deflord/3def/README.md

# 3Def
Мы сделали отдельное хранилище, что бы вы могли в любой момент скачать нужные вам детали и быстро отремонтировать или улучшить ваш 3D принтер!
