deflord/3def/Образы для OrangePi/Orange_Pi_3B/README.md

# Образ для Orange Pi 3B
## Образ содержит
* Orangepi3b_1.0.6_ubuntu_jammy_server_linux5.10.160
* Klipper v0.12.0-348
* Moonraker
* Moonraker-timelapse
* Mainsail в качестве вэб интерфейса
* Crowsnest
* KlipperScreen
* Katapult
* Klippain-Shaketune
* Настроен CAN
* Скрипты для автоматического расширения образа на всю MicroSD

Образ доступен для скачивания по ссылке [Orange Pi 3B](https://mega.nz/file/TdpzDAbS#Le2-5hxRWCd8Wit2h-JfqoEiYUKdBW2nbB_KZ6QXemg).
