deflord/3def/Образы для OrangePi/Orange_Pi_3_ZERO/README.md

# Образ для Orange Pi 3 ZERO
## Образ содержит
* Orangepizero3_1.0.4_ubuntu_jammy_server_linux6.1.31.7z
* Klipper
* Moonraker
* Moonraker-timelapse
* Mainsail в качестве вэб интерфейса
* Crowsnest
* KlipperScreen
* Поддержку CAN
* Katapult
* Klippain-Shaketune
* Скрипты для автоматического расширения образа на всю MicroSD

Образ доступен для скачивания по ссылке [Orange Pi 3 ZERO](https://mega.nz/file/TcYR1Qrb#NRjWIfK2MXL8XWC1-TuNzy4bhytpi9K7qcDxZMbB4Rc).
