deflord/3def/STL/StealthChanger/Магнитный док/README.md

# Модульный док с фиксацией на магниты
Мы предлагаем свою версию модульных доков для DrugonBurner. Мы слегка изменили систему крепления и удержания, добавив магниты с возможностью настройки. 
## Что сделанно:

Изменили передние детали рамки, убрали лишние дырки и добавили регулируемые магниты

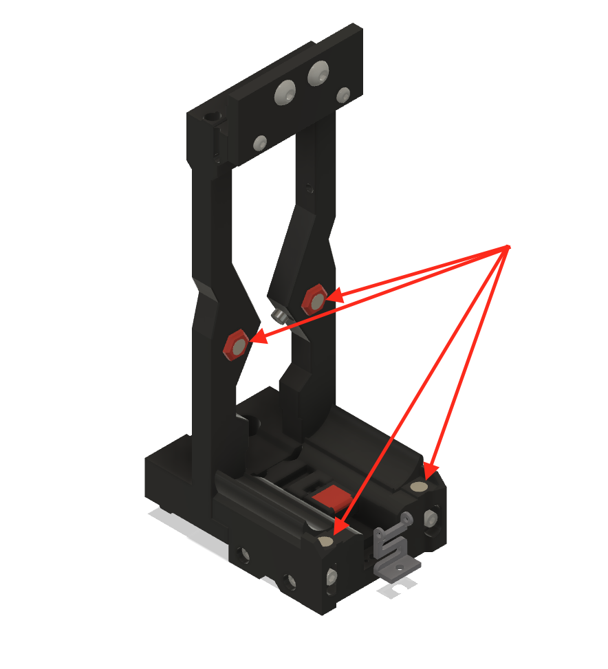
[picture p1: STL/StealthChanger/Магнитный док/IMG/1.png]
alt-текст Док


Добавили возможность настройки глубины посадки головы. По сути вам необходимо ослабить болты крепления, подвести голову в нужную позицию, после чего магниты сами встанут как должны. После этого просто зафиксируйте их болтами м3х8

Изменили нижний задник, можно отрегулировать таким же образом, как и передние магниты

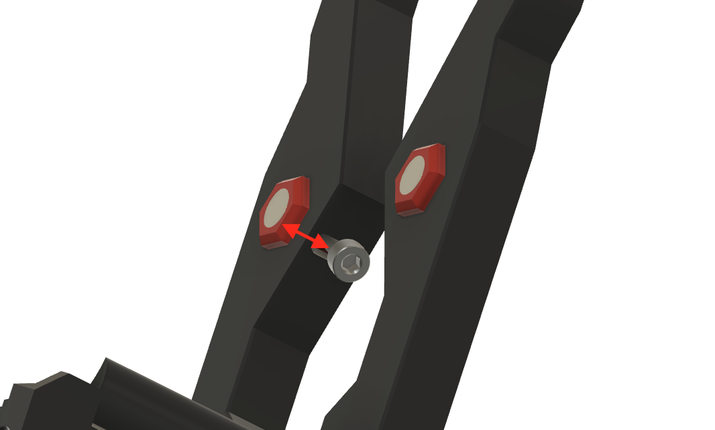
[picture p2: STL/StealthChanger/Магнитный док/IMG/2.png]
alt-текст Регулировка передних магнитов


На задней части так же добавили два магнита

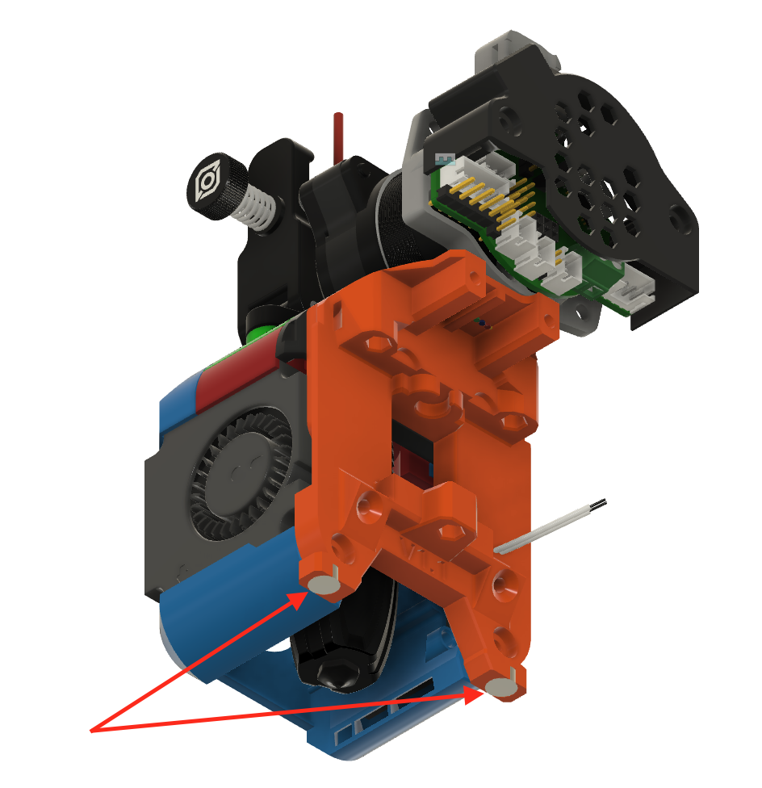
[picture p3: STL/StealthChanger/Магнитный док/IMG/3.png]
alt-текст Нижние магниты на голове


Добавили магниты в корпус DragonBurner.

**Внимание, при использовании сильных магнитов возможна остановка вентиляторов охлаждения хотэнда и обдува детали. Если это происходит, поставьте магниты другой полярностью.**

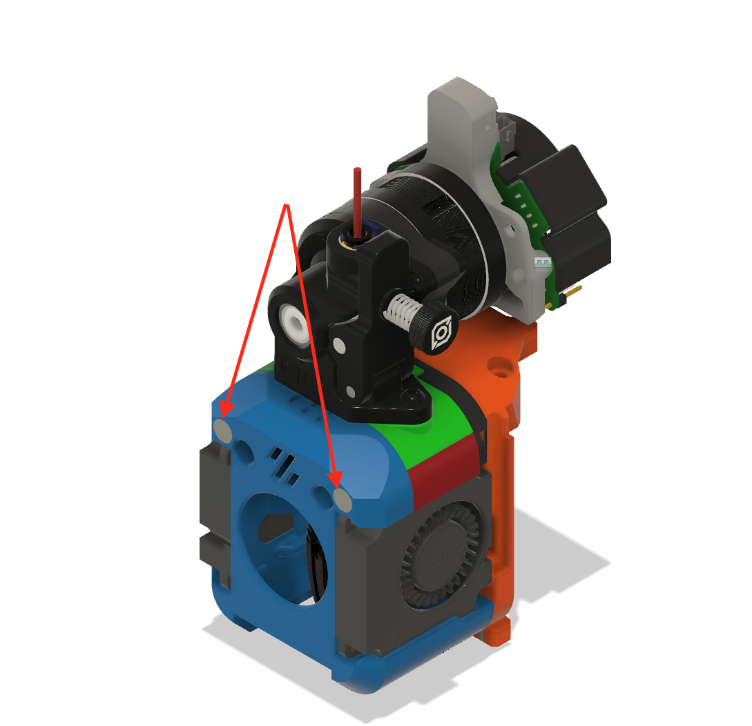
[picture p4: STL/StealthChanger/Магнитный док/IMG/4.png]
alt-текст Передние магниты на голове


**Внимание! 
Данный мод пока что в тестовом режиме, использовать на ваш страх и риск, будем благодарны за обратную связь :)**
