deflord/3def/STL/Моды/CPAP/BTT Eco Turbo Kit/README.md

# Простой мод для установки CPAP в корпус задней вытяжки

Все помещается без лишних проводов, получается аккуратно и просто.

Мод подходит для CPAP BIGTREETECH Eco Turbo Kit

Мод взят отсюда https://github.com/bigtreetech/Eco-Turbo-Kit/blob/66467e1f6cd2f754834dae49be04b927bdde804c/3D%20Model/Voron%202.4%26Trident/Exhaust%20Parts/Voron-Exhaust-ETK-SFS-wit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

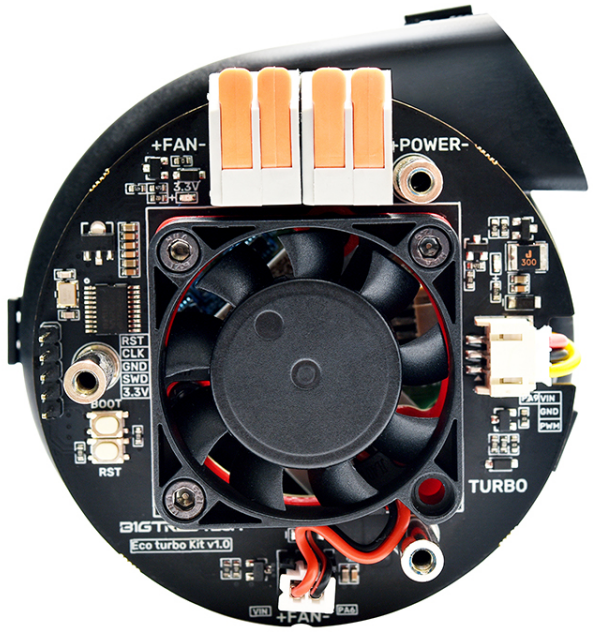
[picture p5: STL/Моды/CPAP/BTT Eco Turbo Kit/IMG/eco_turbo_kit.png]


Доработали и сделади возможность устанавливать не только на профиль 2020, но и 3030. Меняется только держатель.
Так же сразу возможно установить датчик наличия и движения пластика BTT SFS2

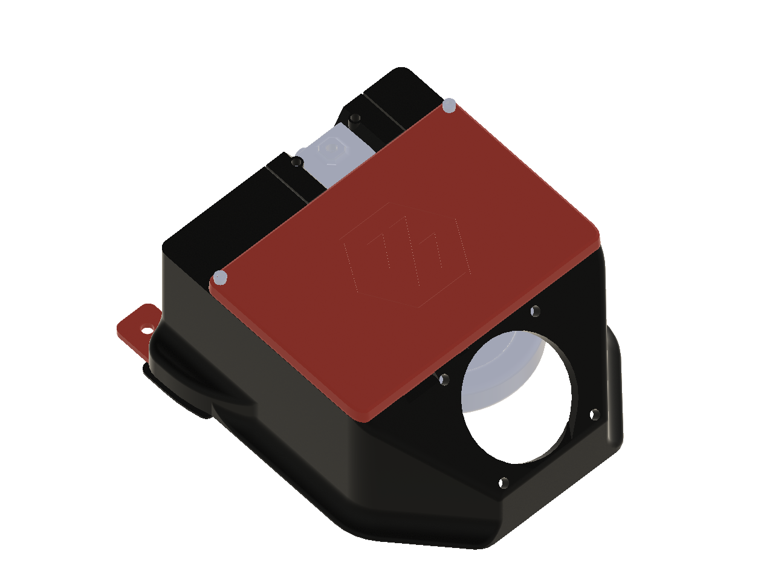
[picture p6: STL/Моды/CPAP/BTT Eco Turbo Kit/IMG/1.png]


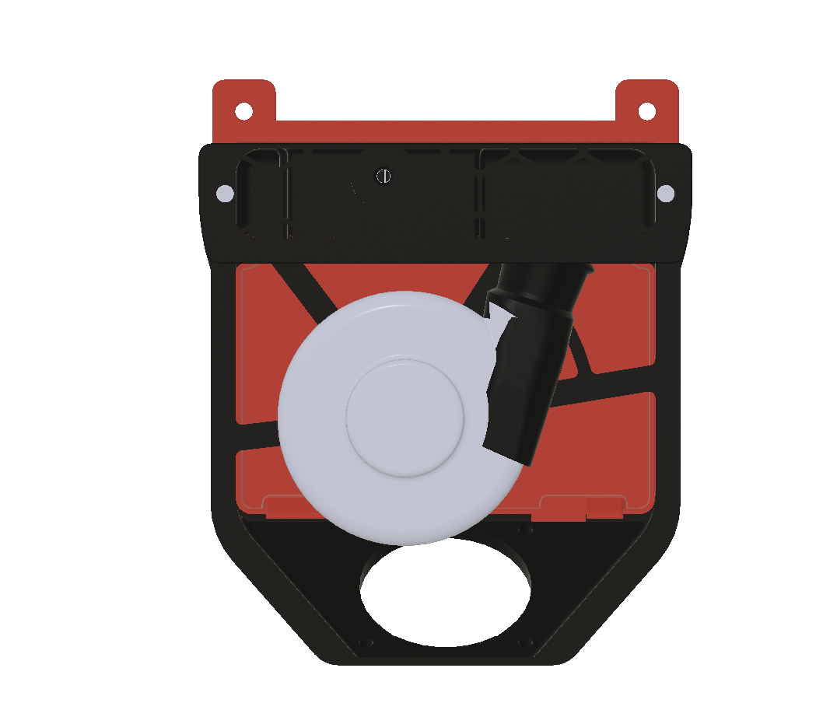
[picture p7: STL/Моды/CPAP/BTT Eco Turbo Kit/IMG/2.png]


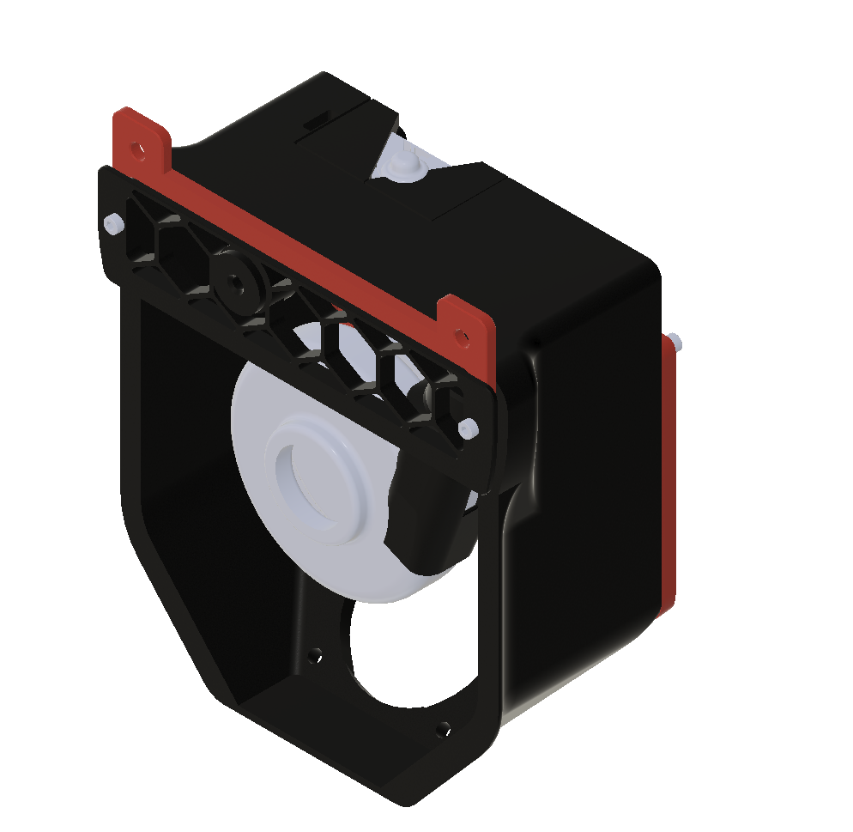
[picture p8: STL/Моды/CPAP/BTT Eco Turbo Kit/IMG/3.png]
