deflord/3def/STL/StealthChanger/Задний рюкзак с электроникой/README.md

# Рюкзак для установки электроники для Toolchanger
В рюкзаке распагаются 2 платы:
1. BTT U2C
2. BTT CEB

В рюкзак приходят кабели USB для подключения BTT U2C и кабель 24В для запитывания голов. 
Кабели проходят внутри, заходят внутрь принтера через прорези и далее разводятся влево и вправо по профилю. 

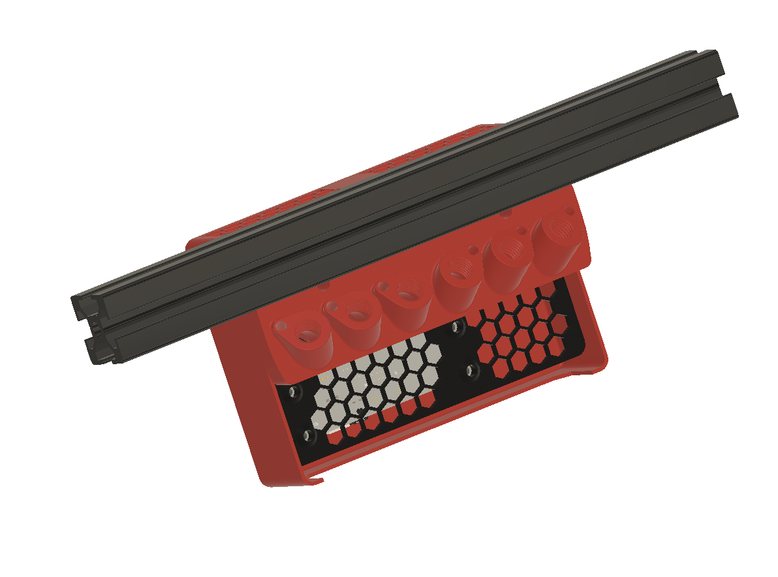
[picture p9: STL/StealthChanger/Задний рюкзак с электроникой/IMG/1.png]

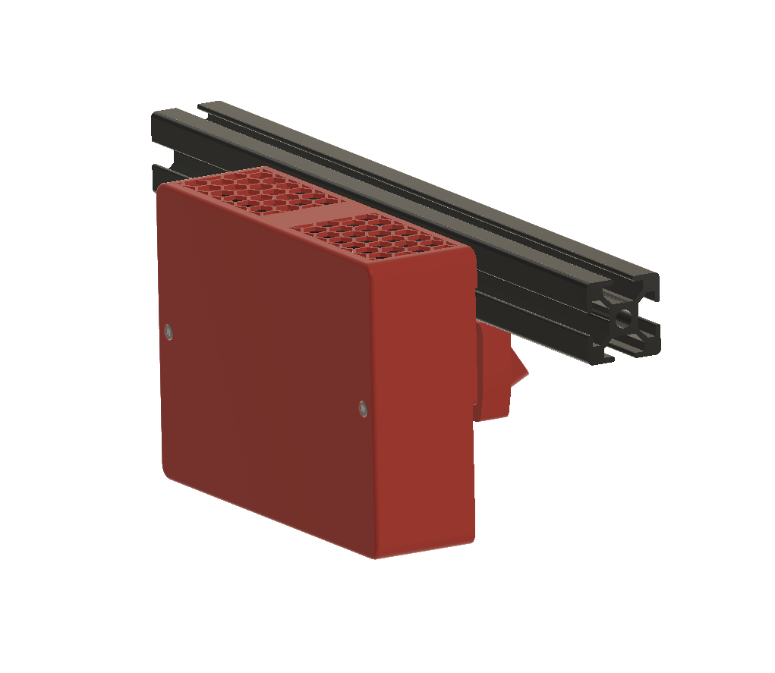
[picture p10: STL/StealthChanger/Задний рюкзак с электроникой/IMG/2.png]

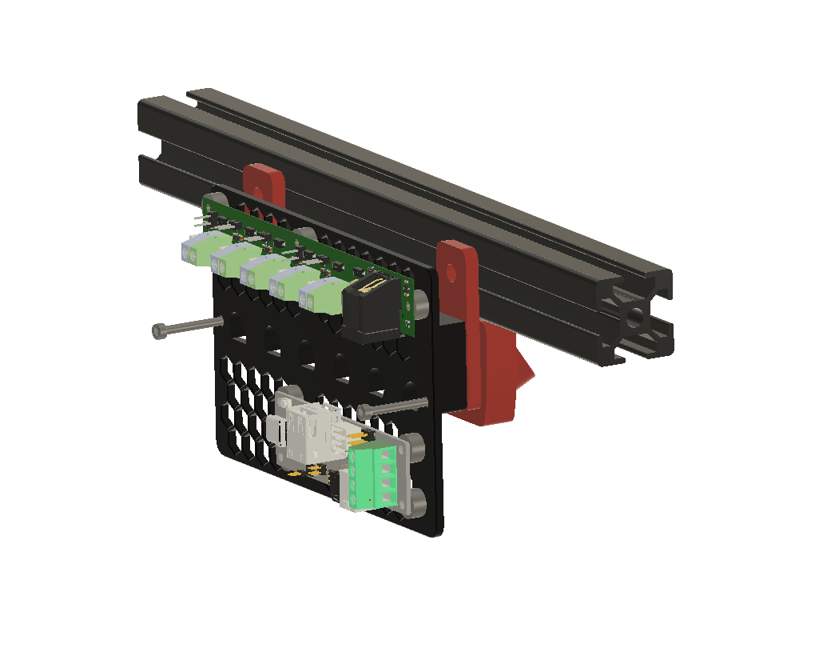
[picture p11: STL/StealthChanger/Задний рюкзак с электроникой/IMG/3.png]

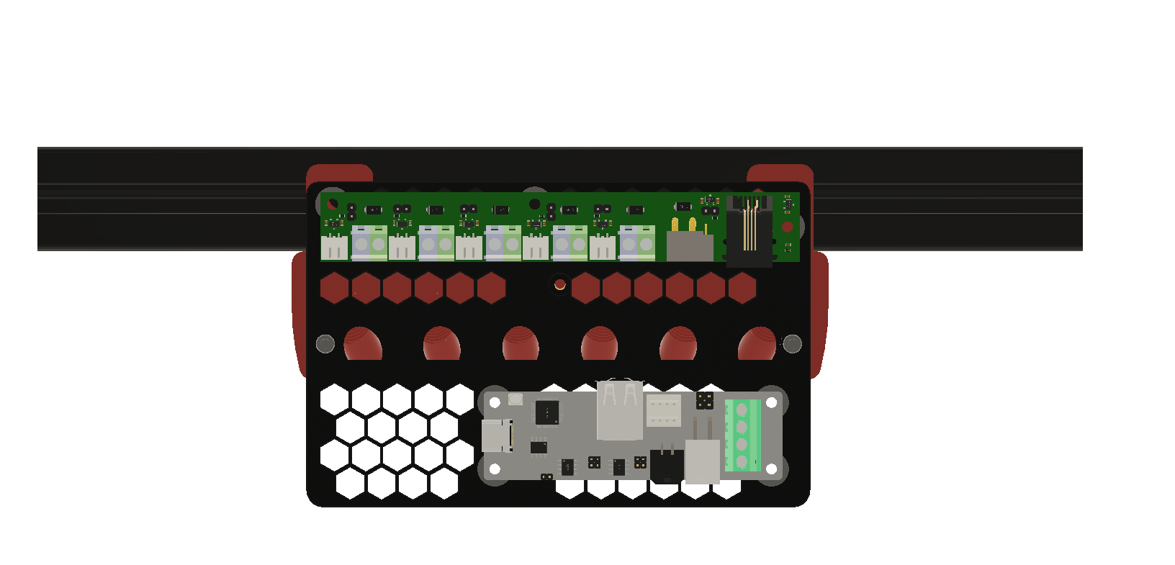
[picture p12: STL/StealthChanger/Задний рюкзак с электроникой/IMG/4.png]


Преимущества:
1. Поддерживается жесткое крепление стального корода каждой головы что бы избежать перекручивания и увеличить устойчивость проводки
2. Удобный доступ к платам, снимаете крышку и всё видно
3. Разделены трубки PTFE и электроника, трубки уходят сразу вниз, кабели заходят сквозь держатель и далее подключаются к платам. 

Поддерживаются 2 версии:
1. Для профиля 2040
2. Для профиля 3030

Если вам нужно использовать для профиля 2020, то прийдётся перемодилть крышку, пока не делали :) 

## **BOM для версии 2040**

| **Название**  | **Количество**| **Комментарий**  |
|:---|:---|:---|
| BTT U2C | 1 шт | - |
| BTT CEB | 1 шт | - |
| Болт М3х8 SHCS | 7 штук | для крепления плат |
| Болт М3х5 FHCS | 6 штук | для крепления стальных кордов |
| Болт М3х40 SHCS | 3 штуки | для крепления крышки |
| Болт М5х10 BHCS | 2 штуки | для крепления рюкзака к профилю |
| Закладные или Т-гайки M5 для паза профиля шириной 6 мм | 2 штуки | для крепления рюкзака к профилю |
| Закладная или Т-гайка М3 для паза профиля шириной 6 мм | 1 штука | для крепления крышки к профилю |
| Вплавляемые гайки М3х5 | 15 штук | стандартные для Voron |
| Шайбы М3 | 6 штук | для крепления стальных кордов |

## BOM для версии 3030

| **Название**  | **Количество**| **Комментарий**  |
|:---|:---|:---|
| BTT U2C | 1 шт | - |
| BTT CEB | 1 шт | - |
| Болт М3х8 SHCS | 7 штук | для крепления плат |
| Болт М3х5 FHCS | 6 штук | для крепления стальных кордов |
| Болт М3х40 SHCS | 3 штуки | для крепления крышки |
| Болт М5х10 BHCS | 2 штуки | для крепления рюкзака к профилю |
| Закладные или Т-гайки M5 для паза профиля шириной 8 мм | 2 штуки | для крепления рюкзака к профилю |
| Вплавляемые гайки М3х5 | 15 штук | стандартные для Voron |
| Шайбы М3 | 6 штук | для крепления стальных кордов |
