deflord/3def/STL/Моды/Камера/Камера FullHD/СNC мод/README.md

# Шаровое крепление камеры Full HD для установки на CNC портал
Мы доработали корпус камеры таким образом, что бы вы могли легко и просто разместить его на портале с алюминиевыми деталями на одном из передних моторов. 
Теперь настройка угла обзора очень проста. Вы можете регулировать как угол наклона, так и угол поворота. 
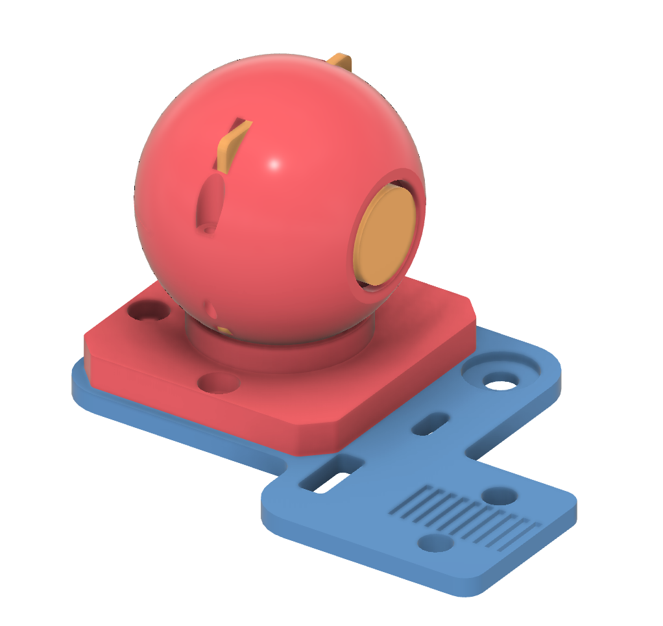
[picture p13: STL/Моды/Камера/Камера FullHD/СNC мод/IMG/CNC_FullHD.png]
Рендер камеры
