deflord/3def/STL/Моды/Камера/Камера FullHD/Monolith мод/README.md

# Шаровое крепление камеры Full HD для установки на портал Monolith
Мы доработали корпус камеры таким образом, что бы вы могли легко и просто разместить его на портале по проекту Monolith на одном из передних моторов. 
Теперь настройка угла обзора очень проста. Вы можете регулировать как угол наклона, так и угол поворота. 
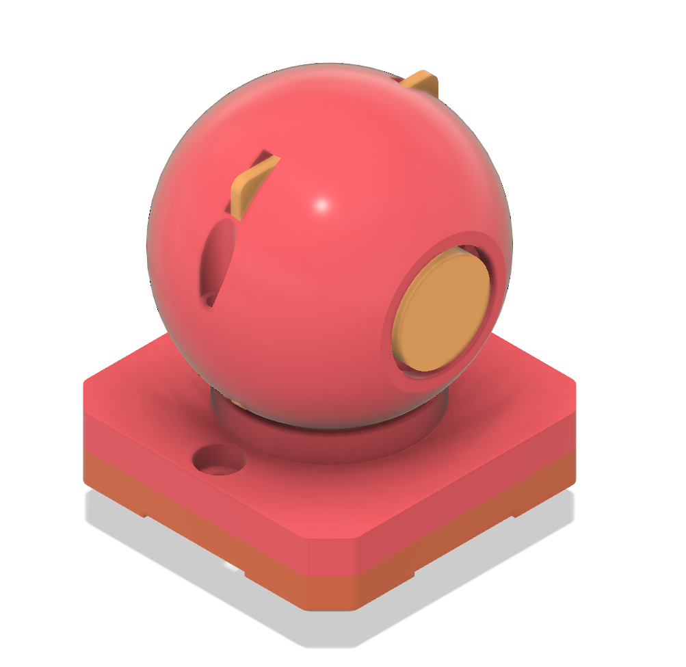
[picture p14: STL/Моды/Камера/Камера FullHD/Monolith мод/IMG/Monolith_cam.png]
Рендер камеры
