deflord/3def/STL/Моды/CPAP/Monolith/IMG/1.png

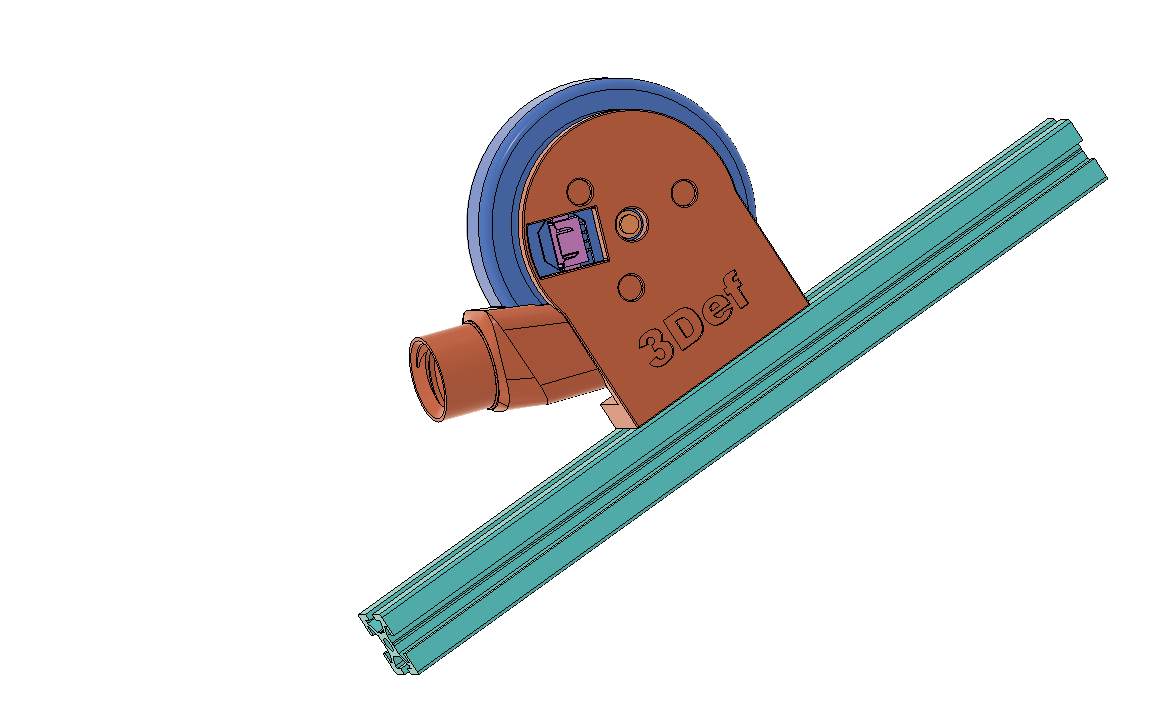
STL/Моды/CPAP/Monolith/IMG/1.png
