deflord/3def/STL/Моды/CPAP/Monolith/IMG/2.png

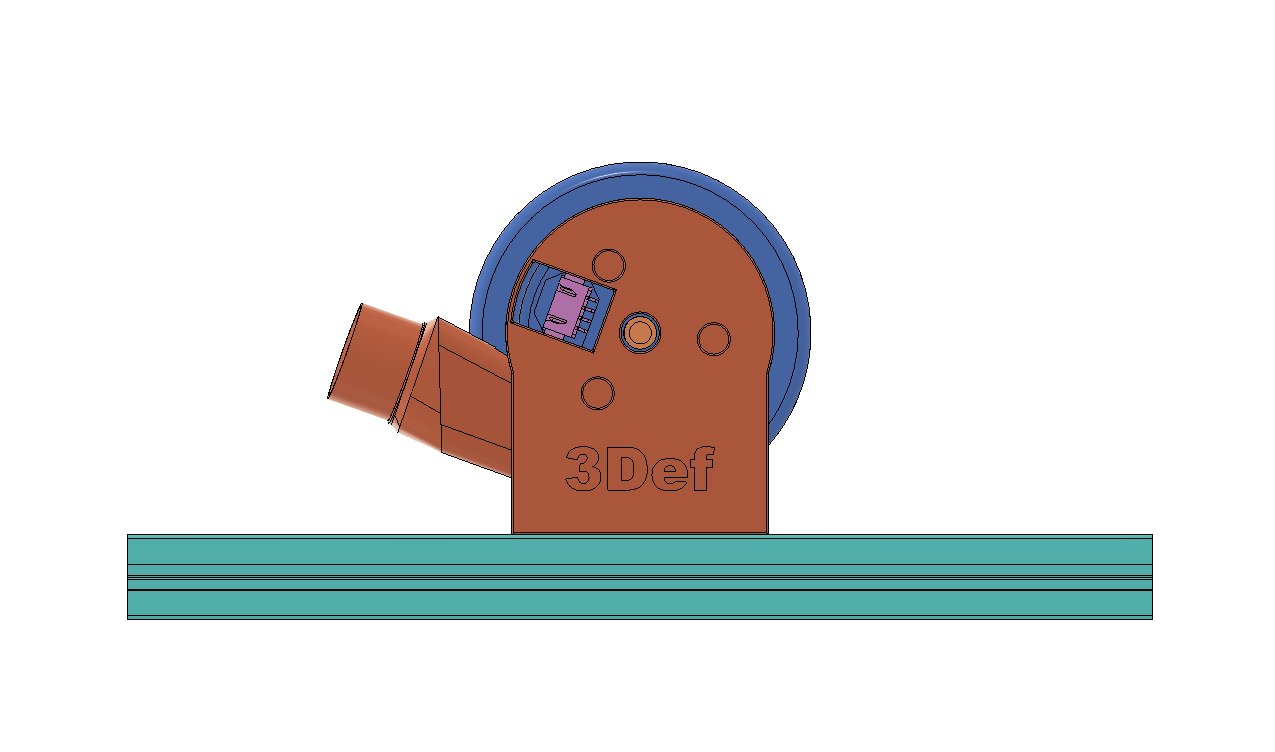
STL/Моды/CPAP/Monolith/IMG/2.png
