deflord/3def/STL/Моды/CPAP/Monolith/IMG/3.png

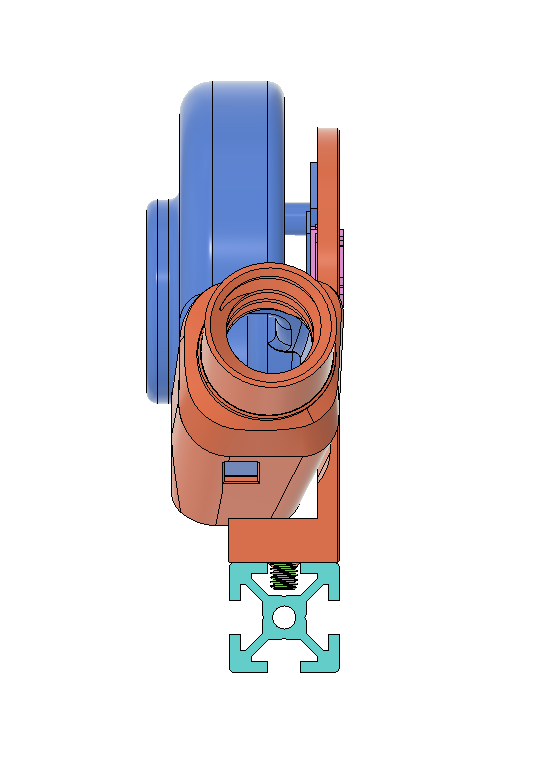
STL/Моды/CPAP/Monolith/IMG/3.png
