deflord/3def/STL/Моды/CPAP/Monolith/IMG/4.png

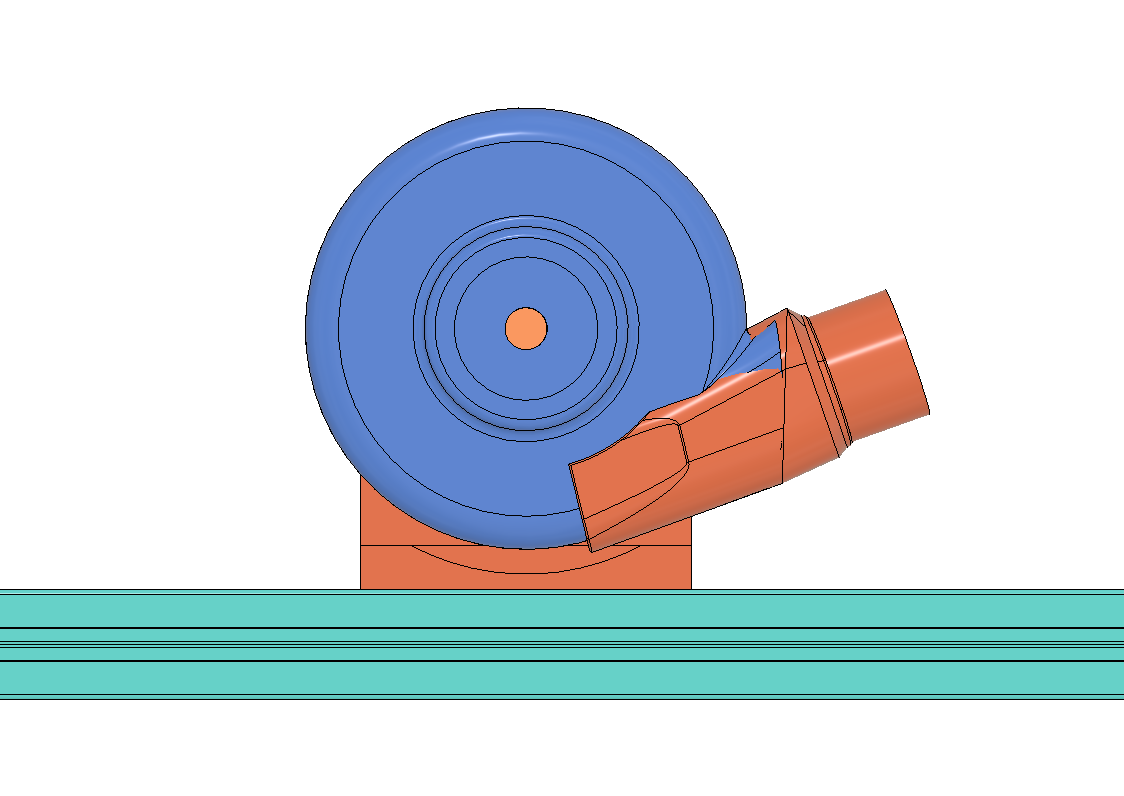
STL/Моды/CPAP/Monolith/IMG/4.png
