deflord/3def/STL/Отсек аппаратуры/Держатели плат/Fly X10 Pro/IMG/1.jpg

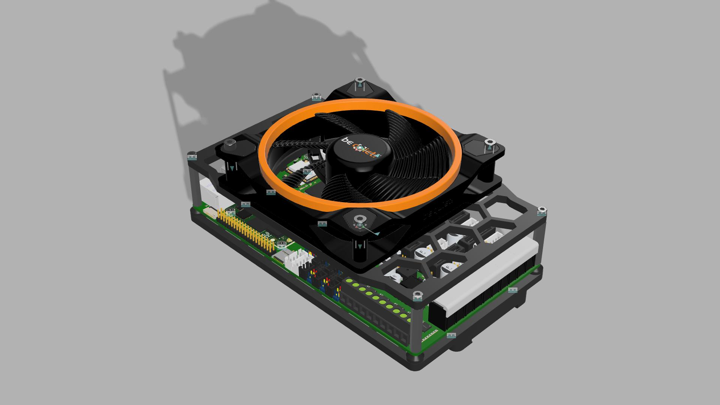
STL/Отсек аппаратуры/Держатели плат/Fly X10 Pro/IMG/1.jpg
