deflord/3def/STL/Печатающие головы/XOL/Heatcore Orbiter MiniAB/IMG/Снимок экрана 2025-10-13 в 11.07.48.png

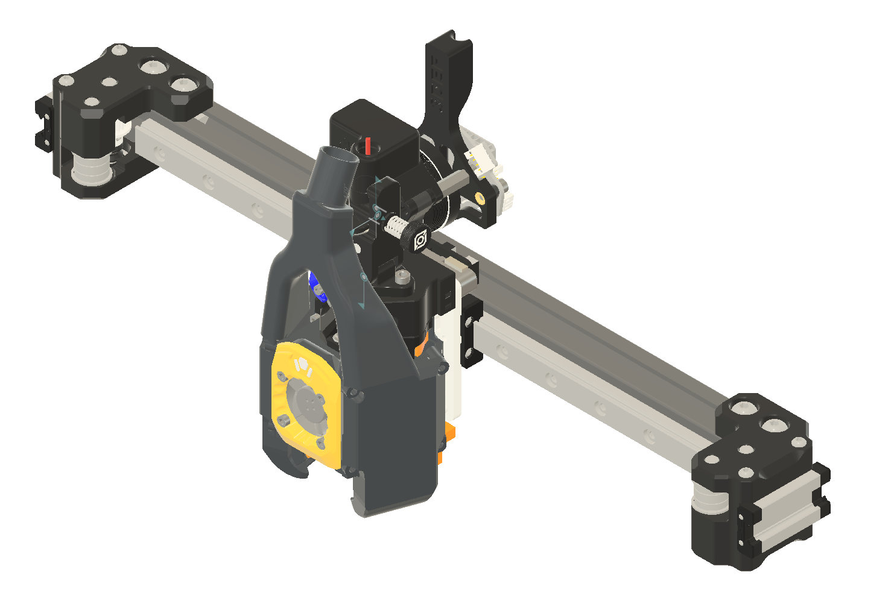
STL/Печатающие головы/XOL/Heatcore Orbiter MiniAB/IMG/Снимок экрана 2025-10-13 в 11.07.48.png
