deflord/3def/STL/Портал/Monolith/Ввод проводов в гибкий кабель канал/Ввод с CAN и PG7/IMG/Снимок экрана 2025-08-07 в 11.18.06.png

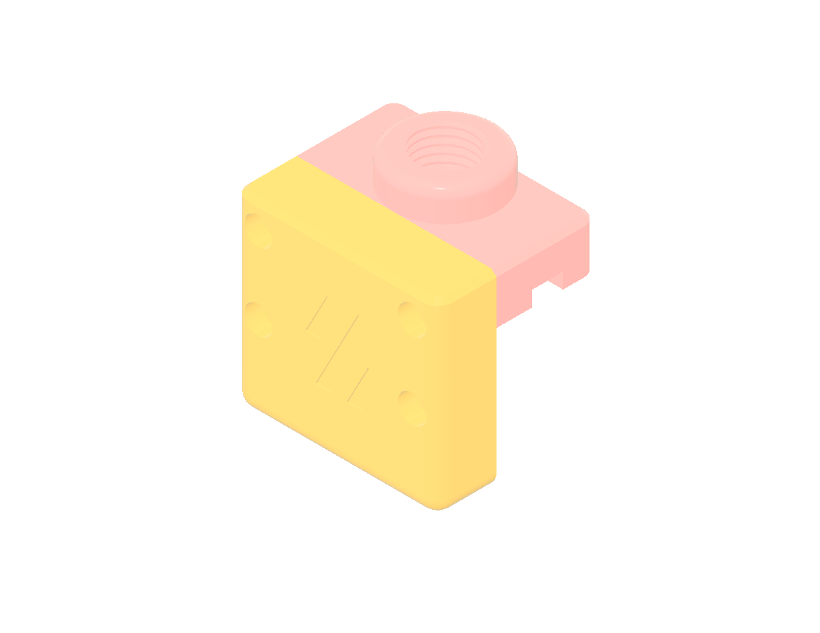
STL/Портал/Monolith/Ввод проводов в гибкий кабель канал/Ввод с CAN и PG7/IMG/Снимок экрана 2025-08-07 в 11.18.06.png
