deflord/3def/STL/Портал/Monolith/Ввод проводов в гибкий кабель канал/Ввод с держателем концевика/IMG/1.png

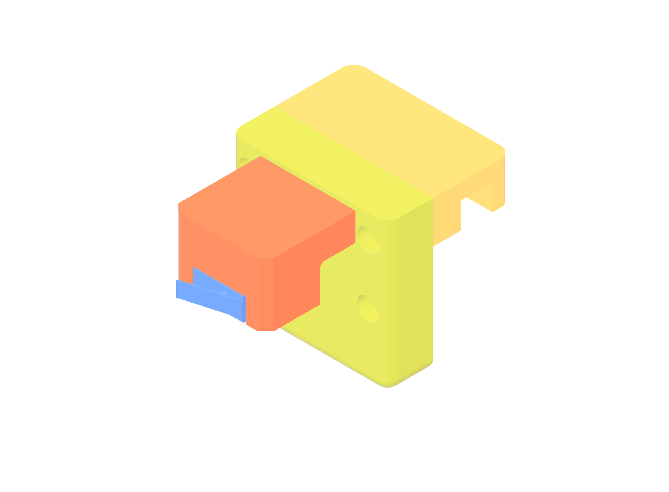
STL/Портал/Monolith/Ввод проводов в гибкий кабель канал/Ввод с держателем концевика/IMG/1.png
