deflord/3def/STL/Портал/Monolith/Концевик по Y сбоку/Снимок экрана 2026-01-29 в 11.02.18.png

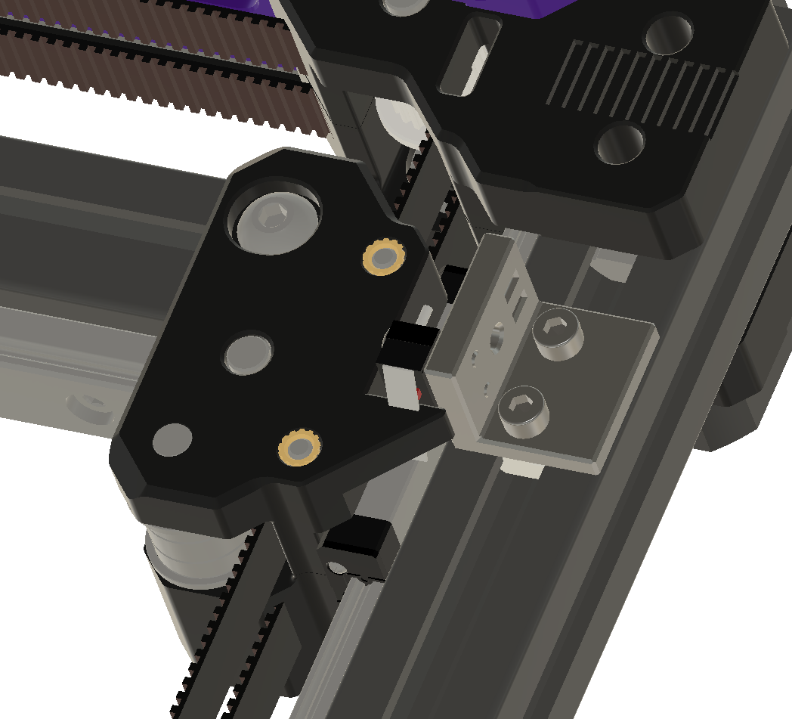
STL/Портал/Monolith/Концевик по Y сбоку/Снимок экрана 2026-01-29 в 11.02.18.png
