deflord/3def/Образы для OrangePi/watermark800x450.png

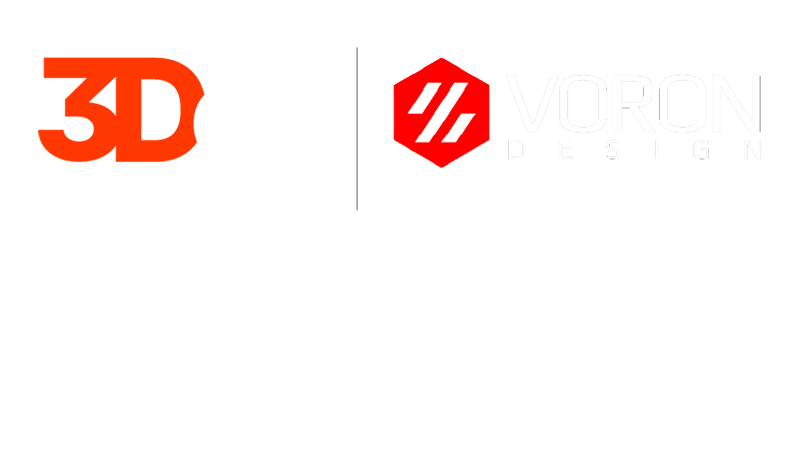
Образы для OrangePi/watermark800x450.png
