deflord/3def/Схемы подключения/500 Поток/Обжим косы.png

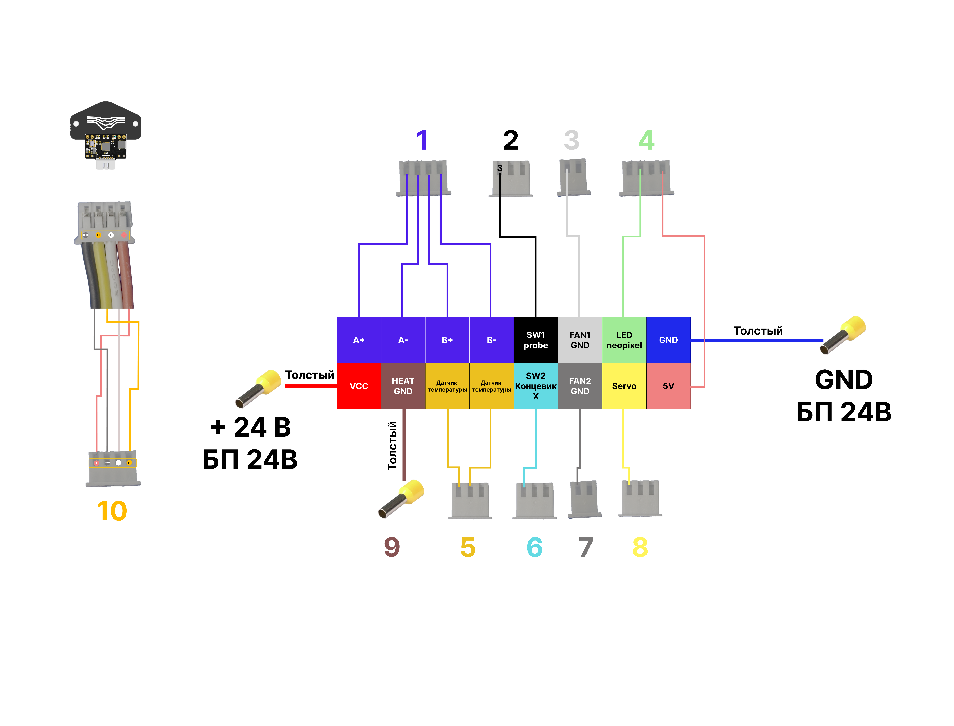
Схемы подключения/500 Поток/Обжим косы.png
