deflord/3def/Схемы подключения/500 Поток/Подключение в голове Листоголов с датчиком.png

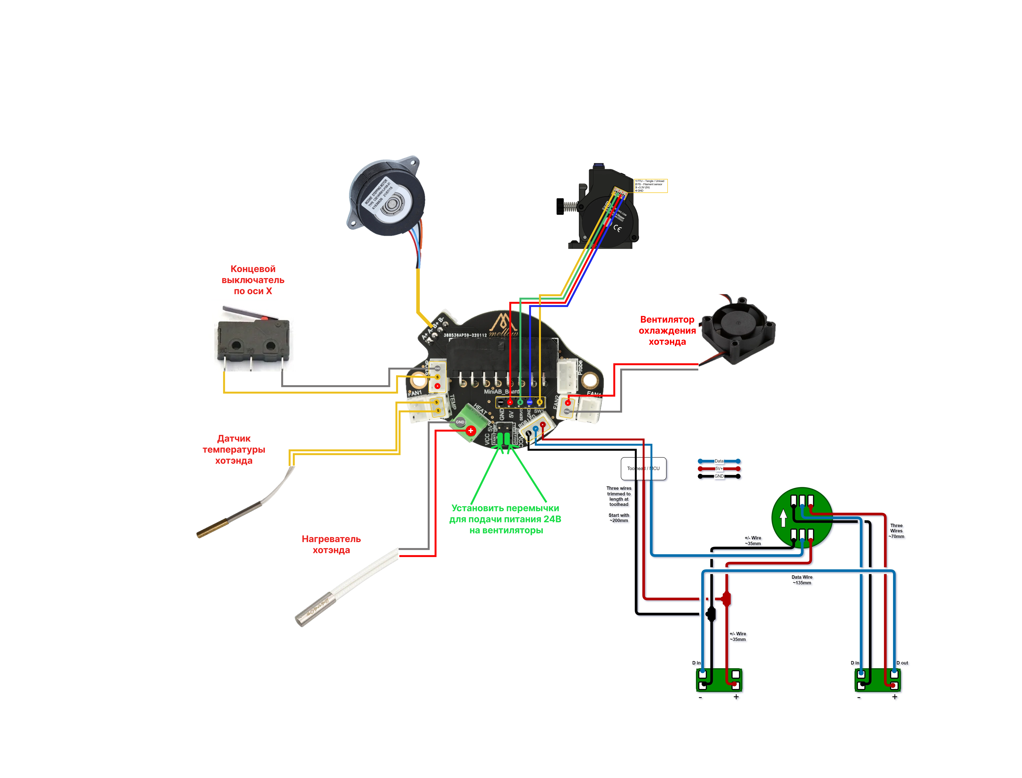
Схемы подключения/500 Поток/Подключение в голове Листоголов с датчиком.png
