deflord/3def/Схемы подключения/500 Поток/Подключение головы к основной плате CPAP.jpg

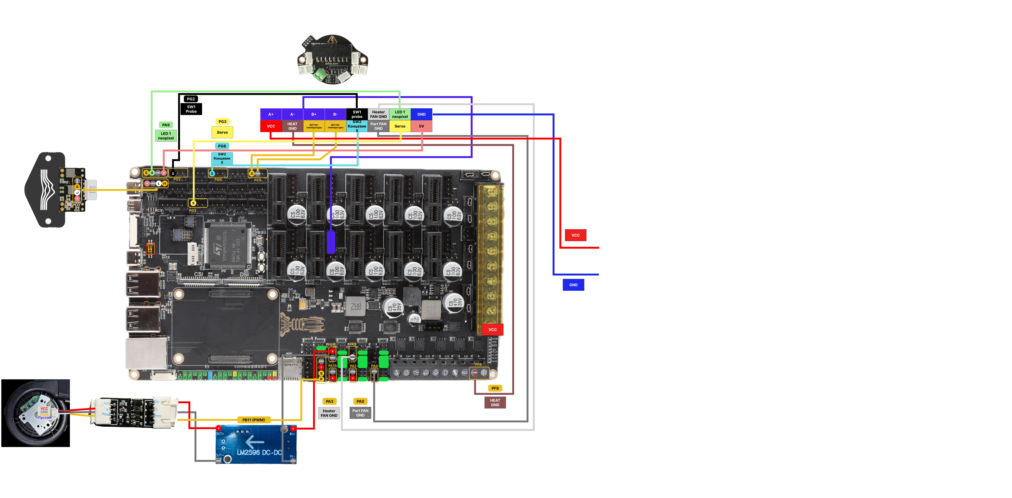
Схемы подключения/500 Поток/Подключение головы к основной плате CPAP.jpg
