deflord/3def/Схемы подключения/500 Поток/Подключение двигателей 48В.png

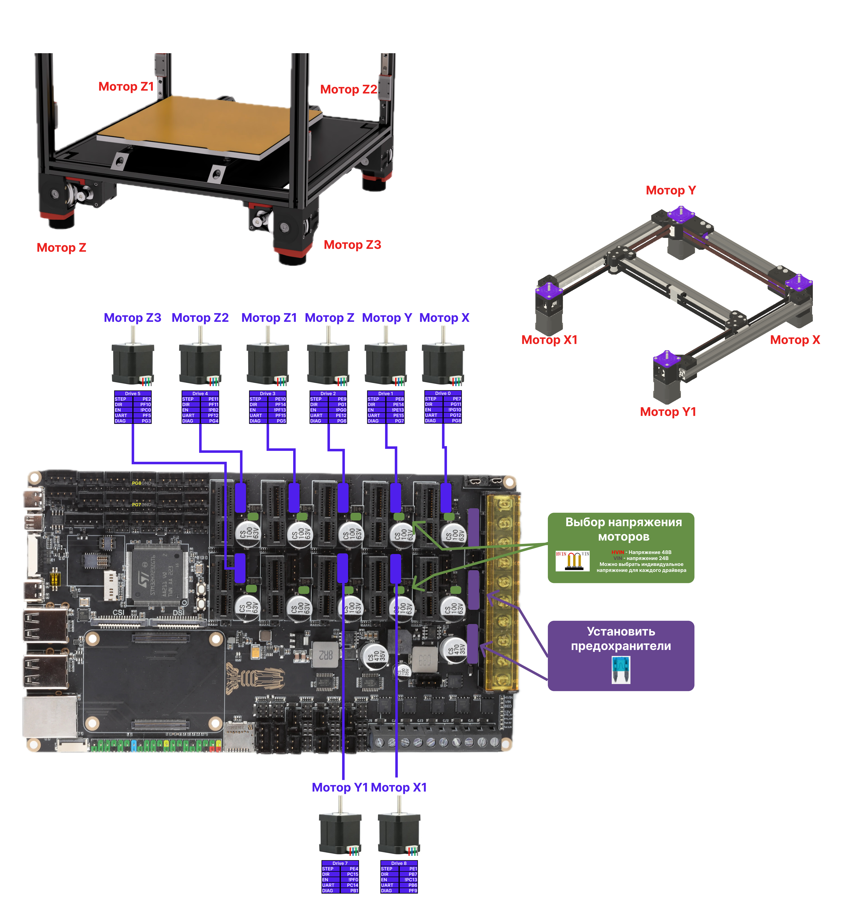
Схемы подключения/500 Поток/Подключение двигателей 48В.png
