deflord/3def/Схемы подключения/500 Поток/Установка перемычек на плату Fly X10 Pro.png

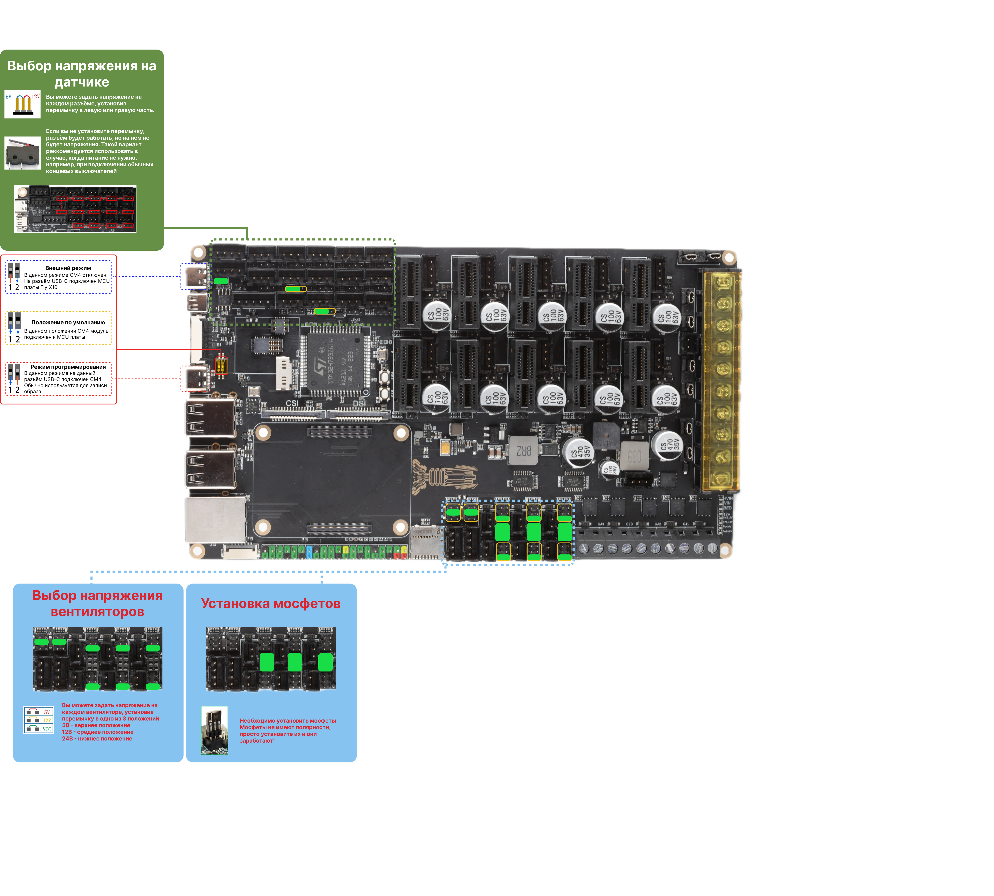
Схемы подключения/500 Поток/Установка перемычек на плату Fly X10 Pro.png
