deflord/3def/Схемы подключения/Fly D8/Fly D8 PinOut.png

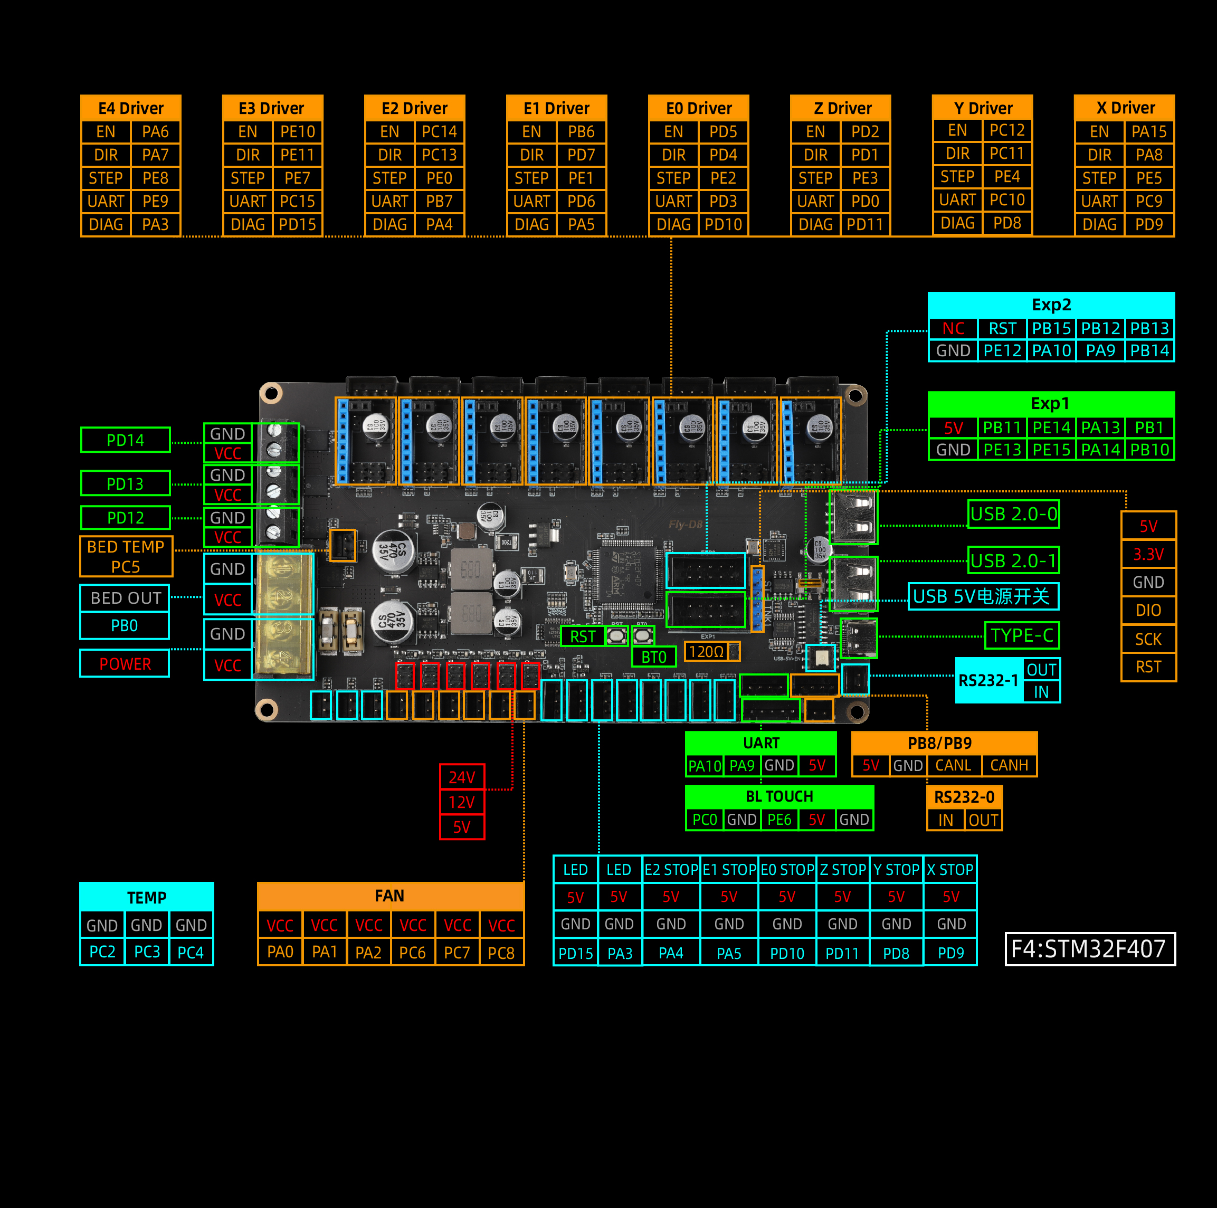
Схемы подключения/Fly D8/Fly D8 PinOut.png
