deflord/3def/Схемы сборки/4WD путь верхнего ремня.jpeg

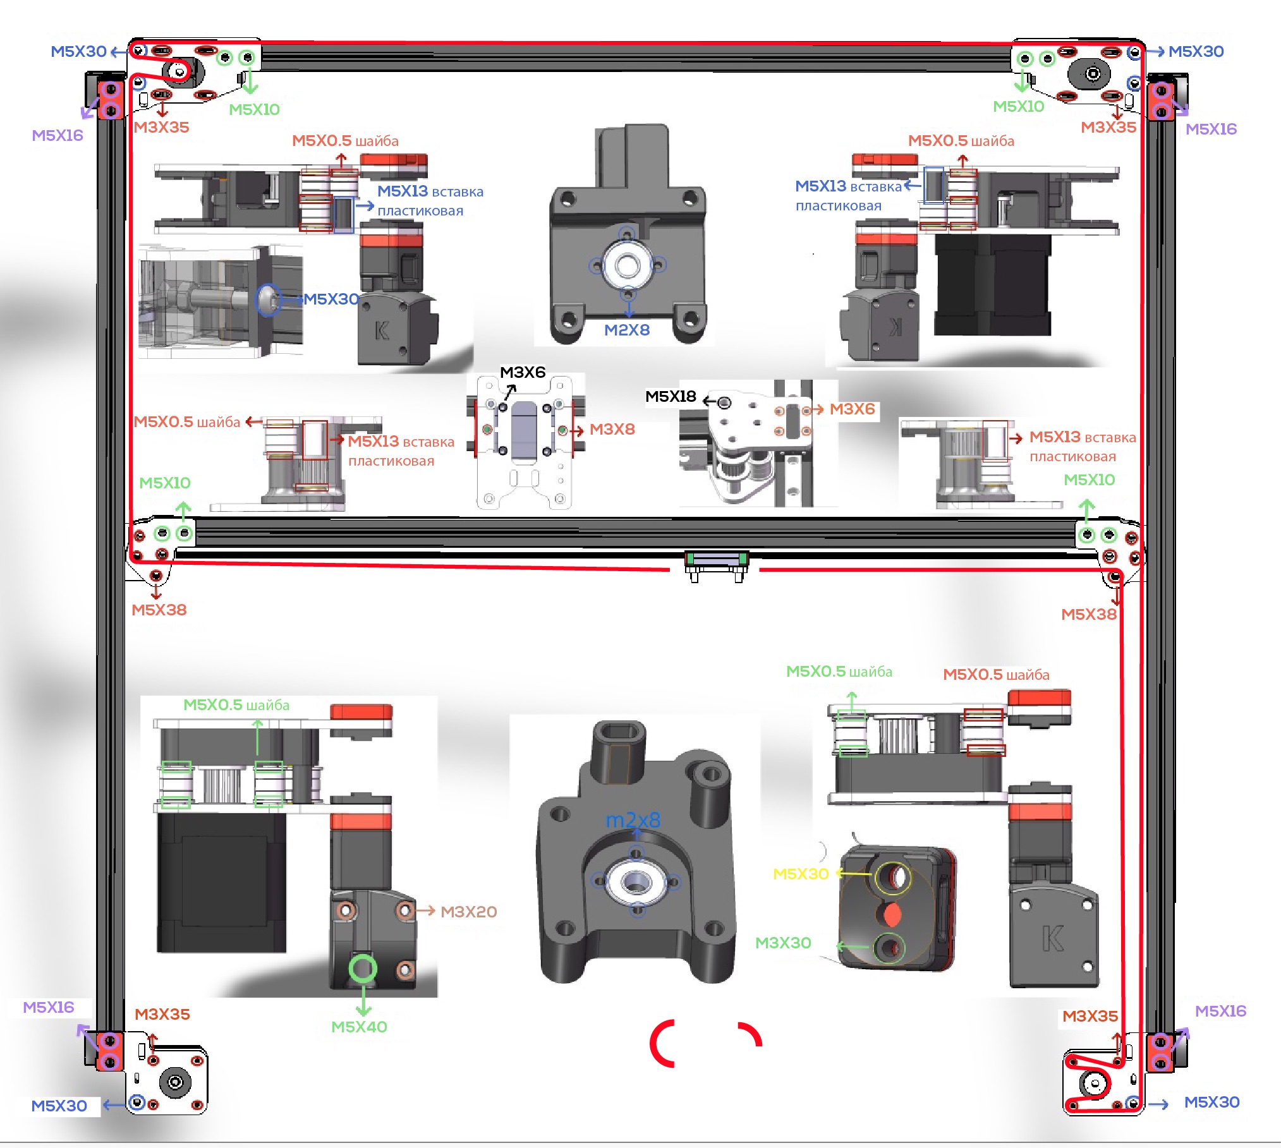
Схемы сборки/4WD путь верхнего ремня.jpeg
