deflord/3def/Схемы сборки/Схема расположения моторов.jpeg

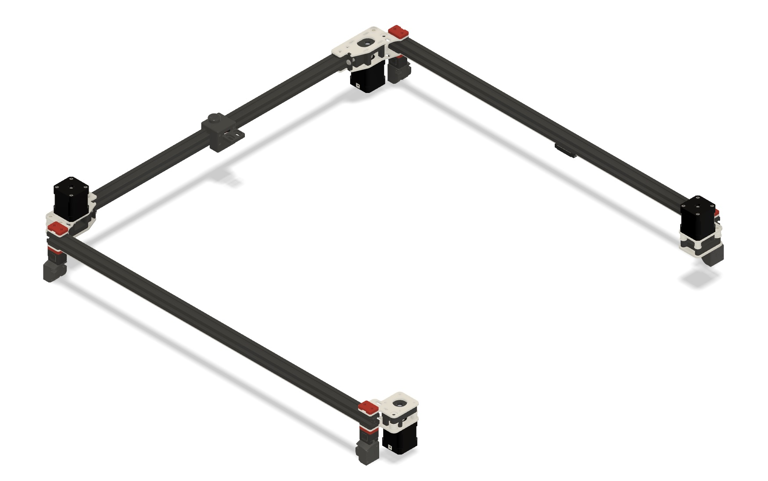
Схемы сборки/Схема расположения моторов.jpeg
