deflord/3def/STL/Печатающие головы/StealthBurner/ERCF:BoxTurtle/ClockWork2/Main Body.step

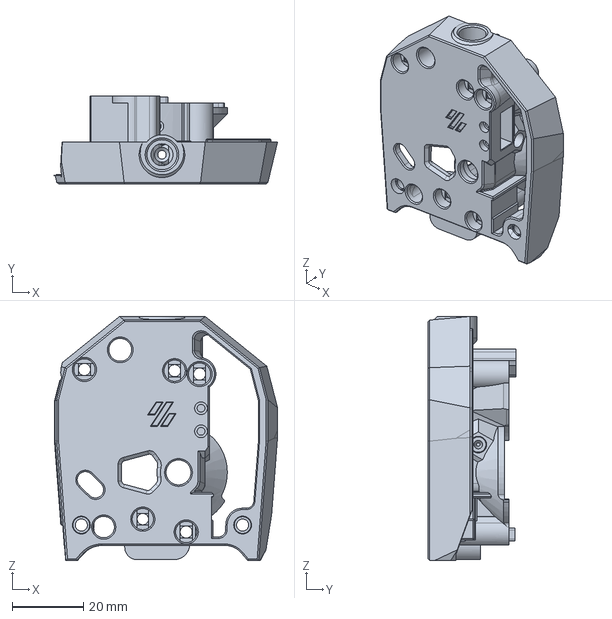
[picture p35: CAD file, 2025-03-05]
STL/Печатающие головы/StealthBurner/ERCF:BoxTurtle/ClockWork2/Main Body.step
62.8 x 24.7 x 68.7 mm
