deflord/3def/STL/Печатающие головы/StealthBurner/Clockwork2/main_body.STL

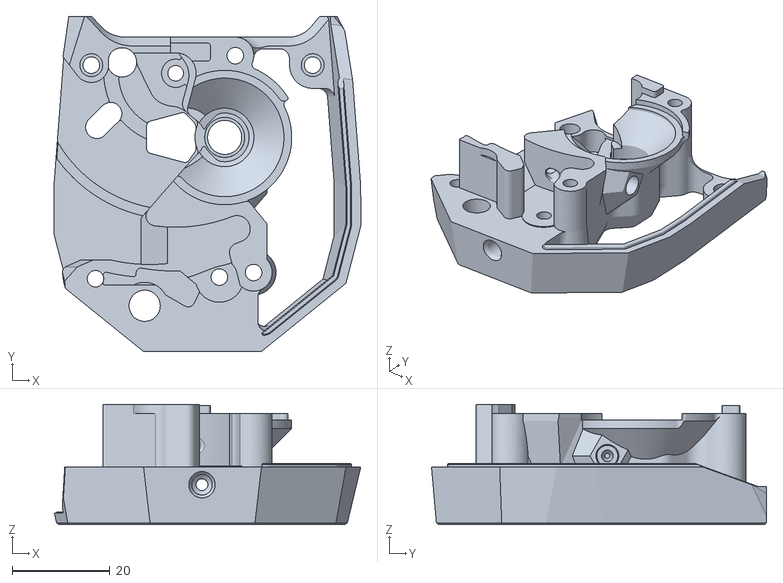
[picture p36: CAD file, 2024-08-04]
STL/Печатающие головы/StealthBurner/Clockwork2/main_body.STL
62.8 x 68.7 x 24.7
