deflord/3def/OrcaSlicer/Столы/Voron_500_build_plate.stl

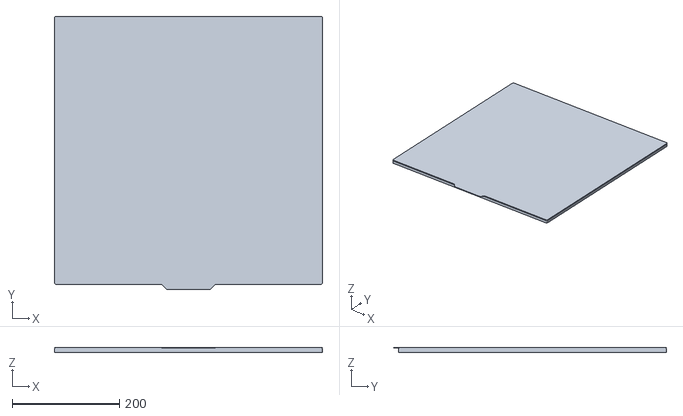
[picture p37: CAD file, 2026-05-15]
OrcaSlicer/Столы/Voron_500_build_plate.stl
500.0 x 510.0 x 9.20
