deflord/3def/STL/CPAP/BTT ECO Turbo kit/Без датчика SFS/CAD/Корпус фильтра.step

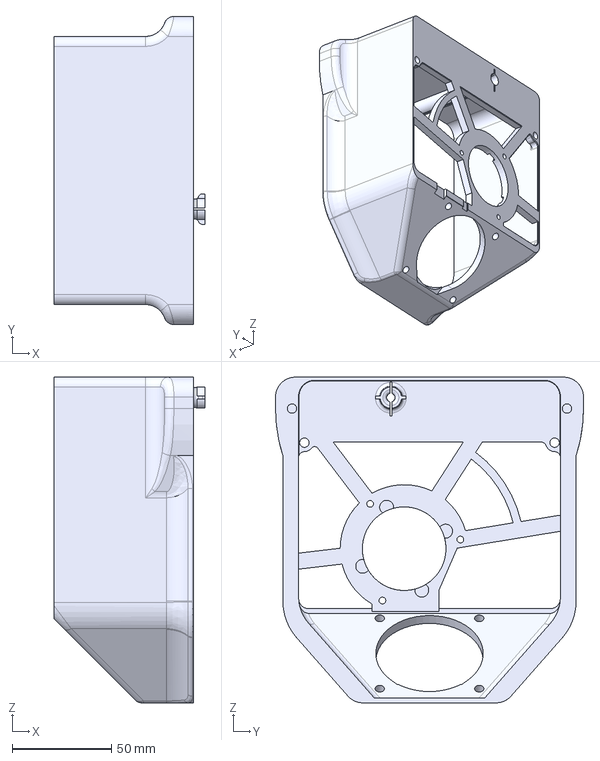
[picture p38: CAD file, 2025-08-19]
STL/CPAP/BTT ECO Turbo kit/Без датчика SFS/CAD/Корпус фильтра.step
75.7 x 154.8 x 163.7 mm
