deflord/3def/STL/CPAP/BTT ECO Turbo kit/Без датчика SFS/STL/Переходная пластина.stl

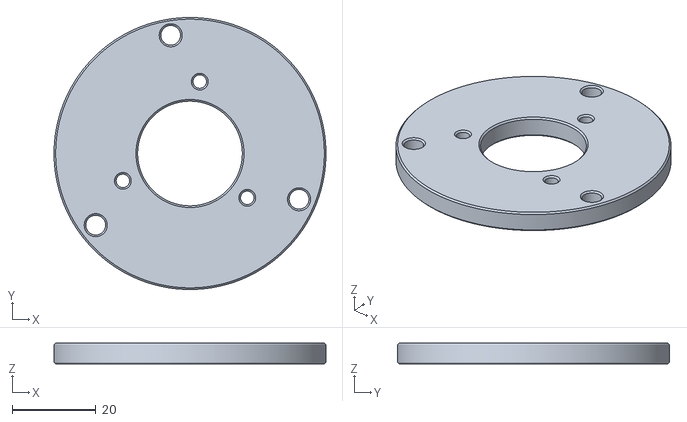
[picture p39: CAD file, 2025-10-30]
STL/CPAP/BTT ECO Turbo kit/Без датчика SFS/STL/Переходная пластина.stl
65.0 x 65.0 x 5.00
