deflord/3def/STL/CPAP/BTT ECO Turbo kit/С датчиком SFS/CAD/Решётка для забора воздуха с PG7.step

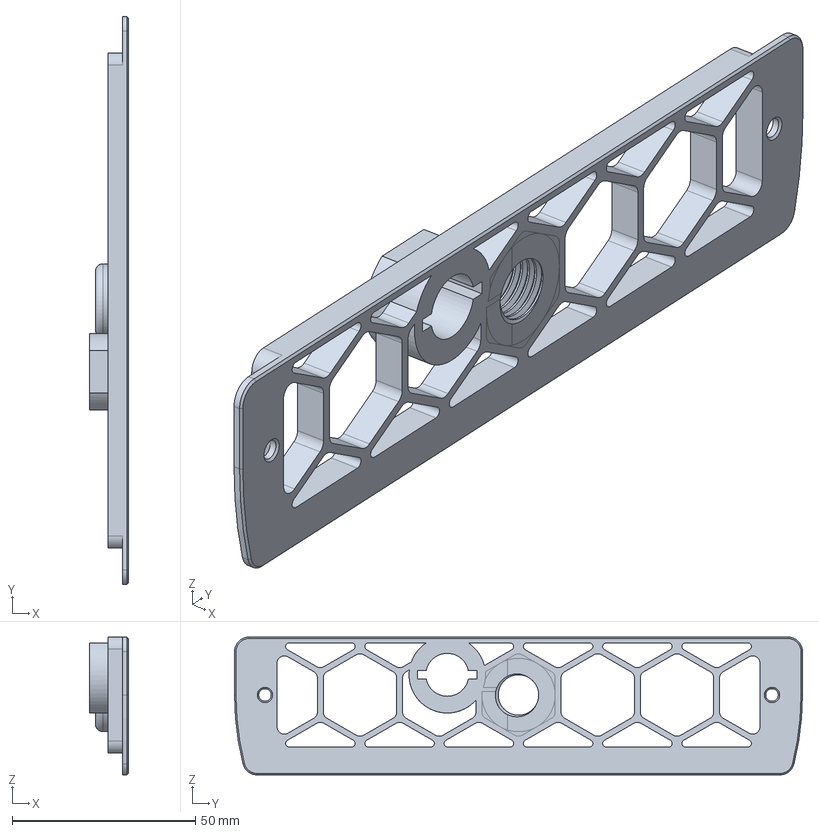
[picture p40: CAD file, 2025-08-04]
STL/CPAP/BTT ECO Turbo kit/С датчиком SFS/CAD/Решётка для забора воздуха с PG7.step
10.6 x 154.8 x 37.6 mm
