deflord/3def/STL/CPAP/BTT ECO Turbo kit/С датчиком SFS/STL/BTT_ECO_turbo_kit.3mf

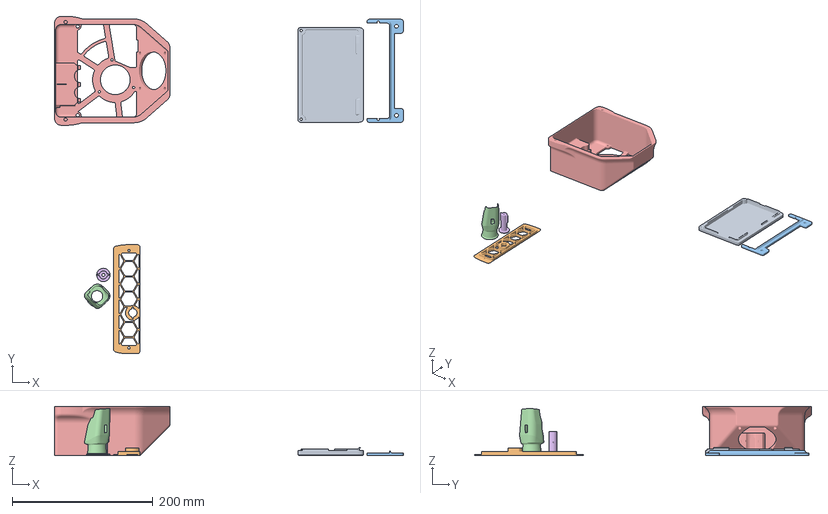
[picture p41: CAD file, 2025-08-04]
STL/CPAP/BTT ECO Turbo kit/С датчиком SFS/STL/BTT_ECO_turbo_kit.3mf
495.1 x 478.8 x 70.0 mm
Задняя крышка.step
Решётка для забора воздуха.step
Крепление на профиль_2020.step
Адаптер для трубки 18мм.step
Корпус фильтра.step
Удлинитель-кнопка для трубки PTFE.step
