deflord/3def/STL/CPAP/CPAP на портал/STL/Адаптер на трубу 22 мм.stl

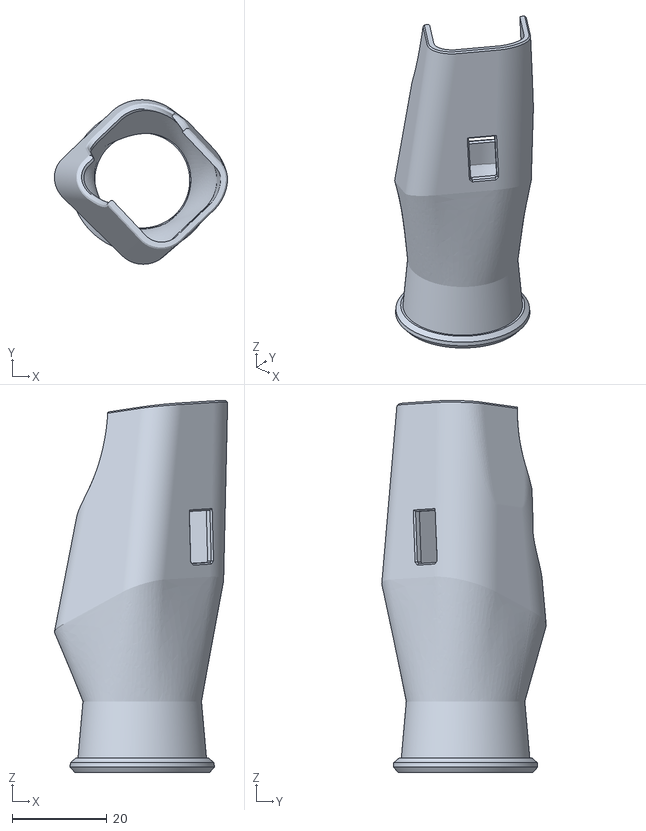
[picture p42: CAD file, 2026-04-15]
STL/CPAP/CPAP на портал/STL/Адаптер на трубу 22 мм.stl
36.5 x 34.7 x 78.4
