deflord/3def/STL/StealthChanger/DragonBurner/CAD/Крепление хотэнда Rapido HF и UHF.step

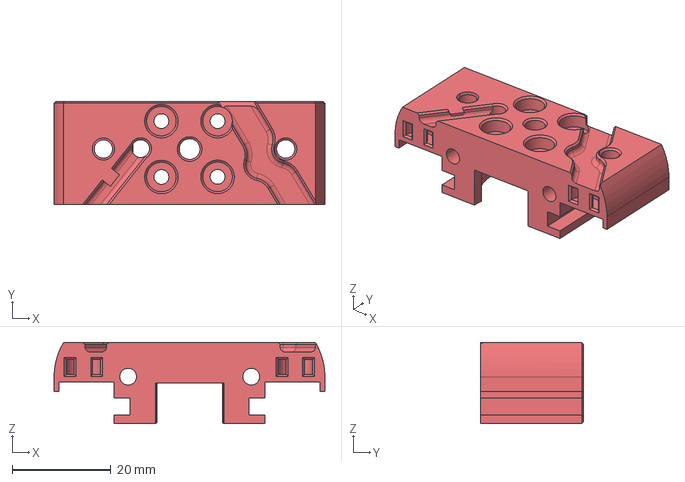
[picture p43: CAD file, 2025-06-16]
STL/StealthChanger/DragonBurner/CAD/Крепление хотэнда Rapido HF и UHF.step
55.0 x 21.0 x 16.5 mm
