deflord/3def/STL/StealthChanger/DragonBurner/STL/StealthChanger.3mf

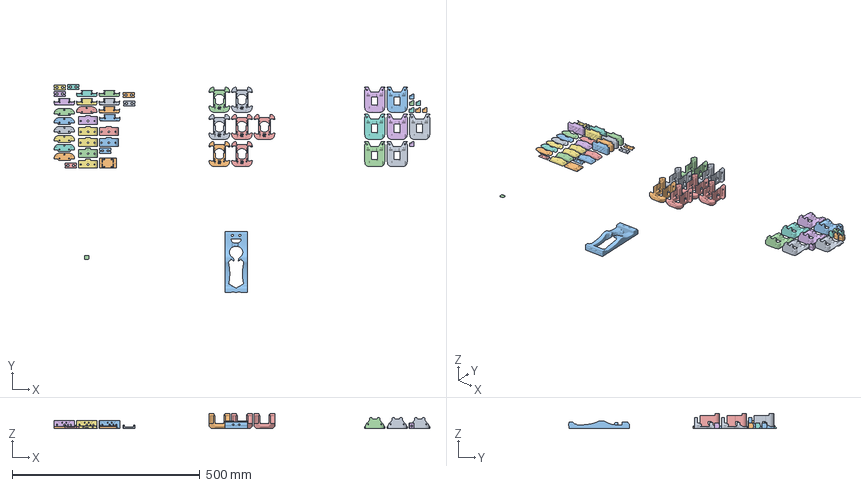
[picture p44: CAD file, 2025-04-23]
STL/StealthChanger/DragonBurner/STL/StealthChanger.3mf
1002.6 x 555.1 x 40.0 mm
DragonBurner.stl x 7
Shuttle_Keeper_9mm_MGN12H.stl
Док.step
Cowl_NoProbe.stl x 7
Orbiter2_Mount.step x 7
[o]_Carrier_Neopixel.step x 7
DragonBurner_Spacer.stl x 7
TZ_V2_Mount.step x 7
NeoPixel_Mount.step x 7
[c]_Voron_Diffuser.step
