deflord/3def/STL/StealthChanger/Задний рюкзак с электроникой/Профиль 2040/CAD/Держатель плат.step

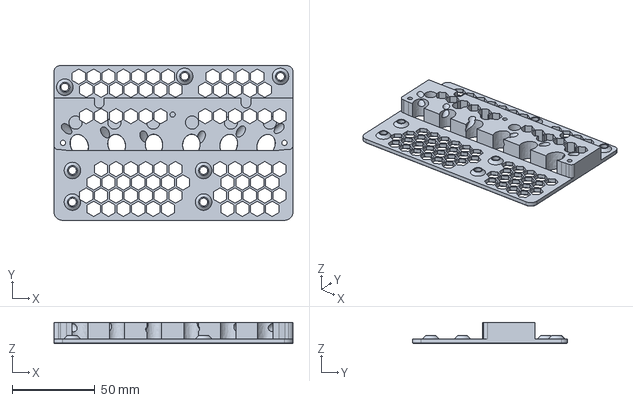
[picture p45: CAD file, 2025-06-16]
STL/StealthChanger/Задний рюкзак с электроникой/Профиль 2040/CAD/Держатель плат.step
144.6 x 93.5 x 13.0 mm
