deflord/3def/STL/StealthChanger/Задний рюкзак с электроникой/Профиль 2040/Глубокая версия/CAD/Держатель PG7.step

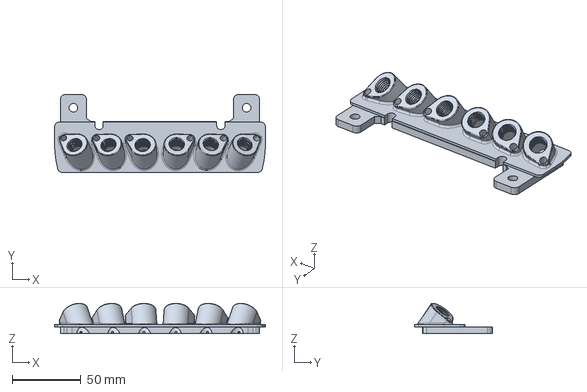
[picture p46: CAD file, 2025-09-11]
STL/StealthChanger/Задний рюкзак с электроникой/Профиль 2040/Глубокая версия/CAD/Держатель PG7.step
154.0 x 56.8 x 22.1 mm
