deflord/3def/STL/StealthChanger/Задний рюкзак с электроникой/Профиль 3030/CAD/Проставка платы 7 шт.step

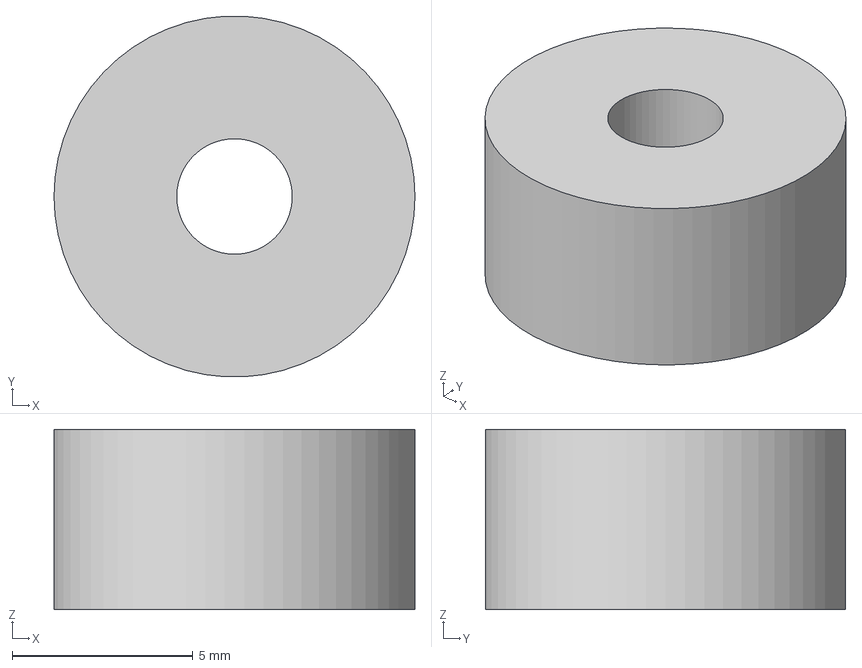
[picture p47: CAD file, 2025-06-16]
STL/StealthChanger/Задний рюкзак с электроникой/Профиль 3030/CAD/Проставка платы 7 шт.step
10.00 x 9.99 x 5.00 mm
