deflord/3def/STL/StealthChanger/Магнитный док/CAD/Задний упор с магнитами.step

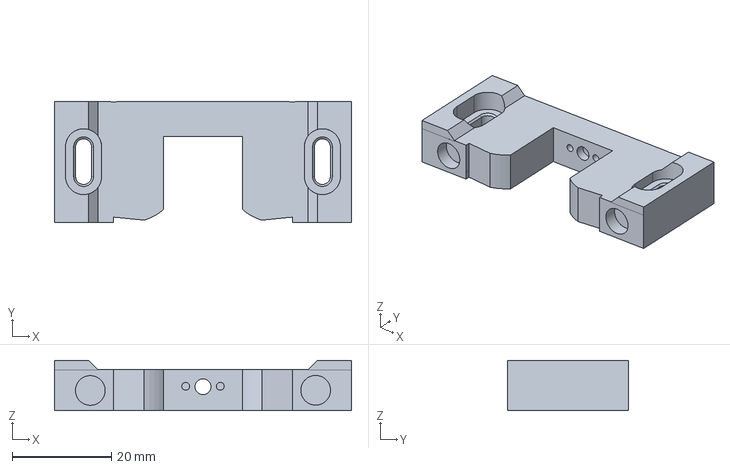
[picture p48: CAD file, 2025-09-02]
STL/StealthChanger/Магнитный док/CAD/Задний упор с магнитами.step
60.0 x 24.4 x 10.2 mm
