deflord/3def/STL/StealthChanger/Магнитный док/STL/Слюнявчик.stl

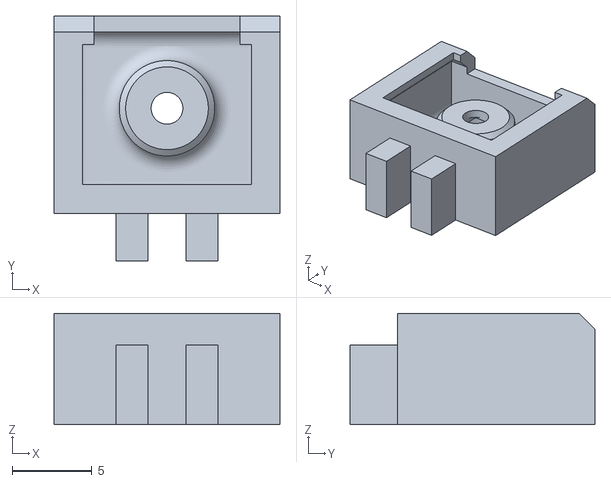
[picture p49: CAD file, 2025-09-11]
STL/StealthChanger/Магнитный док/STL/Слюнявчик.stl
14.2 x 15.4 x 7.00
