deflord/3def/STL/Большой апгрейд/ToolChanger/Держатели пуповин/Задняя панель для Mellow CAN v1.step

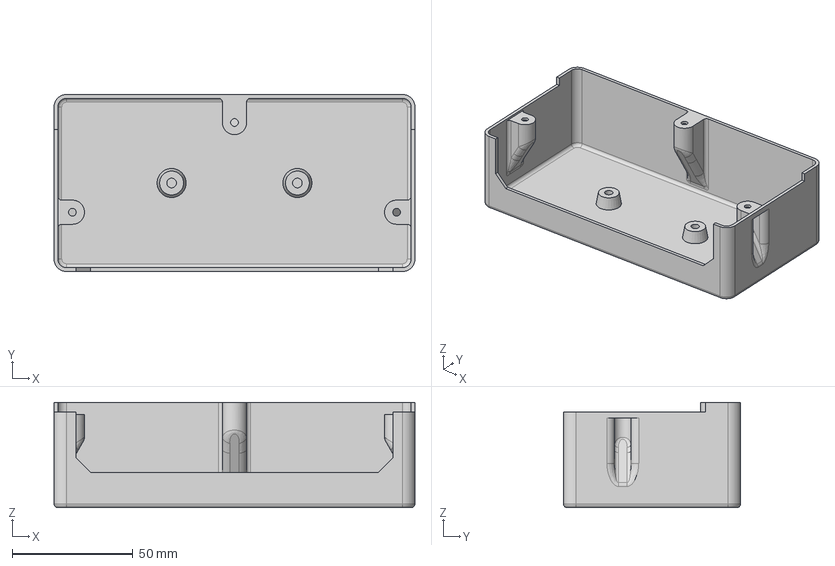
[picture p50: CAD file, 2024-10-15]
STL/Большой апгрейд/ToolChanger/Держатели пуповин/Задняя панель для Mellow CAN v1.step
149.2 x 73.2 x 43.6 mm
