deflord/3def/STL/Вытяжка/Корпус вытяжки.stl

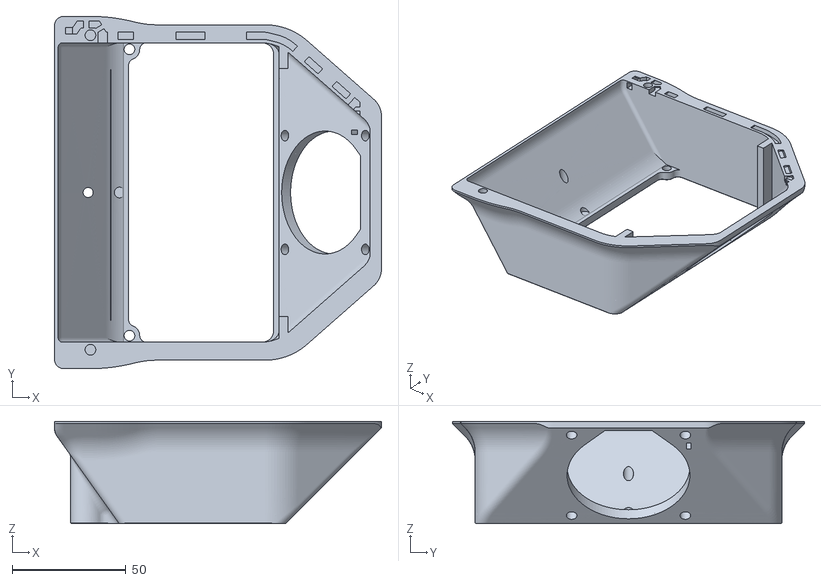
[picture p51: CAD file, 2024-11-28]
STL/Вытяжка/Корпус вытяжки.stl
143.7 x 154.8 x 45.0
