deflord/3def/STL/Моды/CPAP/BTT Eco Turbo Kit/CAD/Корпус вытяжки с датчиком BTT SFS2.step

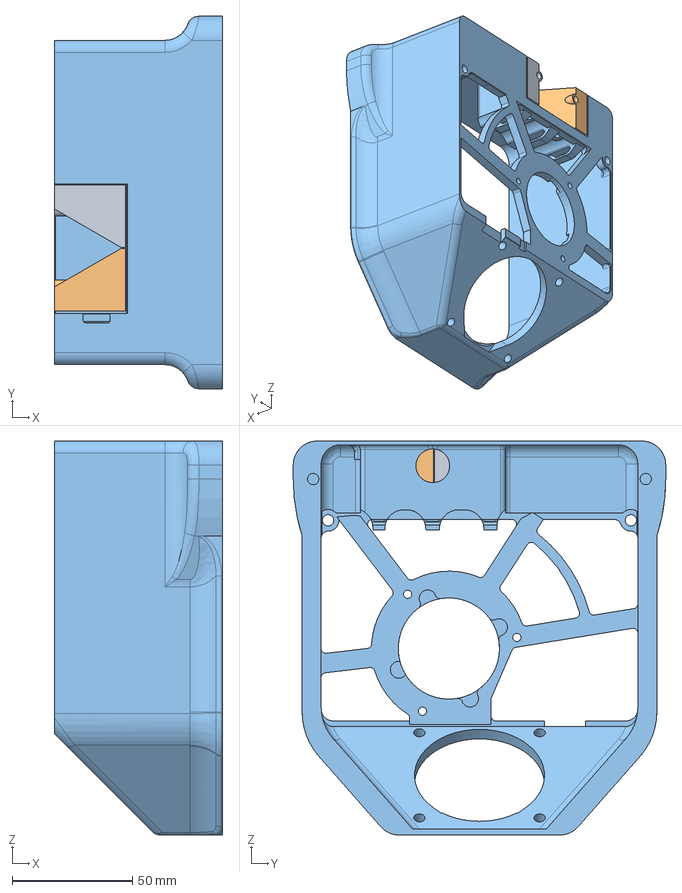
[picture p52: CAD file, 2025-06-22]
STL/Моды/CPAP/BTT Eco Turbo Kit/CAD/Корпус вытяжки с датчиком BTT SFS2.step
70.0 x 154.8 x 163.7 mm
