deflord/3def/STL/Моды/CPAP/Monolith/CAD/Держатель плоский.step

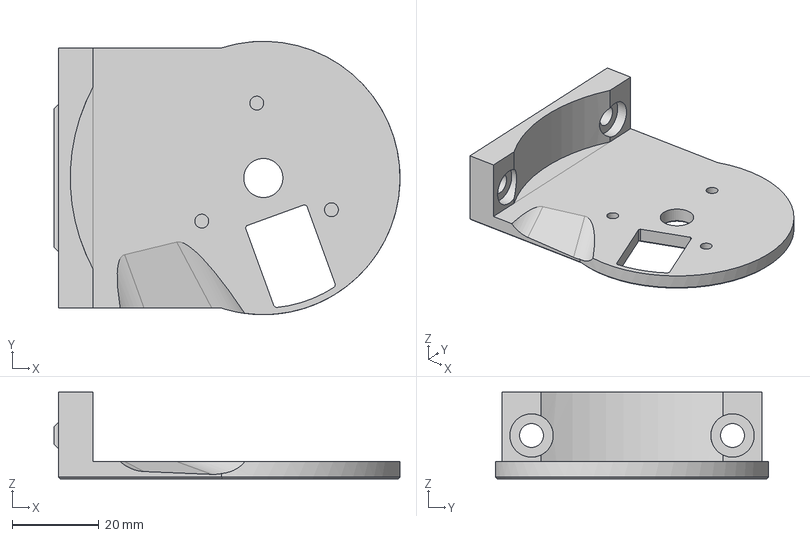
[picture p53: CAD file, 2026-01-16]
STL/Моды/CPAP/Monolith/CAD/Держатель плоский.step
79.7 x 63.0 x 20.0 mm
