deflord/3def/STL/Моды/CPAP/Xiaomi CPAP/Держатель на портал.STL

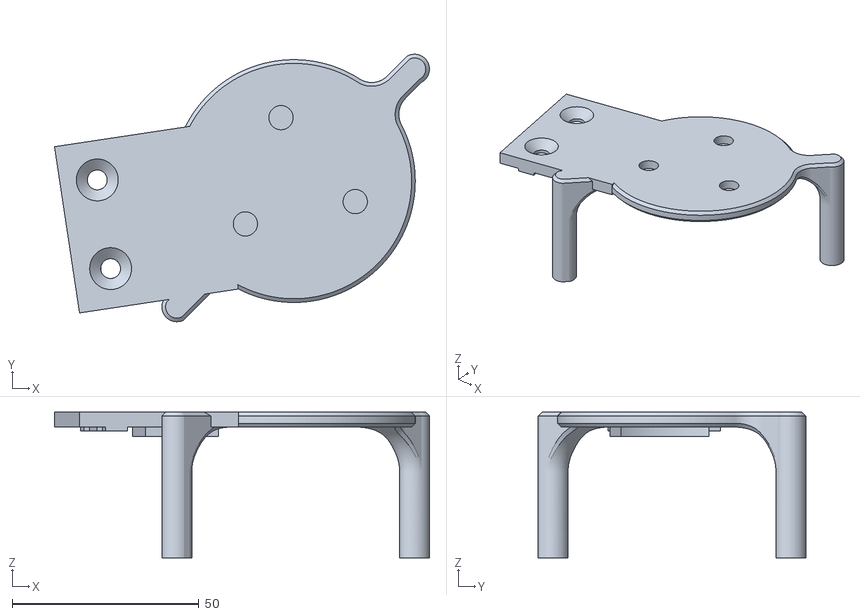
[picture p54: CAD file, 2026-01-16]
STL/Моды/CPAP/Xiaomi CPAP/Держатель на портал.STL
100.4 x 71.6 x 39.0
