deflord/3def/STL/Моды/Активный подогрев/300:350:400/CAD/Правая часть.step

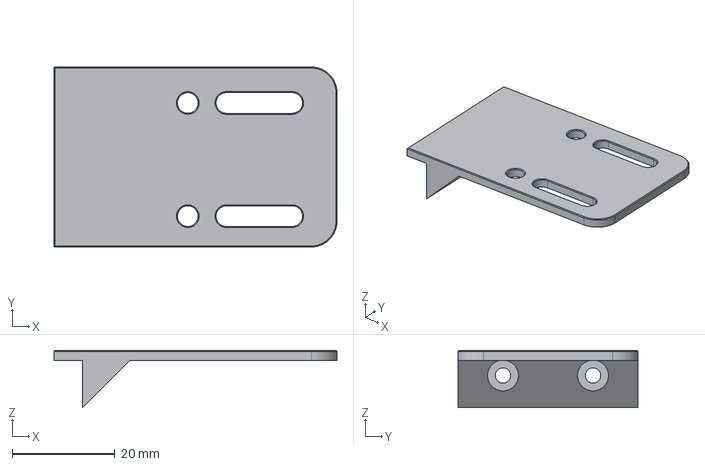
[picture p55: CAD file, 2025-08-06]
STL/Моды/Активный подогрев/300:350:400/CAD/Правая часть.step
55.0 x 35.0 x 11.2 mm
