deflord/3def/STL/Моды/Активный подогрев/500/CAD/Перемычка в середине.step

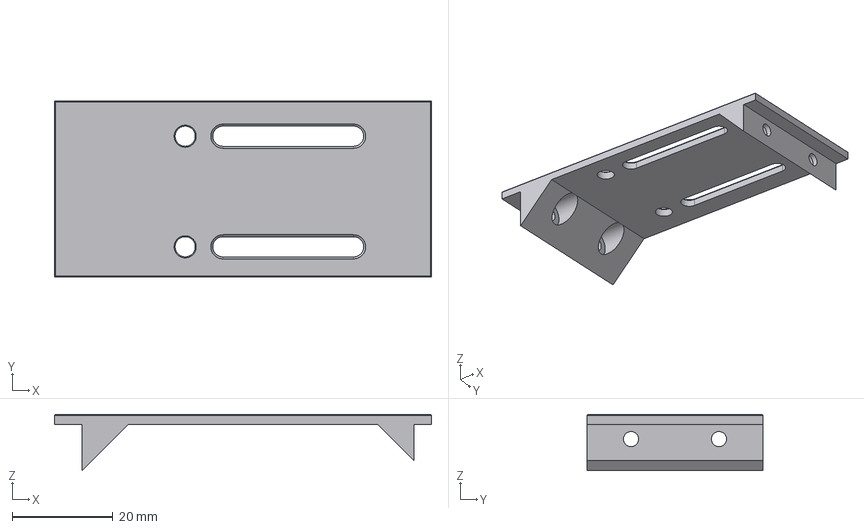
[picture p56: CAD file, 2025-08-06]
STL/Моды/Активный подогрев/500/CAD/Перемычка в середине.step
75.0 x 35.0 x 11.2 mm
