deflord/3def/STL/Моды/Верхний ввод прутка/Ball.stl

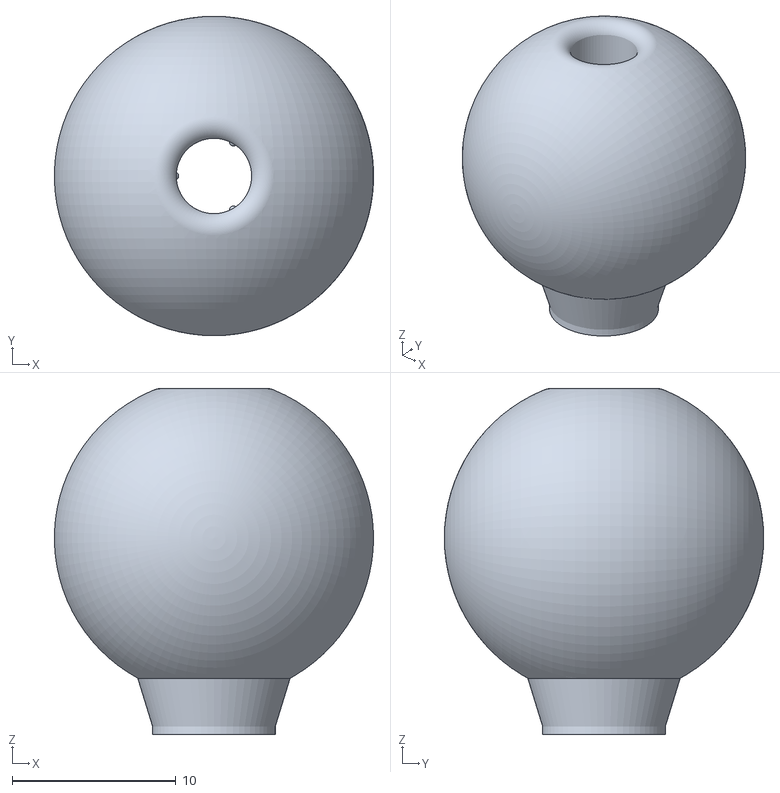
[picture p57: CAD file, 2024-08-04]
STL/Моды/Верхний ввод прутка/Ball.stl
19.5 x 19.5 x 21.1
