deflord/3def/STL/Моды/Держатель CAN на заднюю балку/Держатель для PG7/Передняя крышка.STL

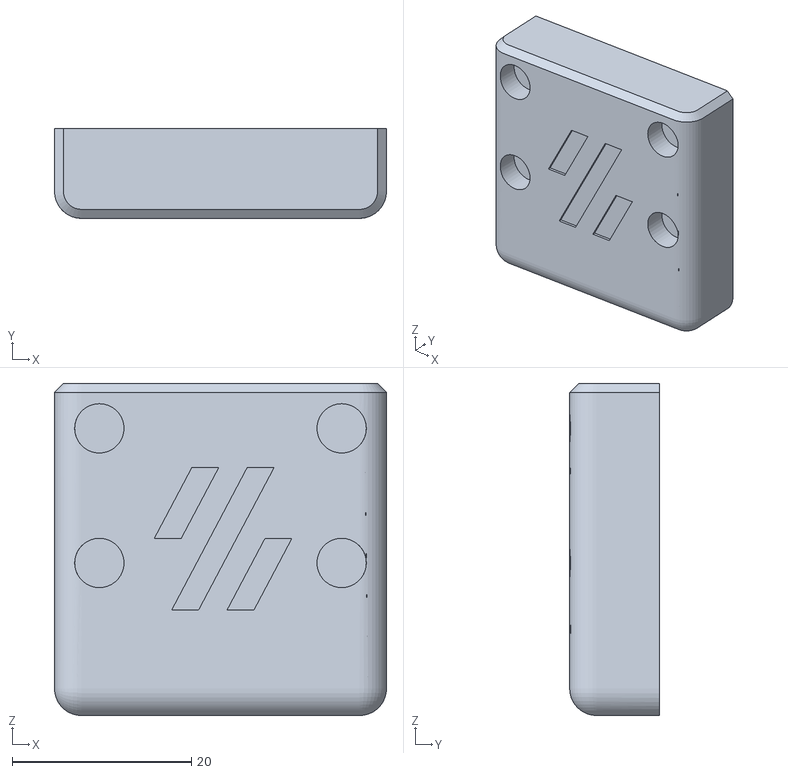
[picture p58: CAD file, 2024-12-29]
STL/Моды/Держатель CAN на заднюю балку/Держатель для PG7/Передняя крышка.STL
37.0 x 10.00 x 37.0
