deflord/3def/STL/Моды/Держатель CAN на заднюю балку/Держатель под стяжку/Передняя крышка.step

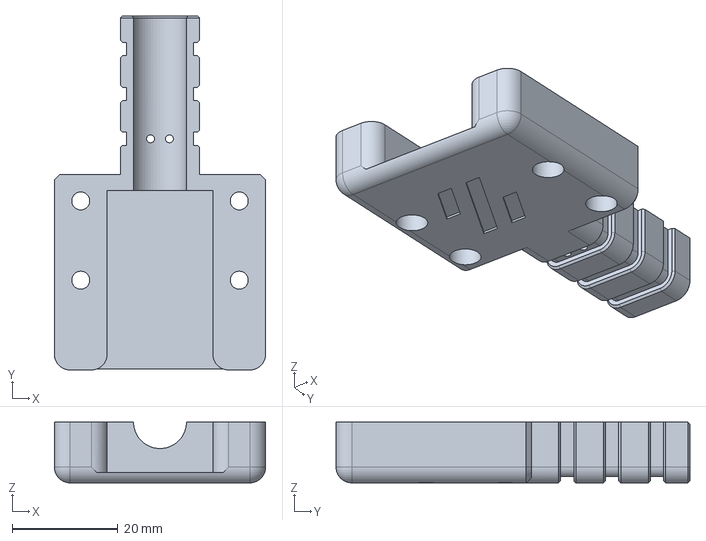
[picture p59: CAD file, 2026-02-05]
STL/Моды/Держатель CAN на заднюю балку/Держатель под стяжку/Передняя крышка.step
40.0 x 67.0 x 11.5 mm
