deflord/3def/STL/Моды/Держатель датчика SFS2/Профиль 2020/BTT_SFS2_Mount_4mm.stl

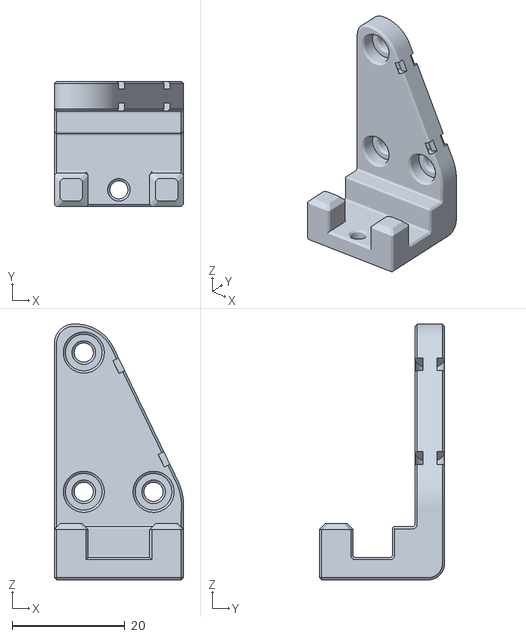
[picture p60: CAD file, 2025-03-05]
STL/Моды/Держатель датчика SFS2/Профиль 2020/BTT_SFS2_Mount_4mm.stl
23.0 x 22.3 x 45.5
