deflord/3def/STL/Моды/Держатель датчика SFS2/Профиль 3030/Держатель 3030.step

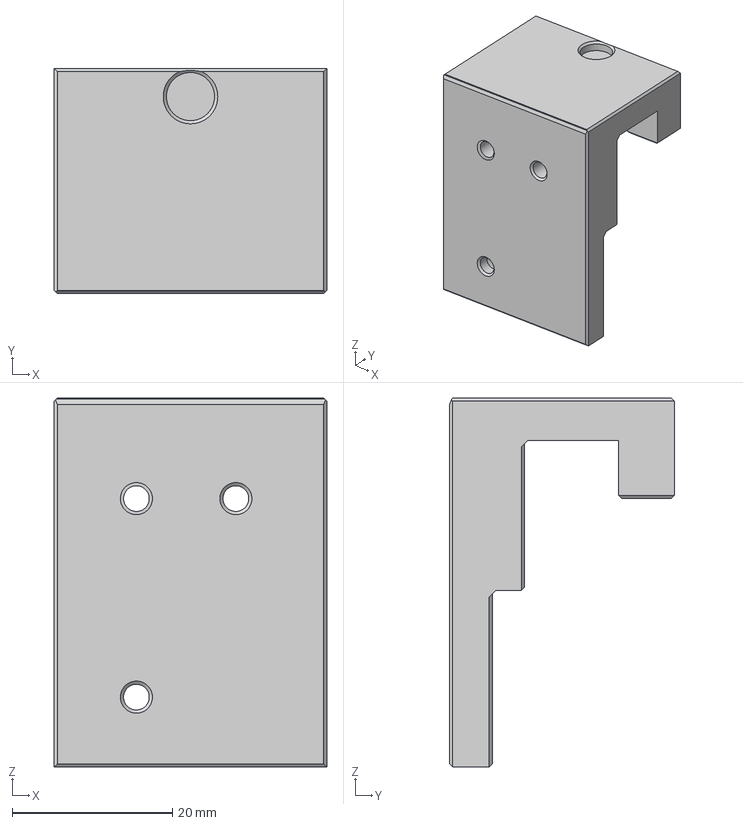
[picture p61: CAD file, 2025-03-24]
STL/Моды/Держатель датчика SFS2/Профиль 3030/Держатель 3030.step
34.0 x 28.1 x 46.0 mm
