deflord/3def/STL/Моды/Держатель разъёма USB/CAD/Skirt USB.step

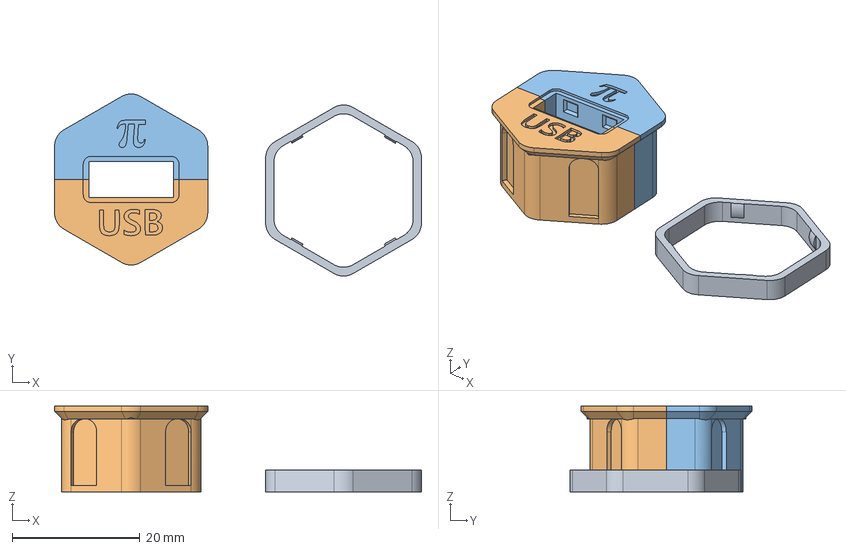
[picture p62: CAD file, 2025-07-21]
STL/Моды/Держатель разъёма USB/CAD/Skirt USB.step
57.5 x 28.5 x 13.4 mm
