deflord/3def/STL/Моды/Держатель разъёма USB/STL/lock ring.stl

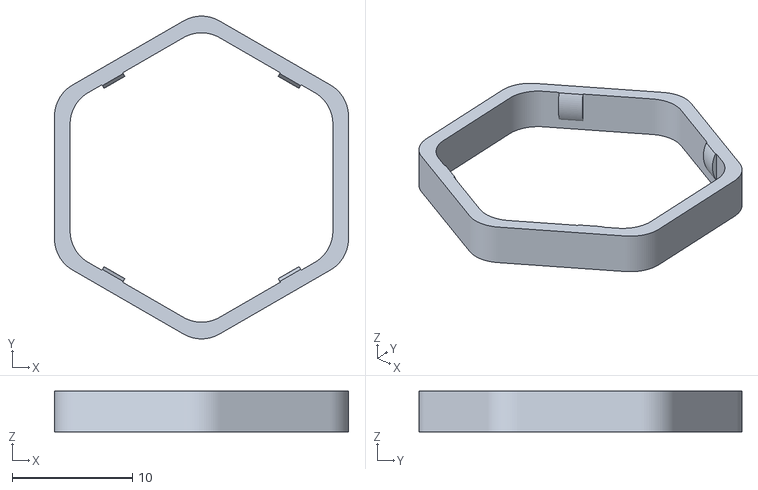
[picture p63: CAD file, 2025-07-21]
STL/Моды/Держатель разъёма USB/STL/lock ring.stl
24.4 x 26.8 x 3.40
