deflord/3def/STL/Моды/Держатель экрана/300:350:400/Шарнир B.STL

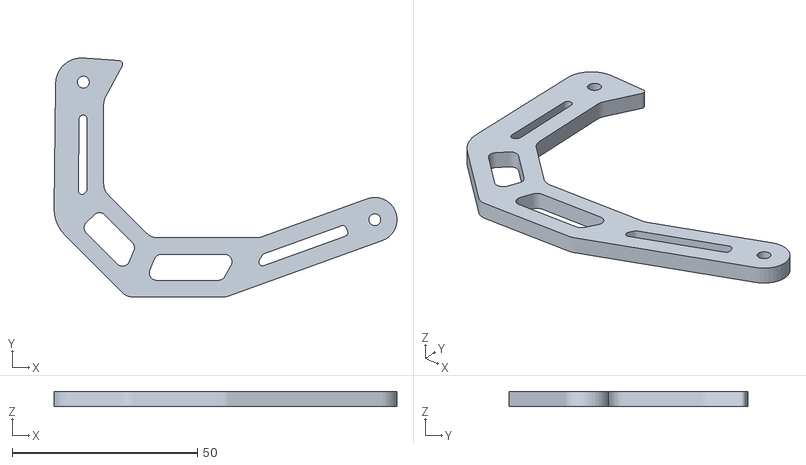
[picture p64: CAD file, 2025-03-24]
STL/Моды/Держатель экрана/300:350:400/Шарнир B.STL
92.6 x 64.5 x 3.98
