deflord/3def/STL/Моды/Камера/Держатель камеры на портал/камера корпус.3mf

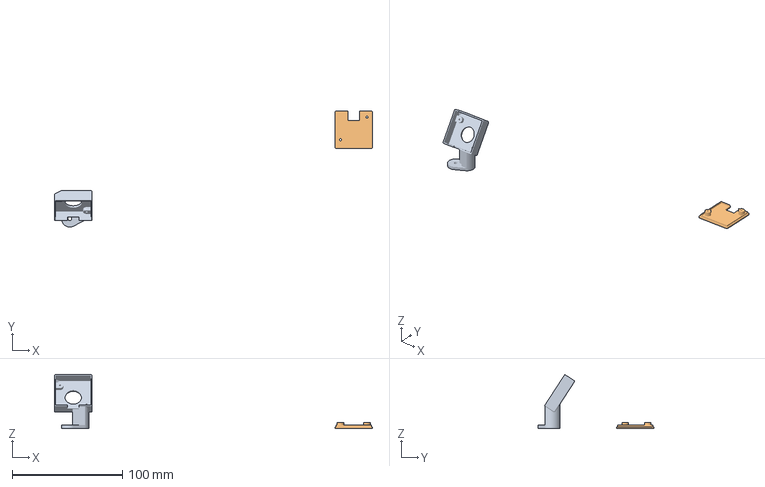
[picture p65: CAD file, 2024-10-15]
STL/Моды/Камера/Держатель камеры на портал/камера корпус.3mf
288.0 x 105.1 x 48.9 mm
камера корпус.stl
крышка камеры.stl
