deflord/3def/STL/Моды/Камера/Камера 4К/CNC Мод/Voron 350 CNC камера.step

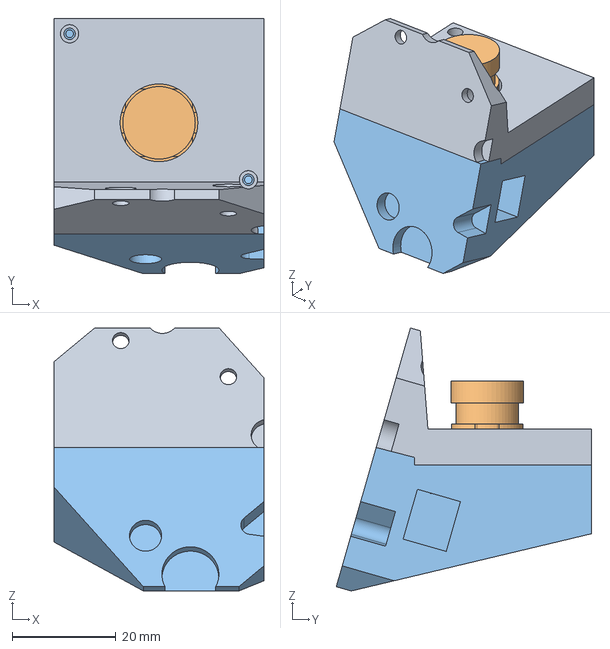
[picture p66: CAD file, 2025-03-26]
STL/Моды/Камера/Камера 4К/CNC Мод/Voron 350 CNC камера.step
40.5 x 49.3 x 50.8 mm
