deflord/3def/STL/Моды/Камера/Камера FullHD/Monolith мод/CAD/Крепление Monolith.step

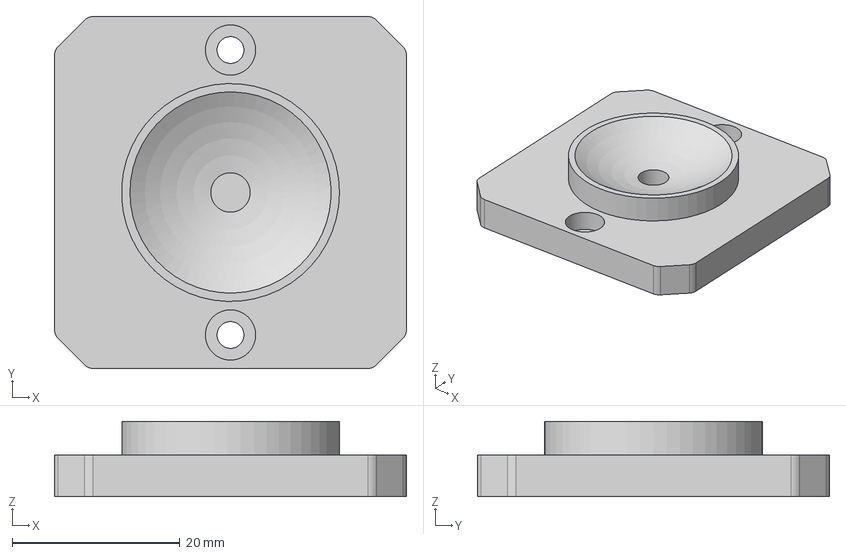
[picture p67: CAD file, 2025-04-02]
STL/Моды/Камера/Камера FullHD/Monolith мод/CAD/Крепление Monolith.step
42.0 x 42.0 x 9.00 mm
