deflord/3def/STL/Моды/Камера/Камера FullHD/Monolith мод/STL/Нижняя часть.stl

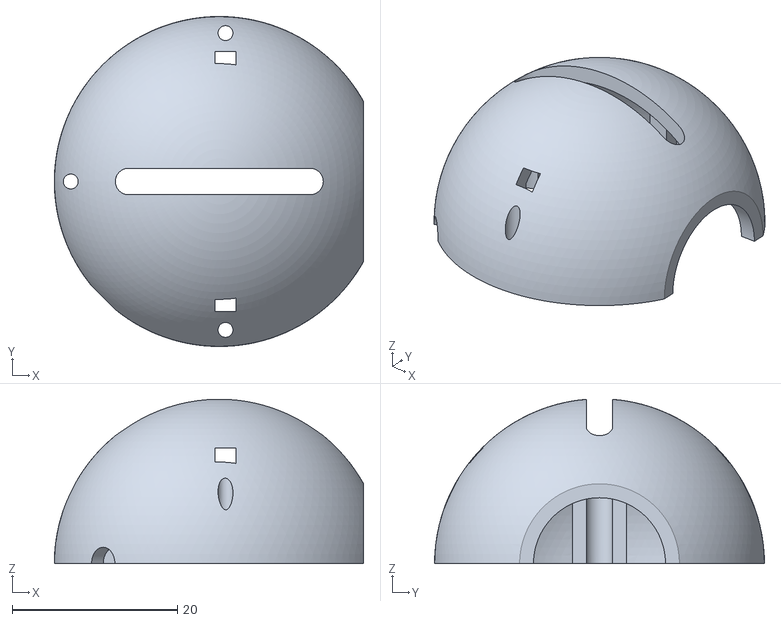
[picture p68: CAD file, 2025-04-02]
STL/Моды/Камера/Камера FullHD/Monolith мод/STL/Нижняя часть.stl
37.5 x 40.0 x 19.9
