deflord/3def/STL/Моды/Камера/Камера FullHD/СNC мод/CAD/Шаблон для сверления отверстий под резьбу.step

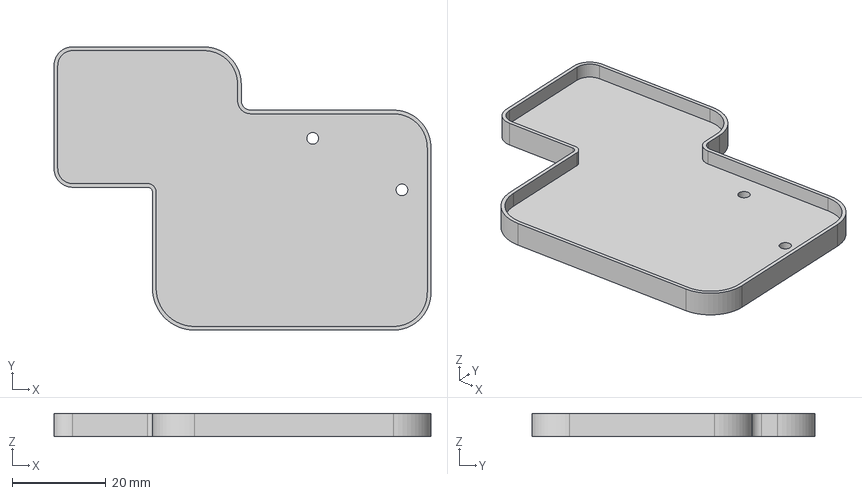
[picture p69: CAD file, 2025-04-02]
STL/Моды/Камера/Камера FullHD/СNC мод/CAD/Шаблон для сверления отверстий под резьбу.step
80.5 x 60.5 x 5.00 mm
