deflord/3def/STL/Моды/Ограничитель движения по Z/Крышка ограничителя.stl

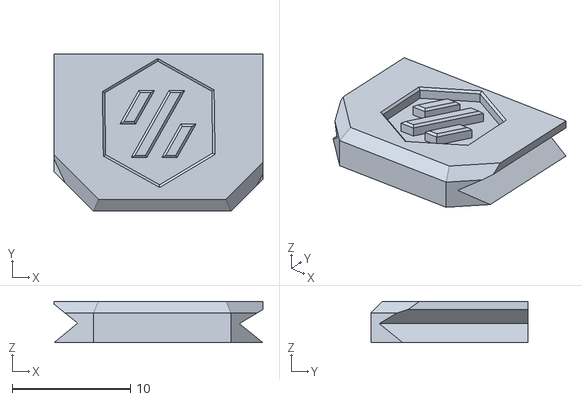
[picture p70: CAD file, 2024-08-05]
STL/Моды/Ограничитель движения по Z/Крышка ограничителя.stl
17.7 x 13.3 x 3.50
