deflord/3def/STL/Моды/Ограничитель движения по Z/Ограничитель Monolith/Стопор каретки по оси Z.stl

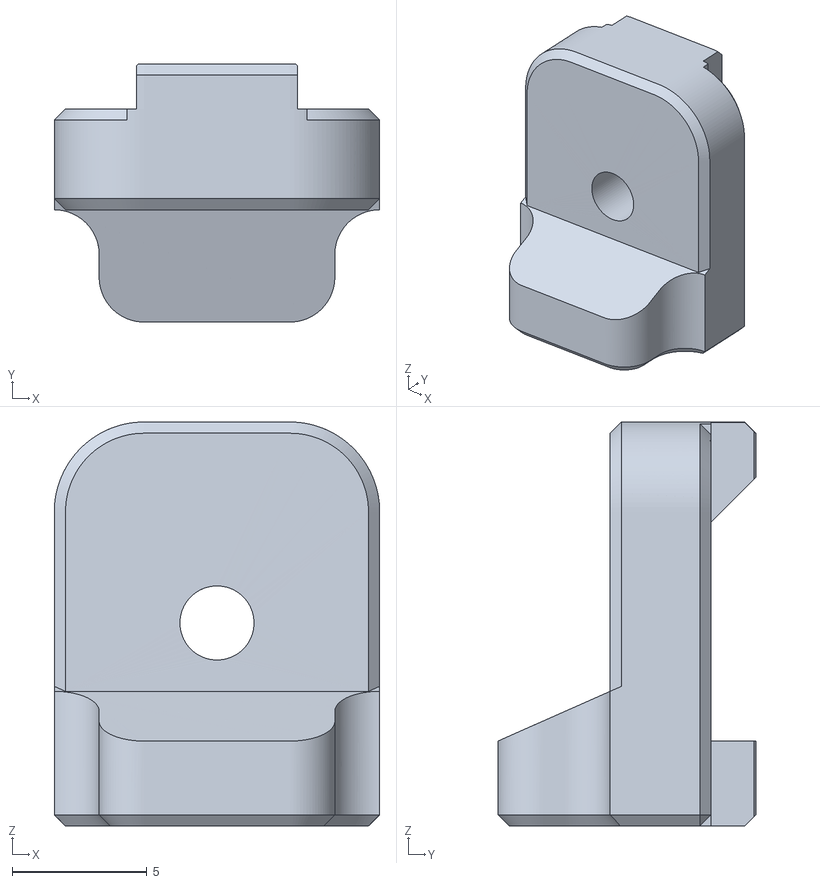
[picture p71: CAD file, 2025-08-04]
STL/Моды/Ограничитель движения по Z/Ограничитель Monolith/Стопор каретки по оси Z.stl
12.1 x 9.60 x 15.0
