deflord/3def/STL/Моды/Освещение/LED ленты габаритные огни/Держатель LED полоски.step

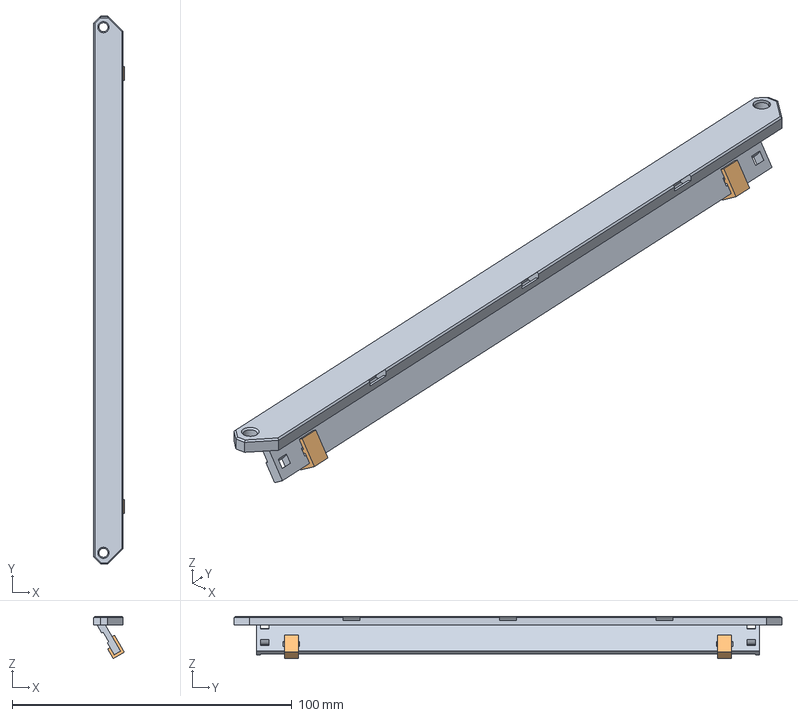
[picture p72: CAD file, 2026-02-21]
STL/Моды/Освещение/LED ленты габаритные огни/Держатель LED полоски.step
11.0 x 196.0 x 15.1 mm
