deflord/3def/STL/Моды/Очистка сопла/Лоток для отходов.stl

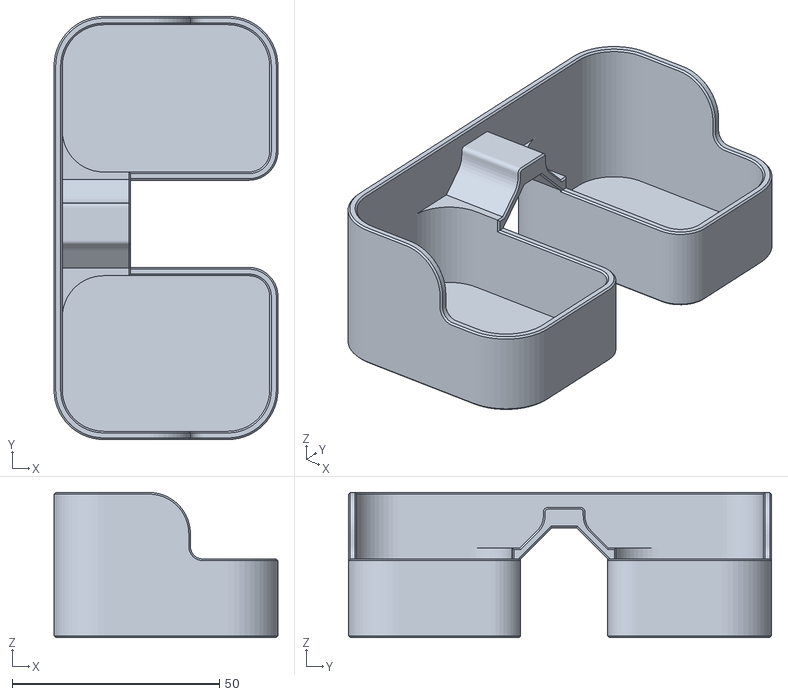
[picture p73: CAD file, 2024-08-04]
STL/Моды/Очистка сопла/Лоток для отходов.stl
54.0 x 102.0 x 35.0
