deflord/3def/STL/Моды/Рециркуляция Newermore/[a]V6_Jalousie_Slicer.stl

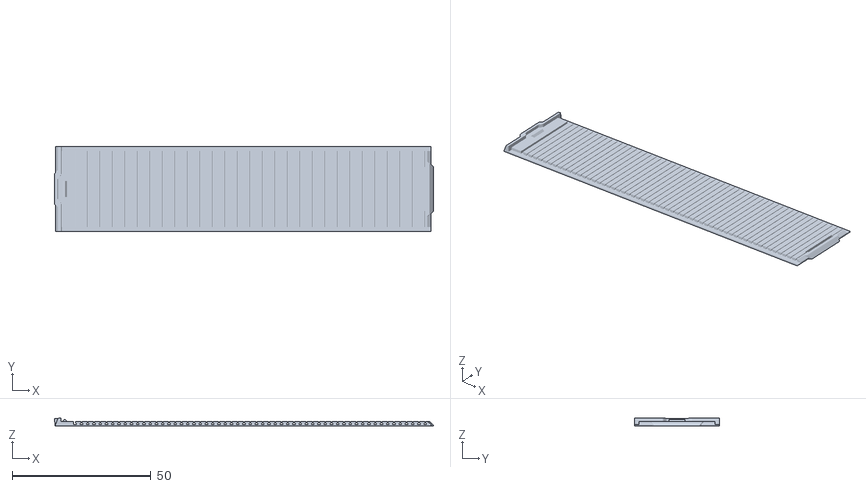
[picture p74: CAD file, 2024-08-04]
STL/Моды/Рециркуляция Newermore/[a]V6_Jalousie_Slicer.stl
136.4 x 30.8 x 2.86
