deflord/3def/STL/Моды/Ручки для переноски принтера/Профиль 2020/sturdy_handles.stl

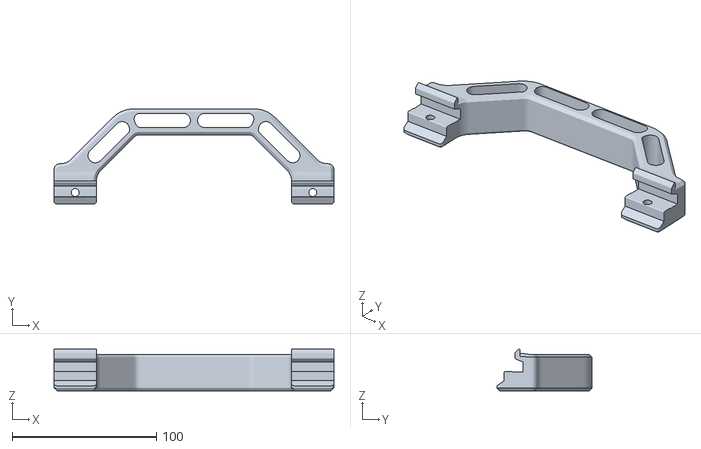
[picture p75: CAD file, 2024-08-05]
STL/Моды/Ручки для переноски принтера/Профиль 2020/sturdy_handles.stl
194.3 x 66.0 x 28.9
