deflord/3def/STL/Моды/Ручки для переноски принтера/Профиль 3030/Ручка для 500.step

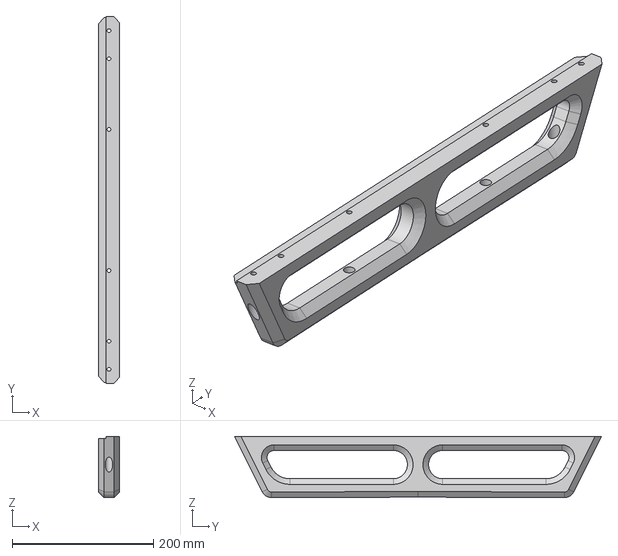
[picture p76: CAD file, 2026-05-22]
STL/Моды/Ручки для переноски принтера/Профиль 3030/Ручка для 500.step
30.0 x 520.0 x 86.8 mm
