deflord/3def/STL/Обшивка/Быстросъёмные защёлки/Защёлки не требующие болтов/2020/CAD/Боковая_2020.STEP

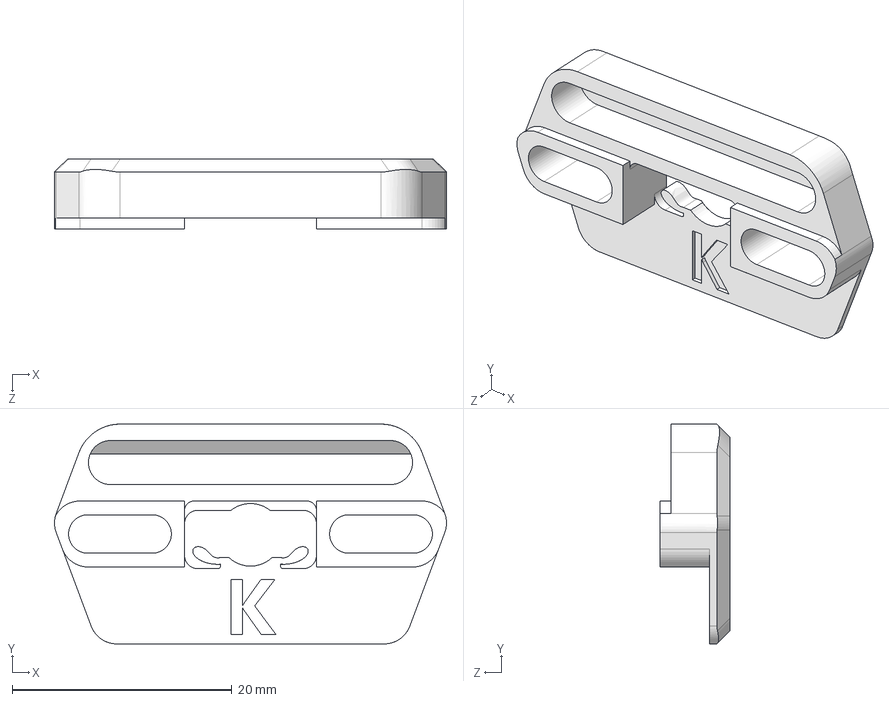
[picture p77: CAD file, 2025-06-16]
STL/Обшивка/Быстросъёмные защёлки/Защёлки не требующие болтов/2020/CAD/Боковая_2020.STEP
35.7 x 20.0 x 6.40 mm
