deflord/3def/STL/Обшивка/Быстросъёмные защёлки/Защёлки не требующие болтов/2040/Угловая_2040.step

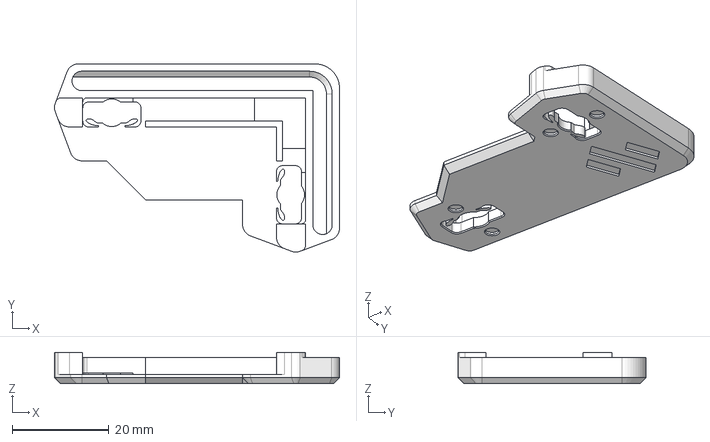
[picture p78: CAD file, 2025-06-16]
STL/Обшивка/Быстросъёмные защёлки/Защёлки не требующие болтов/2040/Угловая_2040.step
58.8 x 38.8 x 6.40 mm
