deflord/3def/STL/Обшивка/Быстросъёмные защёлки/Защёлки не требующие болтов/3030/Угловая_3030.STL

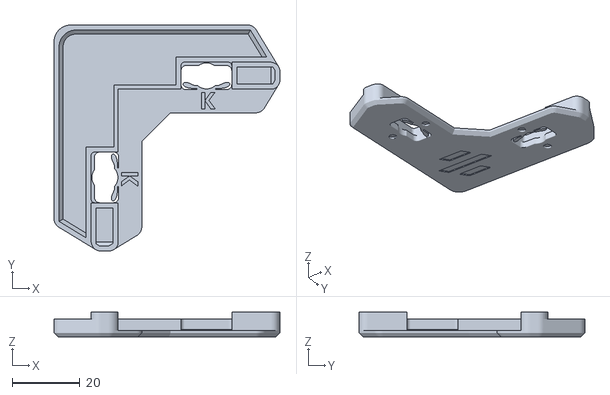
[picture p79: CAD file, 2024-11-08]
STL/Обшивка/Быстросъёмные защёлки/Защёлки не требующие болтов/3030/Угловая_3030.STL
66.9 x 66.9 x 7.40
