deflord/3def/STL/Обшивка/Быстросъёмные защёлки/Защёлки/NewLatch-3.0mm.stl

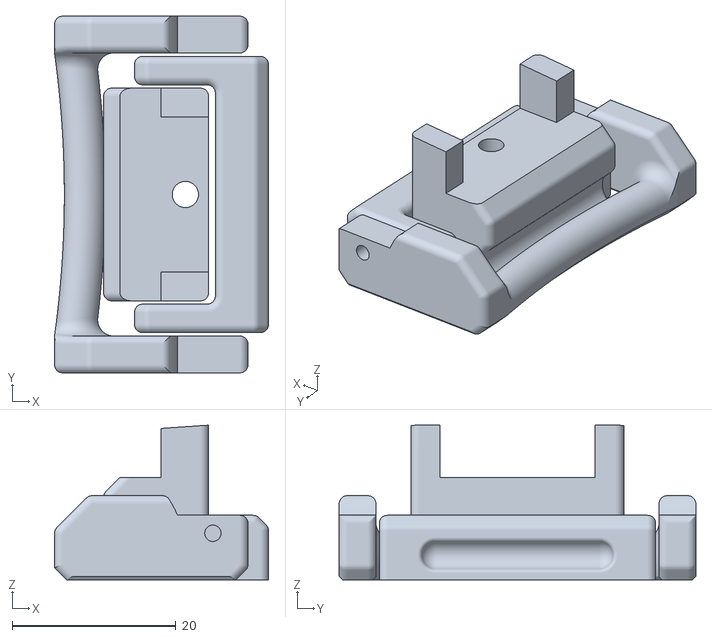
[picture p80: CAD file, 2024-08-05]
STL/Обшивка/Быстросъёмные защёлки/Защёлки/NewLatch-3.0mm.stl
26.2 x 43.6 x 18.9
