deflord/3def/STL/Обшивка/Двери/Магнитный замок/Левый корпус.step

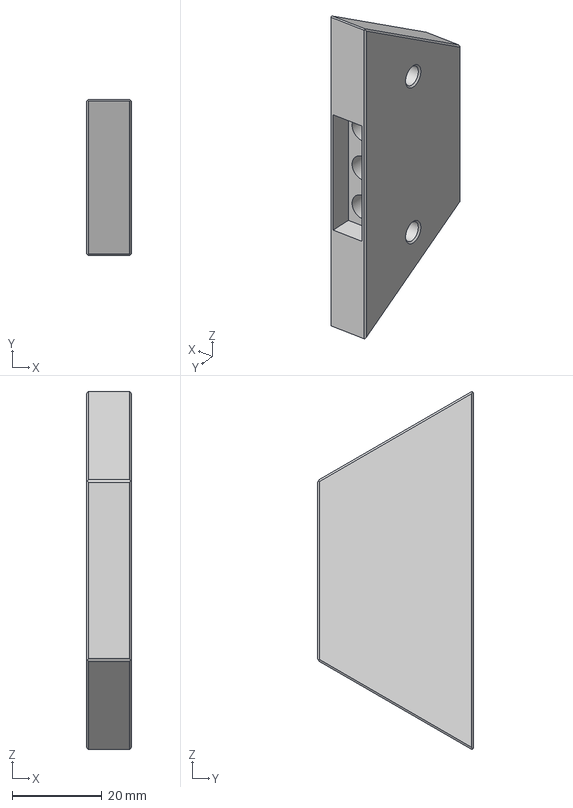
[picture p81: CAD file, 2025-03-26]
STL/Обшивка/Двери/Магнитный замок/Левый корпус.step
10.0 x 34.6 x 79.6 mm
