deflord/3def/STL/Обшивка/Двери/Петли дверей/500/Версия от 14.04.2026/Держатель обшивки для петли B 3030x3.stl

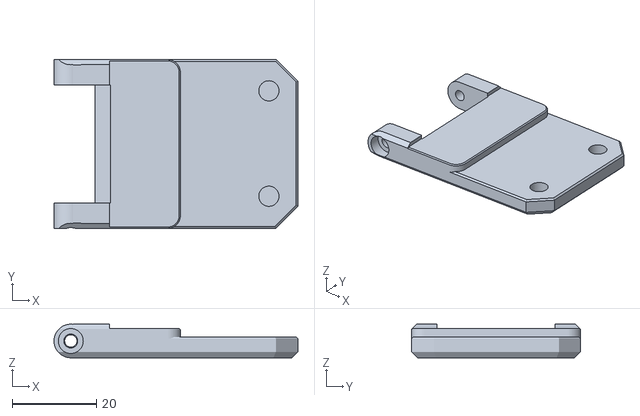
[picture p82: CAD file, 2026-04-14]
STL/Обшивка/Двери/Петли дверей/500/Версия от 14.04.2026/Держатель обшивки для петли B 3030x3.stl
57.9 x 40.0 x 7.99
