deflord/3def/STL/Обшивка/Двери/Ручки дверей/300:350:400/Ручка B x2.stl

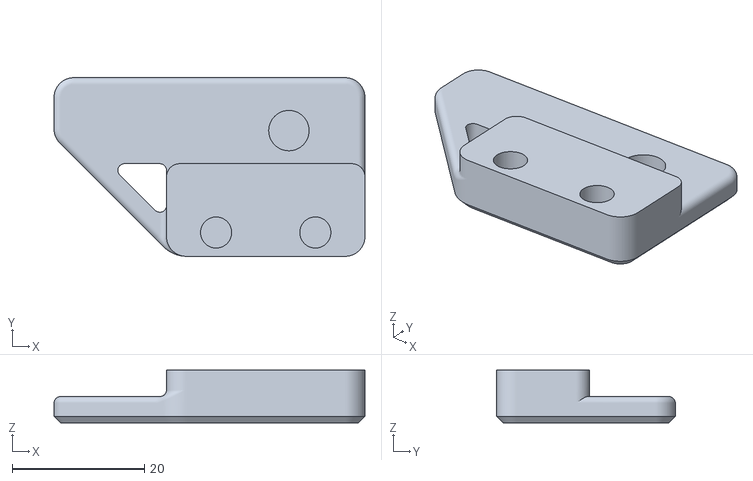
[picture p83: CAD file, 2025-03-24]
STL/Обшивка/Двери/Ручки дверей/300:350:400/Ручка B x2.stl
47.0 x 27.0 x 8.00
