deflord/3def/STL/Обшивка/Заглушки ремней оси Z/300-350-400/cable_routing_z_belt_cover_b_mod_rail_notch_v2.2.stl

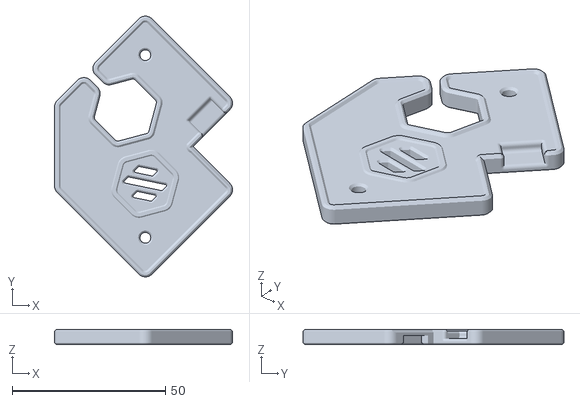
[picture p84: CAD file, 2024-09-17]
STL/Обшивка/Заглушки ремней оси Z/300-350-400/cable_routing_z_belt_cover_b_mod_rail_notch_v2.2.stl
58.2 x 85.2 x 5.00
