deflord/3def/STL/Обшивка/Заглушки ремней оси Z/300-350-400/Monolith/Заглушки ремней по Z Monolith 2020.step

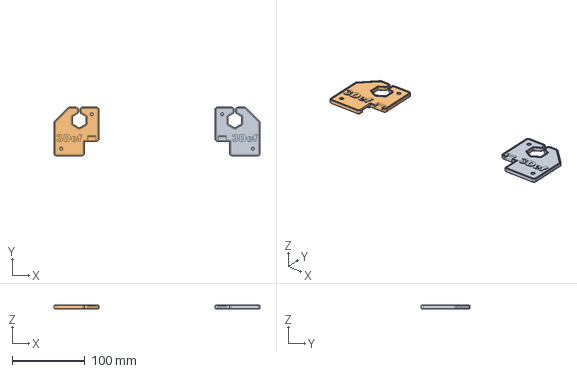
[picture p85: CAD file, 2026-01-16]
STL/Обшивка/Заглушки ремней оси Z/300-350-400/Monolith/Заглушки ремней по Z Monolith 2020.step
284.0 x 67.0 x 5.00 mm
