deflord/3def/STL/Обшивка/Заглушки ремней оси Z/500/3030Z_monolith_bed_fan.STEP

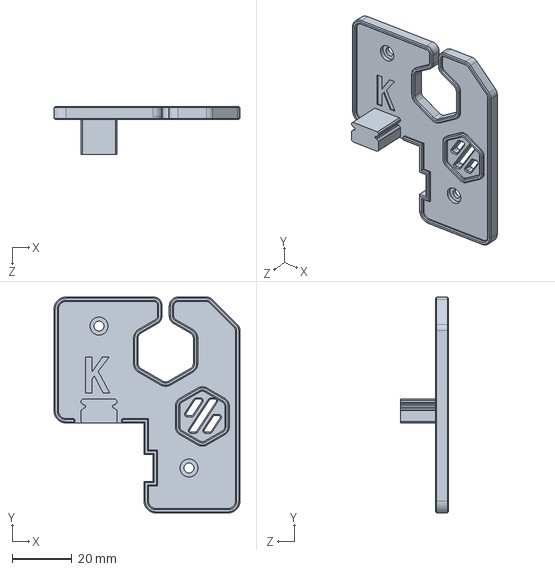
[picture p86: CAD file, 2026-01-29]
STL/Обшивка/Заглушки ремней оси Z/500/3030Z_monolith_bed_fan.STEP
62.0 x 72.0 x 16.0 mm
