deflord/3def/STL/Обшивка/Крепление крышки аппаратного отсека/bottom_panel_clip_x6.stl

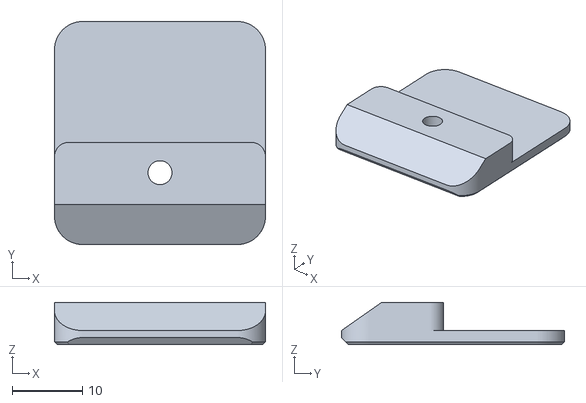
[picture p87: CAD file, 2024-08-04]
STL/Обшивка/Крепление крышки аппаратного отсека/bottom_panel_clip_x6.stl
30.0 x 31.7 x 6.00
