deflord/3def/STL/Обшивка/Купол/напавляющая купола быстросъёмная.stp

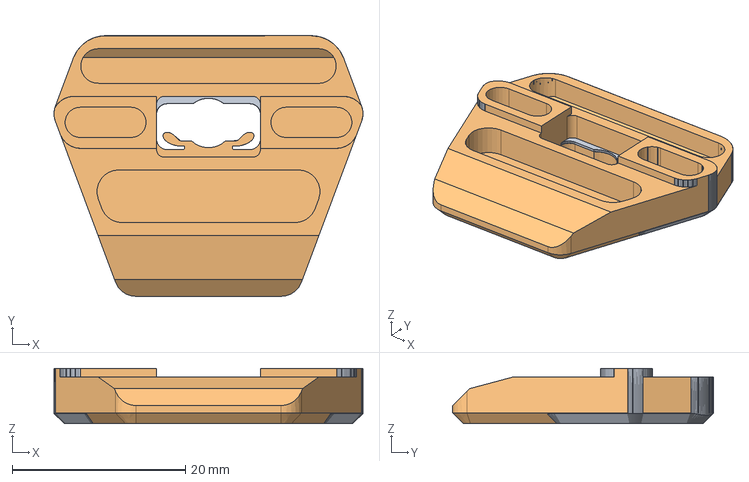
[picture p88: CAD file, 2025-05-21]
STL/Обшивка/Купол/напавляющая купола быстросъёмная.stp
35.7 x 30.1 x 6.40 mm
