deflord/3def/STL/Обшивка/Нижняя юбка/400/side_skirt_b_400_x2.stl

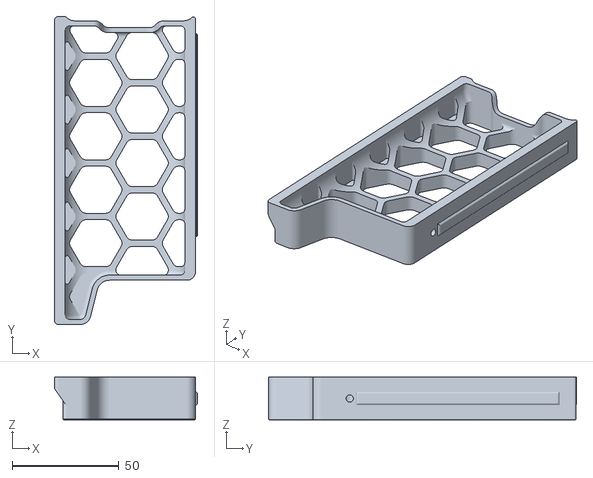
[picture p89: CAD file, 2025-01-22]
STL/Обшивка/Нижняя юбка/400/side_skirt_b_400_x2.stl
67.0 x 144.0 x 20.0
