deflord/3def/STL/Обшивка/Нижняя юбка/500/Держатель разъёма питания EMI/Держатель разъёма с фильтром EMI.STL

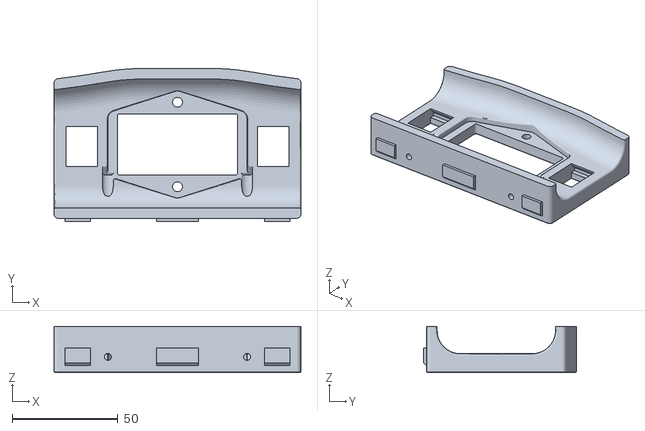
[picture p90: CAD file, 2026-01-16]
STL/Обшивка/Нижняя юбка/500/Держатель разъёма питания EMI/Держатель разъёма с фильтром EMI.STL
117.0 x 72.5 x 22.0
