deflord/3def/STL/Обшивка/Нижняя юбка/Разъёмы/Разъем JST 2,54 mm 4 PIN/Skirt JST 2,54 4Pin v5.step

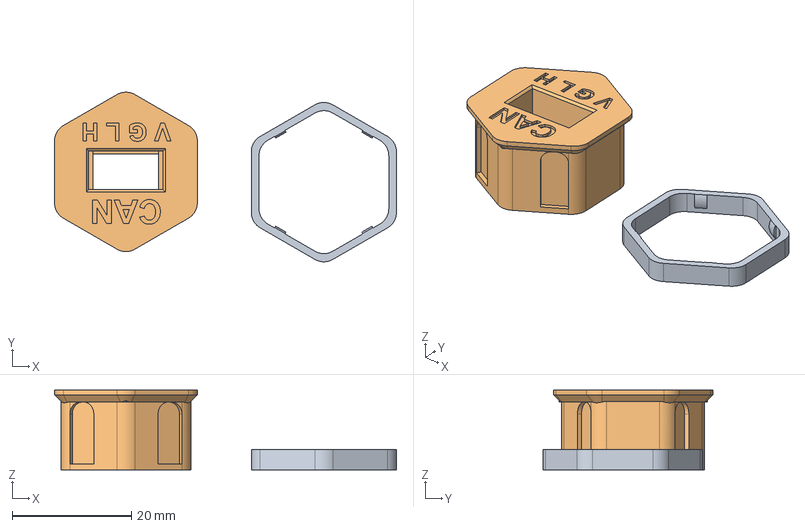
[picture p91: CAD file, 2025-11-12]
STL/Обшивка/Нижняя юбка/Разъёмы/Разъем JST 2,54 mm 4 PIN/Skirt JST 2,54 4Pin v5.step
57.5 x 28.5 x 13.4 mm
