deflord/3def/STL/Обшивка/Прижим перегородки аппаратного отсека/Верхняя крышка.STL

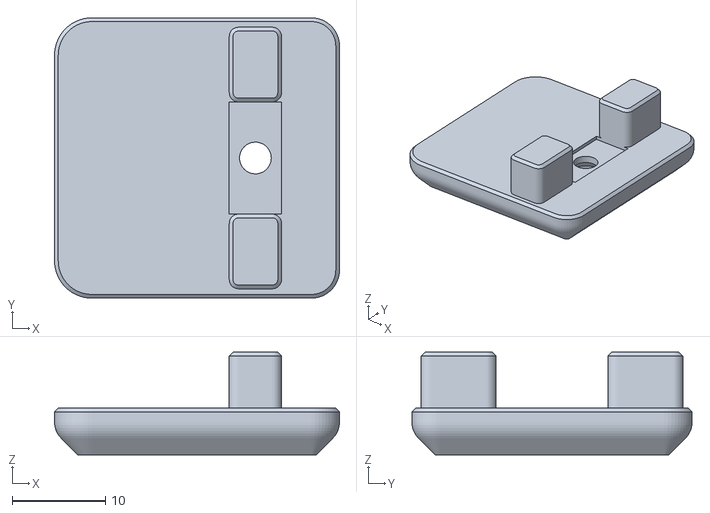
[picture p92: CAD file, 2024-08-29]
STL/Обшивка/Прижим перегородки аппаратного отсека/Верхняя крышка.STL
30.5 x 30.0 x 11.0
