deflord/3def/STL/Ось Z/500/Новая версия/Верхние натяжители/Корпус натяжителя Z AX2.stl

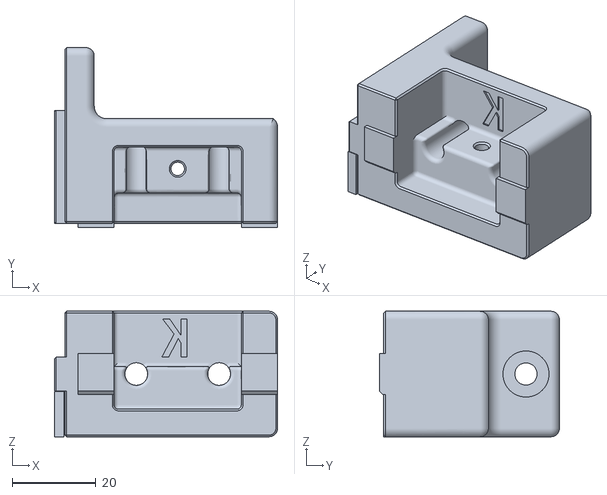
[picture p93: CAD file, 2025-04-07]
STL/Ось Z/500/Новая версия/Верхние натяжители/Корпус натяжителя Z AX2.stl
53.3 x 43.0 x 30.0
