deflord/3def/STL/Ось Z/500/Новая версия/Редукторы/Z натяжитель ремня двигателя AX2.stl

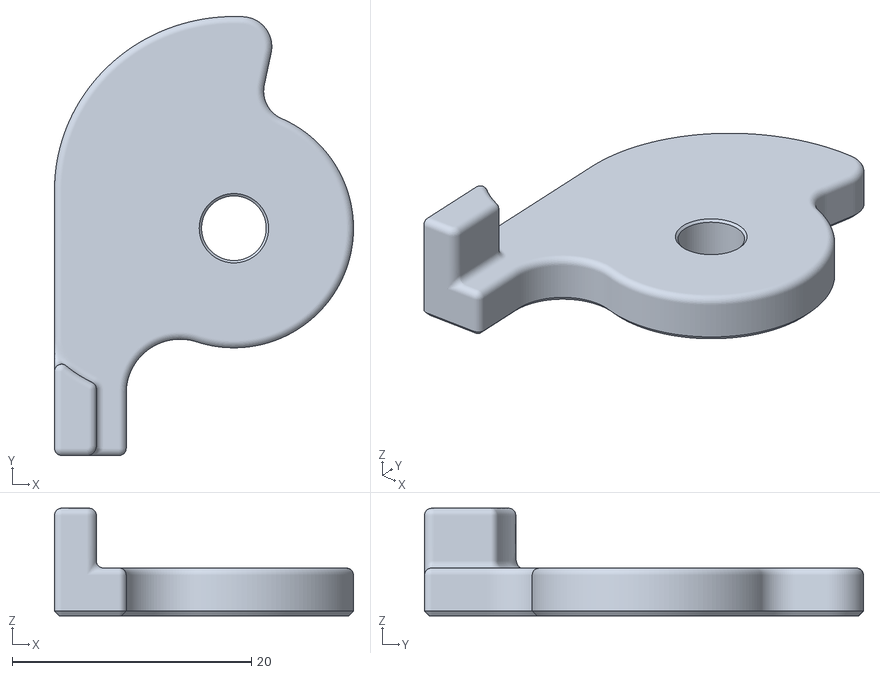
[picture p94: CAD file, 2026-04-22]
STL/Ось Z/500/Новая версия/Редукторы/Z натяжитель ремня двигателя AX2.stl
25.0 x 36.7 x 9.00
