deflord/3def/STL/Ось Z/500/Старая версия/Z редуктор BX2.stl

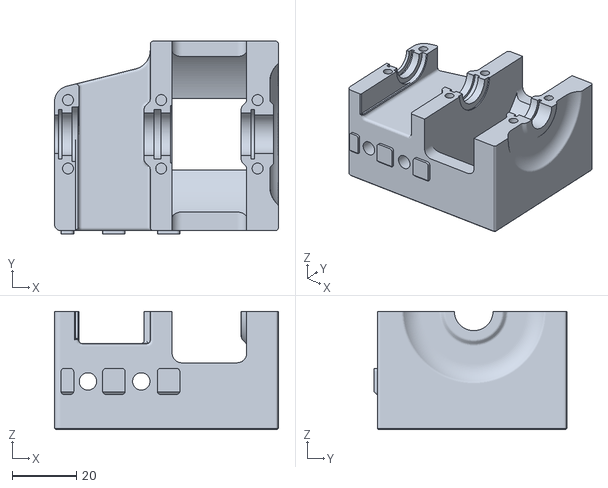
[picture p95: CAD file, 2024-08-05]
STL/Ось Z/500/Старая версия/Z редуктор BX2.stl
69.7 x 60.0 x 36.8
