deflord/3def/STL/Ось Z/Натяжители под Monolith/CAD/Monolith_Z Idler A.step

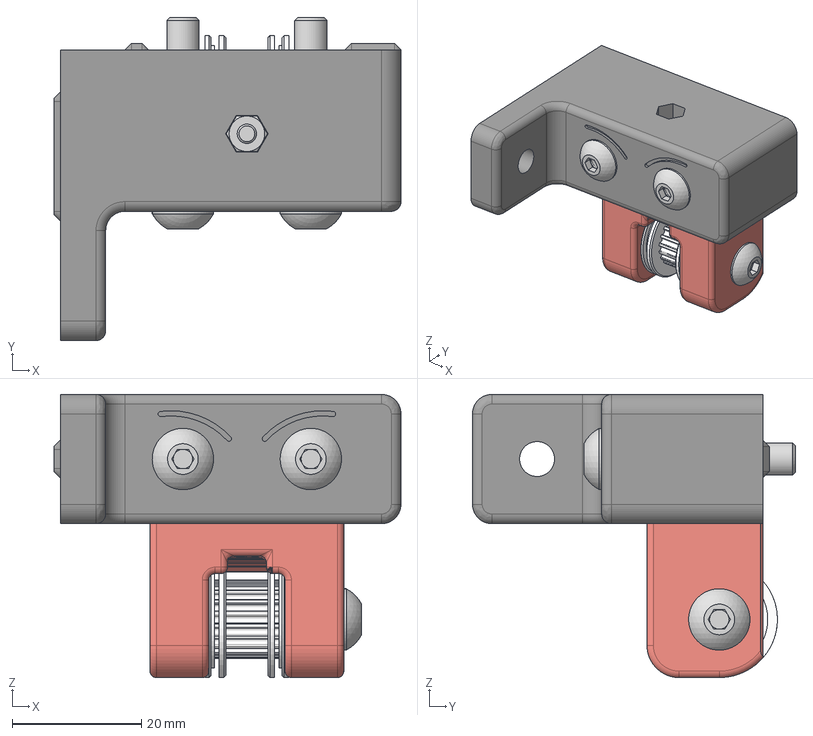
[picture p96: CAD file, 2025-09-15]
STL/Ось Z/Натяжители под Monolith/CAD/Monolith_Z Idler A.step
53.7 x 50.0 x 43.8 mm
GT2 20T Idler 9mm (3)
GT2 20T Idler Gates 9mm
M5x30 BHCS (20)
GT2 20T Idler (2)
M5x30 BHCS (10)
M5x30 BHCS (11)
M3 Hex Nut (2)
M3x16 SHCS (15)
