deflord/3def/STL/Ось Z/Натяжители под Monolith/STL/Monolith_Z Idler B.stl

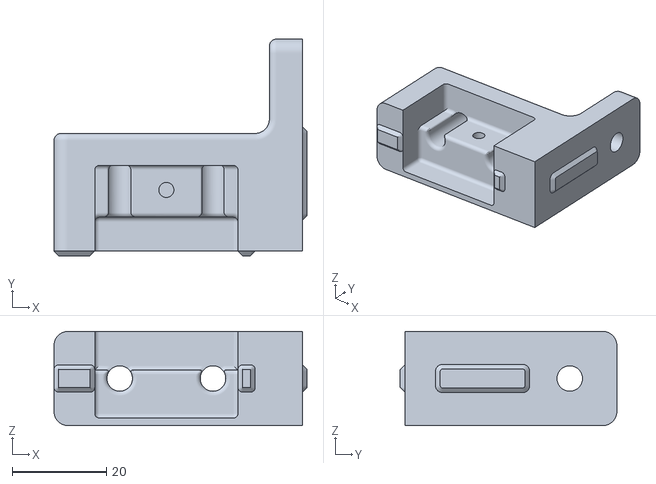
[picture p97: CAD file, 2025-09-15]
STL/Ось Z/Натяжители под Monolith/STL/Monolith_Z Idler B.stl
53.7 x 46.0 x 20.0
