deflord/3def/STL/Ось Z/Натяжители с усиленным натягом/Натяжители ремня редуктора Z увеличенный натяг.stl

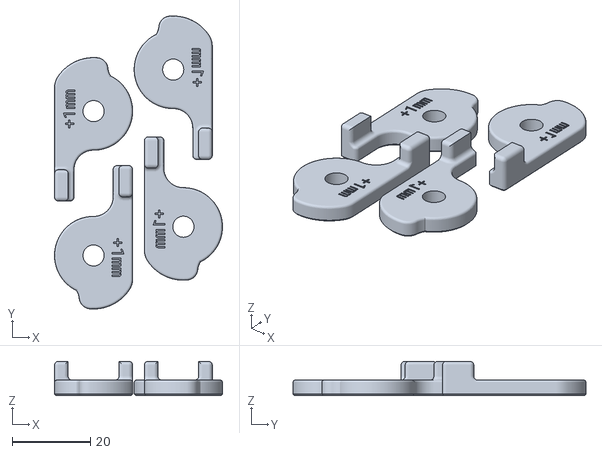
[picture p98: CAD file, 2024-10-15]
STL/Ось Z/Натяжители с усиленным натягом/Натяжители ремня редуктора Z увеличенный натяг.stl
43.0 x 75.0 x 8.80
