deflord/3def/STL/Отсек аппаратуры/Держатели блоков питания/lrs_200_psu_bracket_x2.stl

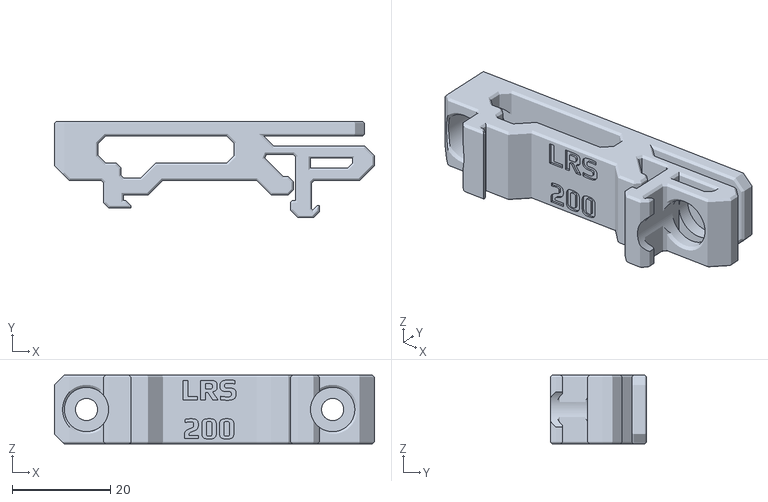
[picture p99: CAD file, 2025-06-16]
STL/Отсек аппаратуры/Держатели блоков питания/lrs_200_psu_bracket_x2.stl
65.0 x 19.6 x 14.0
