deflord/3def/STL/Отсек аппаратуры/Держатели плат/Fly X10 Pro/CAD/din_clips_remix_1d_55 мм v1.step

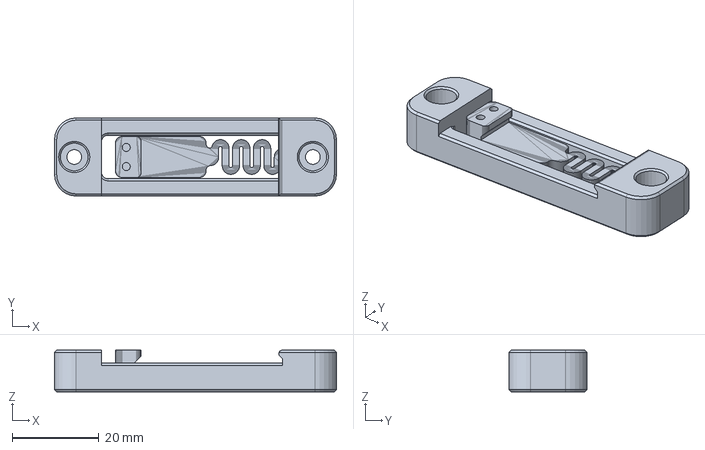
[picture p100: CAD file, 2026-03-02]
STL/Отсек аппаратуры/Держатели плат/Fly X10 Pro/CAD/din_clips_remix_1d_55 мм v1.step
65.0 x 18.0 x 9.60 mm
