deflord/3def/STL/Отсек аппаратуры/Держатели плат/Держатель DC DC  LM2596/buck_halter.stl

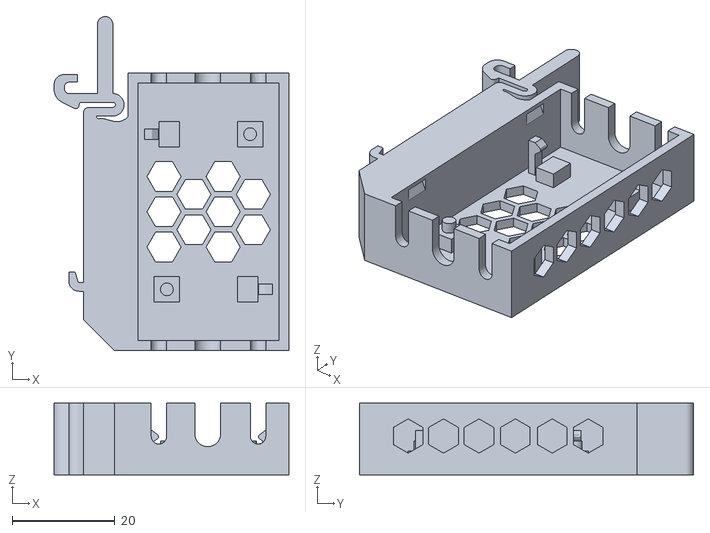
[picture p101: CAD file, 2025-11-08]
STL/Отсек аппаратуры/Держатели плат/Держатель DC DC LM2596/buck_halter.stl
45.7 x 65.0 x 14.0
