deflord/3def/STL/Отсек аппаратуры/Держатели плат/Держатель MKS 8.stl

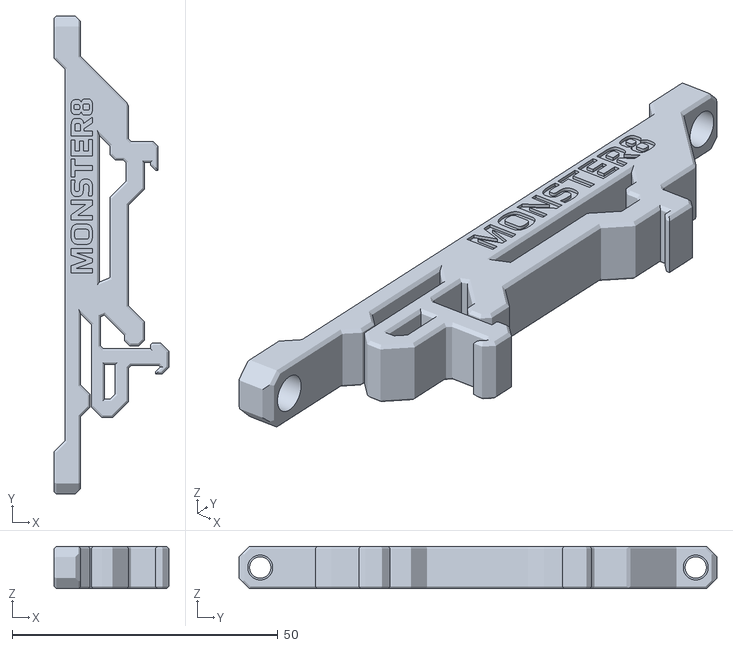
[picture p102: CAD file, 2024-12-08]
STL/Отсек аппаратуры/Держатели плат/Держатель MKS 8.stl
21.6 x 90.0 x 8.00
