deflord/3def/STL/Отсек аппаратуры/Держатели разъёмов/Держтаель разъёма MicroSD/Circle_sd_mount.stl

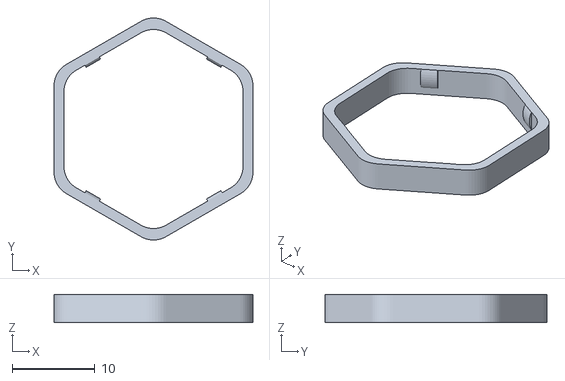
[picture p103: CAD file, 2025-07-21]
STL/Отсек аппаратуры/Держатели разъёмов/Держтаель разъёма MicroSD/Circle_sd_mount.stl
24.0 x 26.8 x 3.40
