deflord/3def/STL/Отсек аппаратуры/Держатель WAGO/Держатель WAGO на DIN/CAD/DIN_Rail_Bracket_Heat_Insert_Version.step

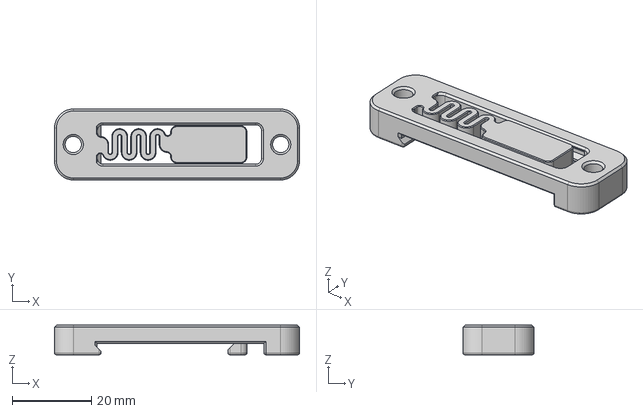
[picture p104: CAD file, 2025-07-24]
STL/Отсек аппаратуры/Держатель WAGO/Держатель WAGO на DIN/CAD/DIN_Rail_Bracket_Heat_Insert_Version.step
62.0 x 18.0 x 7.50 mm
