deflord/3def/STL/Отсек аппаратуры/Держатель WAGO/Держатель WAGO на DIN/STL/52.5 мм кронштейн v2.step

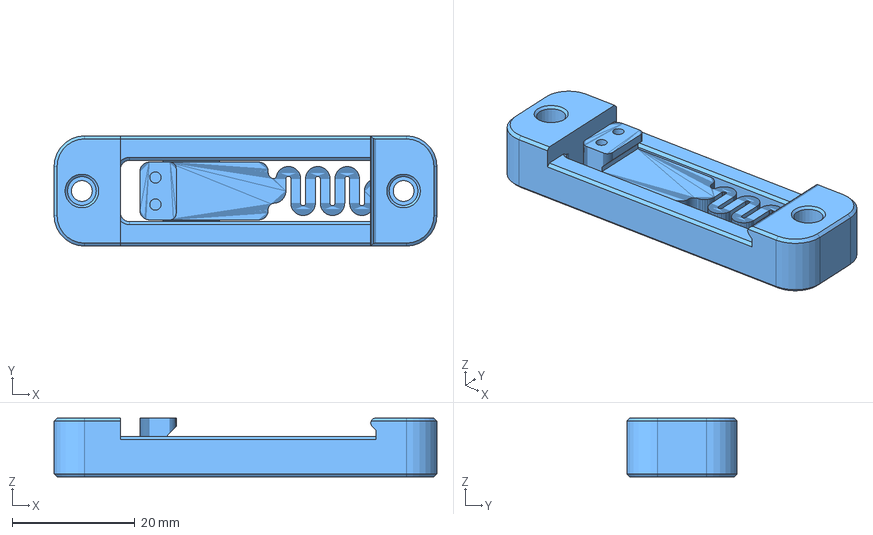
[picture p105: CAD file, 2025-12-15]
STL/Отсек аппаратуры/Держатель WAGO/Держатель WAGO на DIN/STL/52.5 мм кронштейн v2.step
62.5 x 18.0 x 9.60 mm
