deflord/3def/STL/Отсек аппаратуры/Держатель WAGO/Держатель WAGO на профиль 2020/wago_221-415_mount_3by5.stl

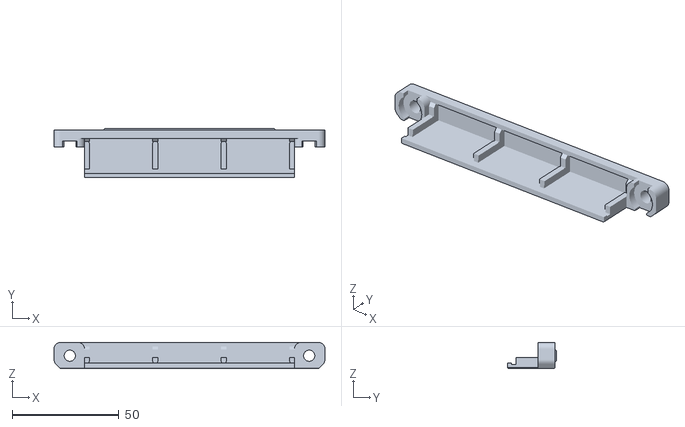
[picture p106: CAD file, 2025-03-16]
STL/Отсек аппаратуры/Держатель WAGO/Держатель WAGO на профиль 2020/wago_221-415_mount_3by5.stl
126.8 x 23.0 x 12.2
