deflord/3def/STL/Отсек аппаратуры/Держатель проводов/VORON  Cable Clip 2020 profile.STL

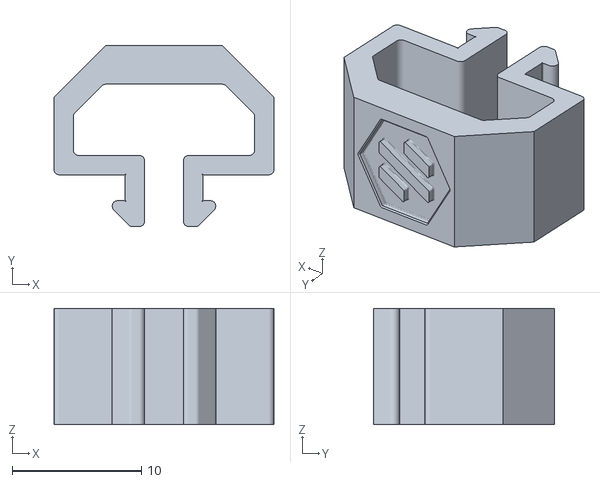
[picture p107: CAD file, 2025-12-06]
STL/Отсек аппаратуры/Держатель проводов/VORON Cable Clip 2020 profile.STL
17.0 x 14.0 x 9.00
