deflord/3def/STL/Отсек аппаратуры/Держатель реле/Держатель реле.STL

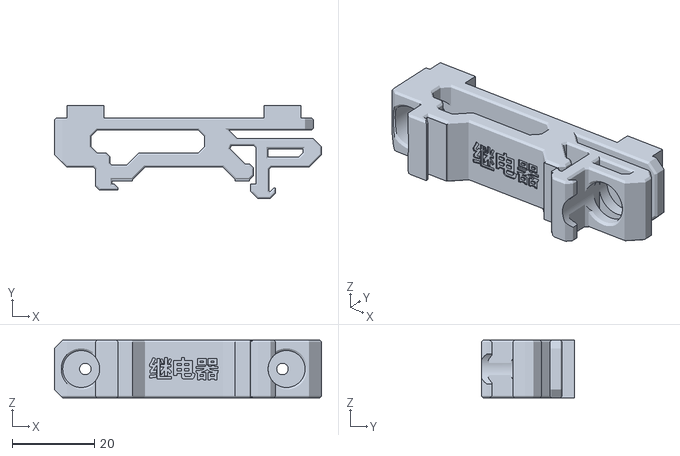
[picture p108: CAD file, 2024-12-09]
STL/Отсек аппаратуры/Держатель реле/Держатель реле.STL
65.0 x 22.6 x 14.0
