deflord/3def/STL/Печатающие головы/StealthBurner/Clockwork2/Держатель CAN с креплением стального прутка.stl

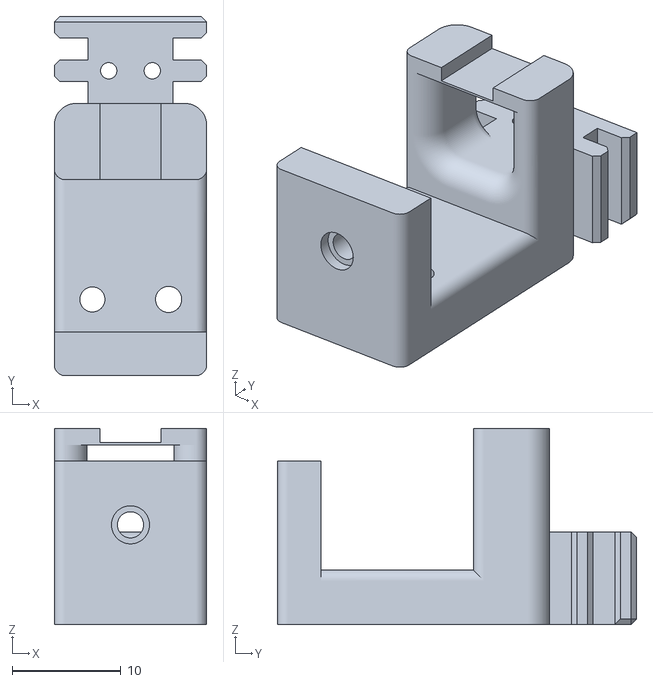
[picture p109: CAD file, 2025-05-06]
STL/Печатающие головы/StealthBurner/Clockwork2/Держатель CAN с креплением стального прутка.stl
14.0 x 33.0 x 18.0
