deflord/3def/STL/Печатающие головы/StealthBurner/ERCF:BoxTurtle/ClockWork2/Motor_Plate.step

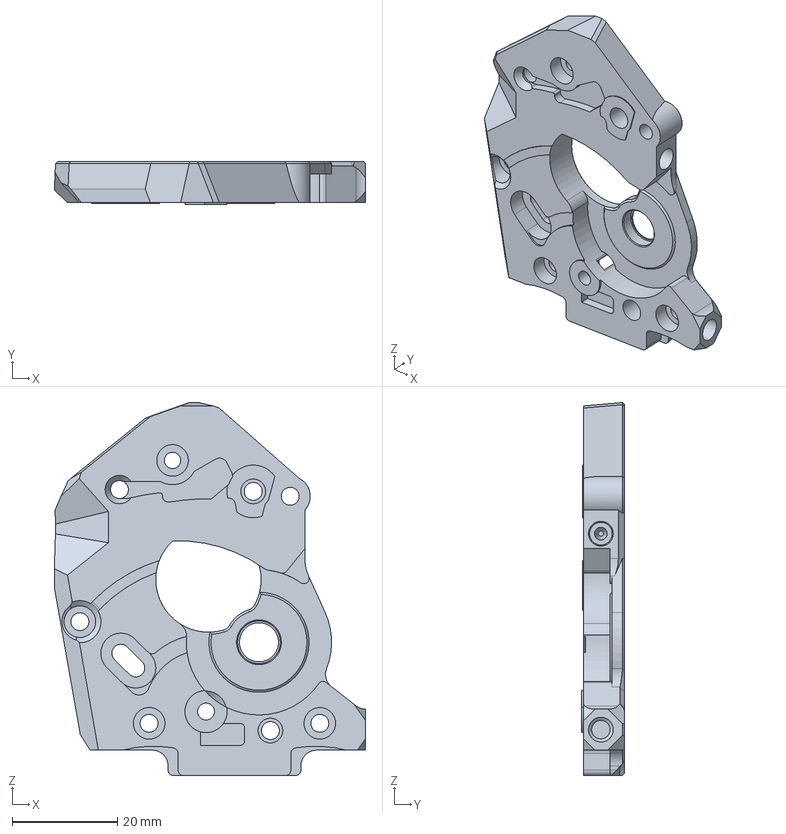
[picture p110: CAD file, 2025-03-05]
STL/Печатающие головы/StealthBurner/ERCF:BoxTurtle/ClockWork2/Motor_Plate.step
59.1 x 8.20 x 70.8 mm
