deflord/3def/STL/Печатающие головы/StealthBurner/Galileo 2/Передний корпус с 1 верхним датчиком.step

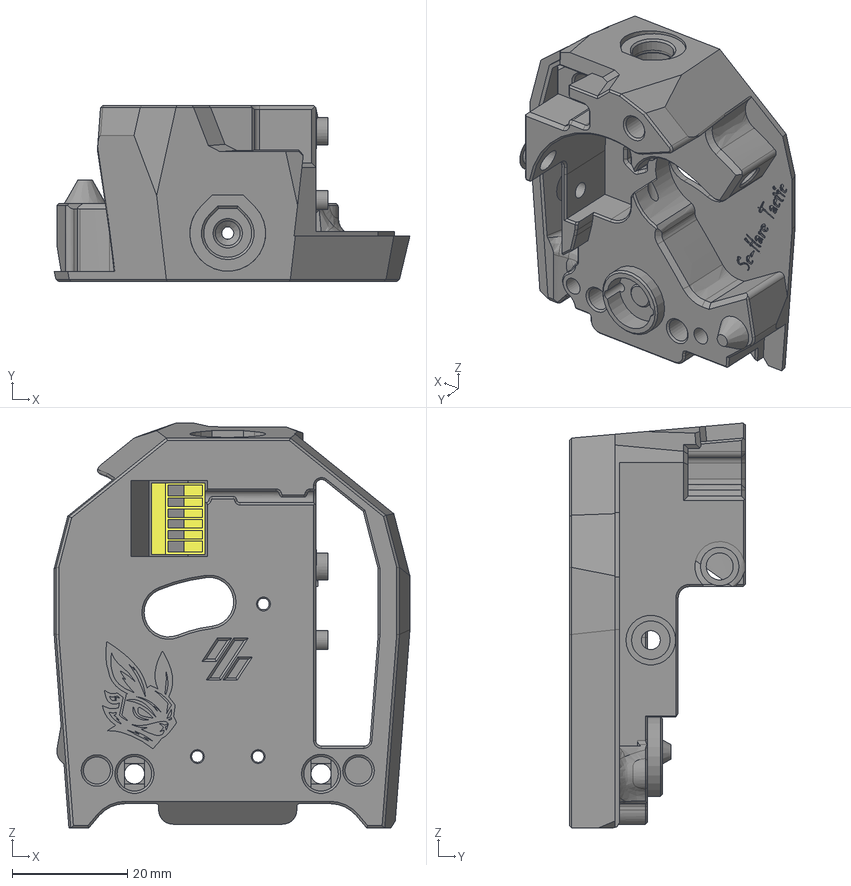
[picture p111: CAD file, 2025-06-23]
STL/Печатающие головы/StealthBurner/Galileo 2/Передний корпус с 1 верхним датчиком.step
61.8 x 30.6 x 70.3 mm
