deflord/3def/STL/Печатающие головы/StealthBurner/Держатели головы на каретку/Ремень 6 мм/Держатель левая часть.stl

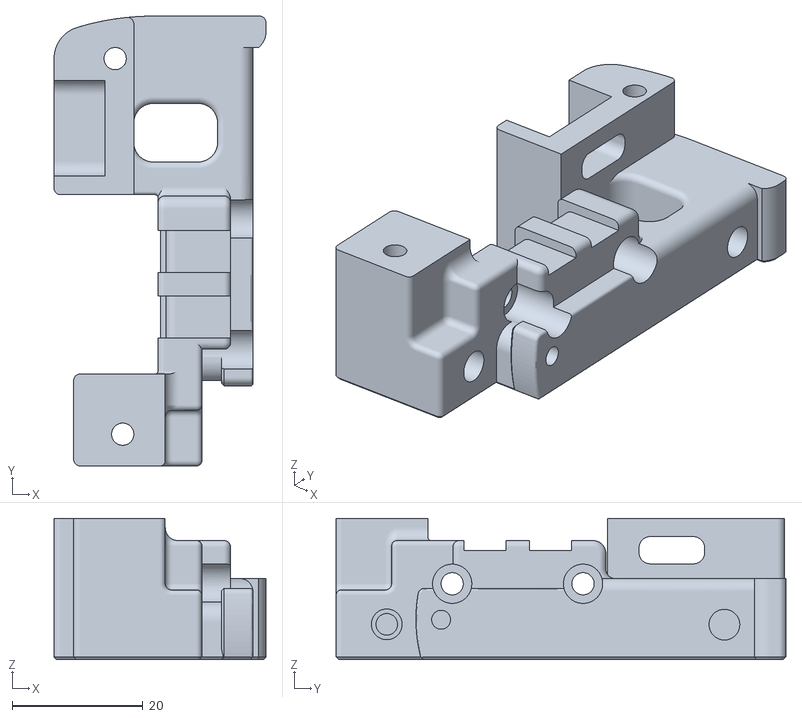
[picture p112: CAD file, 2024-08-05]
STL/Печатающие головы/StealthBurner/Держатели головы на каретку/Ремень 6 мм/Держатель левая часть.stl
32.4 x 68.8 x 21.6
