deflord/3def/STL/Печатающие головы/StealthBurner/Держатели головы на каретку/Ремень 9 мм/Держатель правая часть.stl

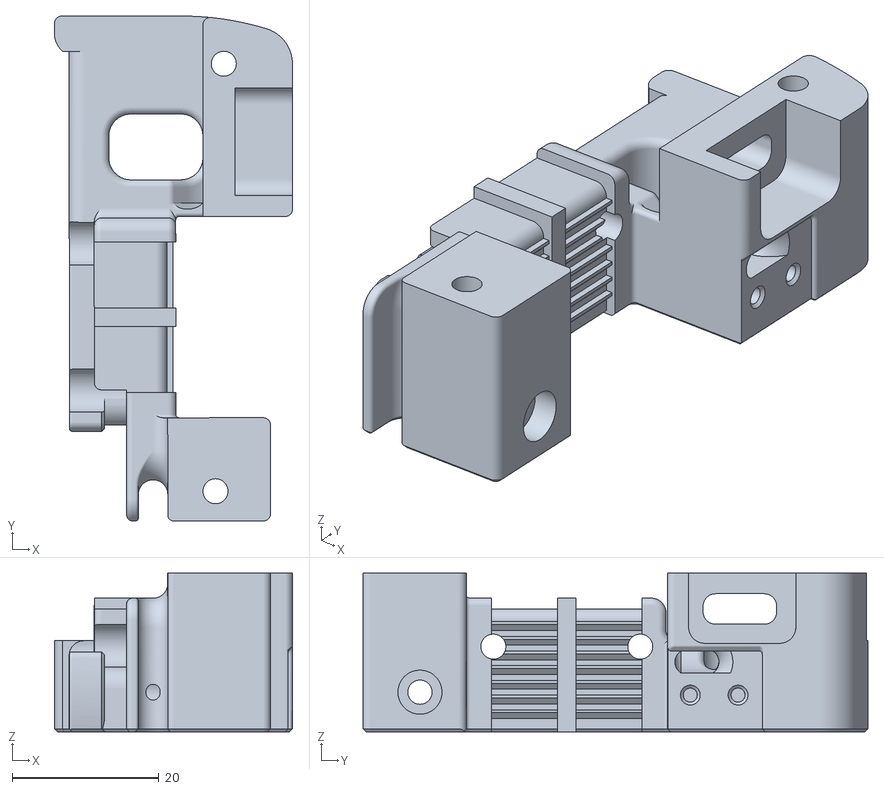
[picture p113: CAD file, 2024-08-05]
STL/Печатающие головы/StealthBurner/Держатели головы на каретку/Ремень 9 мм/Держатель правая часть.stl
32.4 x 68.8 x 21.6
