deflord/3def/STL/Печатающие головы/StealthBurner/Держатель хотэнда/Bambulab Hotend/Держатель хотэнда Bambu. Задняя сторона.STL

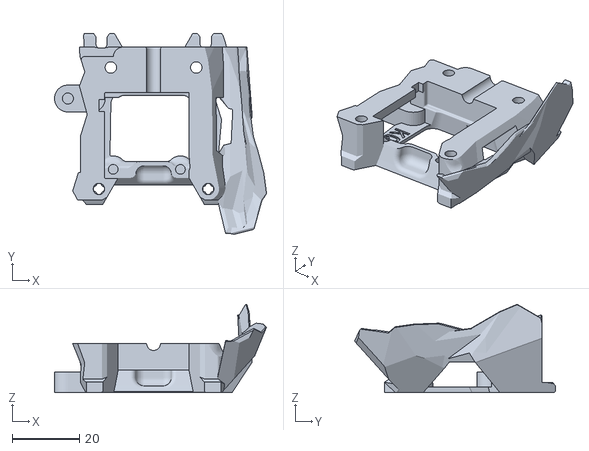
[picture p114: CAD file, 2024-08-04]
STL/Печатающие головы/StealthBurner/Держатель хотэнда/Bambulab Hotend/Держатель хотэнда Bambu. Задняя сторона.STL
63.0 x 59.7 x 26.3
