deflord/3def/STL/Печатающие головы/StealthBurner/Держатель хотэнда/CHC Pro Hotend/STL/SBCrazyDragon_TH_Rear_CW2.stl

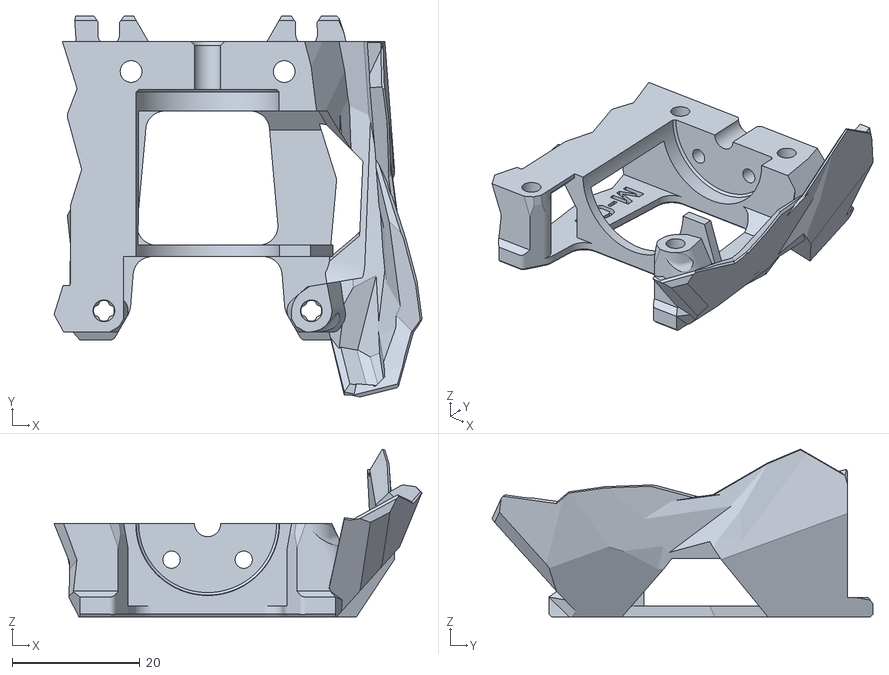
[picture p115: CAD file, 2024-08-05]
STL/Печатающие головы/StealthBurner/Держатель хотэнда/CHC Pro Hotend/STL/SBCrazyDragon_TH_Rear_CW2.stl
57.7 x 59.7 x 26.3
