deflord/3def/STL/Печатающие головы/StealthBurner/Держатель хотэнда/Dragon UHF Hotend/STL/UHF/SB_Dragon_UHF_TH_Rear.stl

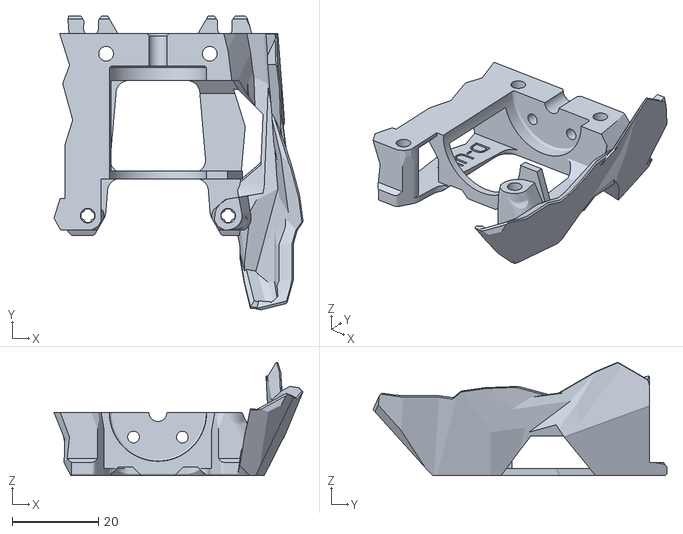
[picture p116: CAD file, 2024-08-05]
STL/Печатающие головы/StealthBurner/Держатель хотэнда/Dragon UHF Hotend/STL/UHF/SB_Dragon_UHF_TH_Rear.stl
57.7 x 68.0 x 26.3
