deflord/3def/STL/Печатающие головы/StealthBurner/Держатель хотэнда/Dragon UHF Hotend/STL/UHF_mini/SB_Dragon_UHF_mini_TH_Rear.stl

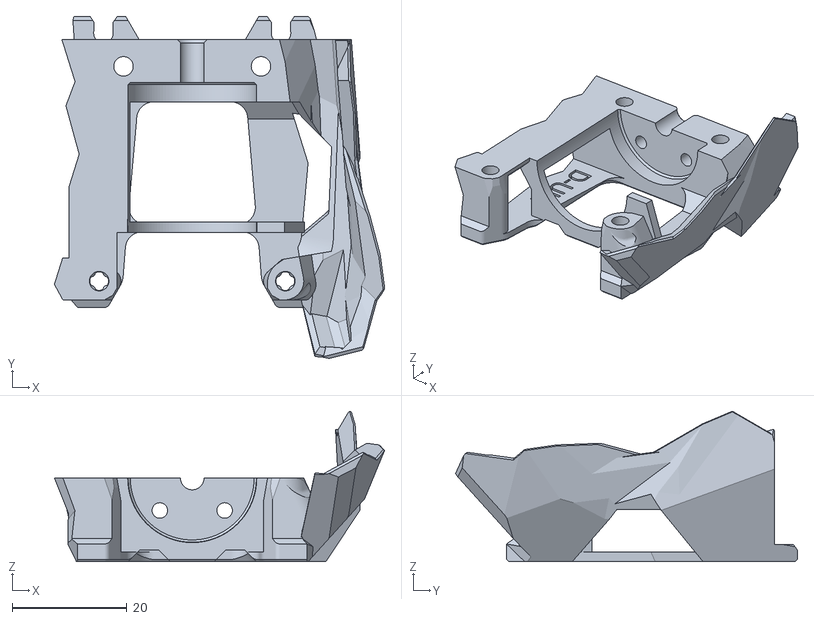
[picture p117: CAD file, 2024-08-05]
STL/Печатающие головы/StealthBurner/Держатель хотэнда/Dragon UHF Hotend/STL/UHF_mini/SB_Dragon_UHF_mini_TH_Rear.stl
57.7 x 59.7 x 26.3
