deflord/3def/STL/Печатающие головы/StealthBurner/Держатель хотэнда/Dragon UHF Hotend/Держатель Cartographer/Держатель Cartographer для стандартного джойна.step

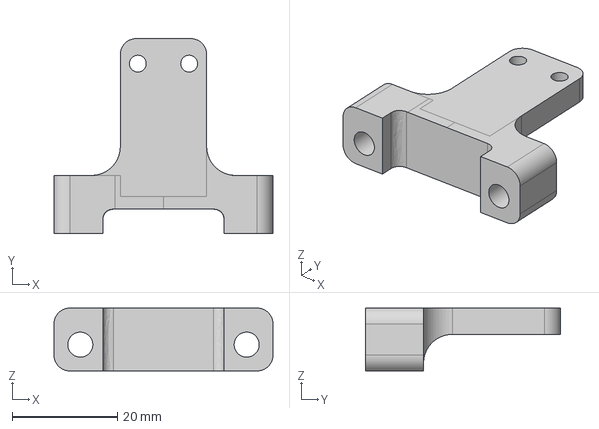
[picture p118: CAD file, 2025-03-24]
STL/Печатающие головы/StealthBurner/Держатель хотэнда/Dragon UHF Hotend/Держатель Cartographer/Держатель Cartographer для стандартного джойна.step
41.6 x 37.0 x 12.0 mm
