deflord/3def/STL/Печатающие головы/StealthBurner/Передняя крышка/[o]_stealthburner_LED_carrier.stl

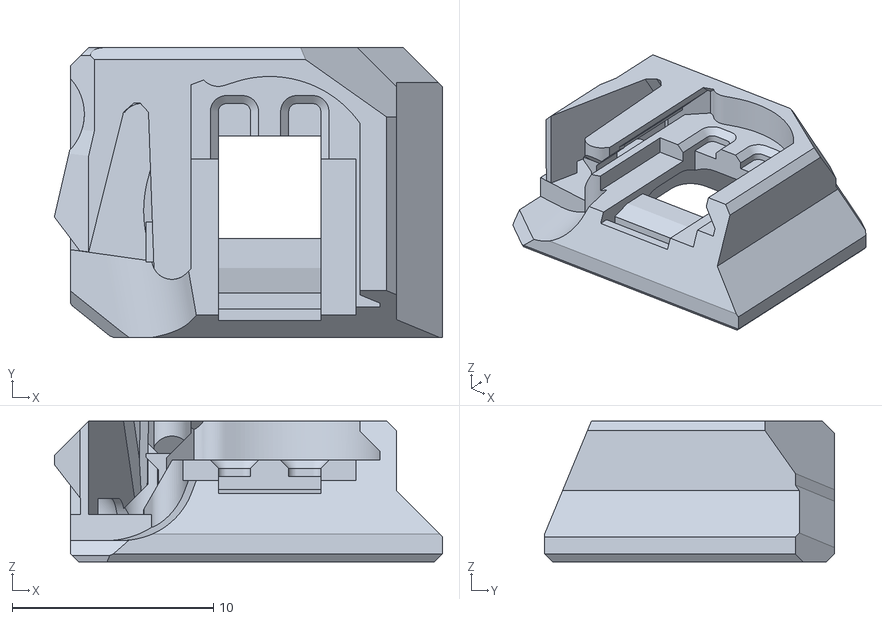
[picture p119: CAD file, 2024-08-04]
STL/Печатающие головы/StealthBurner/Передняя крышка/[o]_stealthburner_LED_carrier.stl
19.3 x 14.4 x 7.01
