deflord/3def/STL/Печатающие головы/StealthBurner/Пробы/Cartographer Probe/500 CNC/Держатель Cartographer длинный для UHF.step

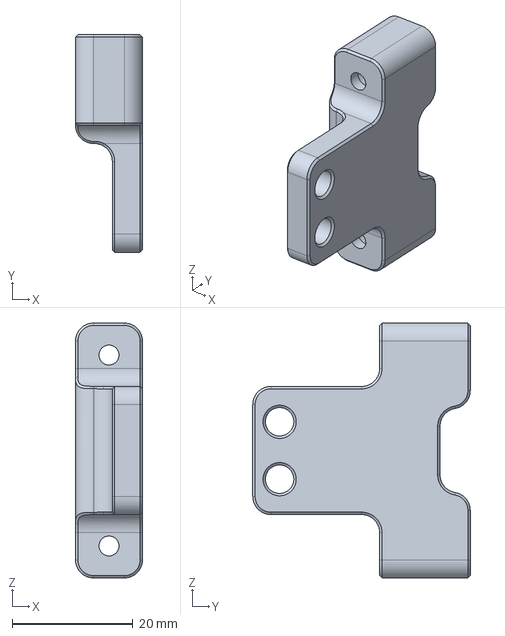
[picture p120: CAD file, 2025-03-11]
STL/Печатающие головы/StealthBurner/Пробы/Cartographer Probe/500 CNC/Держатель Cartographer длинный для UHF.step
11.1 x 36.0 x 42.2 mm
