deflord/3def/STL/Печатающие головы/StealthBurner/Пробы/Euclid Probe/VoronGantryMountRev_4_Set.stl

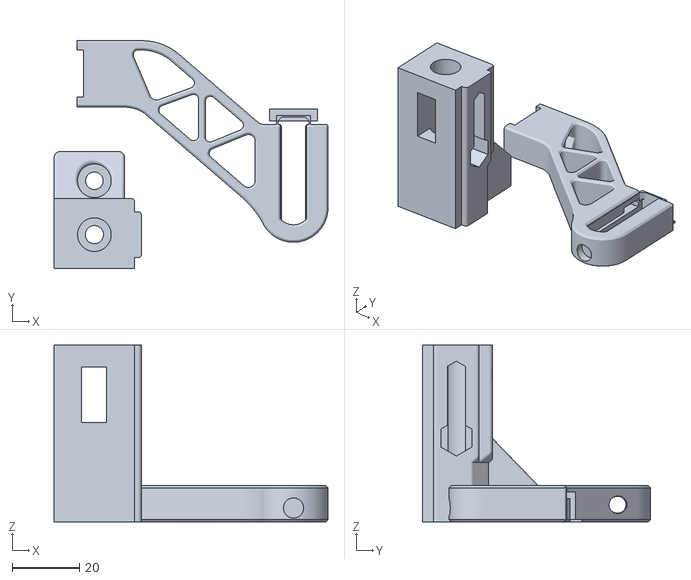
[picture p121: CAD file, 2024-08-05]
STL/Печатающие головы/StealthBurner/Пробы/Euclid Probe/VoronGantryMountRev_4_Set.stl
81.4 x 67.6 x 52.4
