deflord/3def/STL/Печатающие головы/StealthBurner/Пробы/IDM/Mellow Fly IDM адаптер.STL

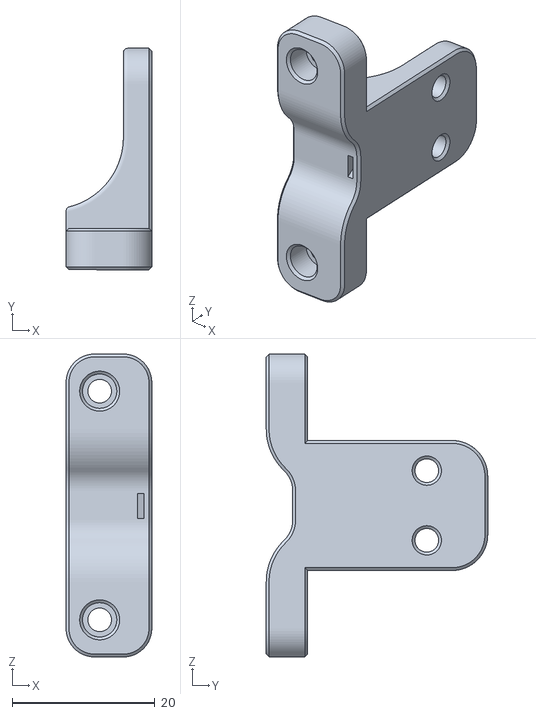
[picture p122: CAD file, 2024-08-05]
STL/Печатающие головы/StealthBurner/Пробы/IDM/Mellow Fly IDM адаптер.STL
12.0 x 31.0 x 42.4
