deflord/3def/STL/Печатающие головы/StealthBurner/Пробы/Klicki-00/ Klicky-00-Front-Body-D2F-Countersunk - SB-1.stl

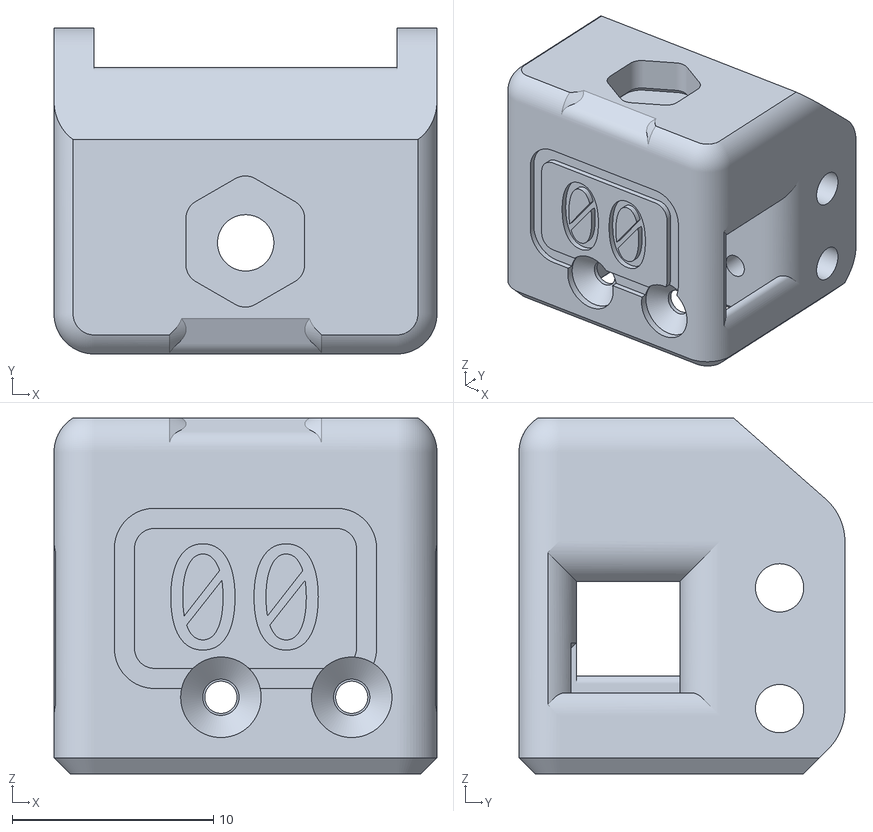
[picture p123: CAD file, 2024-08-05]
STL/Печатающие головы/StealthBurner/Пробы/Klicki-00/ Klicky-00-Front-Body-D2F-Countersunk - SB-1.stl
19.0 x 16.2 x 17.7
