deflord/3def/STL/Печатающие головы/StealthBurner/С обрезкой пластика/Рычаг резака.STL

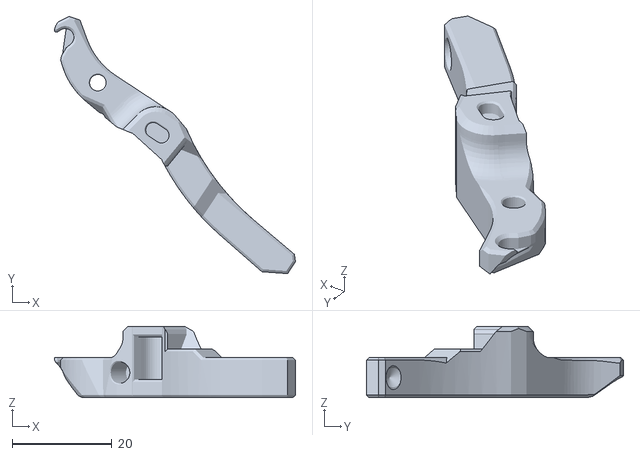
[picture p124: CAD file, 2025-02-03]
STL/Печатающие головы/StealthBurner/С обрезкой пластика/Рычаг резака.STL
48.3 x 51.5 x 14.2
