deflord/3def/STL/Печатающие головы/XOL/Heatcore Orbiter MiniAB/CAD/Держатель MiniAB.step

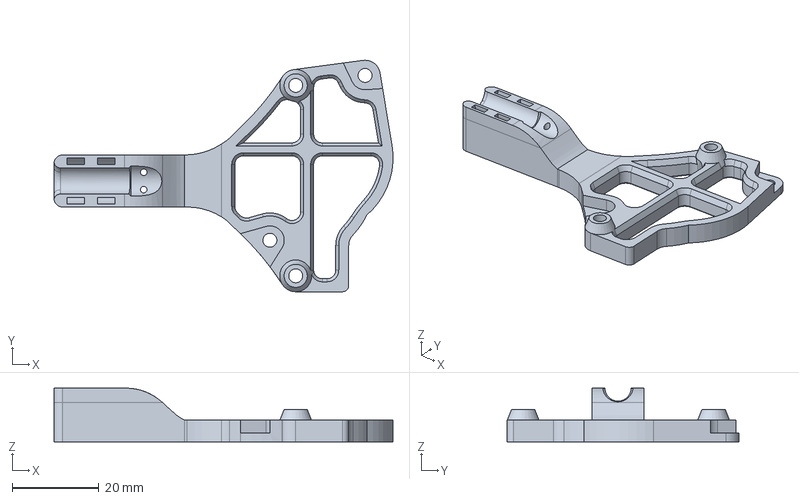
[picture p125: CAD file, 2025-12-07]
STL/Печатающие головы/XOL/Heatcore Orbiter MiniAB/CAD/Держатель MiniAB.step
78.0 x 53.3 x 12.4 mm
