deflord/3def/STL/Печатающие головы/XOL/Rapido 2 HF/Держатель Cartographer короткий v1.step

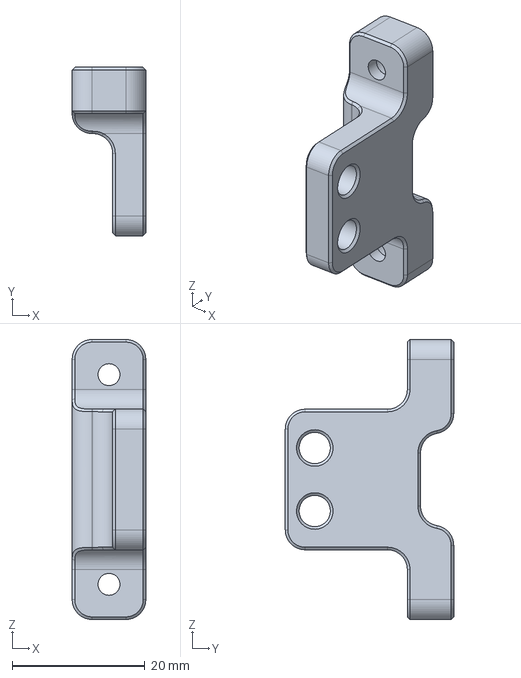
[picture p126: CAD file, 2025-12-24]
STL/Печатающие головы/XOL/Rapido 2 HF/Держатель Cartographer короткий v1.step
11.1 x 25.4 x 42.2 mm
