deflord/3def/STL/Печатающие головы/XOL/Rapido 2 UHF Orbiter 2/CAD/Адаптер XolMetrix orbiter без нижнего датчика v2.step

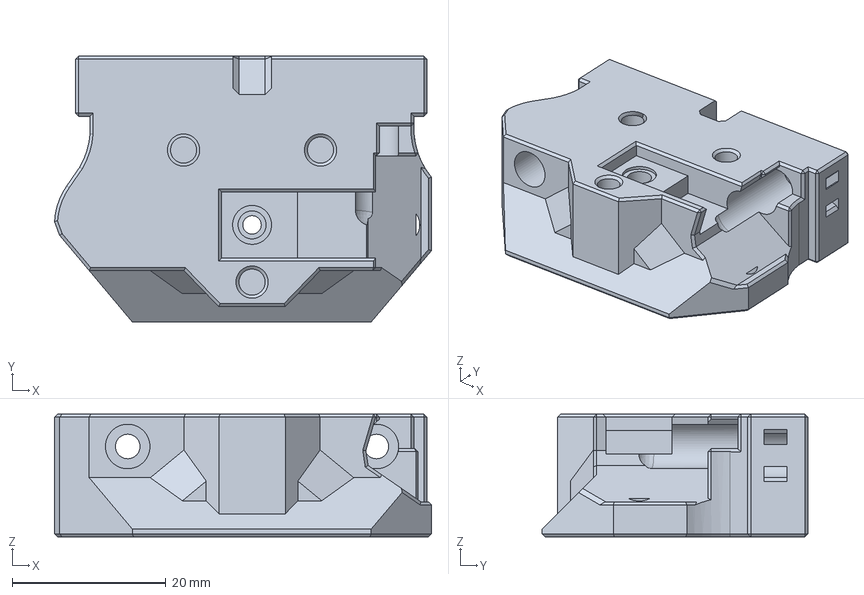
[picture p127: CAD file, 2025-09-11]
STL/Печатающие головы/XOL/Rapido 2 UHF Orbiter 2/CAD/Адаптер XolMetrix orbiter без нижнего датчика v2.step
49.1 x 34.6 x 16.0 mm
