deflord/3def/STL/Печатающие головы/XOL/Rapido 2 UHF Orbiter 2/STL/Blade Tools/blade_install_tool.stl

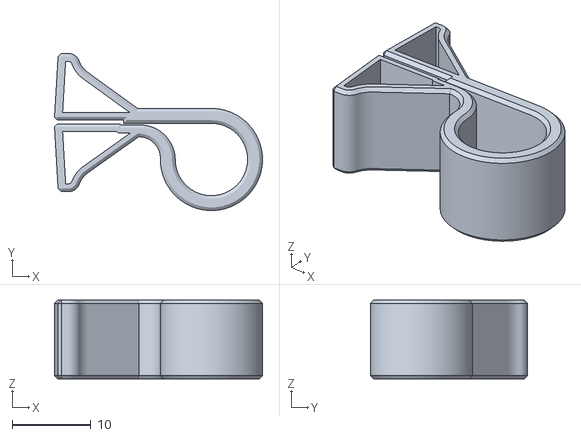
[picture p128: CAD file, 2025-07-24]
STL/Печатающие головы/XOL/Rapido 2 UHF Orbiter 2/STL/Blade Tools/blade_install_tool.stl
26.5 x 20.0 x 10.0
