deflord/3def/STL/Печатающие головы/XOL/Rapido 2 UHF Orbiter 2/STL/Xol_HE_Mount-Rapido_v2_UHF_XolPAP v1.stl

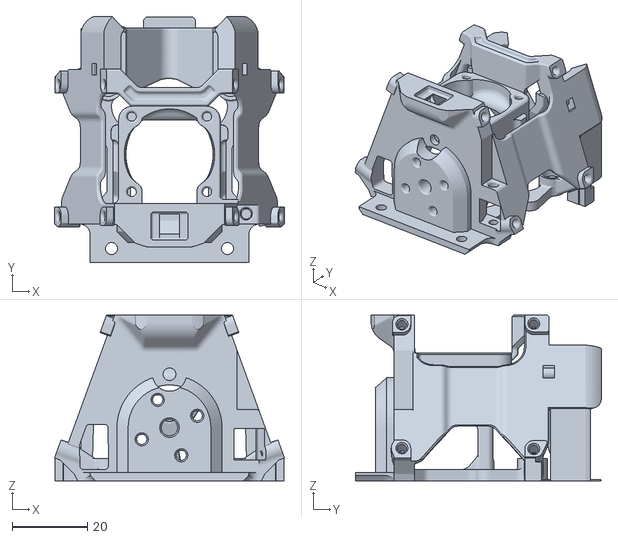
[picture p129: CAD file, 2025-10-03]
STL/Печатающие головы/XOL/Rapido 2 UHF Orbiter 2/STL/Xol_HE_Mount-Rapido_v2_UHF_XolPAP v1.stl
61.1 x 65.3 x 44.0
