deflord/3def/STL/Печатающие головы/Листоголов/CHC XL/Маунт 2510.step

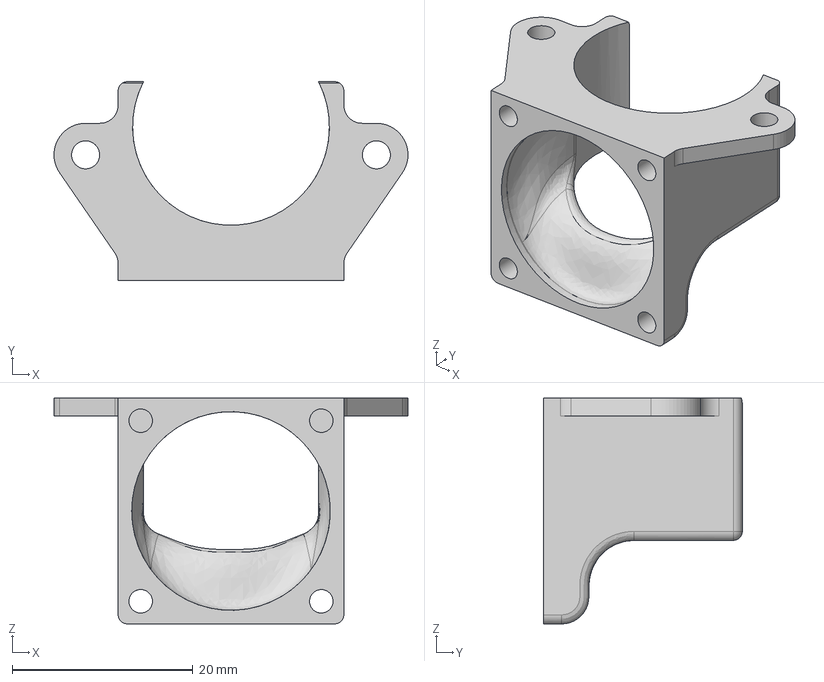
[picture p130: CAD file, 2026-06-26]
STL/Печатающие головы/Листоголов/CHC XL/Маунт 2510.step
39.2 x 22.0 x 25.0 mm
