deflord/3def/STL/Печатающие головы/Листоголов/RapidoUHF/Duct_Spacer_RapidoUHF.step

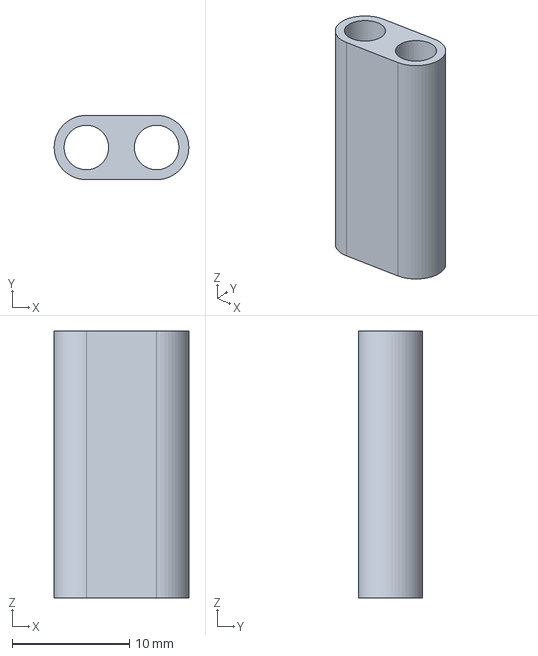
[picture p131: CAD file, 2026-04-01]
STL/Печатающие головы/Листоголов/RapidoUHF/Duct_Spacer_RapidoUHF.step
11.5 x 5.50 x 22.8 mm
