deflord/3def/STL/Печатающие головы/Листоголов/Удлинитель для классического портала Voron.step

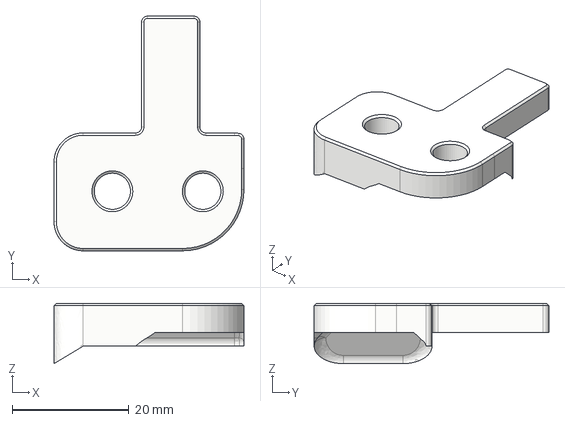
[picture p132: CAD file, 2026-02-21]
STL/Печатающие головы/Листоголов/Удлинитель для классического портала Voron.step
32.6 x 40.2 x 10.3 mm
