deflord/3def/STL/Портал/CNC Мод/right (1).stl

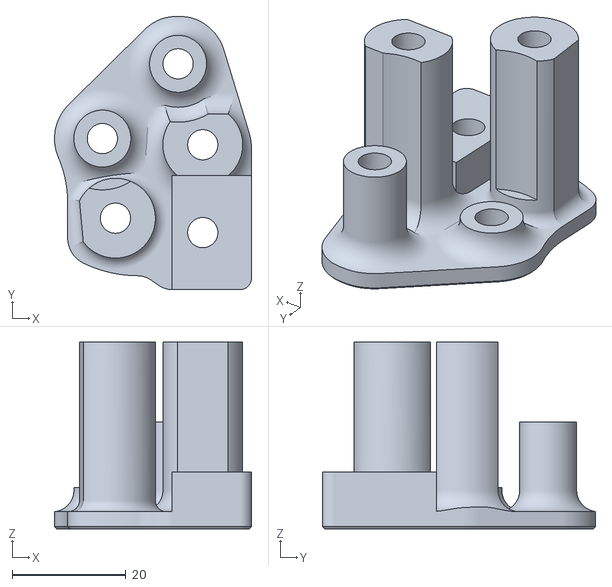
[picture p133: CAD file, 2025-07-25]
STL/Портал/CNC Мод/right (1).stl
34.6 x 47.9 x 32.8
