deflord/3def/STL/Портал/Monolith/Без выступов 9 мм ремни 4 мотора/STL/Задние держатели моторов/Натяжители/Printed_9mm_tensioner_a_x2.stl

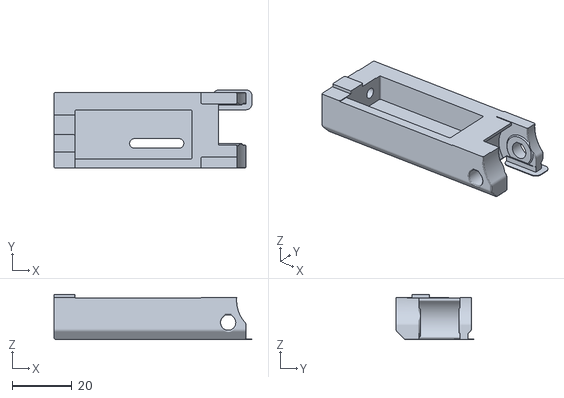
[picture p134: CAD file, 2025-08-07]
STL/Портал/Monolith/Без выступов 9 мм ремни 4 мотора/STL/Задние держатели моторов/Натяжители/Printed_9mm_tensioner_a_x2.stl
66.5 x 26.3 x 15.2
