deflord/3def/STL/Портал/Monolith/Ввод проводов в гибкий кабель канал/Ввод с CAN и PG7/CAD/Держатель CAN на портале v1.step

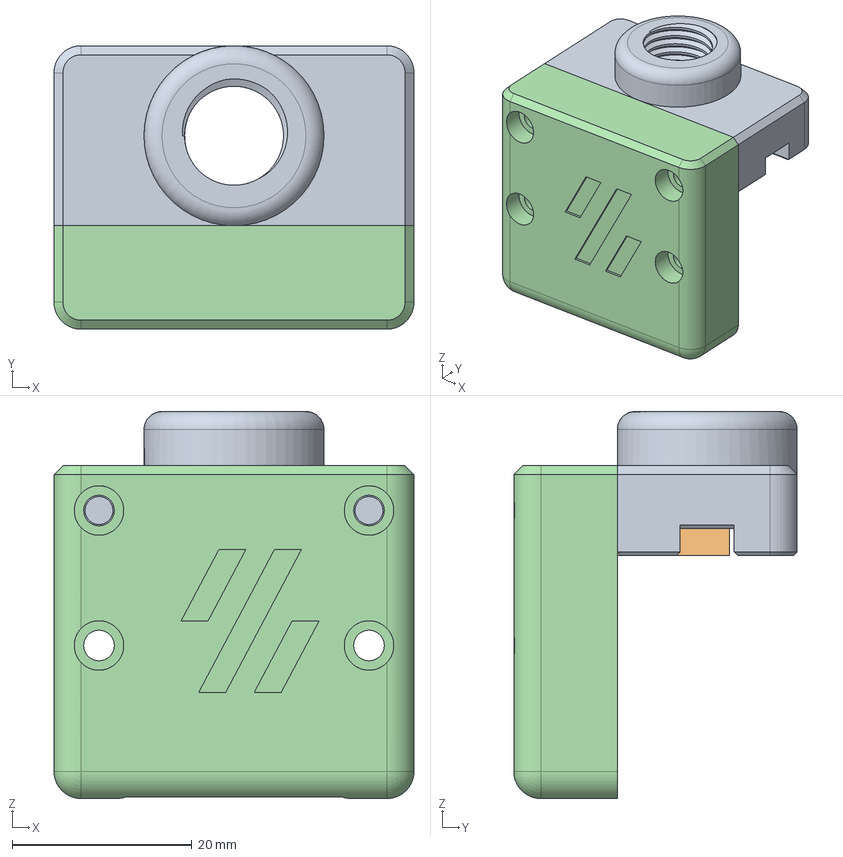
[picture p135: CAD file, 2025-08-07]
STL/Портал/Monolith/Ввод проводов в гибкий кабель канал/Ввод с CAN и PG7/CAD/Держатель CAN на портале v1.step
40.0 x 31.5 x 43.0 mm
Copy of 辫子支架A^辫子支架
Copy of 辫子支架B^辫子支架
