deflord/3def/STL/Портал/Monolith/Ввод проводов в гибкий кабель канал/Ввод с CAN и PG7/STL/Передняя крышка.stl

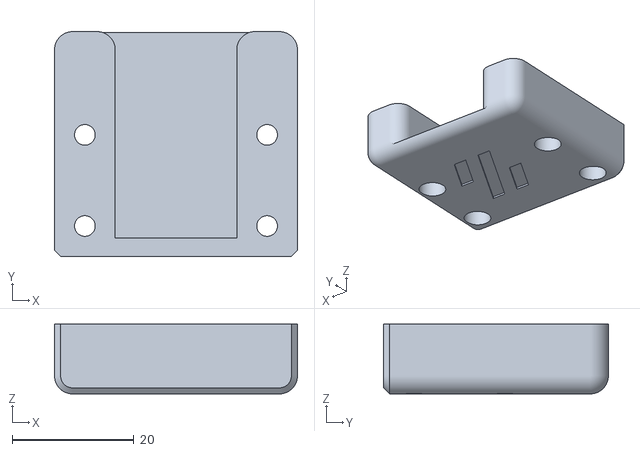
[picture p136: CAD file, 2025-08-07]
STL/Портал/Monolith/Ввод проводов в гибкий кабель канал/Ввод с CAN и PG7/STL/Передняя крышка.stl
40.0 x 37.0 x 11.5
