deflord/3def/STL/Портал/Monolith/Концевик по Y сбоку/Держатели оси X под 9 ремень с шайбами/Printed_9mm_AWD_XY_joint_right_a.step

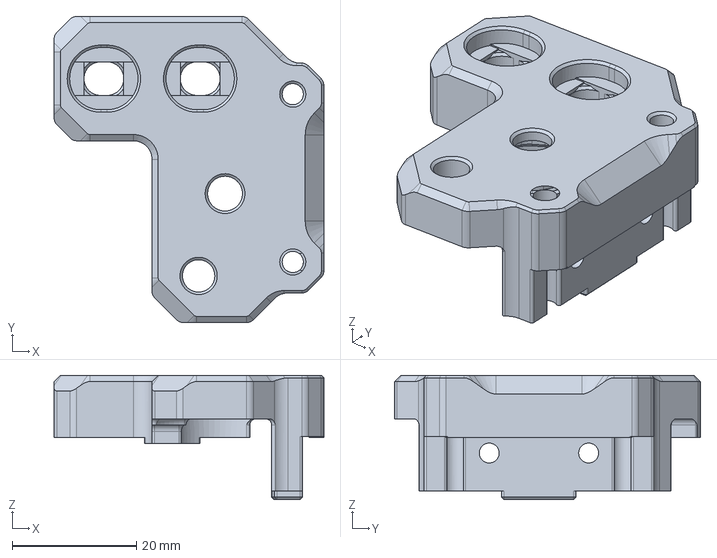
[picture p138: CAD file, 2026-06-26]
STL/Портал/Monolith/Концевик по Y сбоку/Держатели оси X под 9 ремень с шайбами/Printed_9mm_AWD_XY_joint_right_a.step
43.4 x 49.2 x 20.0 mm
