deflord/3def/STL/Портал/Monolith/Концевик по Y сбоку/Держатель концевика Y старый.STL

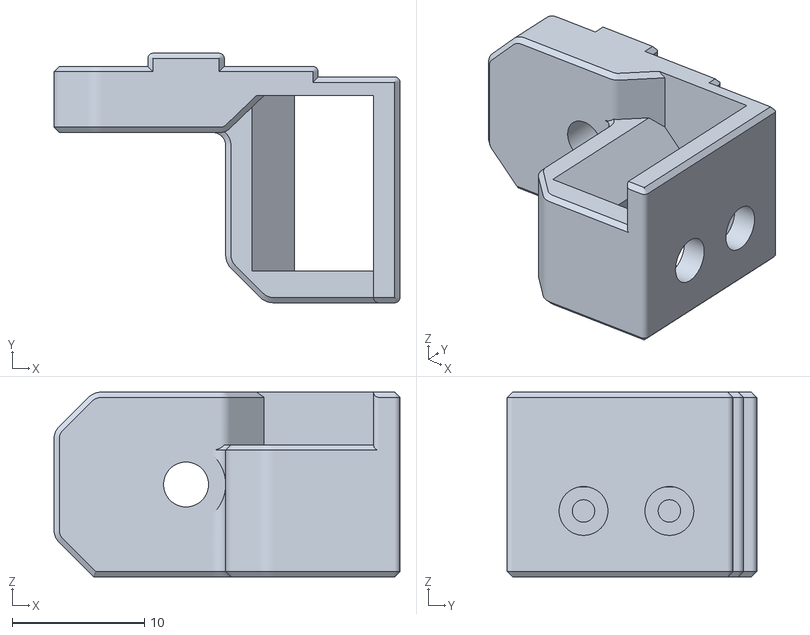
[picture p139: CAD file, 2026-07-10]
STL/Портал/Monolith/Концевик по Y сбоку/Держатель концевика Y старый.STL
26.2 x 18.9 x 14.0
