deflord/3def/STL/Портал/Monolith/Концевик по Y сбоку/Концевик справа снизу/Printed_9mm_AWD_XY_joint_left_b.step

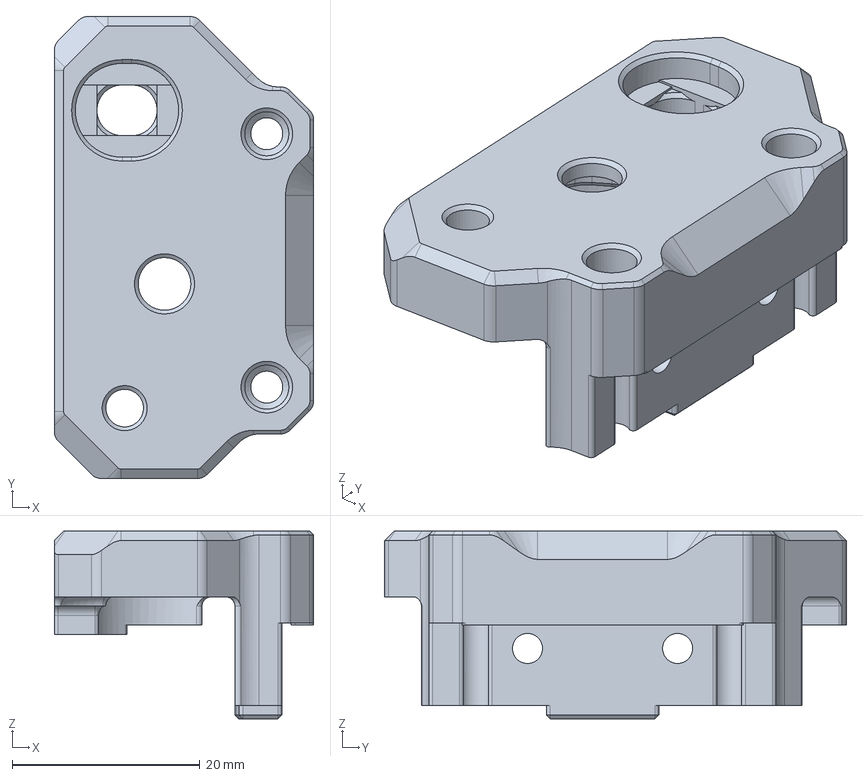
[picture p140: CAD file, 2026-06-26]
STL/Портал/Monolith/Концевик по Y сбоку/Концевик справа снизу/Printed_9mm_AWD_XY_joint_left_b.step
27.7 x 49.2 x 20.0 mm
