deflord/3def/STL/Портал/Держатели моторов A и B/500/Левый нижний.stl

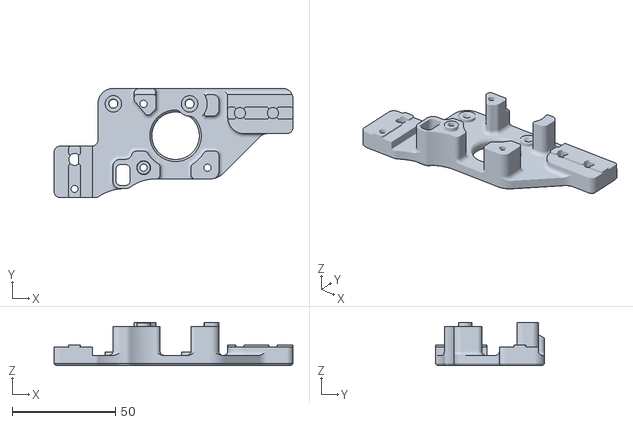
[picture p141: CAD file, 2024-08-05]
STL/Портал/Держатели моторов A и B/500/Левый нижний.stl
116.0 x 53.0 x 21.0
