deflord/3def/STL/Портал/Ось X из профиля 15х15/Верх правого держателя 15х15.stl

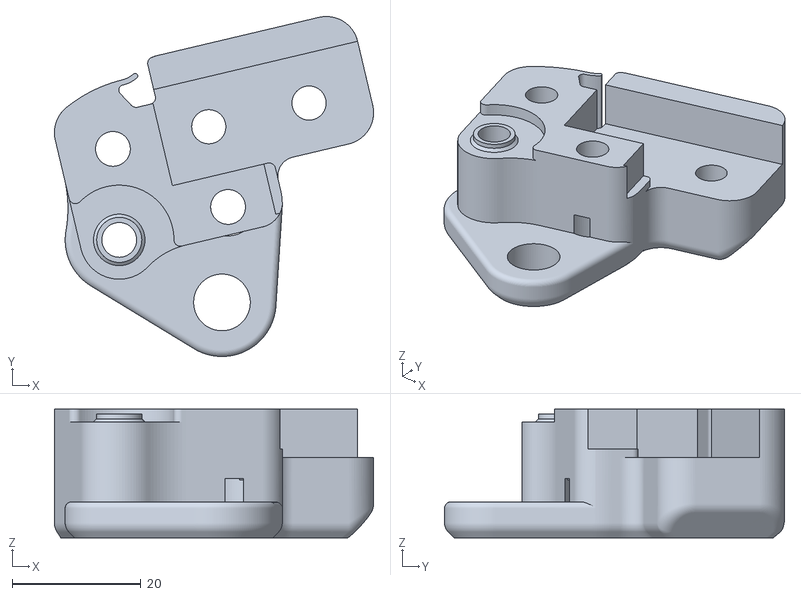
[picture p142: CAD file, 2024-08-04]
STL/Портал/Ось X из профиля 15х15/Верх правого держателя 15х15.stl
49.6 x 52.8 x 20.0
