deflord/3def/STL/Портал/Ось X из профиля 20х20  Ремень 9 мм/Верх правого держателя 20х20.stl

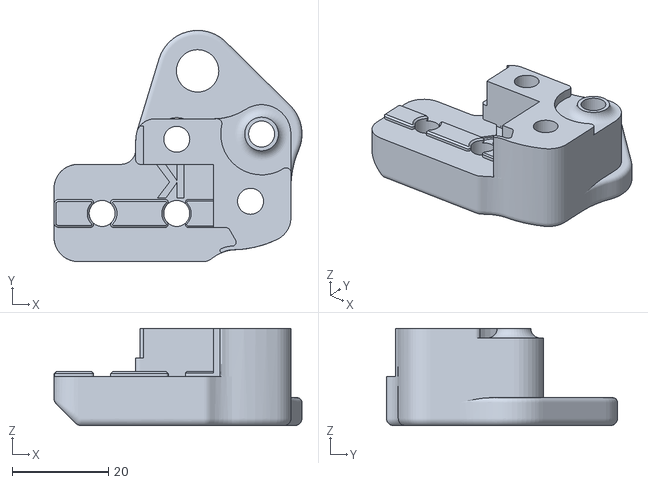
[picture p143: CAD file, 2024-08-04]
STL/Портал/Ось X из профиля 20х20 Ремень 9 мм/Верх правого держателя 20х20.stl
51.5 x 48.0 x 20.2
