deflord/3def/STL/Портал/Соединение портала и кареток/500/Нижняя часть шарнира (на каретку) B x2.stl

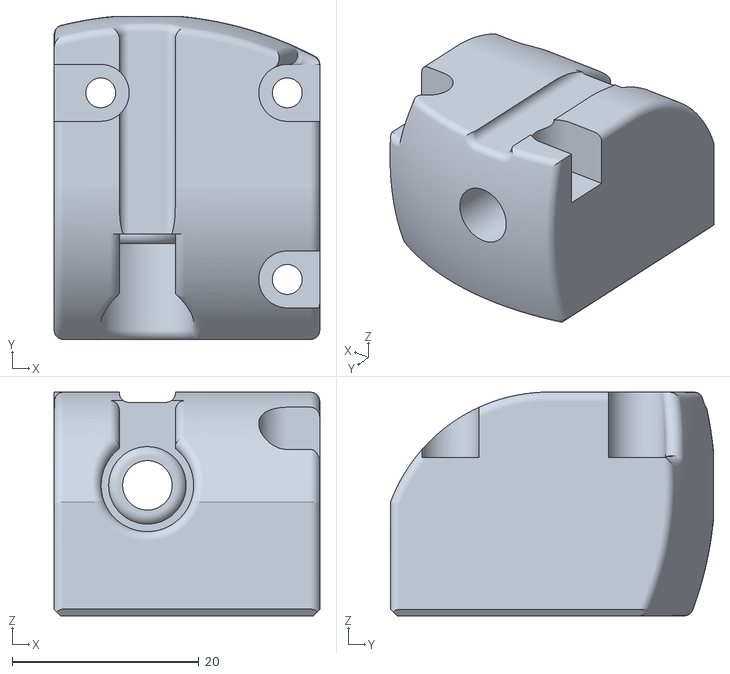
[picture p144: CAD file, 2024-08-05]
STL/Портал/Соединение портала и кареток/500/Нижняя часть шарнира (на каретку) B x2.stl
28.5 x 34.6 x 24.0
