deflord/3def/STL/Проводка/CAN мод/Y бампер.stl

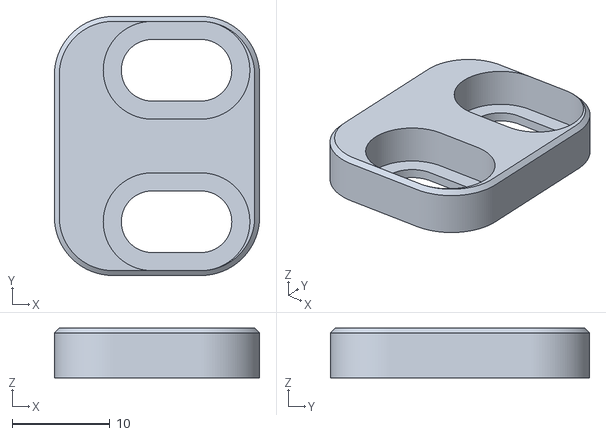
[picture p145: CAD file, 2024-08-05]
STL/Проводка/CAN мод/Y бампер.stl
21.0 x 26.5 x 5.10
