deflord/3def/STL/Проводка/Держатели светового профиля/Для профиля 2020/Угловой держатель профиля LED.step

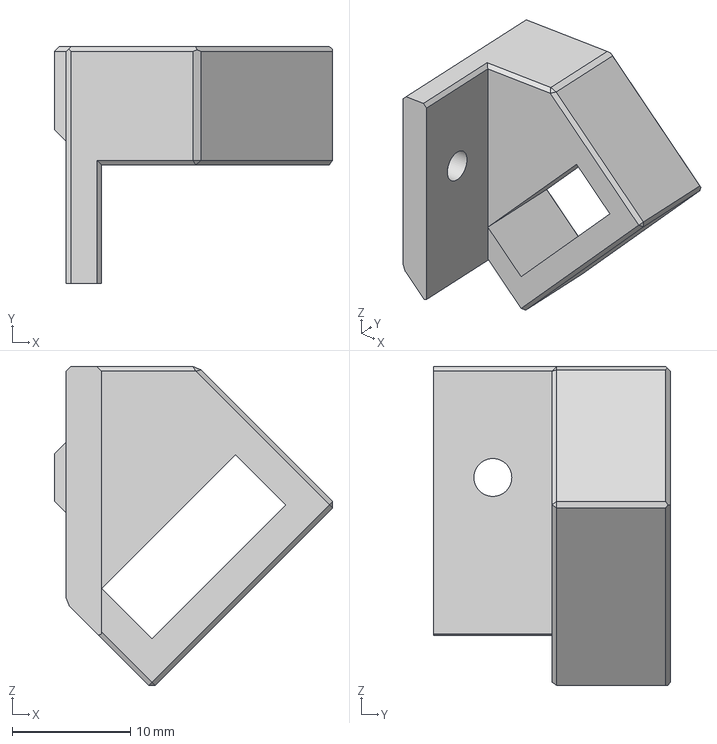
[picture p146: CAD file, 2025-06-23]
STL/Проводка/Держатели светового профиля/Для профиля 2020/Угловой держатель профиля LED.step
23.5 x 20.0 x 27.0 mm
