deflord/3def/STL/Проводка/Держатели светового профиля/Для профиля 3030/Держатель светового профиля 30х30.stl

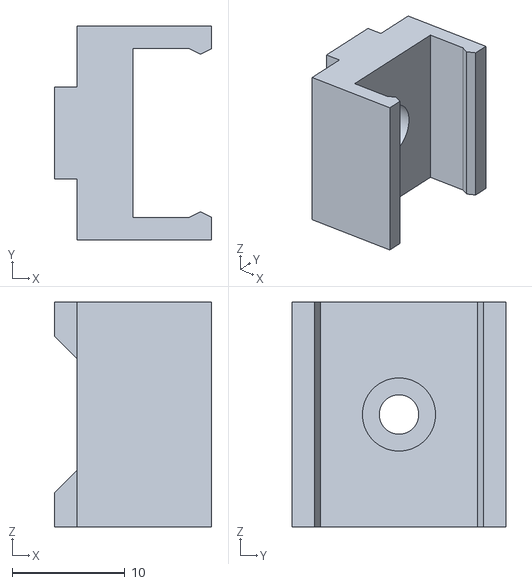
[picture p147: CAD file, 2024-08-30]
STL/Проводка/Держатели светового профиля/Для профиля 3030/Держатель светового профиля 30х30.stl
14.0 x 19.0 x 20.0
