deflord/3def/STL/Проводка/Держатель WAGO/52.5 мм кронштейн x2.step

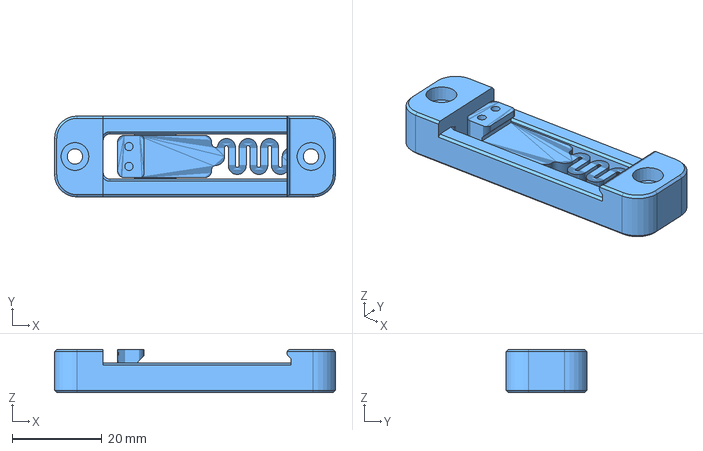
[picture p148: CAD file, 2025-12-15]
STL/Проводка/Держатель WAGO/52.5 мм кронштейн x2.step
62.5 x 18.0 x 9.60 mm
