deflord/3def/STL/Проводка/Держатель гибкого кабель канала по Z/Кабель канал 1015/CAD/Держатиль кабель канала нижний.step

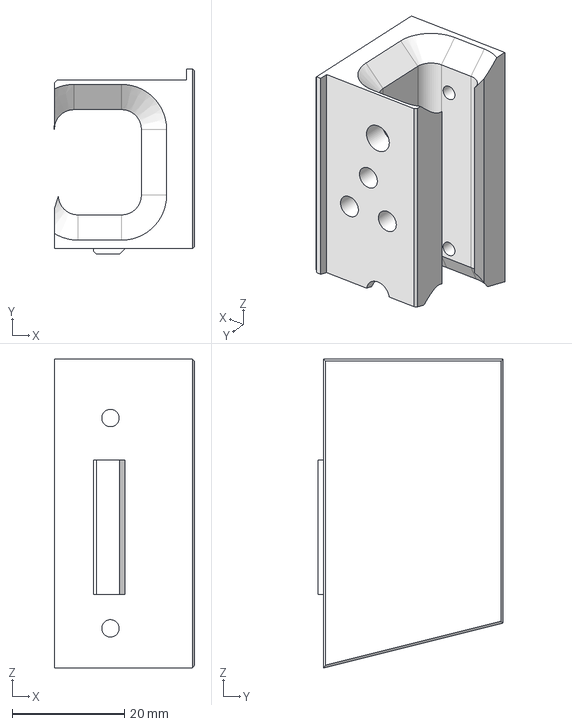
[picture p149: CAD file, 2025-08-07]
STL/Проводка/Держатель гибкого кабель канала по Z/Кабель канал 1015/CAD/Держатиль кабель канала нижний.step
25.0 x 33.0 x 55.0 mm
