deflord/3def/STL/Проводка/Заглушки проводов в профиле 2020/2020_Stealth_Profile_Cover.stl

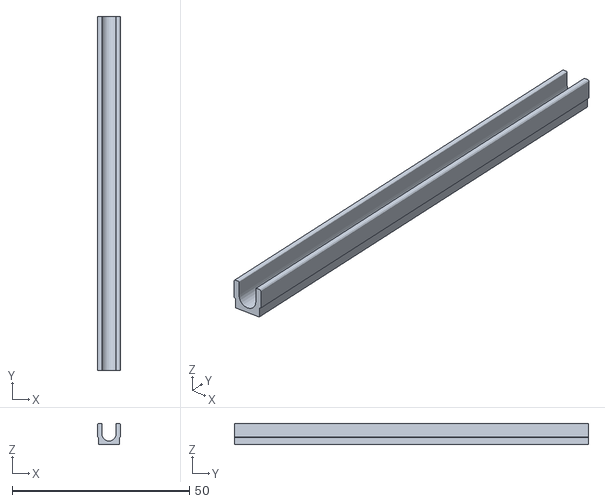
[picture p150: CAD file, 2024-08-05]
STL/Проводка/Заглушки проводов в профиле 2020/2020_Stealth_Profile_Cover.stl
6.40 x 100.0 x 5.99
