deflord/3def/STL/Проводка/Заглушки проводов в профиле 3030/3030 cover.stp

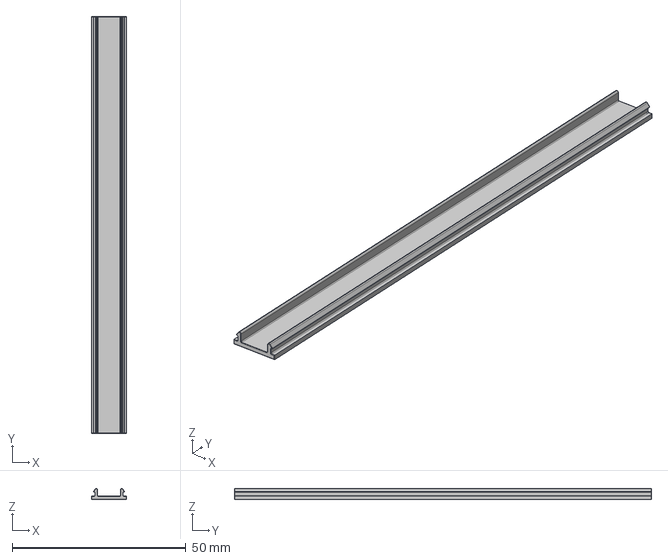
[picture p151: CAD file, 2025-02-13]
STL/Проводка/Заглушки проводов в профиле 3030/3030 cover.stp
10.1 x 120.0 x 3.20 mm
