deflord/3def/STL/Проводка/Проводка сверху портала/350/CAD/Камера 350 AWD верх.step

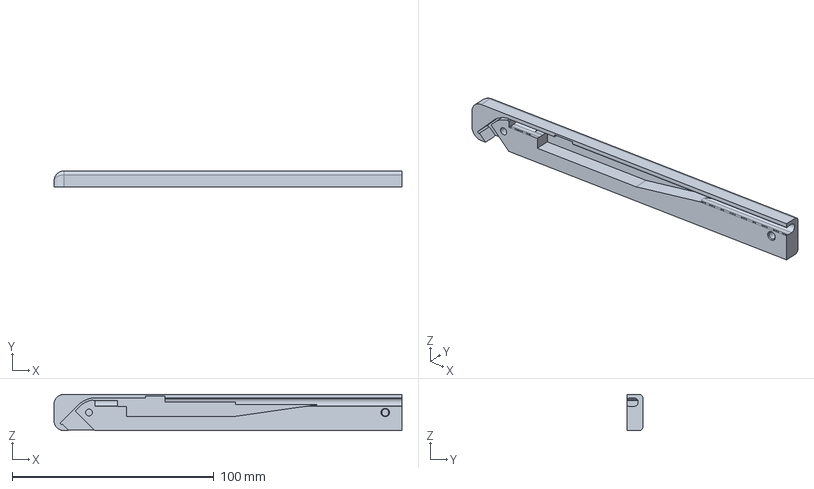
[picture p152: CAD file, 2025-02-08]
STL/Проводка/Проводка сверху портала/350/CAD/Камера 350 AWD верх.step
172.3 x 8.00 x 18.0 mm
