deflord/3def/STL/Проводка/Проводка сверху портала/350/STL/Cable Holder Y 350 верх под камеру v1.stl

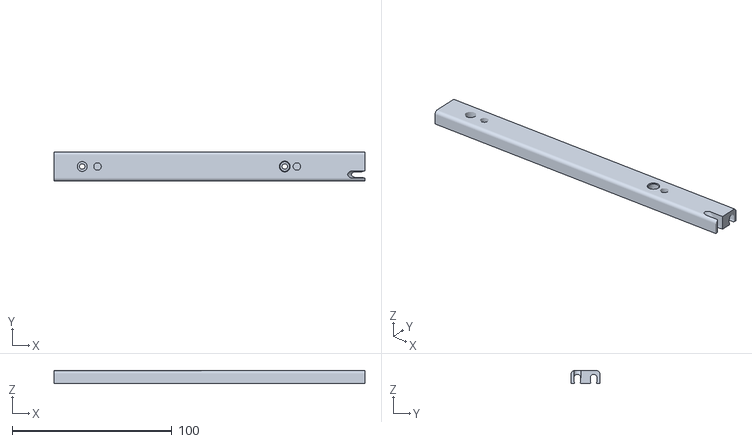
[picture p153: CAD file, 2025-02-08]
STL/Проводка/Проводка сверху портала/350/STL/Cable Holder Y 350 верх под камеру v1.stl
195.0 x 18.0 x 8.00
