deflord/3def/STL/Системы смены пластика/BoxTurtle/Ведро для отходов/400/CAD/Ведро.step

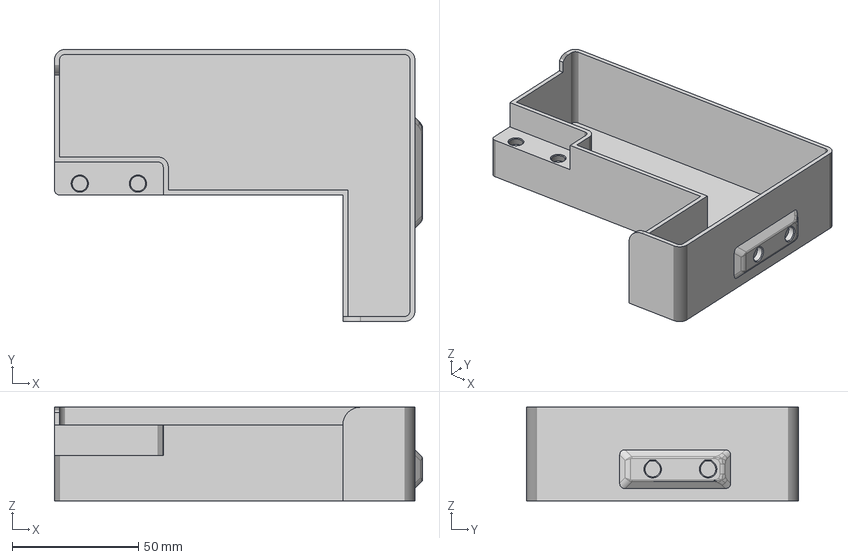
[picture p154: CAD file, 2025-07-16]
STL/Системы смены пластика/BoxTurtle/Ведро для отходов/400/CAD/Ведро.step
145.5 x 107.5 x 37.0 mm
