deflord/3def/STL/Системы смены пластика/BoxTurtle/Ведро для отходов/400/STL/Держатель щётки.stl

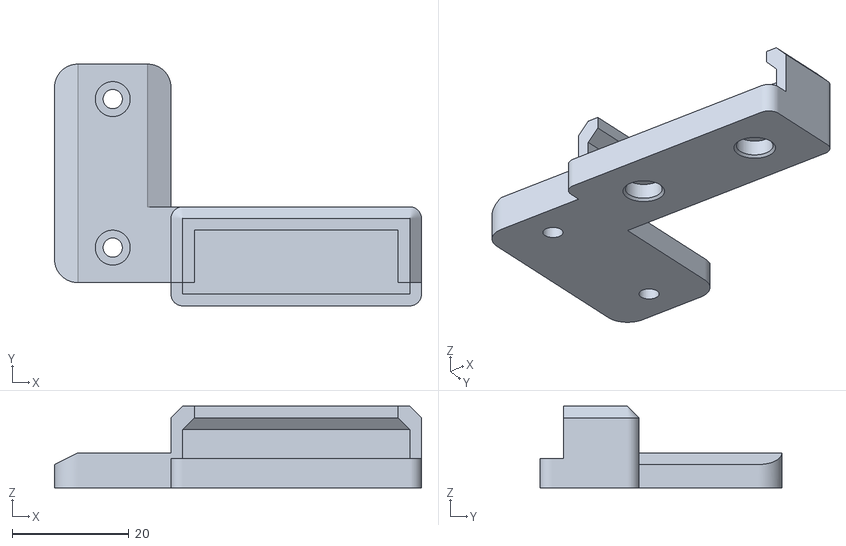
[picture p155: CAD file, 2025-07-16]
STL/Системы смены пластика/BoxTurtle/Ведро для отходов/400/STL/Держатель щётки.stl
63.0 x 41.5 x 14.0
