deflord/3def/STL/Системы смены пластика/BoxTurtle/Ведро для отходов/500/Ведро v1.step

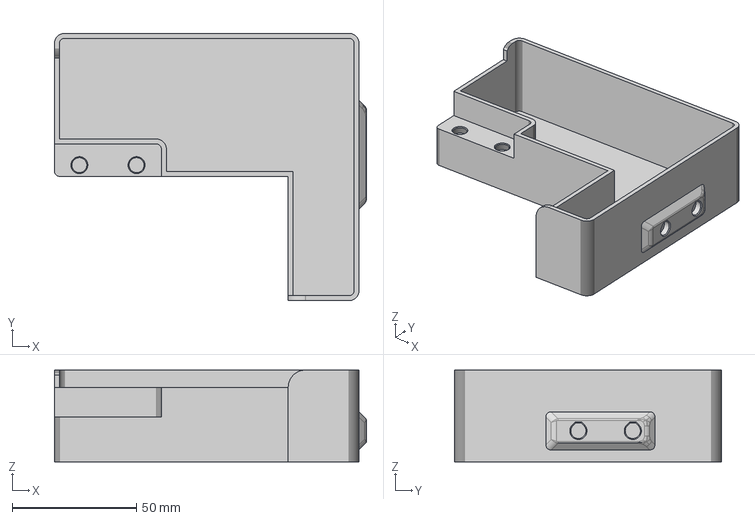
[picture p156: CAD file, 2025-10-13]
STL/Системы смены пластика/BoxTurtle/Ведро для отходов/500/Ведро v1.step
125.5 x 107.5 x 37.0 mm
