deflord/3def/STL/Системы смены пластика/BoxTurtle/Новая плата/маунт платы черепахи v.3.stp

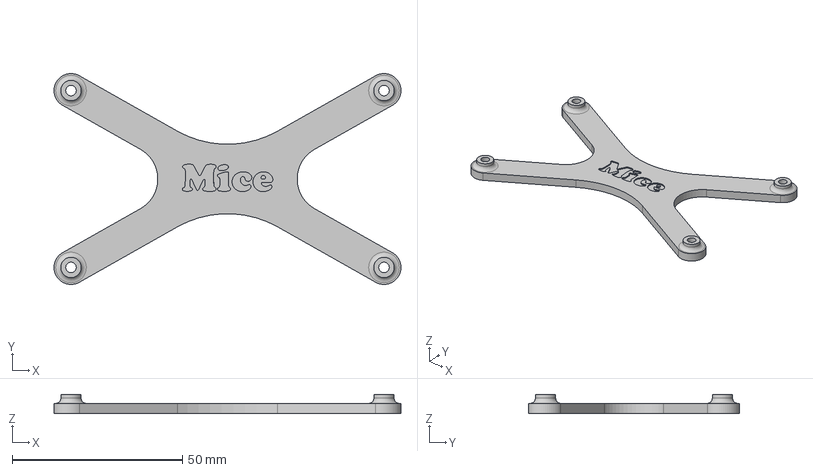
[picture p157: CAD file, 2025-10-21]
STL/Системы смены пластика/BoxTurtle/Новая плата/маунт платы черепахи v.3.stp
102.0 x 62.0 x 5.60 mm
