deflord/3def/STL/Системы смены пластика/QuattroBox/Крепления пластины держателя FLY mmu1.0X2.STL

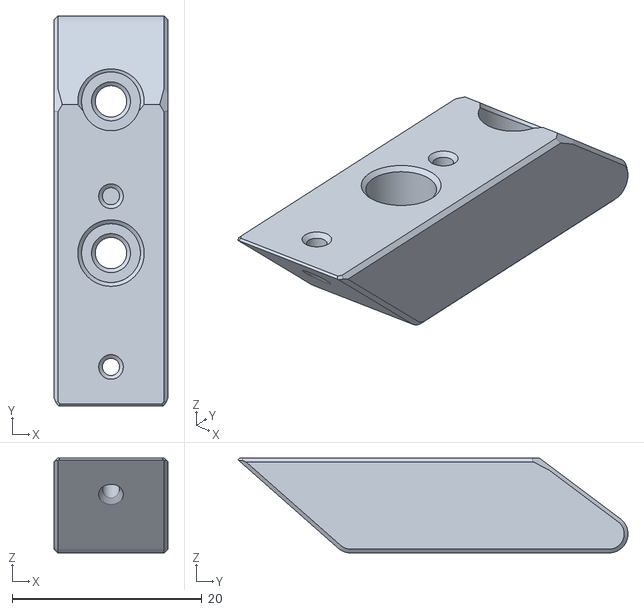
[picture p158: CAD file, 2026-01-16]
STL/Системы смены пластика/QuattroBox/Крепления пластины держателя FLY mmu1.0X2.STL
12.0 x 41.1 x 10.0
