deflord/3def/STL/Системы смены пластика/QuattroBox/没有齿轮箱/extruder_no_gearbox_mirror_x1.stl

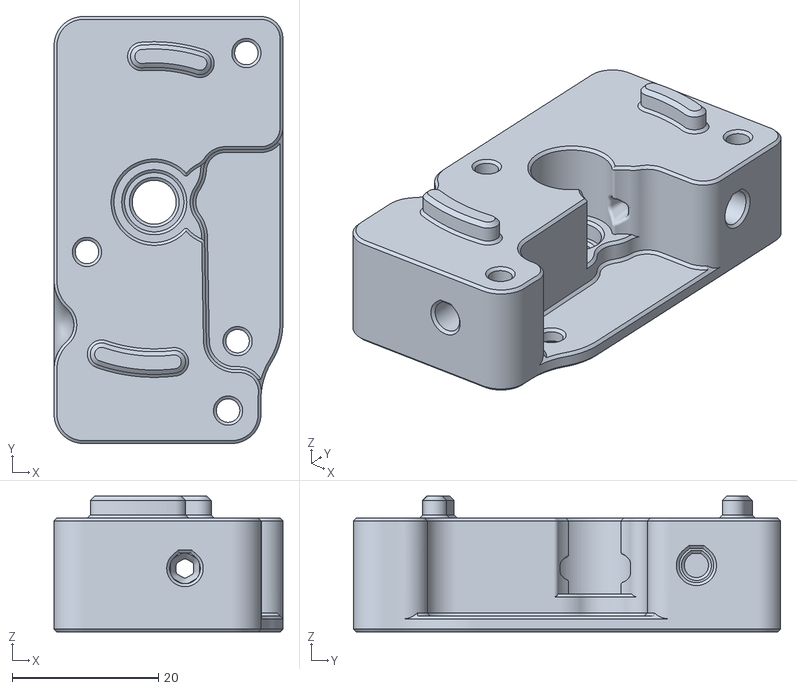
[picture p159: CAD file, 2026-01-16]
STL/Системы смены пластика/QuattroBox/没有齿轮箱/extruder_no_gearbox_mirror_x1.stl
31.3 x 58.4 x 18.6
