deflord/3def/STL/Системы смены пластика/Соеденитель PTFE.step

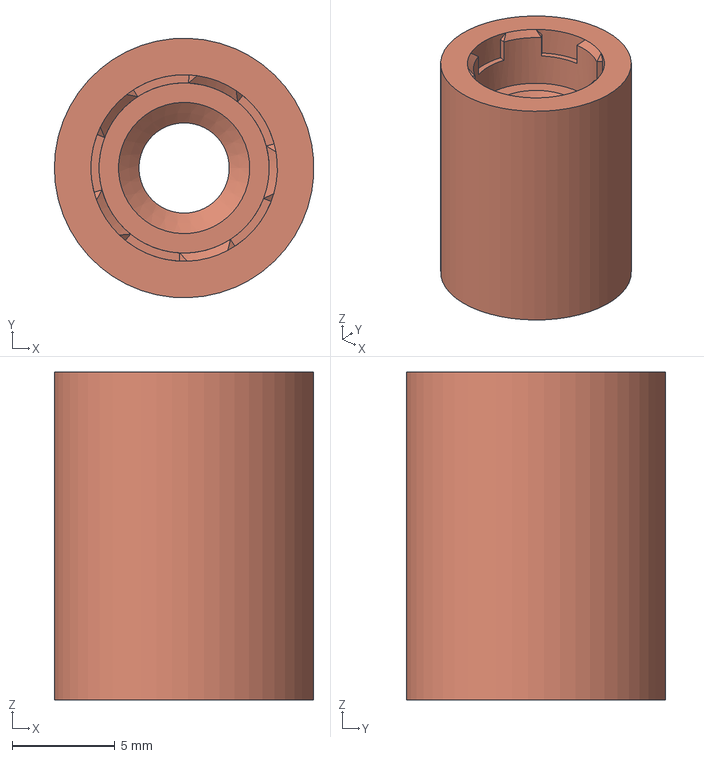
[picture p160: CAD file, 2026-09-07]
STL/Системы смены пластика/Соеденитель PTFE.step
12.6 x 12.7 x 16.0 mm
