deflord/3def/OrcaSlicer/Столы/Voron_400_build_plate.stl

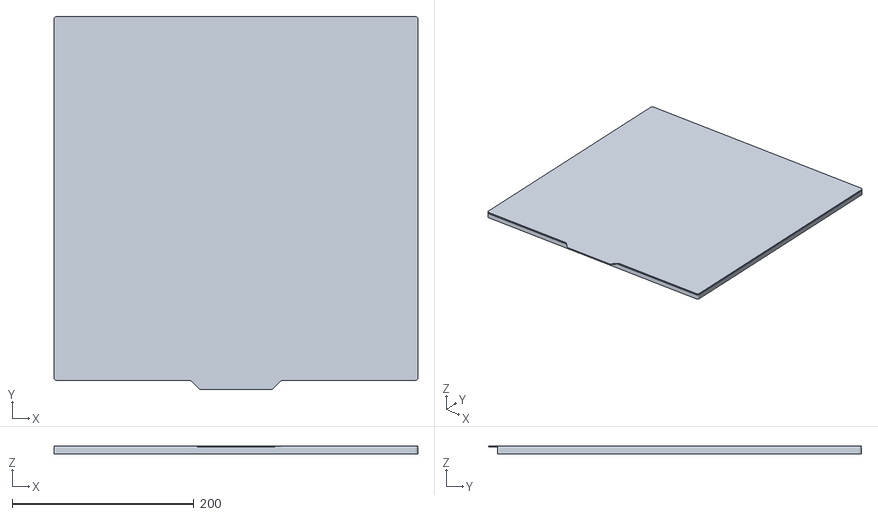
[picture p161: CAD file, 2026-05-15]
OrcaSlicer/Столы/Voron_400_build_plate.stl
400.0 x 410.0 x 9.20
