deflord/3def/STL/CPAP/BTT ECO Turbo kit/Без датчика SFS/STL/[a]_Крепление на профиль_2020.step.stl

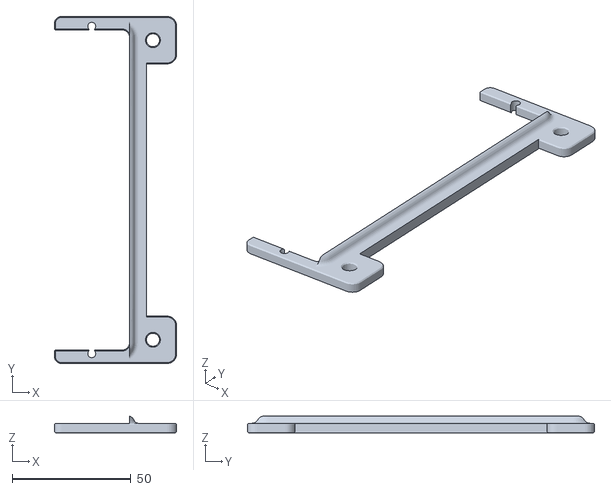
[picture p162: CAD file, 2025-06-22]
STL/CPAP/BTT ECO Turbo kit/Без датчика SFS/STL/[a]_Крепление на профиль_2020.step.stl
51.6 x 146.4 x 7.00
