deflord/3def/STL/CPAP/CPAP на портал/STL/Крепление к порталу.STL

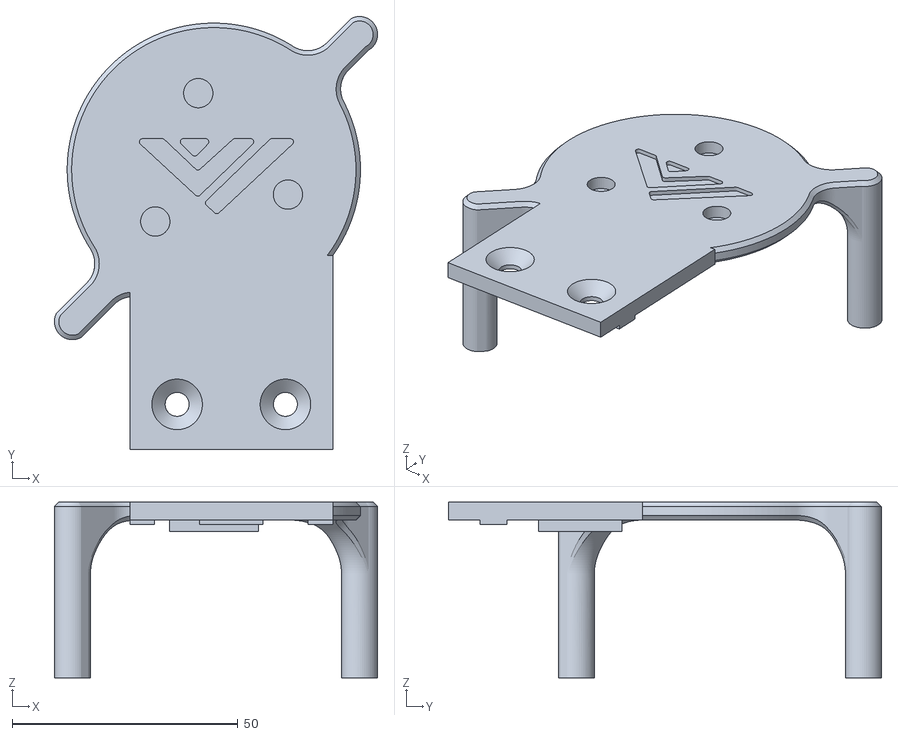
[picture p163: CAD file, 2025-09-11]
STL/CPAP/CPAP на портал/STL/Крепление к порталу.STL
71.6 x 96.0 x 39.0
