deflord/3def/STL/StealthChanger/DragonBurner/CAD/Задняя крышка SHT-36 новая.step

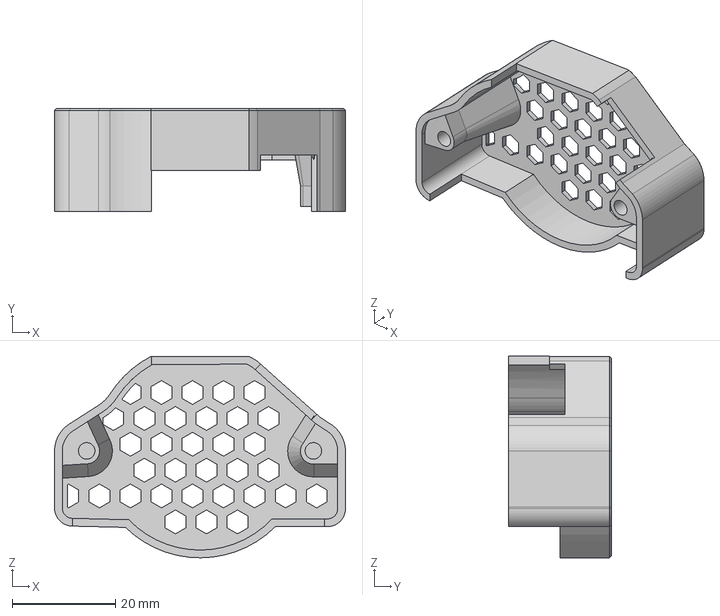
[picture p164: CAD file, 2025-06-16]
STL/StealthChanger/DragonBurner/CAD/Задняя крышка SHT-36 новая.step
56.3 x 20.0 x 39.0 mm
