deflord/3def/STL/StealthChanger/DragonBurner/STL/Корпус.stl

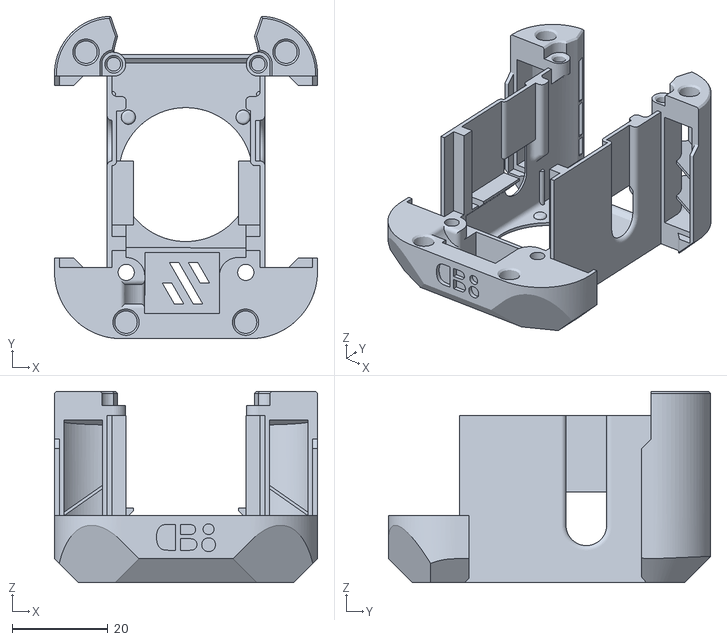
[picture p165: CAD file, 2025-04-23]
STL/StealthChanger/DragonBurner/STL/Корпус.stl
55.0 x 67.4 x 40.0
