deflord/3def/STL/StealthChanger/Задний рюкзак с электроникой/Профиль 2040/Глубокая версия/CAD/Крышка.step

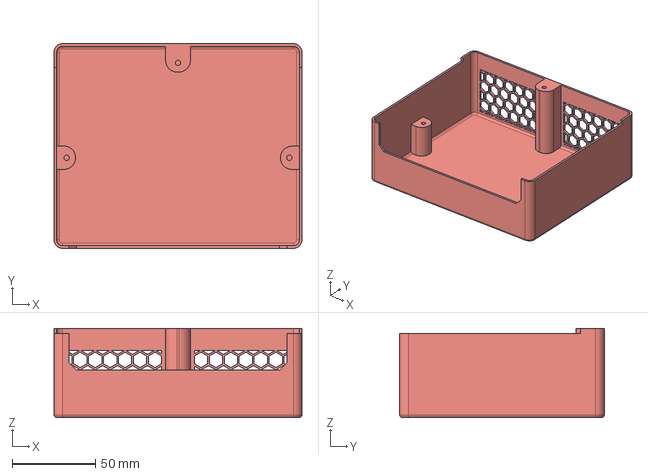
[picture p166: CAD file, 2025-09-11]
STL/StealthChanger/Задний рюкзак с электроникой/Профиль 2040/Глубокая версия/CAD/Крышка.step
149.2 x 123.2 x 53.6 mm
