deflord/3def/STL/StealthChanger/Задний рюкзак с электроникой/Профиль 3030/CAD/Крышка.step

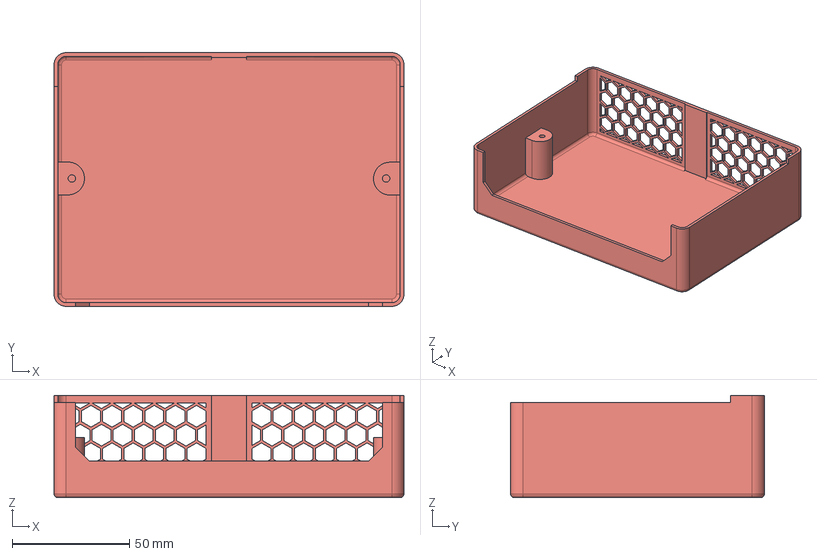
[picture p167: CAD file, 2025-06-16]
STL/StealthChanger/Задний рюкзак с электроникой/Профиль 3030/CAD/Крышка.step
149.2 x 108.2 x 43.6 mm
