deflord/3def/STL/StealthChanger/Магнитный док/CAD/Dock_BambuNozzleWiper длинее на 1 мм.step

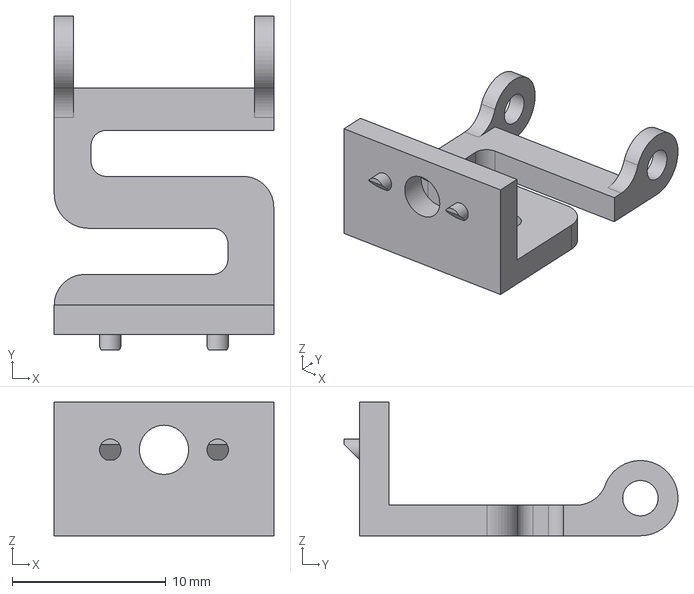
[picture p168: CAD file, 2025-05-21]
STL/StealthChanger/Магнитный док/CAD/Dock_BambuNozzleWiper длинее на 1 мм.step
14.3 x 21.7 x 8.70 mm
