deflord/3def/STL/StealthChanger/Магнитный док/STL/Держатель щётки в стиле Bambulab длинее на 2 мм.stl

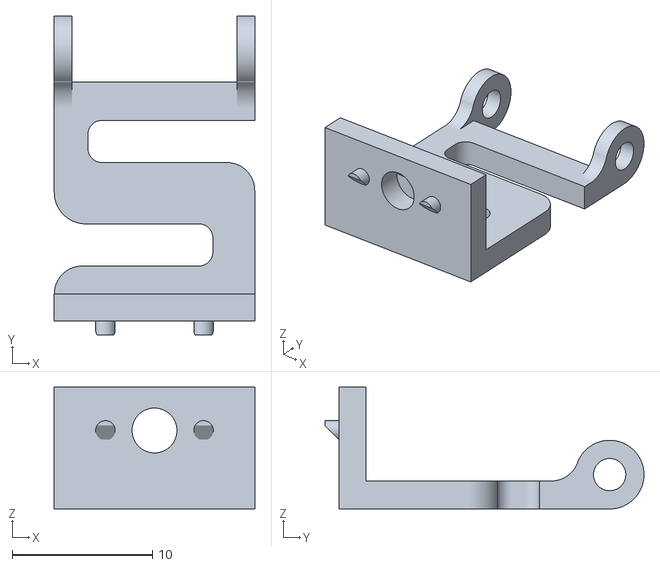
[picture p169: CAD file, 2025-05-21]
STL/StealthChanger/Магнитный док/STL/Держатель щётки в стиле Bambulab длинее на 2 мм.stl
14.3 x 22.7 x 8.70
