deflord/3def/STL/Моды/CPAP/BTT Eco Turbo Kit/CAD/Держатель на профиль_3030.step

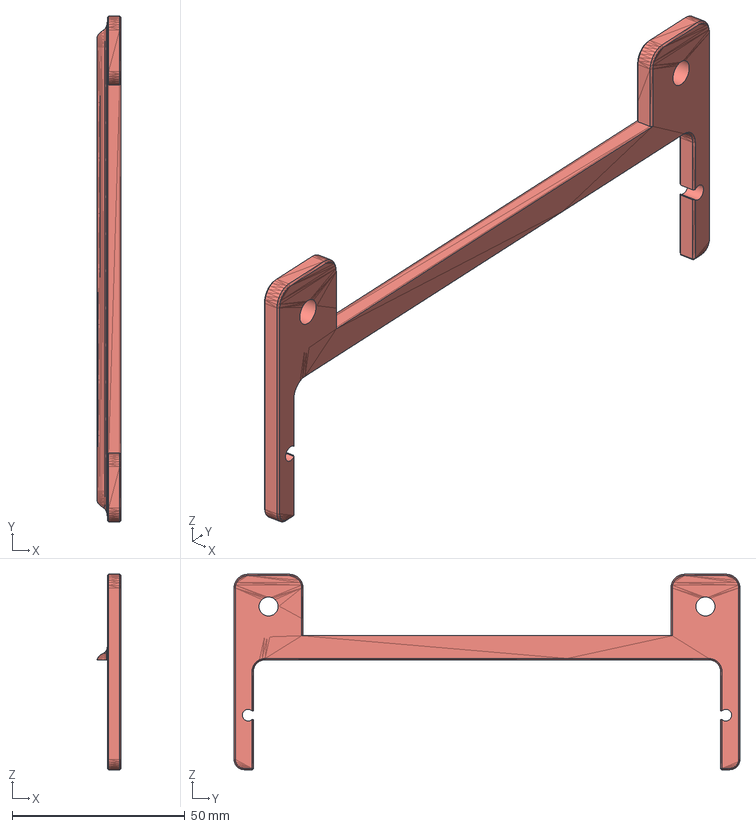
[picture p170: CAD file, 2025-06-22]
STL/Моды/CPAP/BTT Eco Turbo Kit/CAD/Держатель на профиль_3030.step
7.00 x 146.4 x 56.6 mm
