deflord/3def/STL/Моды/CPAP/Monolith/CAD/Адаптер шланга CPAP.step

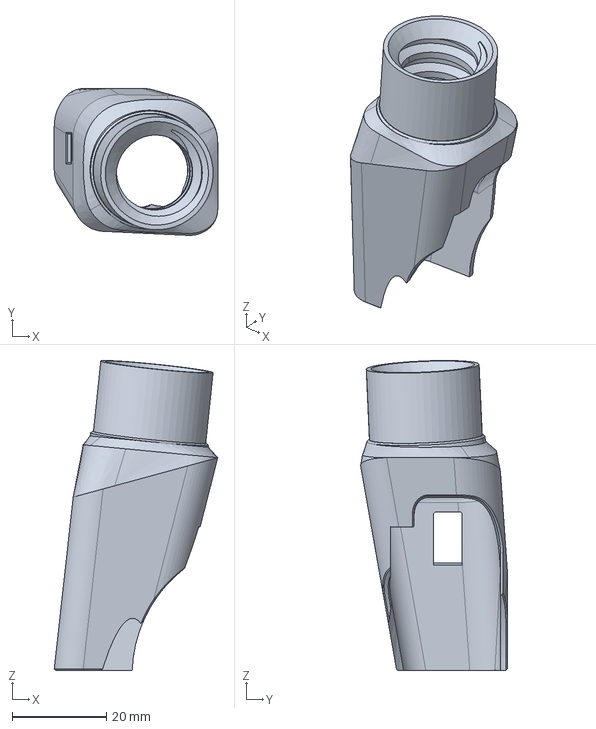
[picture p171: CAD file, 2026-01-16]
STL/Моды/CPAP/Monolith/CAD/Адаптер шланга CPAP.step
34.7 x 31.2 x 65.8 mm
