deflord/3def/(list of files, cad)

Other CAD files:
STL/Обшивка/Двери/Петли дверей/500/Модернезированная версия/Петля двери на 500 левая.stl
STL/Обшивка/Двери/Петли дверей/500/Петля двери. Крепление дверцы_2.stl
STL/Отсек аппаратуры/Держатели плат/Fly X10 Pro/STL/Крепление к DIN рейке х3.stl
STL/Отсек аппаратуры/Держатели разъёмов/Держатель разъёма CAN/Skirt JST 2,54 4Pin multicolor.step
STL/Печатающие головы/StealthBurner/Держатель хотэнда/Rapido UHF/CAD/G2E_SB_Rapido 2_Filametrix_Rear v1.step
STL/Печатающие головы/StealthBurner/Тензодатчик/Держатель платы.stl
STL/Проводка/Проводка сверху портала/500/CAD/Камера 500 AWD верх.step
STL/CPAP/BTT ECO Turbo kit/С датчиком SFS/CAD/Корпус фильтра.step
STL/CPAP/BTT ECO Turbo kit/Без датчика SFS/CAD/[a]_Задняя крышка.step
STL/CPAP/BTT ECO Turbo kit/Без датчика SFS/CAD/[a]_Крепление на профиль_2020.step
STL/CPAP/BTT ECO Turbo kit/Без датчика SFS/CAD/Адаптер для трубки 18мм.step
STL/CPAP/BTT ECO Turbo kit/Без датчика SFS/CAD/Решётка для забора воздуха.step
STL/CPAP/BTT ECO Turbo kit/Без датчика SFS/STL/[a]_Задняя крышка.stl
STL/CPAP/BTT ECO Turbo kit/Без датчика SFS/STL/Адаптер для трубки 18мм.stl
STL/CPAP/BTT ECO Turbo kit/Без датчика SFS/STL/Решётка для забора воздуха с PG7.stl
STL/CPAP/BTT ECO Turbo kit/Без датчика SFS/STL/Решётка для забора воздуха.stl
STL/CPAP/BTT ECO Turbo kit/С датчиком SFS/CAD/[a]_Задняя крышка.step
STL/CPAP/BTT ECO Turbo kit/С датчиком SFS/CAD/[a]_Крепление на профиль_2020.step
STL/CPAP/BTT ECO Turbo kit/С датчиком SFS/CAD/Адаптер для трубки 18мм.step
STL/CPAP/BTT ECO Turbo kit/С датчиком SFS/CAD/Решётка для забора воздуха.step
STL/CPAP/BTT ECO Turbo kit/С датчиком SFS/CAD/Удлинитель-кнопка для трубки PTFE.step
STL/CPAP/BTT ECO Turbo kit/С датчиком SFS/STL/[a]_Задняя крышка.stl
STL/CPAP/BTT ECO Turbo kit/С датчиком SFS/STL/Адаптер для трубки 18мм.stl
STL/CPAP/BTT ECO Turbo kit/С датчиком SFS/STL/Решётка для забора воздуха с PG7.stl
STL/CPAP/BTT ECO Turbo kit/С датчиком SFS/STL/Решётка для забора воздуха.stl
STL/CPAP/BTT ECO Turbo kit/С датчиком SFS/STL/Удлинитель-кнопка для трубки PTFE.stl
STL/CPAP/CPAP на портал/STL/Адаптер на трубку 18 мм.STL
STL/CPAP/CPAP на портал/STL/Передняя крышка.STL
STL/StealthChanger/DragonBurner/CAD/[c]_Прозрачная крышка светодиода.step
STL/StealthChanger/DragonBurner/CAD/[o]_Держатель светодиода.step
STL/StealthChanger/DragonBurner/CAD/Держатель платы CAN.step
STL/StealthChanger/DragonBurner/CAD/Держатель ремней 6мм.step
STL/StealthChanger/DragonBurner/CAD/Держатель ремней 9мм.step
STL/StealthChanger/DragonBurner/CAD/Держатель светодидов освещения сопла.step
STL/StealthChanger/DragonBurner/CAD/Док с крючками.step
STL/StealthChanger/DragonBurner/CAD/Задник StealthChanger для Drugonbarner.step
STL/StealthChanger/DragonBurner/CAD/Корпус с магнитами.step
STL/StealthChanger/DragonBurner/CAD/Крепление Orbiter2.step
STL/StealthChanger/DragonBurner/CAD/Крепление хотэнда TZ_V2.step
STL/StealthChanger/DragonBurner/CAD/Проставка.step
STL/StealthChanger/DragonBurner/CAD/Шатл без поддержек.step
STL/StealthChanger/DragonBurner/STL/[c]_Прозрачная крышка светодиода.stl
STL/StealthChanger/DragonBurner/STL/[o]_Держатель светодиода.stl
STL/StealthChanger/DragonBurner/STL/Держатель платы CAN.stl
STL/StealthChanger/DragonBurner/STL/Держатель провода и трубки PTFE.STL
STL/StealthChanger/DragonBurner/STL/Держатель ремней 6мм.stl
STL/StealthChanger/DragonBurner/STL/Держатель ремней 9мм.stl
STL/StealthChanger/DragonBurner/STL/Держатель светодидов освещения сопла.stl
STL/StealthChanger/DragonBurner/STL/Док с крючками.stl
STL/StealthChanger/DragonBurner/STL/Задник StealthChanger для Drugonbarner.stl
STL/StealthChanger/DragonBurner/STL/Задняя крышка sht–36 новая.stl
STL/StealthChanger/DragonBurner/STL/Крепление Orbiter2.stl
STL/StealthChanger/DragonBurner/STL/Крепление хотэнда Rapido HF и UHF.stl
STL/StealthChanger/DragonBurner/STL/Крепление хотэнда TZ_V2.stl
STL/StealthChanger/DragonBurner/STL/Проставка.stl
STL/StealthChanger/DragonBurner/STL/Шатл без поддержек.stl
STL/StealthChanger/Задний рюкзак с электроникой/Профиль 2040/CAD/Адаптер для PG7 на 6 голов.step
STL/StealthChanger/Задний рюкзак с электроникой/Профиль 2040/CAD/Крышка.step
STL/StealthChanger/Задний рюкзак с электроникой/Профиль 2040/STL/Крышка.stl
STL/StealthChanger/Задний рюкзак с электроникой/Профиль 2040/STL/Проставка платы 7 шт.stl
STL/StealthChanger/Задний рюкзак с электроникой/Профиль 2040/Глубокая версия/CAD/Держатель плат.step
STL/StealthChanger/Задний рюкзак с электроникой/Профиль 2040/Глубокая версия/STL/Крышка.stl
STL/StealthChanger/Задний рюкзак с электроникой/Профиль 3030/CAD/Адаптер для PG7 на 6 голов.step
STL/StealthChanger/Задний рюкзак с электроникой/Профиль 3030/CAD/Держатель плат.step
STL/StealthChanger/Задний рюкзак с электроникой/Профиль 3030/STL/Держатель плат.stl
STL/StealthChanger/Задний рюкзак с электроникой/Профиль 3030/STL/Крышка.stl
STL/StealthChanger/Задний рюкзак с электроникой/Профиль 3030/STL/Проставка платы 7 шт.stl
STL/StealthChanger/Магнитный док/CAD/Dock_BambuNozzleWiper длинее на 2 мм.step
STL/StealthChanger/Магнитный док/CAD/DragonBurner_magnet_Plate.step
STL/StealthChanger/Магнитный док/CAD/Верхняя дополнительная планка 2020.step
STL/StealthChanger/Магнитный док/CAD/Верхняя часть рамки 2020.step
STL/StealthChanger/Магнитный док/CAD/Держатель STH-36_orbiter_2.0 с креплением проволки.step
STL/StealthChanger/Магнитный док/CAD/Держатель магнита рамы x2.step
STL/StealthChanger/Магнитный док/CAD/Держатель щётки в стиле Bambulab.step
STL/StealthChanger/Магнитный док/CAD/Корпус DragonBurner с магнитами.step
STL/StealthChanger/Магнитный док/CAD/Нижнее крепление к профилю 2020.step
STL/StealthChanger/Магнитный док/CAD/Рамка правая.step
STL/StealthChanger/Магнитный док/CAD/Укороченная база под DragonBurner.step
STL/StealthChanger/Магнитный док/CAD/Укороченный слюнявчик в сборе.step
STL/StealthChanger/Магнитный док/STL/DragonBurner_magnet_Plate.stl
STL/StealthChanger/Магнитный док/STL/Верхняя дополнительная планка 2020.stl
STL/StealthChanger/Магнитный док/STL/Верхняя часть рамки 2020.stl
STL/StealthChanger/Магнитный док/STL/Держатель магнита рамы x2.stl
STL/StealthChanger/Магнитный док/STL/Держатель слюнявчика.stl
STL/StealthChanger/Магнитный док/STL/Держатель щётки в стиле Bambulab длинее на 1 мм.stl
STL/StealthChanger/Магнитный док/STL/Держатель щётки в стиле Bambulab.stl
STL/StealthChanger/Магнитный док/STL/Задний упор с магнитами.stl
STL/StealthChanger/Магнитный док/STL/Корпус DragonBurner с магнитами.stl
STL/StealthChanger/Магнитный док/STL/Нижнее крепление к профилю 2020.stl
STL/StealthChanger/Магнитный док/STL/Рамка левая.stl
STL/StealthChanger/Магнитный док/STL/Рамка правая.stl
STL/StealthChanger/Магнитный док/STL/Укороченная база под DragonBurner.stl
STL/StealthChanger/Магнитный док/STL/Укороченная чаша слюнявчика.stl
STL/Моды/CPAP/BTT Eco Turbo Kit/CAD/Держатель на профиль 2020.step
STL/Моды/CPAP/BTT Eco Turbo Kit/CAD/Крышка.step
STL/Моды/CPAP/BTT Eco Turbo Kit/CAD/Переходник для подключения шланга.step
STL/Моды/CPAP/BTT Eco Turbo Kit/CAD/Решётка.step
STL/Моды/CPAP/BTT Eco Turbo Kit/CAD/Удлинитель трубки PTFE.step
STL/Моды/CPAP/BTT Eco Turbo Kit/STL/Держатель на профиль_3030.stl
STL/Моды/CPAP/BTT Eco Turbo Kit/STL/Переходник для подключения шланга.stl
STL/Моды/CPAP/BTT Eco Turbo Kit/STL/Решётка.stl
STL/Моды/CPAP/BTT Eco Turbo Kit/STL/Удлинитель трубки PTFE.stl
STL/Моды/CPAP/Monolith/STL/Адаптер шланга CPAP.stl
STL/Моды/CPAP/Monolith/STL/Держатель плоский.stl
STL/Моды/CPAP/Xiaomi CPAP/adapter_plate.STL
STL/Моды/CPAP/Xiaomi CPAP/Накладка.STL
STL/Моды/Активный подогрев/300:350:400/CAD/Левая часть.step
STL/Моды/Активный подогрев/300:350:400/CAD/Центр.step
STL/Моды/Активный подогрев/300:350:400/STL/Левая часть.stl
STL/Моды/Активный подогрев/300:350:400/STL/Правая часть.stl
STL/Моды/Активный подогрев/300:350:400/STL/Центр.stl
STL/Моды/Активный подогрев/500/CAD/Левая часть.step
STL/Моды/Активный подогрев/500/CAD/Правая часть.step
STL/Моды/Активный подогрев/500/CAD/Центр x2.step
STL/Моды/Активный подогрев/500/STL/Левая часть.stl
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
