deflord/3def/Конфигурационные файлы/Серийные/SN205/config/ShakeTune_results/axes_map/axesmap_20250903_125632.png

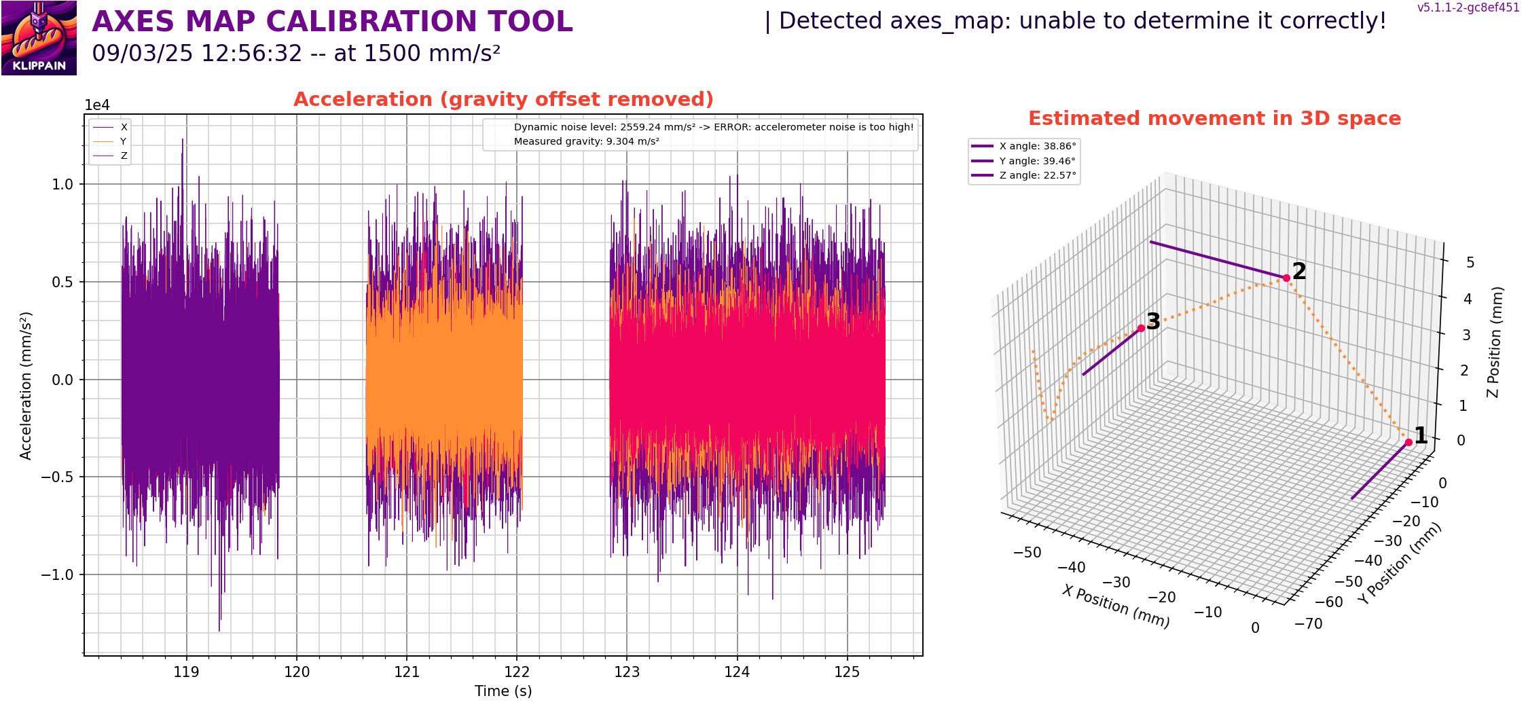
Конфигурационные файлы/Серийные/SN205/config/ShakeTune_results/axes_map/axesmap_20250903_125632.png
