deflord/3def/Конфигурационные файлы/Серийные/SN205/config/ShakeTune_results/input_shaper/inputshaper_20250523_101418_axis_X.png

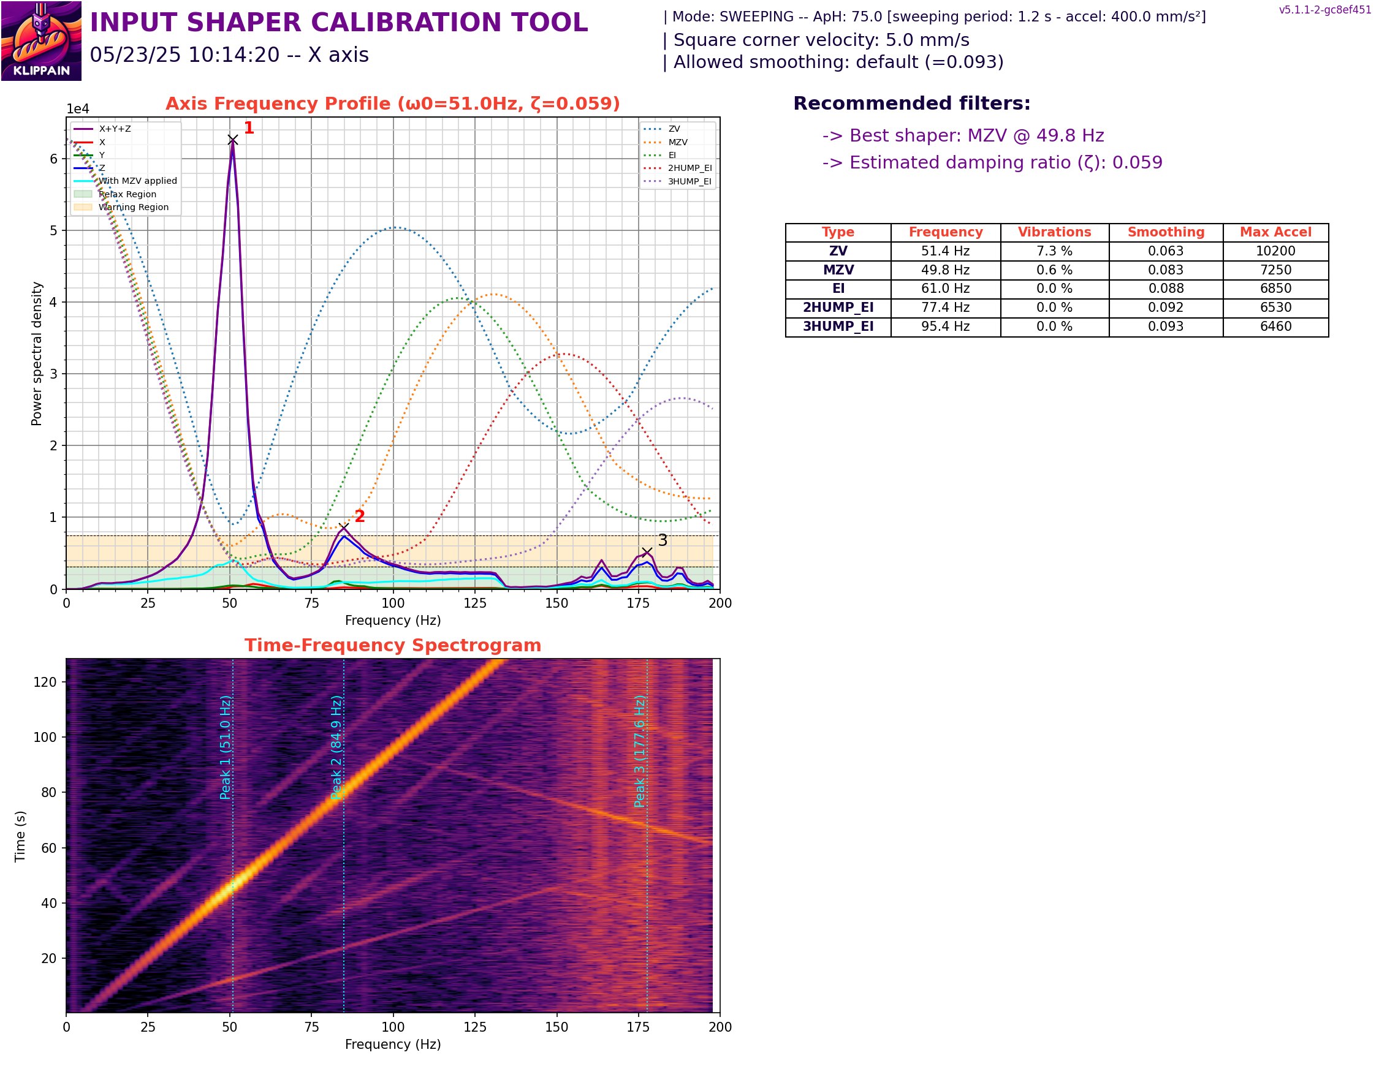
Конфигурационные файлы/Серийные/SN205/config/ShakeTune_results/input_shaper/inputshaper_20250523_101418_axis_X.png
