deflord/3def/Конфигурационные файлы/Серийные/SN205/config/ShakeTune_results/input_shaper/inputshaper_20250602_111722_axis_Y.png

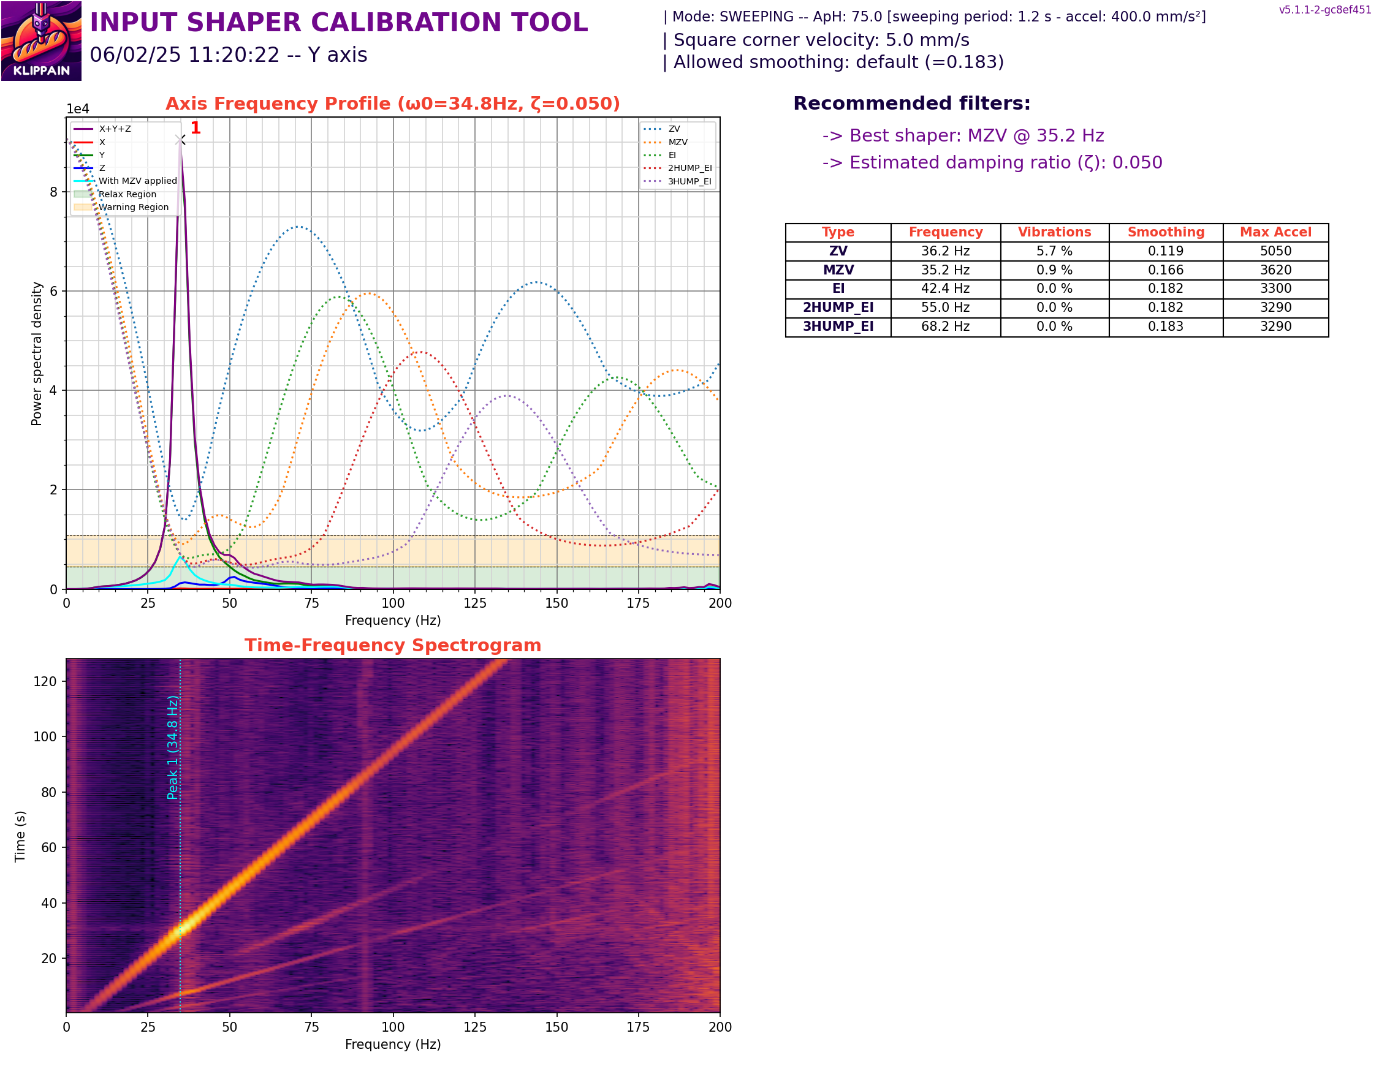
Конфигурационные файлы/Серийные/SN205/config/ShakeTune_results/input_shaper/inputshaper_20250602_111722_axis_Y.png
