deflord/3def/Конфигурационные файлы/Серийные/SN221/config/ShakeTune_results/axes_map/axesmap_20250912_143104.png

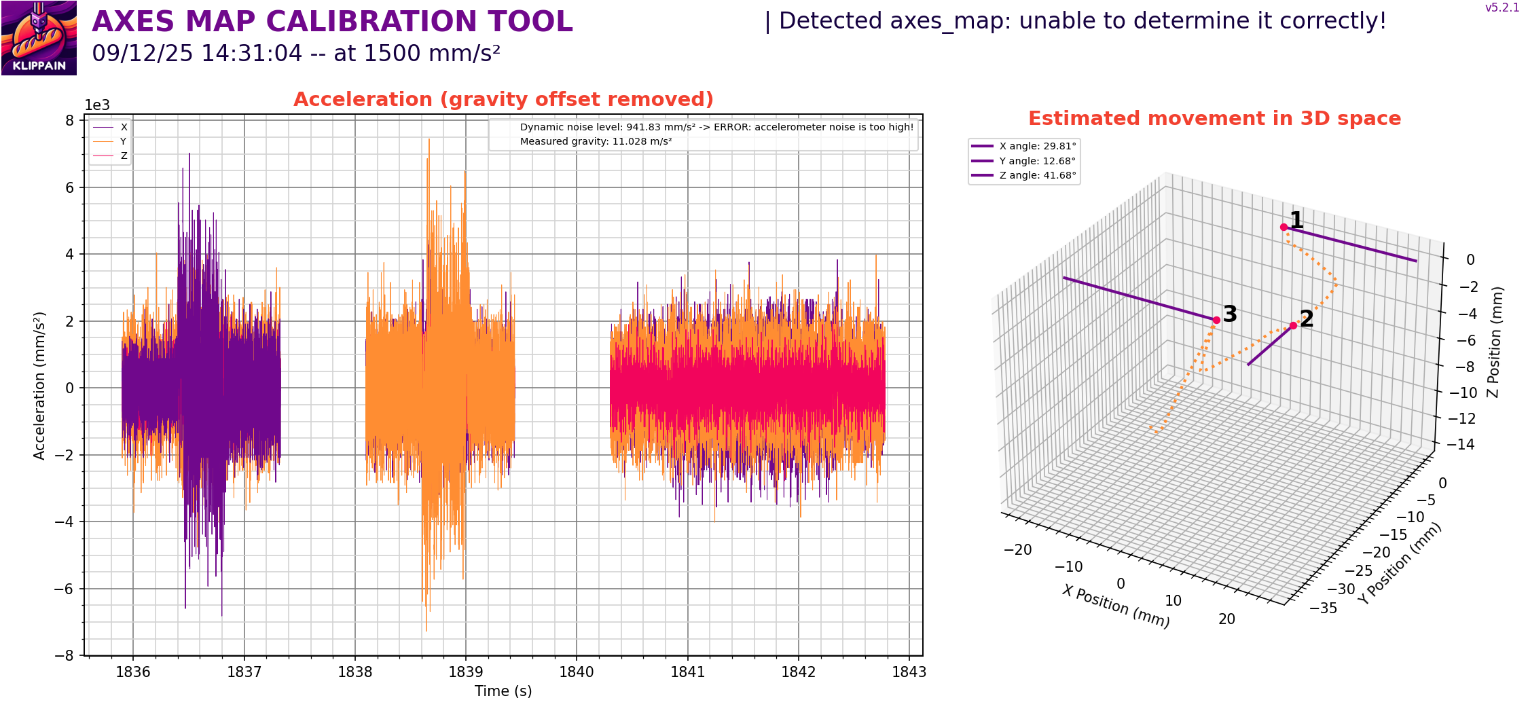
Конфигурационные файлы/Серийные/SN221/config/ShakeTune_results/axes_map/axesmap_20250912_143104.png
