deflord/3def/Конфигурационные файлы/Серийные/SN229/config/ShakeTune_results/belts/beltscomparison_20250814_115802.png

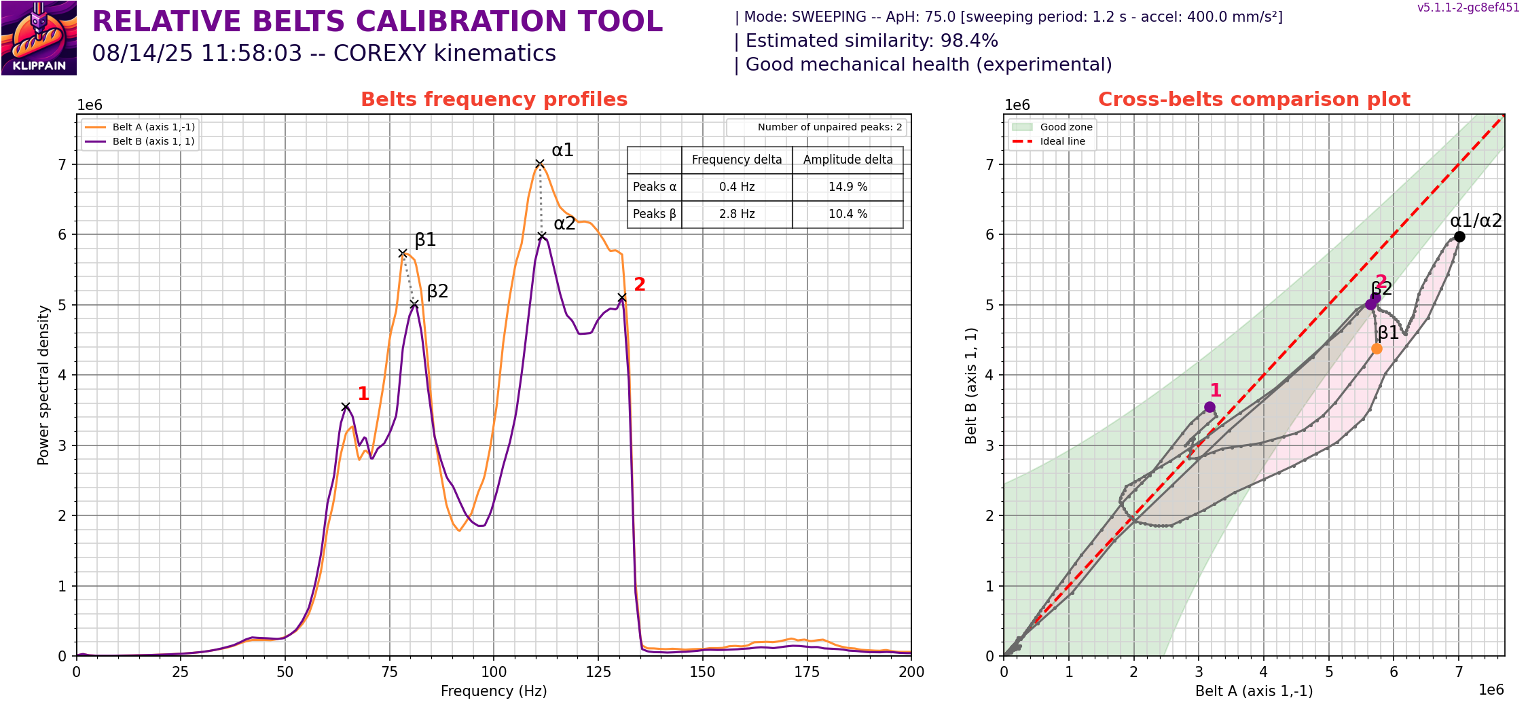
Конфигурационные файлы/Серийные/SN229/config/ShakeTune_results/belts/beltscomparison_20250814_115802.png
