deflord/3def/Конфигурационные файлы/Серийные/SN229/config/ShakeTune_results/input_shaper/inputshaper_20250814_120424_axis_Y.png

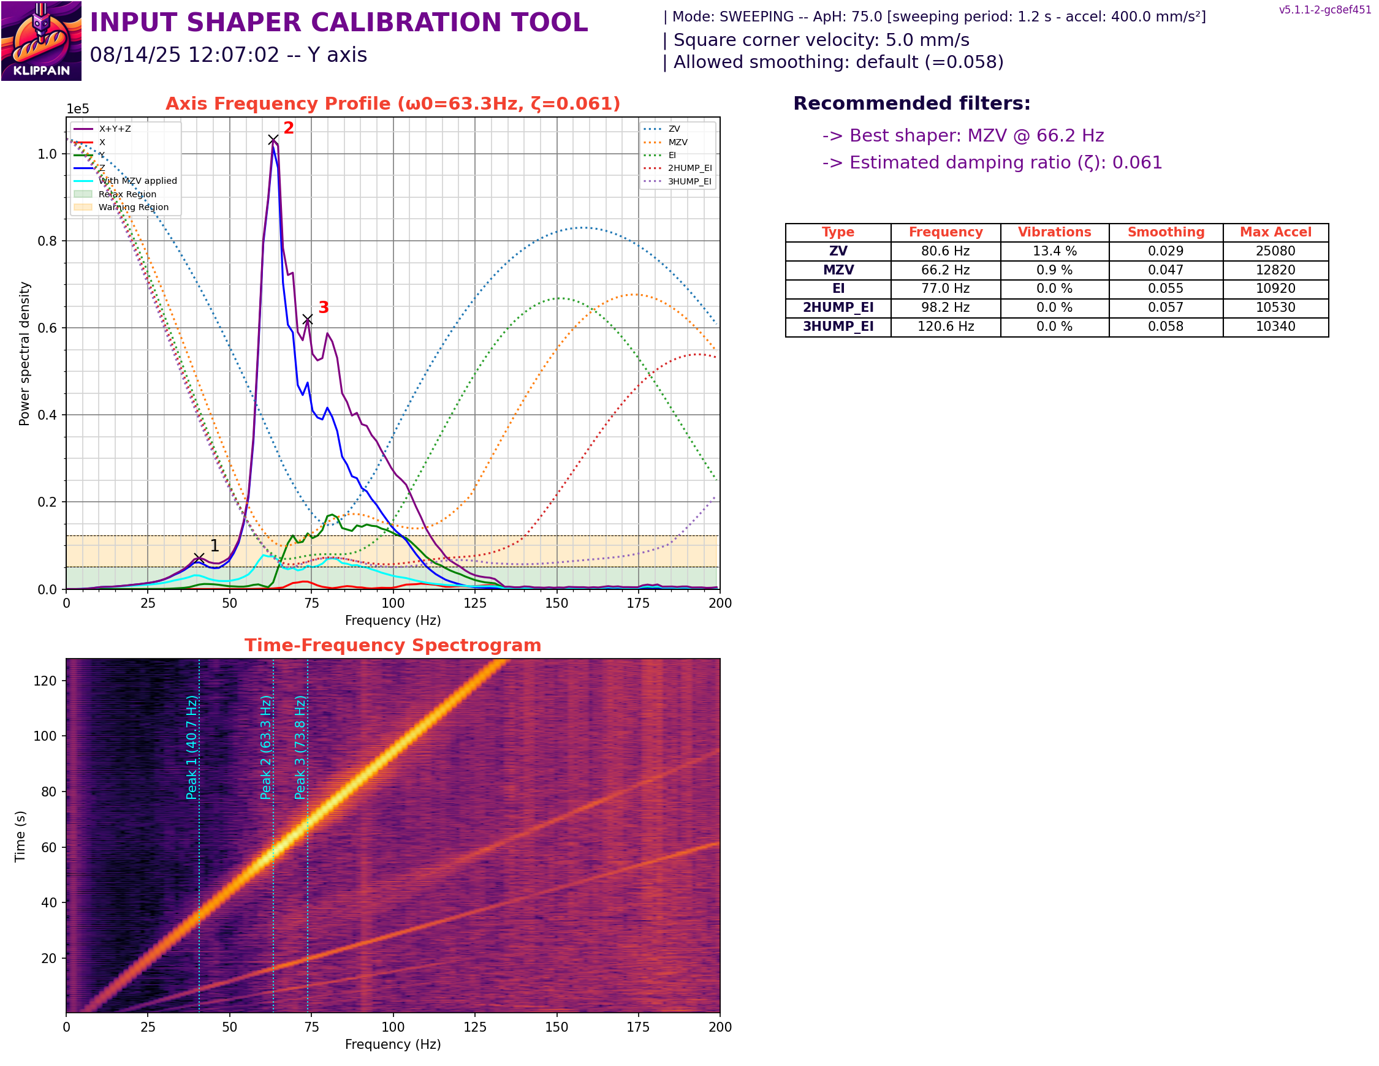
Конфигурационные файлы/Серийные/SN229/config/ShakeTune_results/input_shaper/inputshaper_20250814_120424_axis_Y.png
