deflord/3def/Конфигурационные файлы/Серийные/SN257/config/ShakeTune_results/input_shaper/inputshaper_20260203_144552_axis_X.png

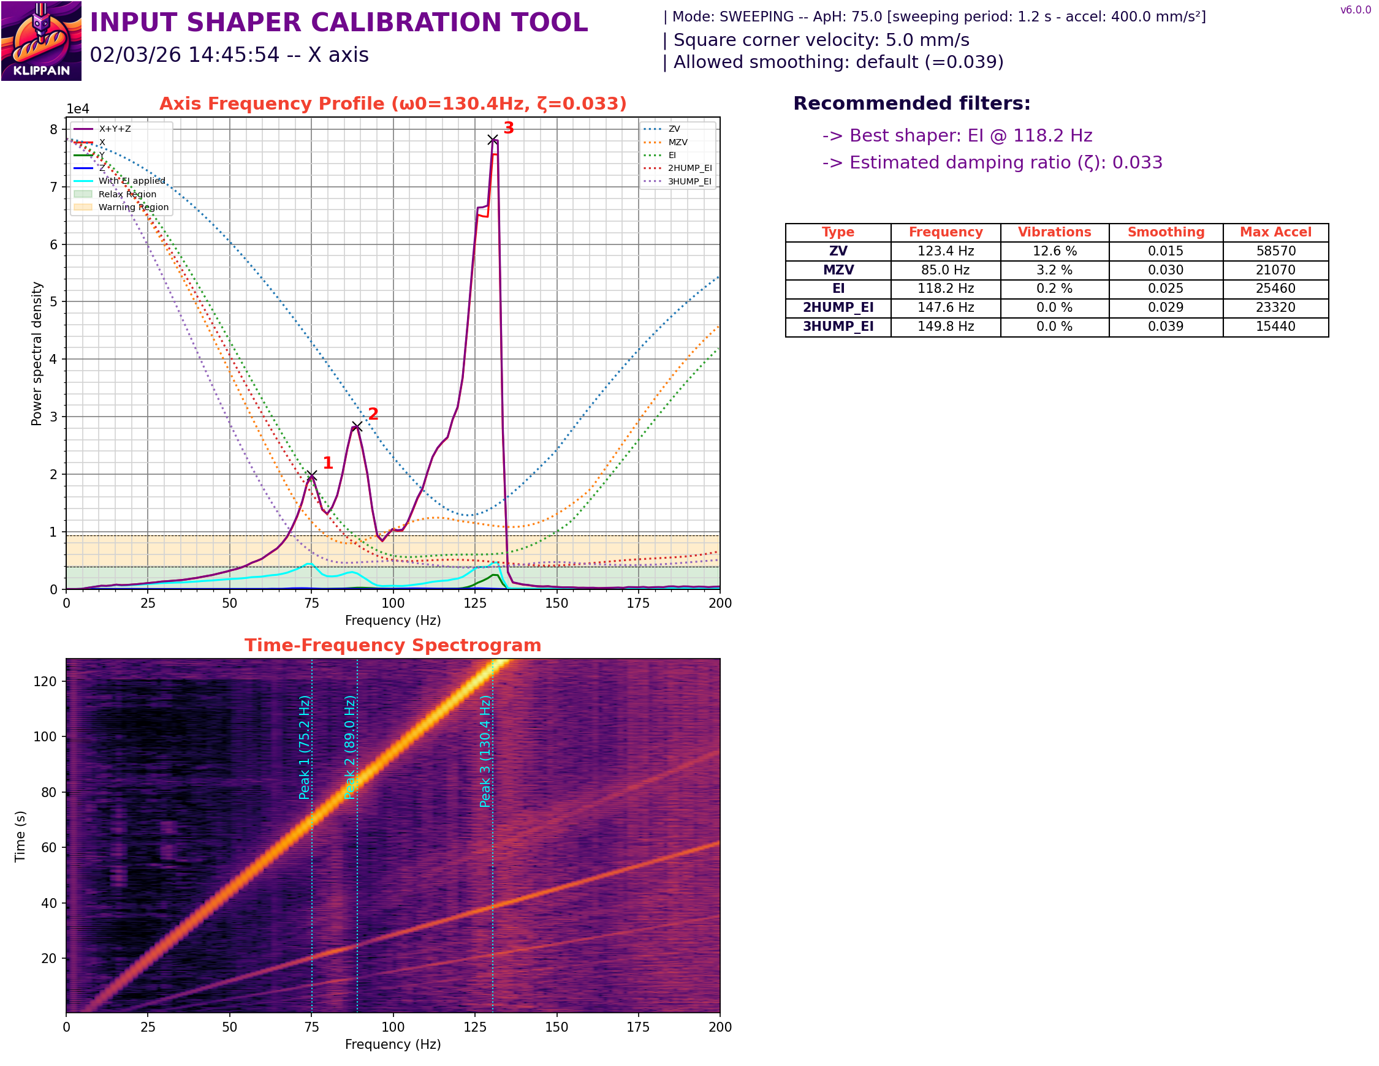
Конфигурационные файлы/Серийные/SN257/config/ShakeTune_results/input_shaper/inputshaper_20260203_144552_axis_X.png
