deflord/3def/Конфигурационные файлы/Серийные/SN260/config/ShakeTune_results/input_shaper/inputshaper_20260205_130827_axis_Y.png

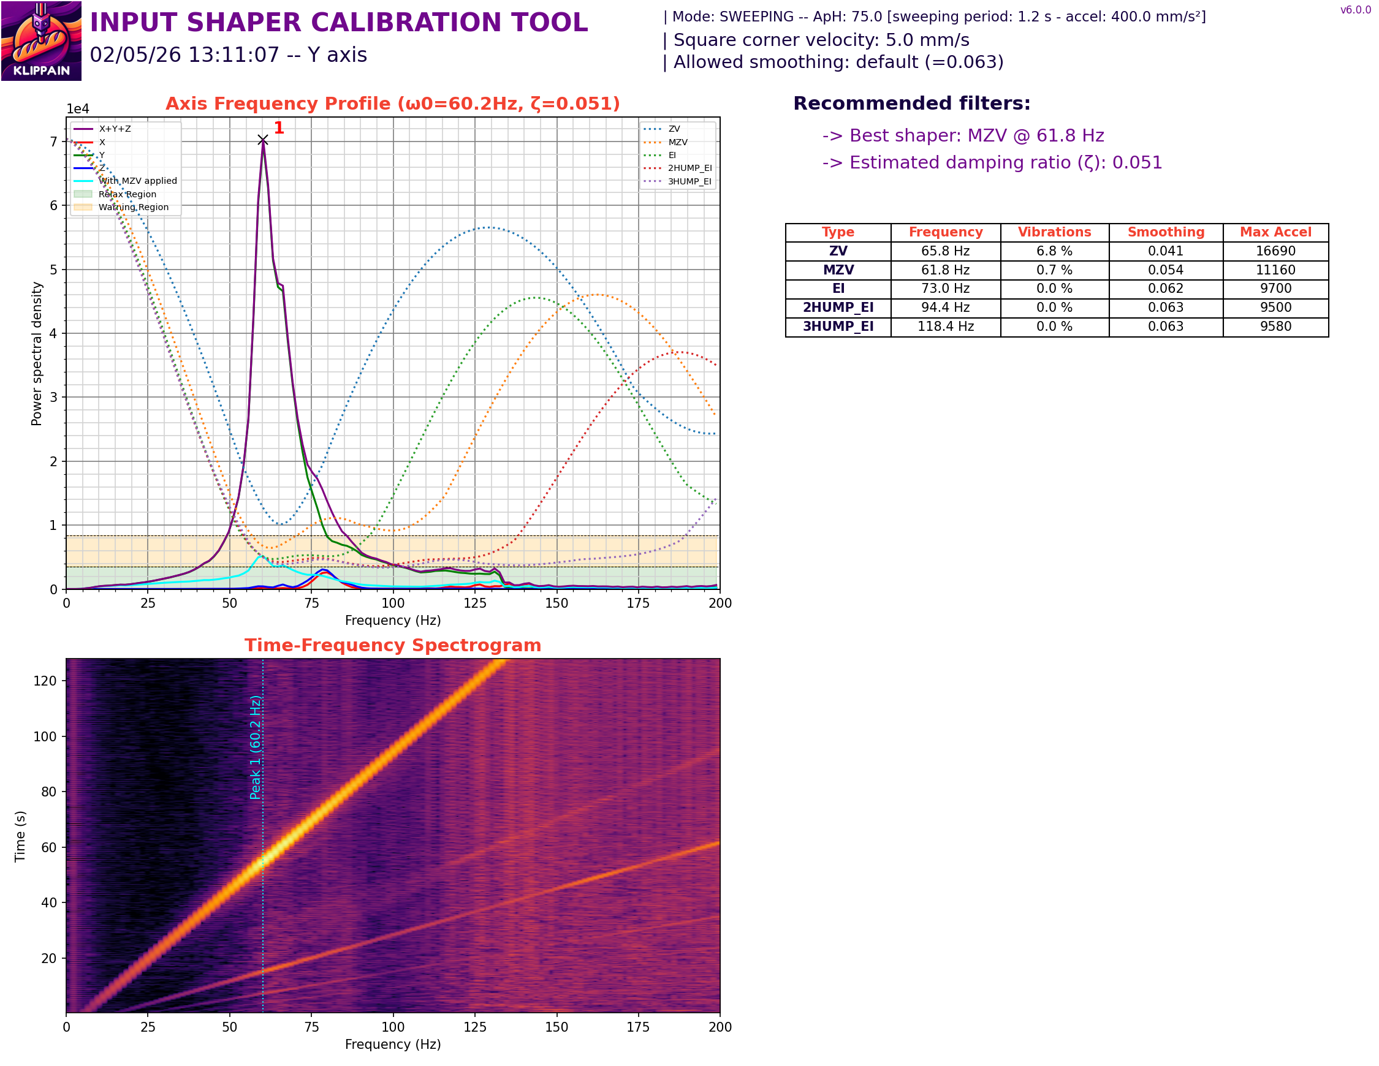
Конфигурационные файлы/Серийные/SN260/config/ShakeTune_results/input_shaper/inputshaper_20260205_130827_axis_Y.png
