deflord/3def/Конфигурационные файлы/Серийные/SN263/config/adxl_results/motors_sync/calibrate_plot_x_16-16_adxl345_20251109_202123.png

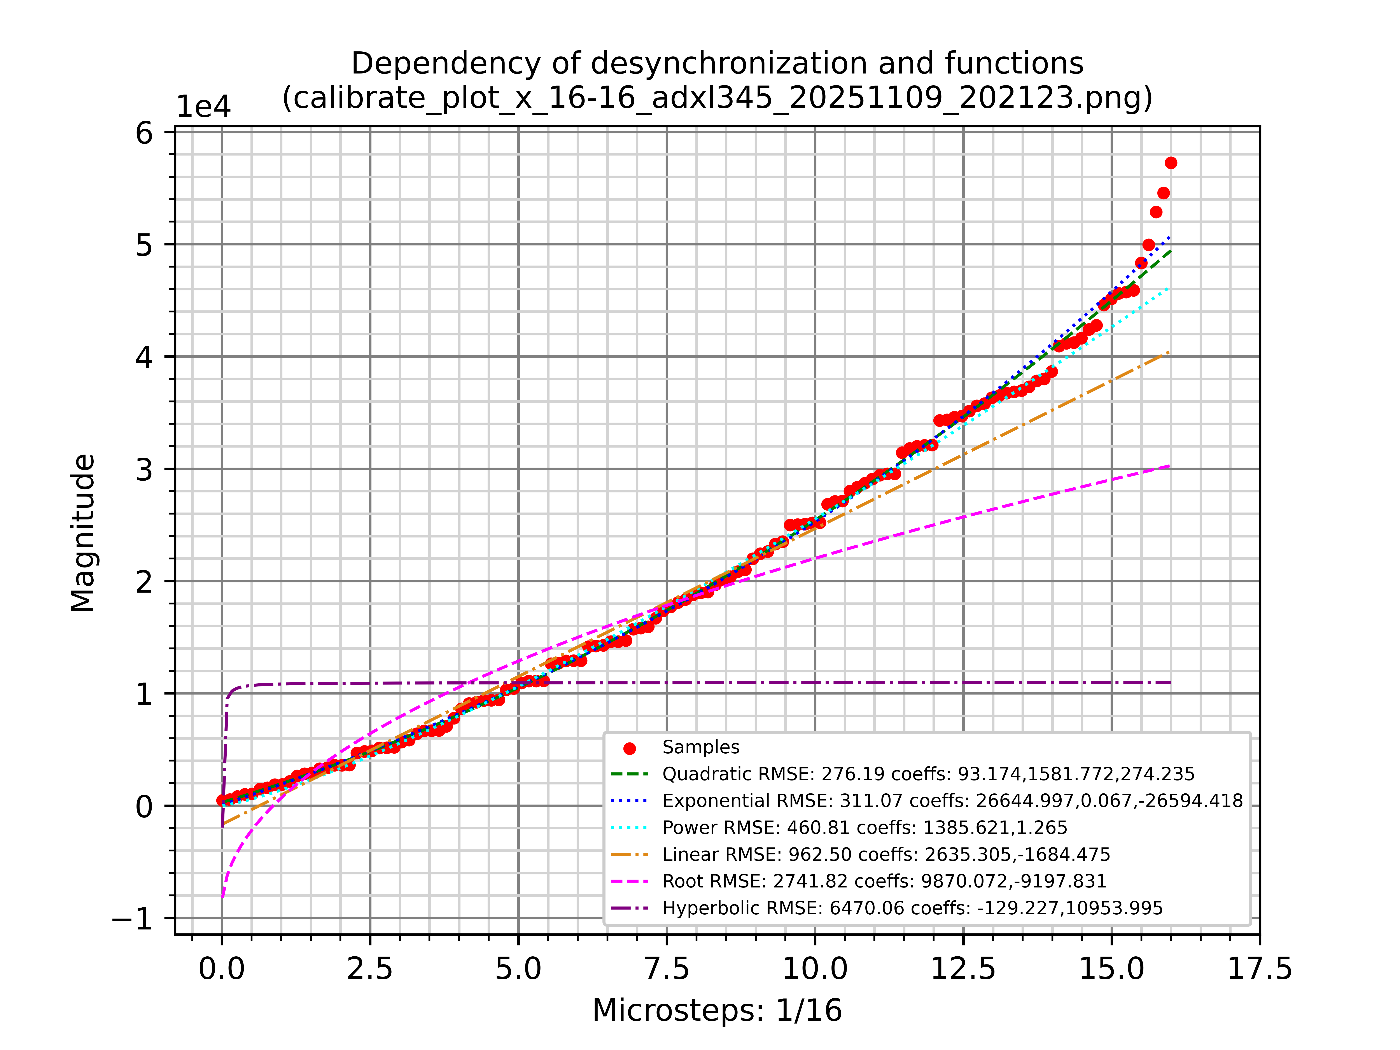
Конфигурационные файлы/Серийные/SN263/config/adxl_results/motors_sync/calibrate_plot_x_16-16_adxl345_20251109_202123.png
