deflord/3def/Конфигурационные файлы/Серийные/SN334/config/ShakeTune_results/input_shaper/inputshaper_20260324_142809_axis_X.png

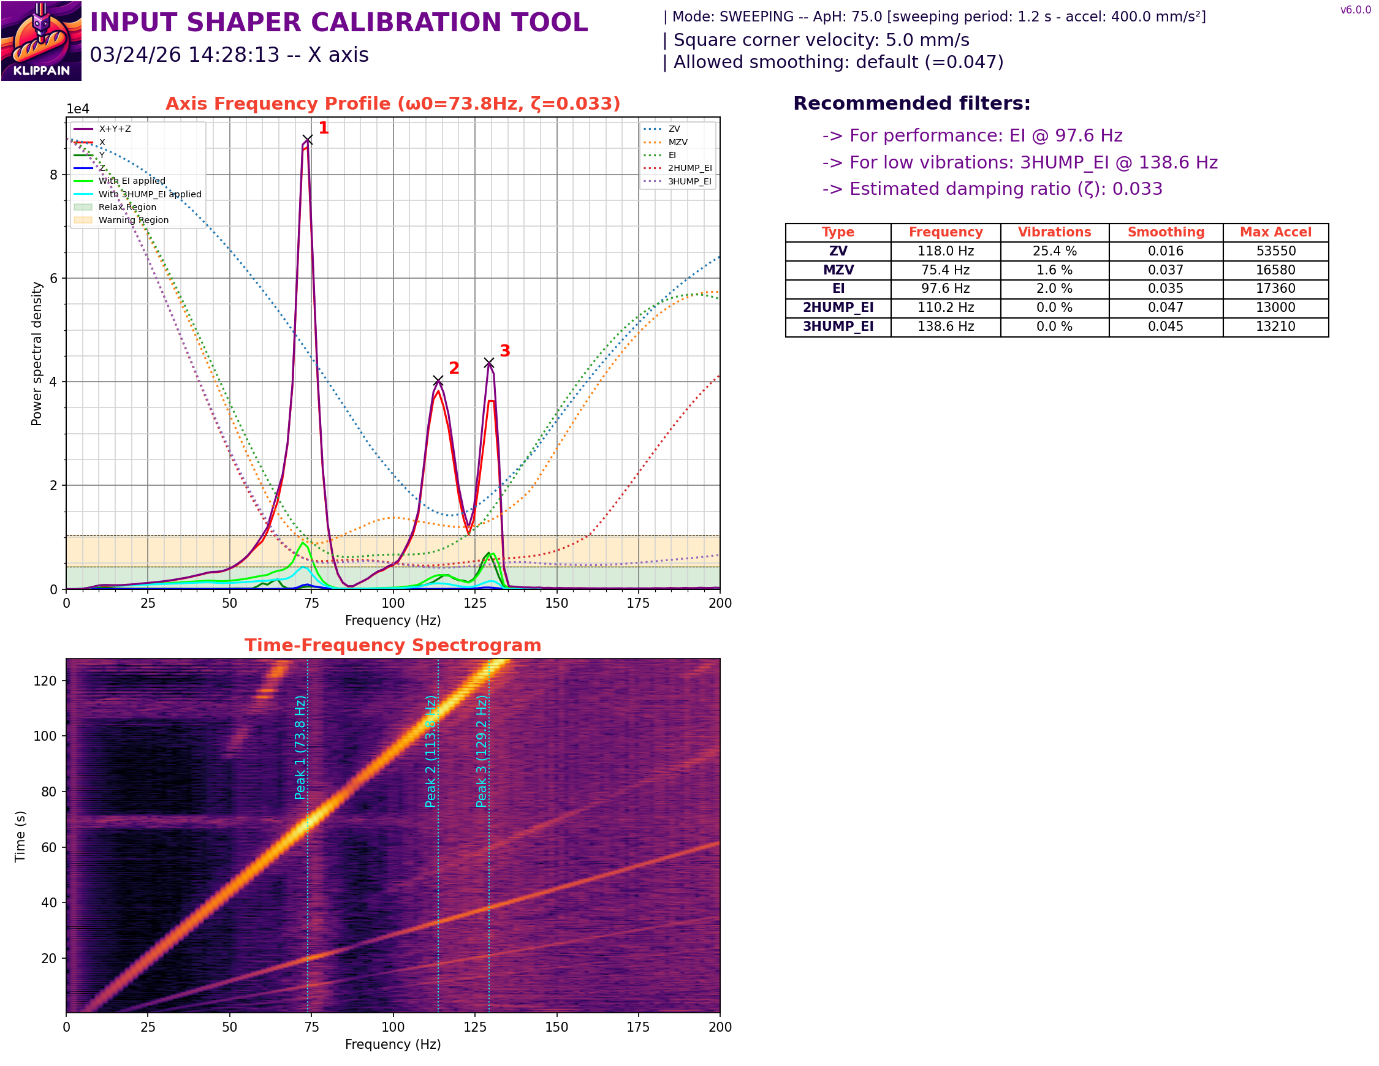
Конфигурационные файлы/Серийные/SN334/config/ShakeTune_results/input_shaper/inputshaper_20260324_142809_axis_X.png
