deflord/3def/Конфигурационные файлы/Серийные/SN338/config/ShakeTune_results/input_shaper/inputshaper_20260519_103750_axis_Y.png

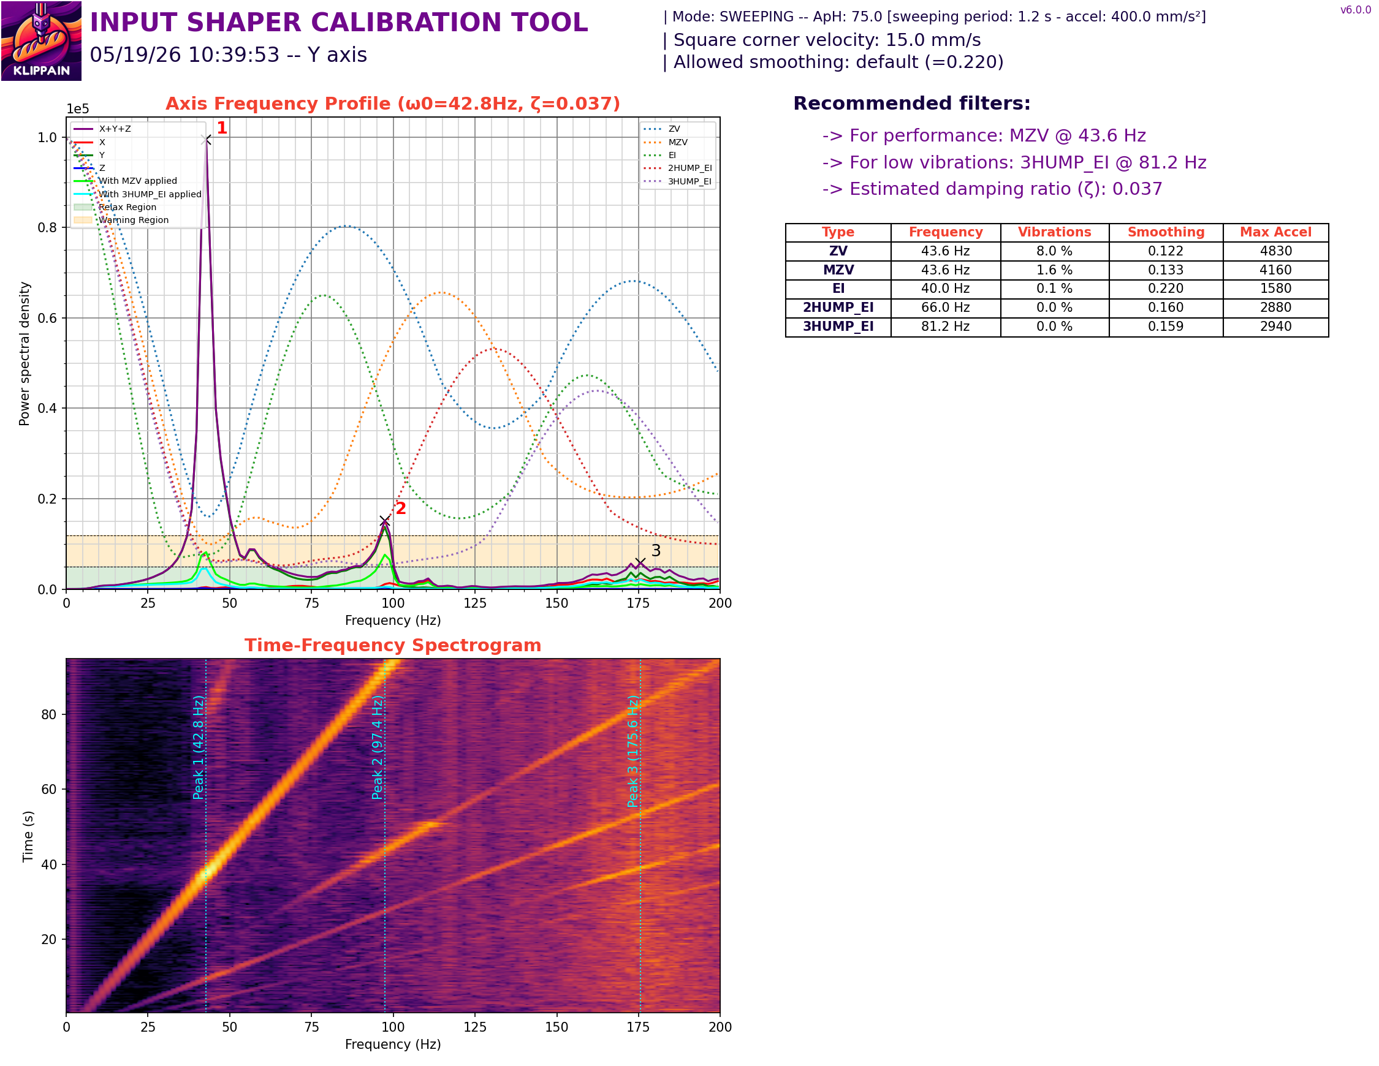
Конфигурационные файлы/Серийные/SN338/config/ShakeTune_results/input_shaper/inputshaper_20260519_103750_axis_Y.png
