deflord/3def/Конфигурационные файлы/Серийные/SN356/config/ShakeTune_results/input_shaper/inputshaper_20260925_165321_axis_X.png

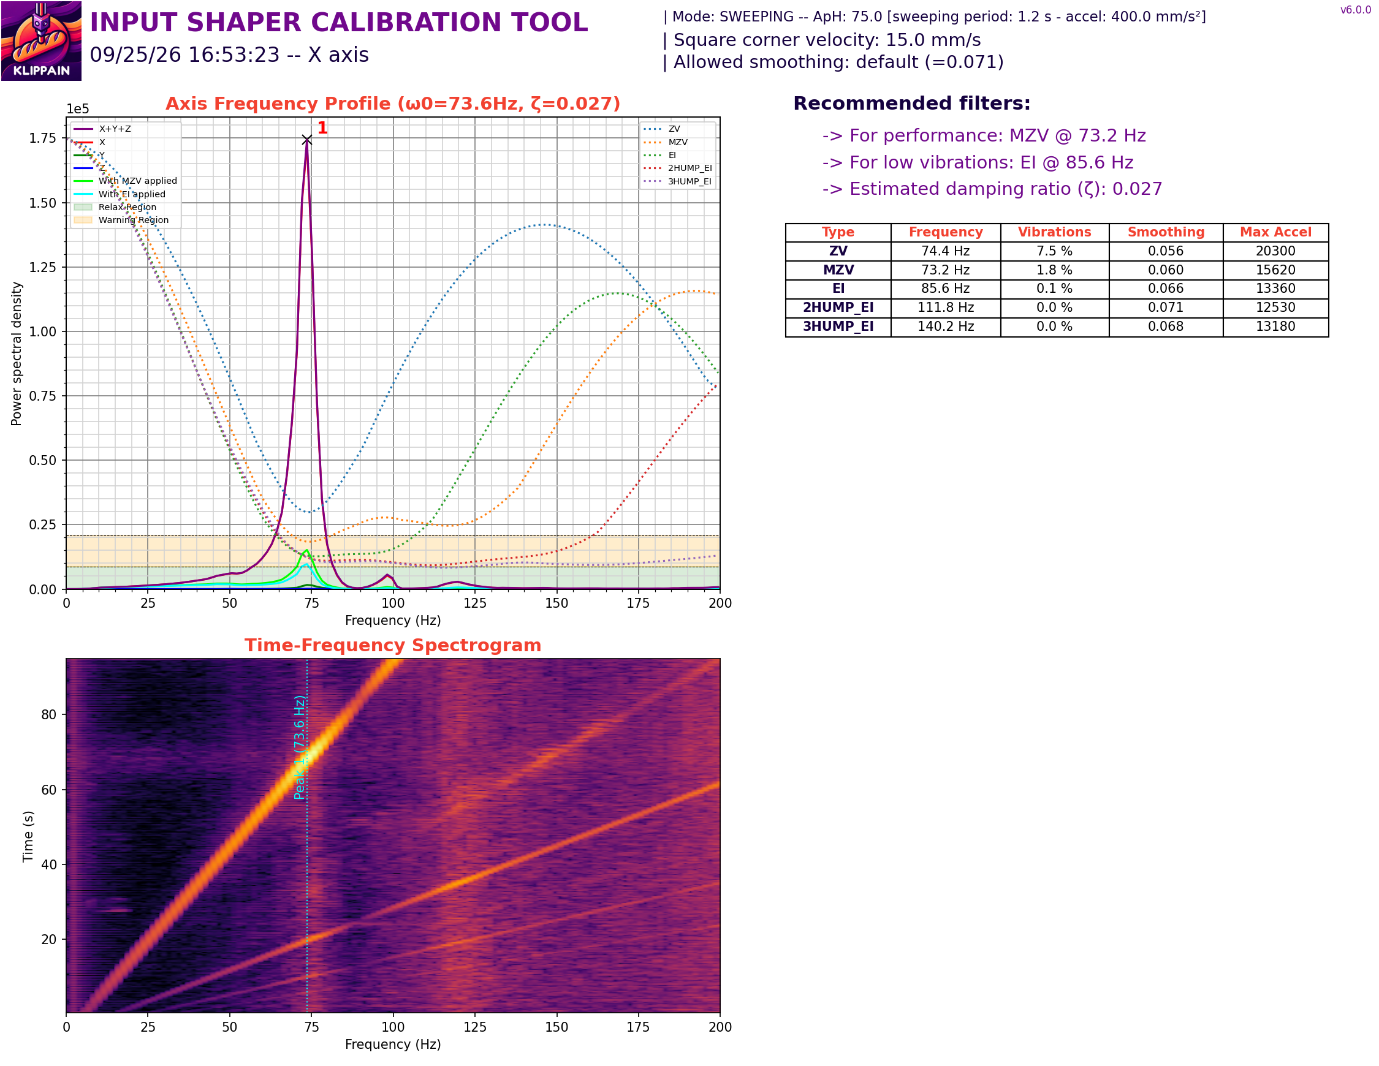
Конфигурационные файлы/Серийные/SN356/config/ShakeTune_results/input_shaper/inputshaper_20260925_165321_axis_X.png
