deflord/3def/Конфигурационные файлы/Серийные/SN338/config/mmu/base/mmu_hardware.cfg

########################################################################################################################
# Happy Hare MMU Software
#
# EDIT THIS FILE BASED ON YOUR SETUP
#
# Copyright (C) 2022-2026  moggieuk#6538 (discord)
#                          moggieuk@hotmail.com
# This file may be distributed under the terms of the GNU GPLv3 license.
#
# Goal: Happy Hare MMU hardware config file with config for unknown MCU board
#
# (\_/)
# ( *,*)
# (")_(") Happy Hare Ready
#
#
# Notes about setup of common external MCUs can be found here:
#  https://github.com/moggieuk/Happy-Hare/blob/main/doc/mcu_notes.md
# 
# Note about "touch" endstops: Happy Hare provides extremely flexible homing options using both single steppers or
# synced steppers. The "touch" option leverages stallguard and thus requires the appropriate 'diag_pin' and stallguard
# parameters set on the TMC driver section. If you have the diag_pin exposed, it is harmless to define this because
# they will only be used when explicitly needed and configured.
#
# Touch option for each stepper provides these benefits / possibilities (experimental):
#  - on extruder stepper allows for the automatic detection of the nozzle!
#  - on selector stepper allows for the automatic detection of filament stuck in the gate and subsequent recovery
#  - on gear stepper allows for the automatic detection of the extruder entrance
#
# In summary, "touch" homing with your MMU is an advanced option that requires patience and careful tuning. Everything
# works with regular endstops and there are workaround options for certain homing points (like extruder entry) in
# the absence of any endstop. I'm really interested in creative setups. Ping me on Discord (moggieuk#6538)
#
# See 'mmu.cfg' for serial definition and pins aliases
#
# HOMING CAPABLE EXTRUDER (VERY ADVANCED) -----------------------------------------------------------------------------
# With Happy Hare installed even the extruder can be homed. You will find the usual 'endstop' parameters can be added
# to your '[extruder]' section.  Useless you have some clever load cell attached to your nozzle it only really makes
# sense to configure stallguard style "touch" homing. To do this add lines similar to this to your existing
# '[extruder]' definition in printer.cfg.
#
#    [extruder]
#    endstop_pin: tmc2209_extruder:virtual_endstop
#
# Also be sure to add the appropriate stallguard config to the TMC section, e.g.
#
#    [tmc2209 extruder]
#    diag_pin: E_DIAG		# Set to MCU pin connected to TMC DIAG pin for extruder
#    driver_SGTHRS: 100		# 255 is most sensitive value, 0 is least sensitive
#
# Happy Hare will take care of the rest and add a 'mmu_ext_touch' endstop automatically
#


# MMU MACHINE / TYPE ---------------------------------------------------------------------------------------------------
# ███╗   ███╗███╗   ███╗██╗   ██╗    ███╗   ███╗ █████╗  ██████╗██╗  ██╗██╗███╗   ██╗███████╗
# ████╗ ████║████╗ ████║██║   ██║    ████╗ ████║██╔══██╗██╔════╝██║  ██║██║████╗  ██║██╔════╝
# ██╔████╔██║██╔████╔██║██║   ██║    ██╔████╔██║███████║██║     ███████║██║██╔██╗ ██║█████╗  
# ██║╚██╔╝██║██║╚██╔╝██║██║   ██║    ██║╚██╔╝██║██╔══██║██║     ██╔══██║██║██║╚██╗██║██╔══╝  
# ██║ ╚═╝ ██║██║ ╚═╝ ██║╚██████╔╝    ██║ ╚═╝ ██║██║  ██║╚██████╗██║  ██║██║██║ ╚████║███████╗
# ╚═╝     ╚═╝╚═╝     ╚═╝ ╚═════╝     ╚═╝     ╚═╝╚═╝  ╚═╝ ╚═════╝╚═╝  ╚═╝╚═╝╚═╝  ╚═══╝╚══════╝
[mmu_machine]

# Number of selectable gate on (each) MMU. Generally this is a single number, but with multi-mmu (type-B) setups
# it can be a comma separated list of the number of gates per unit.
# E.g. 'num_gates: 4,4,2' for a 2xBox Turtle and 1xNight Owl multiplexed setup
#
num_gates: 4

# MMU Vendor & Version is used to automatically configure some parameters and validate configuration
# If custom set to "Other" and uncomment the additional parameters below
#
# ERCF          1.1  add "s" suffix for Springy, "b" for Binky, "t" for Triple-Decky
#                    e.g. "1.1sb" for v1.1 with Springy mod and Binky encoder
# ERCF          2.0  community edition ERCFv2
# ERCF          3.0  community edition ERCFv3
# Tradrack      1.0  add "e" if encoder is fitted (assumed to be Binky)
# AngryBeaver
# BoxTurtle
# NightOwl
# 3MS
# QuattroBox    1.0
# QuattroBox    2.0  revised LEDs
# 3D Chameleon
# Pico
# MMX
# BTT ViViD
# KMS
# EMU
# Prusa         3.0  NOT YET SUPPORTED - COMING SOON
# Other              Generic setup that may require further customization of 'cad' parameters. See doc in mmu_parameters.cfg
#
mmu_vendor: QuattroBox			# MMU family
mmu_version: 1.2			# MMU hardware version number (add mod suffix documented above)

# The following attributes are set internally from vendor/version above. Only uncomment to customize the vendor
# default or for custom ("Other") designs
#
#selector_type: VirtualSelector		# E.g. LinearServoSelector (type-A), VirtualSelector (type-B), MacroSelector, RotarySelector, ...
#variable_bowden_lengths: 0		# 1 = If MMU design has different bowden lengths per gate, 0 = bowden length is the same
#variable_rotation_distances: 1		# 1 = If MMU design has dissimilar drive/BMG gears, thus rotation distance, 0 = One drive gear (e.g. Tradrack)
# require_bowden_move: 1			# 1 = If MMU design has bowden move that is included in load/unload, 0 = zero length bowden (skip bowden move)
#filament_always_gripped: 1		# 1 = Filament is always trapped by MMU (most type-B designs), 0 = MMU can release filament
#has_bypass: 0				# 1 = Integrated bypass gate available, 0 = No integrated bypass; Bypassing only possible via PTFE

homing_extruder: 1			# CAUTION: Normally this should be 1. 0 will disable the homing extruder capability

# Uncomment to change the display name in UI's.  Defaults to the vendor name
#display_name: My Precious

# Full name of environment sensor object for MMU filament storage (displays temp and humidity in UI).
# Leave empty if sensor is not fitted. Polls for "temperature" and "humidity"
# E.g. If you have a section like this: [temperature_sensor MMU_enclosure]
#      Set: environment_sensor: temperature_sensor MMU_enclosure
environment_sensor:

# Full name of filament heater object. Leave empty if heater is not fitted
# E.g. If you have a section like this: [heater_generic MMU_heater]
#      Set: filament_heater: heater_generic MMU_heater
filament_heater:

# PER-GATE heaters and environment sensors. Some modular MMU designs have per-gate control (e.g. EMU). For this type of MMU, leave
# 'environment_sensor' and 'filament_heater' empty and define a list of heaters and sensors here. Note the length of the list must
# match the number of gates. Leave this settings empty if defining a single sensor/heater.
environment_sensors:                    # Comma separated list of full environment sensor object names
filament_heaters:                       # Comma separated list of full heater object names
max_concurrent_heaters: 1               # Limit the number of simultaneously active heaters (power/PSU protection)


# FILAMENT DRIVE GEAR STEPPER(S)  --------------------------------------------------------------------------------------
#  ██████╗ ███████╗ █████╗ ██████╗ 
# ██╔════╝ ██╔════╝██╔══██╗██╔══██╗
# ██║  ███╗█████╗  ███████║██████╔╝
# ██║   ██║██╔══╝  ██╔══██║██╔══██╗
# ╚██████╔╝███████╗██║  ██║██║  ██║
#  ╚═════╝ ╚══════╝╚═╝  ╚═╝╚═╝  ╚═╝
# Note that 'toolhead' & 'mmu_gear' endstops will automatically be added if a toolhead sensor or gate sensor is defined
#
# The default values are tested with the ERCF BOM NEMA14 motor. Please adapt these values to the motor you are using
# Example : for NEMA17 motors, you'll usually use higher current
#
[tmc2209 stepper_mmu_gear]
uart_pin: mmu:MMU_GEAR_UART
run_current: 1.1			# ERCF BOM NEMA14 motor
hold_current: 0.2			# Recommend to be small if not using "touch" or move (TMC stallguard)
interpolate: False
sense_resistor: 0.110			# Usually 0.11, 0.15 for BTT TMC2226
stealthchop_threshold: 0		# Spreadcycle has more torque and better at speed
#
# Uncomment two lines below if you have TMC and want the ability to use filament "touch" homing with gear stepper
#diag_pin: ^mmu:MMU_GEAR_DIAG		# Set to MCU pin connected to TMC DIAG pin for gear stepper
#driver_SGTHRS: 60			# 255 is most sensitive value, 0 is least sensitive

[stepper_mmu_gear]
step_pin: mmu:MMU_GEAR_STEP
dir_pin: !mmu:MMU_GEAR_DIR
enable_pin: !mmu:MMU_GEAR_ENABLE
rotation_distance: 23.25		# Bondtech 5mm Drive Gears. Overridden by 'mmu_gear_rotation_distance' in mmu_vars.cfg
gear_ratio: 1:1			# E.g. ERCF 80:20, Tradrack 50:17
microsteps: 16 				# Recommend 16. Increase only if you "step compress" issues when syncing
full_steps_per_rotation: 200		# 200 for 1.8 degree, 400 for 0.9 degree
#
# Uncomment the two lines below to enable filament "touch" homing option with gear motor
#extra_endstop_pins: tmc2209_stepper_mmu_gear:virtual_endstop
#extra_endstop_names: mmu_gear_touch

# ADDITIONAL FILAMENT DRIVE GEAR STEPPERS FOR TYPE-B MMU's -------------------------------------------------------------
# Note that common parameters are inherited from base stepper_mmu_gear, but can be uniquely specified here too
#
# Filament Drive Gear_1 --------------------------
[tmc2209 stepper_mmu_gear_1]
uart_pin: mmu:MMU_GEAR_UART_1

[stepper_mmu_gear_1]
step_pin: mmu:MMU_GEAR_STEP_1
dir_pin: !mmu:MMU_GEAR_DIR_1
enable_pin: !mmu:MMU_GEAR_ENABLE_1

# Filament Drive Gear_2 --------------------------
[tmc2209 stepper_mmu_gear_2]
uart_pin: mmu:MMU_GEAR_UART_2

[stepper_mmu_gear_2]
step_pin: mmu:MMU_GEAR_STEP_2
dir_pin: mmu:MMU_GEAR_DIR_2
enable_pin: !mmu:MMU_GEAR_ENABLE_2

# Filament Drive Gear_3 --------------------------
[tmc2209 stepper_mmu_gear_3]
uart_pin: mmu:MMU_GEAR_UART_3

[stepper_mmu_gear_3]
step_pin: mmu:MMU_GEAR_STEP_3
dir_pin: mmu:MMU_GEAR_DIR_3
enable_pin: !mmu:MMU_GEAR_ENABLE_3



# SERVOS ---------------------------------------------------------------------------------------------------------------
# ███████╗███████╗██████╗ ██╗   ██╗ ██████╗ ███████╗
# ██╔════╝██╔════╝██╔══██╗██║   ██║██╔═══██╗██╔════╝
# ███████╗█████╗  ██████╔╝██║   ██║██║   ██║███████╗
# ╚════██║██╔══╝  ██╔══██╗╚██╗ ██╔╝██║   ██║╚════██║
# ███████║███████╗██║  ██║ ╚████╔╝ ╚██████╔╝███████║
# ╚══════╝╚══════╝╚═╝  ╚═╝  ╚═══╝   ╚═════╝ ╚══════╝
# Basic servo PWM setup. If these values are changed then the angles defined for different positions will also change
#
# OPTIONAL GANTRY SERVO FOR TOOLHEAD FILAMENT CUTTER ------------------------------------------------------------------
#
# (uncomment this section if you have a gantry servo for toolhead cutter pin)
#[mmu_servo mmu_gantry_servo]
#pin: 
#maximum_servo_angle:180
#minimum_pulse_width: 0.00075
#maximum_pulse_width: 0.00225
#initial_angle: 180


# FILAMENT SENSORS -----------------------------------------------------------------------------------------------------
# ███████╗███████╗███╗   ██╗███████╗ ██████╗ ██████╗ ███████╗
# ██╔════╝██╔════╝████╗  ██║██╔════╝██╔═══██╗██╔══██╗██╔════╝
# ███████╗█████╗  ██╔██╗ ██║███████╗██║   ██║██████╔╝███████╗
# ╚════██║██╔══╝  ██║╚██╗██║╚════██║██║   ██║██╔══██╗╚════██║
# ███████║███████╗██║ ╚████║███████║╚██████╔╝██║  ██║███████║
# ╚══════╝╚══════╝╚═╝  ╚═══╝╚══════╝ ╚═════╝ ╚═╝  ╚═╝╚══════╝
# Define the pins for optional sensors in the filament path. All but the pre-gate sensors will be automatically setup as
# both endstops (for homing) and sensors for visibility purposes.
#
# 'pre_gate_switch_pin_X'  .. 'mmu_pre_gate_X' sensor detects filament at entry to MMU. X=gate number (0..N)
# 'gate_switch_pin'        .. 'mmu_gate' shared sensor detects filament past the gate of the MMU
#     or
# 'post_gear_switch_pin_X' .. 'mmu_gear_X' post gear sensor for each filament
# 'extruder_switch_pin'    .. 'extruder' sensor detects filament just before the extruder entry
# 'toolhead_switch_pin'    .. 'toolhead' sensor detects filament after extruder entry
#
# Sync motor feedback will typically have a tension switch (most important for syncing) or both tension and compression.
# Note that compression switch is useful for use as a endstop to detect hitting the extruder entrance
# 'sync_feedback_tension_pin'     .. pin for switch activated when filament is under tension
# 'sync_feedback_compression_pin' .. pin for switch activated when filament is under compression
#
# Configuration is flexible: Simply define pins for any sensor you want to enable, if pin is not set (or the alias is empty)
# it will be ignored. You can also just comment out what you are not using.
#
[mmu_sensors]
pre_gate_switch_pin_0: ^mmu:MMU_PRE_GATE_0
pre_gate_switch_pin_1: ^mmu:MMU_PRE_GATE_1
pre_gate_switch_pin_2: ^mmu:MMU_PRE_GATE_2
pre_gate_switch_pin_3: ^mmu:MMU_PRE_GATE_3
pre_gate_switch_pin_4: ^mmu:MMU_PRE_GATE_4
pre_gate_switch_pin_5: ^mmu:MMU_PRE_GATE_5
pre_gate_switch_pin_6: ^mmu:MMU_PRE_GATE_6
pre_gate_switch_pin_7: ^mmu:MMU_PRE_GATE_7
pre_gate_switch_pin_8: ^mmu:MMU_PRE_GATE_8
pre_gate_switch_pin_9: ^mmu:MMU_PRE_GATE_9
pre_gate_switch_pin_10: ^mmu:MMU_PRE_GATE_10
pre_gate_switch_pin_11: ^mmu:MMU_PRE_GATE_11

post_gear_switch_pin_0: ^mmu:MMU_POST_GEAR_0
post_gear_switch_pin_1: ^mmu:MMU_POST_GEAR_1
post_gear_switch_pin_2: ^mmu:MMU_POST_GEAR_2
post_gear_switch_pin_3: ^mmu:MMU_POST_GEAR_3
post_gear_switch_pin_4: ^mmu:MMU_POST_GEAR_4
post_gear_switch_pin_5: ^mmu:MMU_POST_GEAR_5
post_gear_switch_pin_6: ^mmu:MMU_POST_GEAR_6
post_gear_switch_pin_7: ^mmu:MMU_POST_GEAR_7
post_gear_switch_pin_8: ^mmu:MMU_POST_GEAR_8
post_gear_switch_pin_9: ^mmu:MMU_POST_GEAR_9
post_gear_switch_pin_10: ^mmu:MMU_POST_GEAR_10
post_gear_switch_pin_11: ^mmu:MMU_POST_GEAR_11

# These sensors can be replicated in a multi-mmu, type-B setup (see num_gates comment).
# If so, then use a comma separated list of per-unit pins instead of single pin
#
# gate_switch_pin: ^mmu:MMU_GATE_SENSOR
sync_feedback_tension_pin: mmu:PD9
sync_feedback_compression_pin: mmu:PA10

# Proportional sync feedback sensor configuration. Leave empty if not fitted.
# (if you have a proportional sensor the sync_feedback_tension_pin and sync_feedback_compression_pin would likely be empty)
#
# sync_feedback_analog_pin: 			# The ADC pin where the proportional filament pressure sensor is installed
# sync_feedback_analog_max_compression: 1		# Raw sensor reading at max filament compression (buffer squeezed)
# sync_feedback_analog_max_tension: 0		# Raw sensor reading at max filament tension (buffer expanded)
# sync_feedback_analog_neutral_point: 0.50	# Biasing of neutral point (sensor value 0). Normally close to 0.5

# These sensors are on the toolhead and often controlled by the main printer mcu
#
extruder_switch_pin: PG3 
toolhead_switch_pin: 


# ENCODER -------------------------------------------------------------------------------------------------------------
# ███████╗███╗   ██╗ ██████╗ ██████╗ ██████╗ ███████╗██████╗ 
# ██╔════╝████╗  ██║██╔════╝██╔═══██╗██╔══██╗██╔════╝██╔══██╗
# █████╗  ██╔██╗ ██║██║     ██║   ██║██║  ██║█████╗  ██████╔╝
# ██╔══╝  ██║╚██╗██║██║     ██║   ██║██║  ██║██╔══╝  ██╔══██╗
# ███████╗██║ ╚████║╚██████╗╚██████╔╝██████╔╝███████╗██║  ██║
# ╚══════╝╚═╝  ╚═══╝ ╚═════╝ ╚═════╝ ╚═════╝ ╚══════╝╚═╝  ╚═╝
# Encoder measures distance, monitors for runout and clogging and constantly calculates % flow rate
# Note that the encoder_resolution set here is purely a default to get started. It will be correcly set after calibration
# with the value stored in mmu_vars.cfg
#
# The encoder resolution will be calibrated but it needs a default approximation 
# If BMG gear based:
#   resolution = bmg_circumfrance / (2 * teeth)
# 24 / (2 * 17) = 0.7059 for TRCT5000 based sensor
# 24 / (2 * 12) = 1.0 for Binky with 12 tooth disc
#
[mmu_encoder mmu_encoder]
encoder_pin: ^mmu:MMU_ENCODER
encoder_resolution: 1.0			# This is just a starter value. Overriden by calibrated 'mmu_encoder_resolution' in mmm_vars.cfg
desired_headroom: 5.0			# The clog/runout headroom that MMU attempts to maintain (closest point to triggering runout)
average_samples: 4			# The "damping" effect of last measurement (higher value means slower automatic clog_length reduction)
flowrate_samples: 20			# How many "movements" of the extruder to measure average flowrate over


# ESPOOLER (OPTIONAL) -------------------------------------------------------------------------------------------------
# ███████╗███████╗██████╗  ██████╗  ██████╗ ██╗     ███████╗██████╗
# ██╔════╝██╔════╝██╔══██╗██╔═══██╗██╔═══██╗██║     ██╔════╝██╔══██╗
# █████╗  ███████╗██████╔╝██║   ██║██║   ██║██║     █████╗  ██████╔╝
# ██╔══╝  ╚════██║██╔═══╝ ██║   ██║██║   ██║██║     ██╔══╝  ██╔══██╗
# ███████╗███████║██║     ╚██████╔╝╚██████╔╝███████╗███████╗██║  ██║
# ╚══════╝╚══════╝╚═╝      ╚═════╝  ╚═════╝ ╚══════╝╚══════╝╚═╝  ╚═╝
#
# An espooler controls DC motors (typically N20) that are able to rewind a filament spool and optionally provide
# forward assist to overcome spooler rotation friction. This should define pins for each of the gates on your mmu
# starting with '_0'. 
# An empty pin can be deleted, commented or simply left blank. If you mcu has a separate "enable" pin
#
#[mmu_espooler mmu_espooler]
#pwm: 1                                          # 1=PWM control (typical), 0=digital on/off control
#hardware_pwm: 0                                # See klipper doc
#cycle_time: 0.100                              # See klipper doc
#scale: 1                                        # Scales the PWM output range
#value: 0					# See klipper doc
#shutdown_value: 0				# See klipper doc

#respool_motor_pin_0: mmu:MMU_ESPOOLER_RWD_0	# PWM (or digital) pin for rewind/respool movement
#assist_motor_pin_0: mmu:MMU_ESPOOLER_FWD_0	# PWM (or digital) pin for forward motor movement
#enable_motor_pin_0: mmu:MMU_ESPOOLER_EN_0	# Digital output for Afc mcu
#assist_trigger_pin_0: mmu:MMU_ESPOOLER_TRIG_0	# Trigger pin for sensing need to assist during print

#respool_motor_pin_1: mmu:MMU_ESPOOLER_RWD_1
#assist_motor_pin_1: mmu:MMU_ESPOOLER_FWD_1
#enable_motor_pin_1: mmu:MMU_ESPOOLER_EN_1
#assist_trigger_pin_1: mmu:MMU_ESPOOLER_TRIG_1

#respool_motor_pin_2: mmu:MMU_ESPOOLER_RWD_2
#assist_motor_pin_2: mmu:MMU_ESPOOLER_FWD_2
#enable_motor_pin_2: mmu:MMU_ESPOOLER_EN_2
#assist_trigger_pin_2: mmu:MMU_ESPOOLER_TRIG_2

#respool_motor_pin_3: mmu:MMU_ESPOOLER_RWD_3
#assist_motor_pin_3: mmu:MMU_ESPOOLER_FWD_3
#enable_motor_pin_3: mmu:MMU_ESPOOLER_EN_3
#assist_trigger_pin_3: mmu:MMU_ESPOOLER_TRIG_3


# MMU OPTIONAL NEOPIXEL LED SUPPORT ------------------------------------------------------------------------------------
# ██╗     ███████╗██████╗ ███████╗
# ██║     ██╔════╝██╔══██╗██╔════╝
# ██║     █████╗  ██║  ██║███████╗
# ██║     ██╔══╝  ██║  ██║╚════██║
# ███████╗███████╗██████╔╝███████║
# ╚══════╝╚══════╝╚═════╝ ╚══════╝
# Define the led connection, type and length
#
# (comment out this section if you don't have leds or have them defined elsewhere)
[neopixel mmu_leds]
pin: mmu:MMU_NEOPIXEL
chain_count: 36			# Need number gates x1 or x2 + status leds
color_order: GRBW,GRBW,GRBW,GRBW,GRBW,GRBW,GRBW,GRBW,GRB,GRB,GRB,GRB,GRB,GRB,GRB,GRB,GRB,GRB,GRB,GRB,GRB,GRB,GRB,GRB,GRB,GRB,GRB,GRB,GRB,GRB,GRB,GRB,GRB,GRB,GRB,GRB		# Set based on your particular neopixel specification (can be comma separated list)

# MMU LED EFFECT SEGMENTS ----------------------------------------------------------------------------------------------
# Define neopixel LEDs for your MMU. The chain_count must be large enough for your desired ranges:
#   exit   .. this set of LEDs, one for every gate, usually would be mounted at the exit point of the gate
#   entry  .. this set of LEDs, one for every gate, could be mounted at the entry point of filament into the MMU/buffer
#   status .. these LED. represents the status of the MMU (and selected filament). More than one status LED is possible
#   logo   .. these LEDs don't change during operation and are designed for driving a logo. More than one logo LED is possible
#
# Note that all sets are optional. You can opt to just have the 'exit' set for example. The advantage to having
# both entry and exit LEDs is, for example, so that 'entry' can display gate status while 'exit' displays the color
# 
# LED's are indexed in the chain from 1..N. Thus to set up LED's on 'exit' and a single 'status' LED on a 4 gate MMU:
#
#    exit_leds:   neopixel:mmu_leds (1,2,3,4)
#    status_leds: neopixel:mmu_leds (5)
#
# In this example no 'entry' set is configured. Note that constructs like "mmu_leds (1-3,4)" are also valid
#
# The range is completely flexible and can be comprised of different led strips, individual LEDs, or combinations of
# both on different pins. In addition, the ordering is flexible based on your wiring, thus (1-4) and (4-1) both represent
# the same LED range but mapped to increasing or decreasing gates respectively. E.g if you have two Box Turtle MMUs, one
# with a chain of LEDs wired in reverse order and another with individual LEDs, to define 8 exit LEDs:
#
#   exit_leds: neopixel:bt_1 (4-1)
#              neopixel:bt_2a
#              neopixel:bt_2b
#              neopixel:bt_2c
#              neopixel:bt_2d
#
# Note the use of separate lines for each part of the definition,
#
# ADVANCED: Happy Hare provides a convenience wrapper [mmu_led_effect] that not only creates an effect on each of the
# [mmu_leds unit0] specified segments as a whole but also each individual LED for atomic control. See mmu_leds.cfg for examples
#
# (comment out this whole section if you don't have/want leds; uncomment/edit LEDs fitted on your MMU)
[mmu_leds unit0]
exit_leds:   neopixel:mmu_leds (2,4,6,8)
entry_leds:  neopixel:mmu_leds (1,3,5,7)
status_leds: neopixel:mmu_leds (9-36)
#logo_leds:   neopixel:mmu_leds (36)
frame_rate: 24

# Default effects for LED segments when not providing action status
#    off              - LED's off
#    on               - LED's white
#    gate_status      - indicate gate availability / status            (printer.mmu.gate_status)
#    filament_color   - display filament color defined in gate map     (printer.mmu.gate_color_rgb)
#    slicer_color     - display slicer defined set color for each gate (printer.mmu.slicer_color_rgb)
#   (r,g,b)           - display static r,g,b color e.g. "0,0,0.3" for dim blue
#    _effect_         - display the named led effect
#
enabled: True                           # True = LEDs are enabled at startup (MMU_LED can control), False = Disabled
animation: True                         # True = Use led-animation-effects, False = Static LEDs
exit_effect: gate_status                #    off|gate_status|filament_color|slicer_color|r,g,b|_effect_
entry_effect: filament_color            #    off|gate_status|filament_color|slicer_color|r,g,b|_effect_
status_effect: filament_color           # on|off|gate_status|filament_color|slicer_color|r,g,b|_effect_
logo_effect: (0, 0, 0.3)                #    off                                        |r,g,b|_effect_
white_light: (1, 1, 1)                  # RGB color for static white light
black_light: (.01, 0, .02)              # RGB color used to represent "black" (filament)
empty_light: (0, 0, 0)                  # RGB color used to represent empty gate

# Default effects (animation: True) / static rbg (animation False) to apply to actions
#   effect_name, (r,b,g)
#
# IMPORTANT: Effects must be from [mmu_led_effects] set defined in mmu_leds.cfg
#
effect_loading:            mmu_blue_clockwise_slow, (0, 0, 0.4)
effect_loading_extruder:   mmu_blue_clockwise_fast, (0, 0, 1)
effect_unloading:          mmu_blue_anticlock_slow, (0, 0, 0.4)
effect_unloading_extruder: mmu_blue_anticlock_fast, (0, 0, 1)
effect_heating:            mmu_breathing_red,       (0.3, 0, 0)
effect_selecting:          mmu_white_fast,          (0.2, 0.2, 0.2)
effect_checking:           mmu_white_fast,          (0.8, 0.8, 0.8)
effect_initialized:        mmu_rainbow,             (0.5, 0.2, 0)
effect_error:              mmu_strobe,              (1, 0, 0)
effect_complete:           mmu_sparkle,             (0.3, 0.3, 0.3)
effect_gate_selected:      mmu_static_blue,         (0, 0, 1)
effect_gate_available:     mmu_static_green,        (0, 0.5, 0)
effect_gate_available_sel: mmu_ready_green,         (0, 0.75, 0)
effect_gate_unknown:       mmu_static_orange,       (0.5, 0.2, 0)
effect_gate_unknown_sel:   mmu_ready_orange ,       (0.75, 0.3, 0)
effect_gate_empty:         mmu_static_black,        (0, 0, 0)
effect_gate_empty_sel:     mmu_ready_blue,          (0, 0, 0.2)

# Default effects for LED segments when not providing action status
#    off              - LED's off
#    on               - LED's white
#    gate_status      - indicate gate availability / status            (printer.mmu.gate_status)
#    filament_color   - display filament color defined in gate map     (printer.mmu.gate_color_rgb)
#    slicer_color     - display slicer defined set color for each gate (printer.mmu.slicer_color_rgb)
#   (r,g,b)           - display static r,g,b color e.g. "0,0,0.3" for dim blue
#    _effect_         - display the named led effect
#
enabled: True				# True = LEDs are enabled at startup (MMU_LED can control), False = Disabled
animation: True				# True = Use led-animation-effects, False = Static LEDs
exit_effect: gate_status		#    off|gate_status|filament_color|slicer_color|r,g,b|_effect_
entry_effect: filament_color		#    off|gate_status|filament_color|slicer_color|r,g,b|_effect_
status_effect: filament_color		# on|off|gate_status|filament_color|slicer_color|r,g,b|_effect_
logo_effect: (0, 0, 0.3)		#    off                                        |r,g,b|_effect_
white_light: (1, 1, 1)			# RGB color for static white light
black_light: (.01, 0, .02)		# RGB color used to represent "black" (filament)
empty_light: (0, 0, 0)			# RGB color used to represent empty gate

# Default effects (animation: True) / static rbg (animation False) to apply to actions
#   effect_name, (r,b,g)
#
# IMPORTANT: Effects must be from [mmu_led_effects] set defined in mmu_leds.cfg
#
effect_loading:            mmu_blue_clockwise_slow, (0, 0, 0.4)
effect_loading_extruder:   mmu_blue_clockwise_fast, (0, 0, 1)
effect_unloading:          mmu_blue_anticlock_slow, (0, 0, 0.4)
effect_unloading_extruder: mmu_blue_anticlock_fast, (0, 0, 1)
effect_heating:            mmu_breathing_red,       (0.3, 0, 0)
effect_selecting:          mmu_white_fast,          (0.2, 0.2, 0.2)
effect_checking:           mmu_white_fast,          (0.8, 0.8, 0.8)
effect_initialized:        mmu_rainbow,             (0.5, 0.2, 0)
effect_error:              mmu_strobe,              (1, 0, 0)
effect_complete:           mmu_sparkle,             (0.3, 0.3, 0.3)
effect_gate_selected:      mmu_static_blue,         (0, 0, 1)
effect_gate_available:     mmu_static_green,        (0, 0.5, 0)
effect_gate_available_sel: mmu_ready_green,         (0, 0.75, 0)
effect_gate_unknown:       mmu_static_orange,       (0.5, 0.2, 0)
effect_gate_unknown_sel:   mmu_ready_orange,        (0.75, 0.3, 0)
effect_gate_empty:         mmu_static_black,        (0, 0, 0)
effect_gate_empty_sel:     mmu_ready_orange2,       (0.1, 0.04, 0)
