deflord/3def/Конфигурационные файлы/Серийные/SN349+QuattroBox/config/mmu/base/mmu_parameters_unit0.cfg

########################################################################################################################
# Happy Hare MMU Software
#
# Copyright (C) 2022-2025  moggieuk#6538 (discord)
#                          moggieuk@hotmail.com
#
# CONFIG AUTOMATICALLY CREATED FOR:
#    'unit0':
#    'QuattroBox v1.0' with 4 gates, running on a 'Unknown' mcu with 'VirtualSelector' kinematics
#
# EDIT THIS FILE BASED ON YOUR SETUP OR PREFERABLY RUN THIS AND USE MENUCONFIG:
#    ~/Happy-Hare/install.sh -i
#
# Goal: Main per-mmu unit configuration parameters
#
# Notes:
#   This is a per-unit configuration. Anything shared in is `mmu.cfg`
#   The shared macro configuration is specified separately in 'mmu_macro_vars.cfg'.
#   Full details in the Happy Hare wiki: https://github.com/moggieuk/Happy-Hare/wiki
#
# (\_/)
# ( *,*)
# (")_(") Happy Hare Ready
#
# This file may be distributed under the terms of the GNU GPLv3 license.
#


[mmu_unit_parameters unit0]

# Filament movement speeds -------------------------------------------------------------------------------------------
#  ██████╗ ███████╗ █████╗ ██████╗     ███████╗██████╗ ███████╗███████╗██████╗ ███████╗
# ██╔════╝ ██╔════╝██╔══██╗██╔══██╗    ██╔════╝██╔══██╗██╔════╝██╔════╝██╔══██╗██╔════╝
# ██║  ███╗█████╗  ███████║██████╔╝    ███████╗██████╔╝█████╗  █████╗  ██║  ██║███████╗
# ██║   ██║██╔══╝  ██╔══██║██╔══██╗    ╚════██║██╔═══╝ ██╔══╝  ██╔══╝  ██║  ██║╚════██║
# ╚██████╔╝███████╗██║  ██║██║  ██║    ███████║██║     ███████╗███████╗██████╔╝███████║
#  ╚═════╝ ╚══════╝╚═╝  ╚═╝╚═╝  ╚═╝    ╚══════╝╚═╝     ╚══════╝╚══════╝╚═════╝ ╚══════╝
#
# MOVEMENT SPEEDS: Long moves are faster than the small ones and used for the bulk of the bowden movement.
#
gear_load_speed             : 100		# mm/s Speed when loading filament
gear_load_accel             : 100		# Acceleration when loading

# Unloading speed defaults to the load speed but can be tuned if you have a rewinder system that imposes additional limits.
gear_unload_speed           : 80		# mm/s Use (lower) speed when unloading filament (defaults to "load" speed)
gear_unload_accel           : 100		# Acceleration when unloading filament (defaults to "load" accel)

gear_homing_speed           : 80		# mm/s Speed of gear stepper only homing moves (e.g. homing to gate or extruder)

virtual_sensor_homing_speed : 15		# mm/s Speed of gear stepper when homing to virtual sensor/endstop

gear_short_move_speed       : 80		# mm/s Speed when making short moves (including incremental retracts with encoder)
gear_short_move_accel       : 400		# Usually the same as gear_from_buffer_accel (for short movements)
gear_short_move_threshold   : 70		# Move distance that controls application of 'short_move' speed/accel


# Gate loading/unloading ---------------------------------------------------------------------------------------------
#  ██████╗  █████╗ ████████╗███████╗    ██╗      ██████╗  █████╗ ██████╗
# ██╔════╝ ██╔══██╗╚══██╔══╝██╔════╝    ██║     ██╔═══██╗██╔══██╗██╔══██╗
# ██║  ███╗███████║   ██║   █████╗      ██║     ██║   ██║███████║██║  ██║
# ██║   ██║██╔══██║   ██║   ██╔══╝      ██║     ██║   ██║██╔══██║██║  ██║
# ╚██████╔╝██║  ██║   ██║   ███████╗    ███████╗╚██████╔╝██║  ██║██████╔╝
#  ╚═════╝ ╚═╝  ╚═╝   ╚═╝   ╚══════╝    ╚══════╝ ╚═════╝ ╚═╝  ╚═╝╚═════╝
#
# GATE LOADING/UNLOADING: These settings control the loading and unloading filament at the gate which is the parking position
# inside the MMU. Typically this would be switch sensor but you can also use an encoder. Even with encoder the endstop can be
# a switch and the encoder used for move verifcation (see advanced 'gate_endstop_to_encoder' option). Note that the `encoder`
# method, due to the nature of its operation will overshoot a little. This is not a problem in practice because the overshoot
# will simply be compensated for in the subsequent move. A +ve parking distance moves towards the MMU, -ve moves back through
# the endstop towards the toolhead. If the MMU has multiple bowden tubes to the extruder then it is possible to home to the
# extruder sensor and avoid long bowden moves completely (see 'require_bowden_move' in mmu_hardware.cfg)
# ⚠️  Change from v3 .. the sign of gate_parking distance has reversed
#
# Possible gate_homing_endstop names:
#   encoder         - Detect filament position using movement of the encoder (if fitted)
#   mmu_shared_exit - Use common endstop on gate (type-A) or hub (type-B)
#   mmu_exit        - Use individual per-gate endstop (type-B MMU's)
#   extruder        - Use extruder entry sensor (required when [mmu_machine] require_bowden_move is 0)
#
# The 'preload_endstop' and associated parameters typically would be the same as 'gate_home_endstop' or '' which means the same.
# It can also be the gate-specific 'mmu_exit' sensor on type-B MMU's, or 'none' for an unverified fixed-distance preload.
# With 'none', preload_homing_max is the exact forward move; attempts, parking, and preload NFC motion are ignored, and the gate remains UNKNOWN.
#
gate_homing_endstop           : mmu_exit	# Name of gate endstop used for filament parking
gate_homing_max               : 200		# Maximum extra move distance to home (or actual move distance if encoder endstop)
gate_parking_distance         : -5		# ⚠️  Parking position relative to homing endstop. -ve=retraction, +ve=forward. Must be a retraction (<=0) unless endstop is mmu_exit

gate_preload_endstop          : mmu_exit		# Name of endstop used when preloading; blank inherits gate_homing_endstop, none uses a fixed move
gate_preload_homing_max       : 200		# Maximum homing distance, or exact fixed move distance when preload endstop is none
gate_preload_parking_distance : -10		# Parking position relative to preload endstop. Ignored with none; otherwise -ve=retraction, +ve=forward, and must be <=0 unless using mmu_exit
gate_preload_attempts         : 2		# How many attempts are made to pick up filament; ignored when preload endstop is none

gate_endstop_to_encoder       : 200		# Distance between gate endstop and encoder (IF both fitted. +ve if encoder after endstop)
gate_autoload                 : 1		# If mmu entry sensor fitted this controls the automatic loading of the gate
gate_final_eject_distance     : 200		# Additional distance to eject filament on MMU_EJECT to clear MMU's grip


# Bowden tube loading/unloading --------------------------------------------------------------------------------------
# ██████╗  ██████╗ ██╗    ██╗██████╗ ███████╗███╗   ██╗    ███╗   ███╗ ██████╗ ██╗   ██╗███████╗
# ██╔══██╗██╔═══██╗██║    ██║██╔══██╗██╔════╝████╗  ██║    ████╗ ████║██╔═══██╗██║   ██║██╔════╝
# ██████╔╝██║   ██║██║ █╗ ██║██║  ██║█████╗  ██╔██╗ ██║    ██╔████╔██║██║   ██║██║   ██║█████╗
# ██╔══██╗██║   ██║██║███╗██║██║  ██║██╔══╝  ██║╚██╗██║    ██║╚██╔╝██║██║   ██║╚██╗ ██╔╝██╔══╝
# ██████╔╝╚██████╔╝╚███╔███╔╝██████╔╝███████╗██║ ╚████║    ██║ ╚═╝ ██║╚██████╔╝ ╚████╔╝ ███████╗
# ╚═════╝  ╚═════╝  ╚══╝╚══╝ ╚═════╝ ╚══════╝╚═╝  ╚═══╝    ╚═╝     ╚═╝ ╚═════╝   ╚═══╝  ╚══════╝
#
# BOWDEN LOADING/UNLOADING: Settings that control filament movement in the bowden tube
#
bowden_homing_max                : 2000		# Maximum attempted bowden move (for calibration). Should be larger than your actual bowden!

# These are the reduction of the bowden move which occurs at a fast speed. In most designs it is important that the
# bowden move doesn't overshoot it's target to allow for slower homing to the endstop.
# Note that additional "extra" homing distance is defined in the gate and extruder sections which is automatically added
# to the expected "slow" distance. Also note that before calibration all moves are slower homing moves.
#
bowden_load_homing_buffer        : 20		# Distance to reduce fast bowden load to prevent collisions and allow for accurate extruder homing
bowden_unload_homing_buffer      : 40		# Distance to reduce fast bowden unload to allow for accurate gate homing

# If you MMU is equiped with an encoder the following options are available:
#
# In addition to different bowden loading speeds for buffer and non-buffered filament it is possible to detect missed
# steps caused by "jerking" on a heavy spool. If bowden correction is enabled Happy Hare will "believe" the encoder
# reading and make correction moves to bring the filament to within the 'bowden_allowable_encoder_delta' of the end of
# bowden position (this does require a reliable encoder and is not recommended for very high speed loading >350mm/s)
#
bowden_apply_correction          : 0		# 1 to enable, 0 disabled
bowden_allowable_encoder_delta   : 20.0		# How close in mm the correction moves will attempt to get to target

# This saftey check uses the encoder to verify the filament is free of extruder before the fast bowden movement to
# reduce possibility of grinding filament. If enabled the trigger can be tuned by setting the "bowden_pre_unload_error_tolerance"
# which represents the percentage of allowable mismatch between actual movement and that seen by encoder. Setting to 50% tolerance
# usually works well. Increasing will make test more tolerant and a value of 100% essentially disables error detection
bowden_pre_unload_test            : 1		# 1 to check for bowden movement before full pull (slower), 0 don't check (faster)
bowden_pre_unload_error_tolerance : 50		# ADVANCED: % tune pre_unload_test sensitivity

# ADVANCED: Controls the detection of successful bowden load/unload movement and represents the percentage of allowable
# mismatch between actual movement and that seen by encoder. Setting to 100% tolerance effectively turns off checking.
bowden_move_error_tolerance       : 60		# ADVANVED: % tune bowden move test sensitivity


# Extruder and toolhead homing ---------------------------------------------------------------------------------------
# ███████╗██╗  ██╗████████╗    ██╗  ██╗ ██████╗ ███╗   ███╗██╗███╗   ██╗ ██████╗
# ██╔════╝╚██╗██╔╝╚══██╔══╝    ██║  ██║██╔═══██╗████╗ ████║██║████╗  ██║██╔════╝
# █████╗   ╚███╔╝    ██║       ███████║██║   ██║██╔████╔██║██║██╔██╗ ██║██║  ███╗
# ██╔══╝   ██╔██╗    ██║       ██╔══██║██║   ██║██║╚██╔╝██║██║██║╚██╗██║██║   ██║
# ███████╗██╔╝ ██╗   ██║██╗    ██║  ██║╚██████╔╝██║ ╚═╝ ██║██║██║ ╚████║╚██████╔╝
# ╚══════╝╚═╝  ╚═╝   ╚═╝╚═╝    ╚═╝  ╚═╝ ╚═════╝ ╚═╝     ╚═╝╚═╝╚═╝  ╚═══╝ ╚═════╝
#
# EXTRUDER / TOOLHEAD HOMING: Happy Hare needs a reference point close to the extruder from which to accurately complete the
# loading of the toolhead. This homing operation takes place after the fast bowden load and it is anticipated that that load
# operation will leave the filament just shy of the homing point. If using a toolhead sensor this initial extruder
# homing is unnecessary (but can be forced) because the homing will occur inside the extruder for the optimum in accuracy.
# You still should set this homing method because it is also used for the determination and calibration of bowden length.
#
# In addition to an entry sensor "extruder" it is possible for Happy Hare to "feel" for the extruder gear entry
# by colliding with it. This can be done with encoder based collision detection, the compression of the sync-feedback
# (aka buffer) sensor or using "touch" (stallguard) on the gear stepper. Note that encoder collision detection is not
# completely deterministic and you will have to find the sweetspot for your setup by adjusting the TMC current reduction.
# Note that reduced current during collision detection can also prevent unnecessary filament griding.
#
# Possible extruder_homing_endtop names:
#   filament_compression - If you have a "sync-feedback" buffer with compression switch (with neutral or tension spring)
#                          Fast bowden load will move to bowden_load_homing_buffer of distance before extruder gear, then home
#   extruder             - If you have a "filament entry" endstop configured (Requires 'extruder' endstop)
#                          Fast bowden load will move to within bowden_load_homing_buffer of distance before sensor, then home
#   encoder              - Detect the collision with the extruder gear by monitoring encoder movement (Requires encoder)
#                          Fast bowden load will move to the extruder gears
#   mmu_gear_touch       - Use touch detection when the gear stepper hits the extruder (Requires stallguard setup)
#                          Fast bowden load will move to bowden_load_homing_buffer of distance before extruder gear, then home
#   none                 - Don't attempt to home. Only possibility if lacking all sensor options
#                          Fast bowden load will move to the extruder gears. Option is fine if using toolhead sensor
# Note: The homing_endstop will be ignored ("none") if a toolhead sensor is available unless "extruder_force_homing: 1"
#
extruder_homing_endstop           : extruder	# Method used to establish the extruder gear reference (fallback if toolhead sensor not available)
extruder_homing_max               : 100		# Maximum distance to advance in order to attempt to home to the extruder

# When using collision homing method (encoder or mmu_gear_touch) the current of the gear stepper can be reduced when homing
extruder_collision_homing_current : 30		# % gear stepper current (10%-100%)


# Toolhead loading and unloading -------------------------------------------------------------------------------------
# ████████╗ ██████╗  ██████╗ ██╗     ██╗  ██╗███████╗ █████╗ ██████╗     ██╗      ██████╗  █████╗ ██████╗
# ╚══██╔══╝██╔═══██╗██╔═══██╗██║     ██║  ██║██╔════╝██╔══██╗██╔══██╗    ██║     ██╔═══██╗██╔══██╗██╔══██╗
#    ██║   ██║   ██║██║   ██║██║     ███████║█████╗  ███████║██║  ██║    ██║     ██║   ██║███████║██║  ██║
#    ██║   ██║   ██║██║   ██║██║     ██╔══██║██╔══╝  ██╔══██║██║  ██║    ██║     ██║   ██║██╔══██║██║  ██║
#    ██║   ╚██████╔╝╚██████╔╝███████╗██║  ██║███████╗██║  ██║██████╔╝    ███████╗╚██████╔╝██║  ██║██████╔╝
#    ╚═╝    ╚═════╝  ╚═════╝ ╚══════╝╚═╝  ╚═╝╚══════╝╚═╝  ╚═╝╚═════╝     ╚══════╝ ╚═════╝ ╚═╝  ╚═╝╚═════╝
#
# TOOLHEAD LOADING/UNLOADING: It is possible to define highly customized loading and unloading sequences, however, unless
# you have a specialized setup it is probably easier to opt for the built-in toolhead loading and unloading sequence which
# already offers a high degree of customization. If you need even more control then edit the _MMU_LOAD_SEQUENCE and
# _MMU_UNLOAD_SEQUENCE macros in mmu_sequence.cfg - but be careful!
#
# Distance added to the extruder unload movement to ensure filament is free of extruder. This adds some degree of tolerance
# to slightly incorrect configuration or extruder slippage. However don't use as an excuse for incorrect toolhead settings
#
toolhead_unload_safety_margin     : 10		# Extra movement safety margin (default: 10mm)

# If not synchronizing gear and extruder and you experience a "false" encoder clog detection immediately after the tool
# change it might be because of a long bowden and/or large internal diameter that causes slack in the filament. This optional
# move will tighten the filament after a load by % of current clog detection length. Gear stepper will run at 50% current
#
toolhead_post_load_tighten        : 0		# % of clog detection length, 0 to disable. Ignored if 'sync_to_extruder: 1'

# If synchronizing gear and extruder and you have a sync-feedback "buffer" (switch based or proportional) this setting
# determines whether to use it to create neutral tension after loading
toolhead_post_load_tension_adjust : 1	# 1 to enable (recommended), 0 to disable

# If sync-feedback compression sensor is available this test will ensure the filament passes the extruder entry by checking
# for neutral tension when moving filament with just the extruder. Recommended with sprung loaded sync-feedback buffers.
# This is ignored if toolhead sensor is available.
toolhead_entry_tension_test       : 1		# 1 to enable (recommended), 0 to disable

# ADVANCED: Controls the detection of successful extruder load/unload movement and represents the percentage of allowable
# mismatch between actual movement and that seen by encoder. Setting to 100% tolerance effectively turns off checking.
# Some designs of extruder have a short move distance that may not be picked up by encoder and cause false errors. This
# allows masking of those errors. However the error often indicates that your extruder load speed is too high or the
# friction is too high on the filament and in that case masking the error is not a good idea. Try reducing friction
# and lowering speed first!
#
toolhead_move_error_tolerance     : 60		# ADVANCED: % tune toolhead move test sensitivity


# Synchronized gear/extruder movement --------------------------------------------------------------------------------
# ███╗   ███╗ ██████╗ ████████╗ ██████╗ ██████╗     ███████╗██╗   ██╗███╗   ██╗ ██████╗
# ████╗ ████║██╔═══██╗╚══██╔══╝██╔═══██╗██╔══██╗    ██╔════╝╚██╗ ██╔╝████╗  ██║██╔════╝
# ██╔████╔██║██║   ██║   ██║   ██║   ██║██████╔╝    ███████╗ ╚████╔╝ ██╔██╗ ██║██║
# ██║╚██╔╝██║██║   ██║   ██║   ██║   ██║██╔══██╗    ╚════██║  ╚██╔╝  ██║╚██╗██║██║
# ██║ ╚═╝ ██║╚██████╔╝   ██║   ╚██████╔╝██║  ██║    ███████║   ██║   ██║ ╚████║╚██████╗
# ╚═╝     ╚═╝ ╚═════╝    ╚═╝    ╚═════╝ ╚═╝  ╚═╝    ╚══════╝   ╚═╝   ╚═╝  ╚═══╝ ╚═════╝
#
# MOTOR SYNCHRONIZATION: This controls whether the extruder and gear steppers are synchronized during printing operations
# If you normally run with maxed out gear stepper current consider reducing it with 'sync_gear_current'
# If equipped with TMC drivers the current of the gear and extruder motors can be controlled to optimize performance.
# This can be useful to control gear stepper temperature when printing with synchronized motor
#
sync_to_extruder                : 1	# Gear motor is synchronized to extruder during print
sync_gear_current               : 100	# % of gear_stepper current (10%-100%) to use when syncing with extruder during print
sync_form_tip                   : 1	# Synchronize during standalone tip formation (initial part of unload)
sync_purge                      : 1	# Synchronize during standalone purging (last part of load)


# Optionally it is possible to leverage feedback from a "compression/expansion" sensor (aka "buffer") in the bowden
# path from MMU to extruder to ensure that the two motors are kept in sync as viewed by the filament (the signal feedback
# state can be binary supplied by one or two switches: -1 (expanded) and 1 (compressed) of proportional value between
# -1.0 and 1.0.
#
# If only "one half" of the sync-feedback is available (either compression-only or tension-only) then the rotation
# distance is always shifted based on the high/low multipliers, however if both tension and compression are available
# then the rotation distance will autotune to correct setting (recommend you also enable 'autotune_rotation_distance: 1'
# so that values are saved)
#
sync_feedback_enabled           : 1	# Turn off even if sensor is installed and active
sync_feedback_speed_multiplier  : 10	# % "twolevel" gear speed delta to keep filament neutral in buffer (recommend 5%)
sync_feedback_boost_multiplier  : 5	# % "twolevel" extra gear speed boost for finding initial neutral position (recommend 3%)
sync_feedback_extrude_threshold : 5	# Extruder movement (mm) for updates (keep small but set > retract distance)

# If defined this forces debugging to a telemetry log file "sync_<gate>.jsonl". This is great if trying to tune clog/tangle
# detection or for getting help on the Happy Hare forum. To plot graph of sync-feedback operation, run:
#  ~/Happy-Hare/utils/plot_sync_feedback.sh
#   0 = disable (normal operation), 1 = enable telemetry log (for debugging)
#
sync_feedback_debug_log         : 1


# FlowGuard Clog and Tangle Detection --------------------------------------------------------------------------------
# ███████╗██╗      ██████╗ ██╗    ██╗ ██████╗ ██╗   ██╗ █████╗ ██████╗ ██████╗
# ██╔════╝██║     ██╔═══██╗██║    ██║██╔════╝ ██║   ██║██╔══██╗██╔══██╗██╔══██╗
# █████╗  ██║     ██║   ██║██║ █╗ ██║██║  ███╗██║   ██║███████║██████╔╝██║  ██║
# ██╔══╝  ██║     ██║   ██║██║███╗██║██║   ██║██║   ██║██╔══██║██╔══██╗██║  ██║
# ██║     ███████╗╚██████╔╝╚███╔███╔╝╚██████╔╝╚██████╔╝██║  ██║██║  ██║██████╔╝
# ╚═╝     ╚══════╝ ╚═════╝  ╚══╝╚══╝  ╚═════╝  ╚═════╝ ╚═╝  ╚═╝╚═╝  ╚═╝╚═════╝
#
# Options are available to automatically detects extruder clogs and MMU tangles. Each option works independently and
# can be combined. Flowguard can even discern the difference between an extruder clog and a spool tangle!
#
# Flowguard:  This intelligently measures filament tension (only available if sync-feedback buffer is fitted)
#
# Encoder detection: This monitors encoder movement and compares to extruder (only available if encoder is fitted)
#
flowguard_enabled            : 1	# 0 = Flowguard protection disabled, 1 = Enabled

# The flowguard_max_relief is the amount of relief movement (effective mm change in filament length between MMU and extruder)
# that Happy Hare will wait until triggering a clog or runout. A smaller value is more sensitive to triggering. Since the
# relief movement is hightly dependent on filament "spring" in the bowden tube, filament friction, and
# 'sync_feedback_buffer_range', it is generally good to start high and then decrease if a more sensitive trigger is desired.
# Analog proportional (type P) sensors can generally have a much lower value. Increase if you have false triggers.
flowguard_max_relief         : 40

# Tangle prevention boosts the gear stepper current to 100% when the proportional sync-feedback sensor reports high
# filament tension (the gear struggling to pull from the spool), restoring normal current once tension eases. This pulls
# through minor spool resistance before it develops into a tangle. Requires a proportional (type P) sensor.
tangle_prevention_enabled    : 1	# 0 = Tangle prevention disabled, 1 = Enabled

# Tension level (fraction of the tension half of the sensor range) at which gear current is boosted (threshold) and
# the level at which it is restored to normal (release). The gap between them provides hysteresis to avoid thrashing;
# 'release' must be lower than 'threshold'. Lower threshold triggers sooner; raise it if you get false triggers.
tangle_prevention_threshold  : 0.3	# Tension (0.2-0.9) to boost gear current to 100%
tangle_prevention_release    : 0.2	# Tension (0.15-0.8) to restore gear current

# Encoder runout/clog/tangle detection watches for movement over either a static or automatically adjusted distance - if
# no encoder movement is seen when the extruder moves this distance runout/ clog/tangle event will be generated. Allowing
# the distance to be adjusted automatically (mode=2) will generally allow for a quicker trigger but use a static length
# (mode=1, set encoder_max_motion) if you get false triggers (see flowguard guide on wiki for more details).
# Note that this feature cannot distinguish between clog or tangle.
flowguard_encoder_mode       : 0	# 0 = Disable, 1 = Static detection length, 2 = Autotuned detection length

# The encoder_max_motion is the absolute max permitted extruder movement without the encoder seeing movement when using
# status mode (mode=1). Smaller values are more sensitive but beware of going too small - slack and friction in the
# bowden may cause gaps in encoder movement. Increase if you have false triggers.
# Note that this value is overriden by any calibrated value stored in 'mmu_vars.cfg' if in automatic mode (mode=2).
flowguard_encoder_max_motion : 20


# Calibration and autotune -------------------------------------------------------------------------------------------
#  ██████╗ █████╗ ██╗     ██╗██████╗ ██████╗  █████╗ ████████╗██╗ ██████╗ ███╗   ██╗
# ██╔════╝██╔══██╗██║     ██║██╔══██╗██╔══██╗██╔══██╗╚══██╔══╝██║██╔═══██╗████╗  ██║
# ██║     ███████║██║     ██║██████╔╝██████╔╝███████║   ██║   ██║██║   ██║██╔██╗ ██║
# ██║     ██╔══██║██║     ██║██╔══██╗██╔══██╗██╔══██║   ██║   ██║██║   ██║██║╚██╗██║
# ╚██████╗██║  ██║███████╗██║██████╔╝██║  ██║██║  ██║   ██║   ██║╚██████╔╝██║ ╚████║
#  ╚═════╝╚═╝  ╚═╝╚══════╝╚═╝╚═════╝ ╚═╝  ╚═╝╚═╝  ╚═╝   ╚═╝   ╚═╝ ╚═════╝ ╚═╝  ╚═══╝
#
# CALIBRATION AND AUTOTUNE: These are auto calibration/tuning settings that can be used to ease initial setup and/or to
# tune calibration over time based on measured telemetry. Whether these auto-tuning features are available depends on
# MMU design and configured sensors (explained below). The setting will be ignored if the required sensors are not available
# but if they can operate they will suppress the normal calibration warnings (MMU_STATUS can still be used to view them).
# Note that these are initially set by the installer to recommended values
#
#  autocal_bowden_length      - the calibrated bowden length will be established on first load. It can also be set
#                               manually or reset with MMU_CALIBRATE_BOWDEN. Best results require the use of
#                               sync-feedback-compression or extruder sensor but gear-touch or encoder will also work.
#                               'extruder_homing_endstop' cannot be 'none'
#  autotune_bowden_length     - Once calibrated this setting will tune the bowden distance over time. Works best with
#                               toolhead sensor
#  skip_cal_rotation_distance - This will rely on installed default value (although it can still be calibrated). Usually
#                               a good choice if autotune is enabled
#  autotune_rotation_distance - Requires sync-feedback sensor (aka "buffer") or calibrated encoder. If set then either the
#                               "autotuner" (sync-feedback buffer) or encoder telemetry will be used to adjust the
#                               persisted gear rotation distance.
#  skip_cal_encoder           - Will rely on installed default value (although it can still be calibrated).
#
autocal_bowden_length      : 1		# Automated bowden length calibration. 1=automatic, 0=manual/off
autotune_bowden_length     : 0		# Automated bowden length tuning. 1=on, 0=off
skip_cal_rotation_distance : 1		# Skip rotation distance calibration (MMU_CALIBRATE_GEAR), 1=skip, 0=require
autotune_rotation_distance : 1		# Automated gate calibration/tuning. 1=automatic, 0=manual/off
skip_cal_encoder           : 1		# Skip encoder calibration (MMU_CALIBRATE_ENCODER), 1=skip, 0=require


# Miscellaneous, but you should review -------------------------------------------------------------------------------
# ███╗   ███╗██╗███████╗ ██████╗
# ████╗ ████║██║██╔════╝██╔════╝
# ██╔████╔██║██║███████╗██║
# ██║╚██╔╝██║██║╚════██║██║
# ██║ ╚═╝ ██║██║███████║╚██████╗
# ╚═╝     ╚═╝╚═╝╚══════╝ ╚═════╝
#
# MISCELLANEOUS: These are supplemental workflow options that apply just to this unit (empty for some types)

# ADVANCED: Determines if encoder measurement should be used to validate movement distance
#  0 = Validation is disabled (eliminates slight pause between moves but less safe)
encoder_move_validation  : 1


# SUPPLEMENTAL / UNDOCUMENTED PARAMETERS
