deflord/3def/Конфигурационные файлы/Серийные/SN229/config/AFC.backup.20250820124446/AFC_Hardware.cfg

[force_move]
enable_force_move: True

[AFC_extruder extruder]
pin_tool_start: ^ebb36:PB9
#pin_tool_end: ^ebb36:PB8
tool_stn: 100                     # Distance in mm from the toolhead sensor to the tip of the nozzle in mm, if `tool_end` is defined then distance is from this sensor
tool_stn_unload: 70              # Distance to move in mm while unloading toolhead
# tool_sensor_after_extruder: 46   # Extra distance to move in mm once pre/post sensors are clear. Useful for when only using post sensor, so this distance can be the amout to move to clear extruder gears
tool_unload_speed: 25            # Unload speed in mm/s when unloading toolhead. Default is 25mm/s.
tool_load_speed: 20              # Load speed in mm/s when unloading toolhead. Default is 25mm/s.
buffer: Turtle_1

#[filament_switch_sensor bypass]
#switch_pin: turtleneck:PB5
#pause_on_runout: False


[AFC_buffer Turtle_1]
advance_pin: ^Turtle_1:PE3    # set advance pin
trailing_pin: ^Turtle_1:PE2  # set trailing pin
multiplier_high: 1.1   # default 1.05, factor to feed more filament
multiplier_low:  0.9   # default 0.95, factor to feed less filament
debug: True
#velocity: 0
