deflord/3def/Конфигурационные файлы/Серийные/SN252/config/stealthchanger/homing.cfg

# Original written by Viesturs Zarins
# Modified by Justin F. Hallett
# Modified more by Jared Wellman

[gcode_macro homing_override_config]
variable_sensorless_x: 
variable_sensorless_y: 
variable_homing_rebound_y: 20
variable_stepper_driver: "tmc2209"
variable_homing_current: 0.49
gcode: 


[homing_override]
axes: xyz
gcode:
  _INITIALIZE_FROM_DETECTED_TOOL
  {% if printer.probe.last_query %}
    RESPOND TYPE=error MSG='Z Probe triggered, cannot home.'
  {% else %}
    SET_GCODE_OFFSET X=0.0 Y=0.0 Z=0.0
    {% set max_y = printer.configfile.config["stepper_y"]["position_max"]|float %}
    {% set max_x = printer.configfile.config["stepper_x"]["position_max"]|float %}
    {% set home_all = 'X' not in params and 'Y' not in params and 'Z' not in params %}

    {% set config = printer["gcode_macro homing_override_config"] %}


    G90 ; absolute mode
    {% if 'z' not in printer.toolhead.homed_axes %}
      SET_KINEMATIC_POSITION Z=0
      G0 Z10 F1000
    {% elif printer.toolhead.position[2]|float < 10 %}
      G0 Z10 F1000
    {% endif %}

    {% if home_all or 'Y' in params or 'X' in params %}
      {% if config.sensorless_y %}
        _SENSORLESS_HOME AXIS=Y
      {% else %}
        G28 Y
      {% endif %}
      G0 Y{ max_y - config.homing_rebound_y } F6000
    {% endif %}

    {% if home_all or 'X' in params %}
      {% if config.sensorless_x %}
        _SENSORLESS_HOME AXIS=X
      {% else %}
        G28 X
      {% endif %}
      G0 X{ max_x - 10} F6000
    {% endif %}

    {% if home_all or 'Z' in params %}
      {% set random_x = (range(-50, 50) | random) / 10 %}
      {% set random_y = (range(-50, 50) | random) / 10 %}

      G90 ; absolute mode
      G0 X{( max_x / 2 ) + random_x} Y{( max_y / 2 ) + random_y + 75} F12000
      G28 Z
      _ADJUST_Z_HOME_FOR_TOOL_OFFSET
    {% endif %}
    _APPLY_ACTIVE_TOOL_GCODE_OFFSETS
    M400
  {% endif %}


[gcode_macro _SENSORLESS_HOME]
gcode:
  {% set axis = params.AXIS|default('X')|string %}
  {% set config = printer["gcode_macro homing_override_config"] %}

  # Always use consistent run_current on A/B steppers during sensorless homing
  {% set RUN_CURRENT_X = printer.configfile.settings[config.stepper_driver ~ ' stepper_x'].run_current|float %}
  {% set RUN_CURRENT_Y = printer.configfile.settings[config.stepper_driver ~ ' stepper_y'].run_current|float %}
  SET_TMC_CURRENT STEPPER=stepper_x CURRENT={config.homing_current}
  SET_TMC_CURRENT STEPPER=stepper_y CURRENT={config.homing_current}
  {% if config.stepper_driver ~ ' stepper_x1' in printer.configfile.settings %}
    {% set RUN_CURRENT_X1 = printer.configfile.settings[config.stepper_driver ~ ' stepper_x1'].run_current|float %}
    SET_TMC_CURRENT STEPPER=stepper_x1 CURRENT=0.1
  {% endif %}
  {% if config.stepper_driver ~ ' stepper_y1' in printer.configfile.settings %}
    {% set RUN_CURRENT_Y1 = printer.configfile.settings[config.stepper_driver ~ ' stepper_y1'].run_current|float %}
    SET_TMC_CURRENT STEPPER=stepper_y1 CURRENT=0.1
  {% endif %}

  # Home
  G28 {axis|upper}
    
  # Wait just a second… (give StallGuard registers time to clear)
  G4 P1000
  # Set current during print
  SET_TMC_CURRENT STEPPER=stepper_x CURRENT={RUN_CURRENT_X}
  SET_TMC_CURRENT STEPPER=stepper_y CURRENT={RUN_CURRENT_Y}
  {% if config.stepper_driver ~ ' stepper_x1' in printer.configfile.settings %}
    SET_TMC_CURRENT STEPPER=stepper_x1 CURRENT={RUN_CURRENT_X1}
  {% endif %}
  {% if config.stepper_driver ~ ' stepper_y1' in printer.configfile.settings %}
    SET_TMC_CURRENT STEPPER=stepper_y1 CURRENT={RUN_CURRENT_Y1}
  {% endif %}


; Depending on the selected tool at the time of homing, the physical Z endstop position is offset.
; This corrects for that using current tool offset.
[gcode_macro _ADJUST_Z_HOME_FOR_TOOL_OFFSET]
gcode:
      G90 ; absolute mode
      G0 Z10 F1000
      {% set tool = printer.toolchanger.tool %}
      {% if tool %}
         {% set tool_z_offset = printer[tool].gcode_z_offset %}
         {% set probe_z_offset = printer.tool_probe_endstop.active_tool_probe_z_offset %}
         SET_KINEMATIC_POSITION Z={10.0+tool_z_offset|float+probe_z_offset|float}
      {% endif %}

[gcode_macro _APPLY_ACTIVE_TOOL_GCODE_OFFSETS]
gcode:
    ; Apply gcode offsets
    {% set tool = printer.toolchanger.tool %}
    {% if tool %}
      SET_GCODE_OFFSET X={printer[tool].gcode_x_offset} Y={printer[tool].gcode_y_offset} Z={printer[tool].gcode_z_offset}
    {% endif %}

[gcode_macro TOOL_BED_MESH_CALIBRATE]
gcode:
      {% set tool_z_offset = printer[printer.toolchanger.tool].gcode_z_offset %}
      G90 ; absolute mode
      G0 Z10 F1000
      # Bed mesh knows about the probe offset, but not about the tool offset.
      SET_KINEMATIC_POSITION Z={10.0-tool_z_offset|float}
      BED_MESH_CALIBRATE
      G0 Z10 F1000
      SET_KINEMATIC_POSITION Z={10.0+tool_z_offset|float}
