deflord/3def/Конфигурационные файлы/Серийные/SN356/config/servo.cfg

[servo aperture]
pin: PF9
#   PWM output pin controlling the servo. This parameter must be
#   provided.
maximum_servo_angle: 180
#   The maximum angle (in degrees) that this servo can be set to. The
#   default is 180 degrees.
minimum_pulse_width: 0.00081
#   The minimum pulse width time (in seconds). This should correspond
#   with an angle of 0 degrees. The default is 0.001 seconds.
maximum_pulse_width: 0.0025
#   The maximum pulse width time (in seconds). This should correspond
#   with an angle of maximum_servo_angle. The default is 0.002
#   seconds.
#initial_angle:
#   Initial angle (in degrees) to set the servo to. The default is to
#   not send any signal at startup.
#initial_pulse_width:
#   Initial pulse width time (in seconds) to set the servo to. (This
#   is only valid if initial_angle is not set.) The default is to not
#   send any signal at startup.


[gcode_macro APERTURE]
gcode:
  {% set state = params.STATE|default("CLOSE")|upper %}
  {% if state == "OPEN" %}
    SET_SERVO SERVO=aperture ANGLE=0
  {% elif state == "CLOSE" %}
    SET_SERVO SERVO=aperture ANGLE=180
  {% else %}
    { action_respond_info("Ошибка: используйте Open или Close") }
  {% endif %}
