deflord/3def/(commit log)

2024-08-04 Добавил детали CW2
    [[a]_guidler_a.stl, [a]_guidler_b.stl, [a]_latch.stl, [a]_latch_shuttle.stl, [a]_pcb_spacer.stl, cable_door_for_SB2040.stl, cable_holder.stl, cable_holder_1.STL]
2024-08-04 Переименовал один файл
    [[a]_guidler_a.stl, [a]_guidler_b.stl, [a]_latch.stl, [a]_latch_shuttle.stl, [a]_pcb_spacer.stl, cable_door_for_SB2040.stl, can_cable_holder_1.STL, main_body.STL]
2024-08-04 Добавил детали передней крышки
    [[c]_stealthburner_LED_diffuser.stl, [o]_stealthburner_LED_carrier.stl, [o]_stealthburner_LED_diffuser_mask.stl, Держатель хотэнда Bambu. Задняя сторона.STL, Держатель хотэнда Bambu. Передняя сторона.STL]
2024-08-04 Переименовал CW2
    [[a]_guidler_a.stl, [a]_guidler_b.stl, [a]_latch.stl, [a]_latch_shuttle.stl, [a]_pcb_spacer.stl, cable_door_for_SB2040.stl, can_cable_holder_1.STL, main_body.STL]
2024-08-04 Добавляем
    [Ball.stl, Ball_Bottom.stl, Ball_Top.stl, V6_Plenum_Lid.stl, [a]V6_Jalousie_Slicer.stl, [a]_guidler_a.stl, [a]_guidler_b.stl, [a]_latch.stl]
2024-08-05 Изменили структуру
    [Klicky-00-Front-Body-D2F-Countersunk - SB-1.stl, Ball.stl, Ball_Bottom.stl, Ball_Top.stl, KLICKY L кронштейн.stl, Klicky-00-Rear-Body - Klicky-00-Rear-Body-1.stl, Klicky-00_Bump-Dock_parts.stl, Mellow Fly IDM адаптер.STL]
2024-08-05 Отключил старый K-Shake Tunes
    [printer.cfg]
2024-08-05 Добавлены держатели моторов A и B
    [Левый верхний.stl, Левый нижний.stl, Правый верхний.stl, Правый нижний.STL]
2024-08-05 Добавили держатели портала на 500
    [[a] держатели ремня.stl, Верхняя часть шарнира.stl, Нижняя часть шарнира (на каретку) A x2.stl, Нижняя часть шарнира (на каретку) B x2.stl]
2024-08-05 Добавили редукторы Z на 500
    [Z редуктор AX1.stl, Z редуктор AX2.stl, Z редуктор BX1.stl, Z редуктор BX2.stl]
2024-08-05 Добавили модов
    [2020_Stealth_Profile_Cover.stl, Ball.stl, Ball_Bottom.stl, Ball_Top.stl, NewLatch-3.0mm.stl, SBCrazyDragon_TH_Rear_CW2.stl, SB_Dragon_UHF_TH_Rear.stl, SB_Dragon_UHF_mini_TH_Rear.stl]
2024-08-09 Поправили PID
    [printer.cfg, start_end.cfg]
2024-08-13 Добавили CAN Mod
    [Y бампер.stl, Держатель CAN и концевика.STL, Держатель кабель канала.STL, Держатель кабеля CAN для мотора 23мм.STL, Кронштейн для мотора толщиной 23мм.stl, Крышка.STL]
2024-08-14 SB-2040V3 с IDM
    Добавили конфиг для Voron 500 с IDM
    [adxl345.cfg, filament_sensor.cfg, led.cfg, nozzle_scrub.cfg, offmodule.cfg, printer.cfg, speed_test.cfg, start_end.cfg]
2024-08-16 Стандартизировали microsteps
    [printer.cfg]
2024-08-16 Перенесли PID в служебные
    [printer.cfg]
2024-08-28 Подправили название
    [adxl345.cfg, filament_sensor.cfg, led.cfg, nozzle_scrub.cfg, offmodule.cfg, printer.cfg, speed_test.cfg, start_end.cfg]
2024-08-29 Держатель крышки апп. отсека
    [Верхняя крышка.STL, Нижний упор.STL]
2024-08-30 Добавили держатели светового профиля
    [printer.cfg, Держатель светового профиля 30х30.3mf, Держатель.STL]
2024-08-30 Заменили на STL
    [Держатель светового профиля 30х30.3mf, Держатель светового профиля 30х30.stl]
2024-09-01 Добавили петли дверей
    [3mm_side_mount_x4.stl, Держатель для профиля 2020.STL, Петля_1.STL, Петля_2.STL]
2024-09-07 Корректное автоотключение
    В новых версиях модуля выключения появляется возможность в начале корректно отключить хост-компьютер, после чего выключить питание принтера
    [offmodule.cfg]
2024-09-15 Добавлен держатель камеры
    Теперь вы можете спокойно разместить вашу камеру прямо на портале :)
2024-09-16 Добавили описание секции [fan]
    [printer.cfg]
2024-09-17 Добавили заглушки Z
    Добавили заглушки ремней по оси Z
    [cable_routing_z_belt_cover_a_mod_rail_notch_v2.2.stl, cable_routing_z_belt_cover_b_mod_rail_notch_v2.2.stl]
2024-10-15 Лого
    [Держатель платы.stl, Задняя панель для Mellow CAN v1.step, Задняя сторона.stl, Натяжители ремня редуктора Z увеличенный натяг.stl, камера корпус.3mf]
2024-10-15 Переименовал
2024-10-16 Добавили схемы подключения
2024-10-16 Исправили подключение LED
2024-10-17 Поправили подключение датчика стола
2024-10-23 Поправили описание параметра variable_brush_deep_max
    [nozzle_scrub.cfg]
2024-10-31 Конфиг FlyD8
    Добавили конфиги для Fly D8 в режиме RS-232 и Klicky-00
    [adxl345.cfg, filament_sensor.cfg, klicky-bed-mesh-calibrate.cfg, klicky-macros.cfg, klicky-probe.cfg, klicky-quad-gantry-level.cfg, klicky-variables.cfg, klicky-z-calibration.cfg]
2024-11-05 Create README.md
    Образ для OrangePi 3 Zero
2024-11-05 Create README.md
    Добавили образ для Orange Pi 3B
2024-11-05 Поправили структуру
2024-11-08 Добавили держатели обшивки
    [NewLatch-3.0mm.stl, Боковая_2020.STL, Боковая_3030.STL, Т-образный_зажим_2020.STL, Т-образный_зажим_3030.STL, Угловая_2020.STL, Угловая_3030.STL]
2024-11-28 Тюнинг конфигов и корпус вытяжки
    [adxl345.cfg, filament_sensor.cfg, led.cfg, nozzle_scrub.cfg, offmodule.cfg, printer.cfg, speed_test.cfg, start_end.cfg]
2024-12-05 Добавили STL и схему без CAN
    [3mm_side_mount_x4.stl, Петля_1.STL, Петля_2.STL, Прокладка полукруглая х6.stl, Прокладка стекла х4.STL, Прокладка стекла х 4.stl]
2024-12-08 Update Fly D8 без CAN платы.jpeg
2024-12-08 Добавили держатель Fly D8
    [Держатель Fly D8 .stl]
2024-12-08 Добавили крепления плат
    [pcb_din_clip.stl, Держатель MKS 8.stl, Держатель Orange Pi 3B.stl]
2024-12-09 Добавили держатель реле стола
    [Держатель реле.STL]
2024-12-12 Добавили поддержку Cartographer
    [start_end.cfg]
2024-12-12 Поправили print_start
    [start_end.cfg]
2024-12-21 Create 4WD схема русская.jpg
2024-12-29 Добавлена схема Fly D8 Pro
    [Верхняя часть с резьбой.STL, Передняя крышка.STL]
2025-01-09 Добавили схемы сборки электроники
    [adxl345.cfg, filament_sensor.cfg, led.cfg, mainsail.cfg, nozzle_scrub.cfg, offmodule.cfg, printer.cfg, speed_test.cfg]
2025-01-16 Поправили ошибку с типом шайбы
    Вместо M3 была указана M5
2025-01-22 Добавили STL нижней юбки
    [front_skirt_a_400.stl, front_skirt_b_400.stl, rear_center_skirt_400.stl, side_skirt_a_400_x2.stl, side_skirt_b_400_x2.stl]
2025-01-22 поменяли последовательность подключения моторов
2025-01-23 Добавили схему расположения моторов
    Многие клиенты при сборке путались, как правильно расположить моторы.
2025-01-26 почистили и причесали конфиги
    [adxl345.cfg, filament_sensor.cfg, led.cfg, motors_sync.cfg, nozzle_scrub.cfg, offmodule.cfg, printer.cfg, start_end.cfg]
2025-01-27 Убрали названия на русском
    Названия вентиляторов на русском языке приводили к огромному кол-ву ошибок klipper scren, что могло забивать память
    [printer.cfg]
2025-01-31 попровили контакт подключения
    [Cable Holder верх x3.step, Cable Holder низ x3.step, offmodule.cfg, Камера 500 AWD верх.step, Камера 500 AWD низ.step]
2025-01-31 Держатели проводки 350 CNC
    [3х Cable Holder Y 350 верх.step, 3х Cable Holder Y 350 низ.step, Держатель кабеля на заднем моторе.step, Камера 350 AWD верх.step, Камера 3500 AWD низ.step]
2025-01-31 Добавили STL
    [3х Cable Holder Y 350 верх.stl, 3х Cable Holder Y 350 низ.stl, Камера 350 AWD верх.stl, Камера 3500 AWD низ.stl, Крышка продовов на правом заднем моторе.stl]
2025-02-02 добавили держатели кабелей по x
    [2x Cable Holder X 350 верх.step, 2x Cable Holder X 350 верх.stl, 2x Cable Holder X 350 низ.step, 2x Cable Holder X 350 низ.stl]
2025-02-03 SB для резака нити
    Добавили детали мода, позволяющие поставить на SB резак нити и 2 датчика пластика
    [CW2 блок шестерней с датчиками для ERCF и винтовым креплением трубки.stl, [a]_SB_Latch_ECAS.stl, Держатель ножа.stl, Рычаг резака.STL]
2025-02-03 Добавили держатель CAN
    [Верхняя часть с резьбой.step, Верхняя часть с резьбой.stl, Передняя крышка.step, Передняя крышка.stl, Упор концевика.step, Упор концевика.stl]
2025-02-03 поправили Cable Holder Y 350
    [3х Cable Holder Y 350 верх.step, 3х Cable Holder Y 350 верх.stl, 3х Cable Holder Y 350 низ.step, 3х Cable Holder Y 350 низ.stl]
2025-02-04 Добавили шаблоны сборки CNC
    [Шаблон для держателей оси x.stl, Шаблон задний двигатель.stl, Шаблон левый передний двигатель.stl]
2025-02-04 скорректировали шаблоны
    [Шаблон для держателей оси x.stl, Шаблон задний двигатель.stl, Шаблон левый передний двигатель.stl]
2025-02-06 Изменили порядок, обновили файлы
    [2x Cable Holder X 350 верх.step, 2x Cable Holder X 350 верх.stl, 2x Cable Holder X 350 низ.step, 2x Cable Holder X 350 низ.stl, 2х 500 X Cable Holder верх.step, 2х 500 X Cable Holder верх.stl, 2х 500 X Cable Holder низ.step, 2х 500 X Cable Holder низ.stl]
2025-02-07 поправили Cable Holder Y 500 верх под камеру.step
    [Cable Holder Y 500 верх под камеру.step]
2025-02-07 Доработали offmodule.cfg
    Иногда отключение срабатывало не корректно. Доработали макрос
    [offmodule.cfg]
2025-02-08 Обновили крышку камеры
    Добавили в отверстия заливку высотой 0,2 что бы печатать без поддержек
    [Cable Holder Y 350 верх под камеру v1.stl, Cable Holder Y 350 верх под камеру.step, Cable Holder Y 350 низ под камеру.stl, Камера 350 AWD верх.step, Камера 350 AWD верх.stl, Камера 350 AWD низ.step, Камера 350 AWD низ.stl, Камера 3500 AWD низ.stl]
2025-02-08 Добавили схему подключения BoxTurtle
2025-02-12 Правки в конфиг
    1. Поправили пин подключения модуля выключения
    2. Добавили актуальную секцию для картографера
    [filament_sensor.cfg, printer.cfg]
2025-02-13 правки конфигов
    [3030 cover.stp, nozzle_scrub.cfg, printer.cfg]
2025-02-20 Добавили петли дверей на 500
    [Держатель Cartographer v1.step, Петля двери. Крепление дверцы_1 .STL, Петля двери. Крепление дверцы_2.stl, Петля двери. Крепление к профилю.STL]
2025-02-26 Добавили STL новых редукторов для 500
    [Z редуктор AX1.stl, Z редуктор AX2.stl, Z редуктор BX1.stl, Z редуктор BX2.stl, Z редуктор корпус AX2.stl, Z редуктор корпус BX2.stl, Z редуктор крышка AX2.stl, Z редуктор крышка BX2.stl]
2025-02-26 STL ручек дверей на 500
    [3030 Держатель магнитов на профиль x2.stl, 3030 Ручка Ax2.stl, 3030 Ручка Bx2.stl, 3mm_side_mount_x4.stl, Петля двери. Крепление дверцы_1 .STL, Петля двери. Крепление дверцы_2.stl, Петля двери. Крепление к профилю.STL, Петля_1.STL]
2025-03-03 Добавили подключение нового датчика BTT
2025-03-05 Добавили STL для CW2 с датчиком
    Добавили STL для CW2 с фиттингом ECAS и одним датчиком пластика. Используется при работе с ERCF или BoxTurtle.
    [BTT_SFS2_Mount_4mm.stl, Main Body.step, Main Body.stl, Motor_Plate.step, Motor_Plate.stl, latch.step, latch.stl, Без названия.stl]
2025-03-05 Добавили держатель CAN для Galileo 2
    [Держатель кабеля CAN.stl, Кронштейн CAN.stl]
2025-03-16 Добавили держатель WAGO
    [wago_221-415_mount_3by5.stl]
2025-03-17 Обновили конфиги на 500 CNC
    [adxl345.cfg, filament_sensor.cfg, motors_sync.cfg, nozzle_scrub.cfg, printer.cfg, start_end.cfg, wago_221-415_mount_3by5.stl]
2025-03-24 Добавили STL крепления экрана
    [3030 Кронштейн A.STL, 3030 Кронштейн B.stl, RootArm-A.STL, RootArm-B.STL, Короткий шарнир х2.STL, Шарнинр A.STL, Шарнир B.STL]
2025-03-26 изменили камеру
    [Voron 350 CNC камера.step, Корпус задвижки.step, Корпус правый.step, Крышка.step, Левый корпус.step, Правый корпус.step]
2025-04-02 Добавили корпуса для камеры
    Добавили корпуса для камеры, что бы поставить её на порталы Monolith или CNC
    [Printed_long_shaft_double_shear_housing.step, Printed_long_shaft_double_shear_housing.stl, Voron 350 CNC камера.step, adxl345.cfg, filament_sensor.cfg, led.cfg, mainsail.cfg, nozzle_scrub.cfg]
2025-04-02 Добавили корпус для CNC
    [Верхняя часть.step, Верхняя часть.stl, Крепление CNC.step, Крепление CNC.stl, Нижняя часть.step, Нижняя часть.stl, Шаблон для сверления отверстий под резьбу.step, Шаблон для сверления отверстий под резьбу.stl]
2025-04-03 Добавили держатель Rapido
    [G2E_SB_Rapido 2_Filametrix_Rear v1.step, G2E_SB_Rapido 2_Filametrix_Rear v1.stl]
2025-04-03 разложили по папкам
    [G2E_SB_Rapido 2_Filametrix_Rear v1.step, G2E_SB_Rapido 2_Filametrix_Rear v1.stl]
2025-04-07 добавили корпус натяжителя Z
    [Z редуктор AX1.stl, Z редуктор AX2.stl, Z редуктор BX1.stl, Z редуктор BX2.stl, Z редуктор корпус AX2.stl, Z редуктор корпус BX2.stl, Z редуктор крышка AX2.stl, Z редуктор крышка BX2.stl]
2025-04-23 Добавили STL StealthCahnger
    [Cowl_NoProbe.stl, DragonBurner.stl, DragonBurner_Spacer.stl, NeoPixel_Mount.step, NeoPixel_Mount.stl, Orbiter2_Mount.step, Shuttle_Keeper_9mm_MGN12H.stl, StealthChanger.3mf]
2025-04-27 StealthChanger
    Выкатили набор CAD и STL для нашей версии StealthChanger на основе DragonBurner в двух версиях доков.
    [Cowl_NoProbe.stl, DragonBurner.stl, DragonBurner_Spacer.stl, DragonBurner_magnet_Plate.step, DragonBurner_magnet_Plate.stl, NeoPixel_Mount.step, NeoPixel_Mount.stl, Orbiter2_Mount.step]
2025-05-06 Доработанный держатель CAN
    Добавили новый держатель, который позволяет более жёстко крепить стальной пруток для удержания кабеля
    [Держатель CAN с креплением стального прутка.stl]
2025-05-06 вместо [safe_z_home] используем [homing_override]
    [printer.cfg]
2025-05-21 добавили ещё детали
    [Dock_BambuNozzleWiper длинее на 1 мм.step, Dock_BambuNozzleWiper длинее на 1 мм.stl, Dock_BambuNozzleWiper длинее на 2 мм.step, Dock_BambuNozzleWiper длинее на 2 мм.stl, Держатель STH-36_orbiter_2.0 с креплением проволки.step, Держатель провода и трубки PTFE.STL, Корпус DragonBurner с магнитами.step, Корпус DragonBurner с магнитами.stl]
2025-06-16 Добавили файлы StealthChanger
    [Dock_BambuNozzleWiper длинее на 1 мм.stl, Dock_BambuNozzleWiper длинее на 2 мм.stl, lrs_200_psu_bracket_x2.stl, start_end.cfg, Адаптер для PG7 на 6 голов.step, Боковая_2020.STEP, Боковая_2020.STL, Держатель STH-36_orbiter_2.0.step]
2025-06-16 Поправили описание
2025-06-22 Добавили держатель BTT CPAP
    [Держатель на профиль 2020.step, Держатель на профиль 2020.stl, Держатель на профиль_3030.step, Держатель на профиль_3030.stl, Корпус вытяжки с датчиком BTT SFS2.step, Крышка.step, Крышка.stl, Переходник для подключения шланга.step]
2025-06-22 добавили фото
2025-06-23 Добавили угловые держатели профиля LED
    [Передний корпус с 1 верхним датчиком.step, Передний корпус с 1 верхним датчиком.stl, Угловой держатель профиля LED.step, Угловой держатель профиля LED.stl]
2025-07-16 Добавили ведро для 400
    Для установки системы BoxTurtle на принтеры с большим рабочим полем (например, 400), нужно большое ведро для отходов.
    [Faceplate - LED - Rear v2.step, M2.5 Saver v1.step, Xol Extruder Mount - Orbiter V2 v1.step, Xol-Toolhead_HE_Mounts_Rapido_fanHS v2.step, Xol-Toolhead_HE_Mounts_Rapido_fanHS v2.stl, Ведро.step, Ведро.stl, Держатель Cartographer UHF.step]
2025-07-16 Конфиги для 400 StealthChanger
    [T0.cfg, T1.cfg, T2.cfg, T3.cfg, T4.cfg, T5.cfg, calibrate-offsets.cfg, example_T0.cfg]
2025-07-18 Добавили держатели разъёмов USB и MicroSD
    [Пластик левого джойна оси X.stl, Пластик правого держателя оси X.step, Пластик правого джойна оси X.stl]
2025-07-21 Небольшие исправления STL
    [Circle_sd_mount.stl, DragonBurner_magnet_Plate.stl, SD_mount.stl, Skirt USB.step, lock ring.stl, sd_mount.step, usb skirt insert 1.stl, usb skirt insert 2.stl]
2025-07-24 Добавили модели для BTT ECO Turbo kit
    [BTT_ECO_turbo_kit.3mf, Bottom.step, Cutter Arm.step, DIN_Rail_Bracket_Heat_Insert_Version.step, Din_Rail_Bracket_Heat_Insert_Version.stl, Faceplate - LED - Front.stl, Faceplate - LED - Rear v2.step, M2.5 Saver v1.step]
2025-07-25 Create right (1).stl
    [right (1).stl]
2025-08-04 Минорные обновления
    [BTT_ECO_turbo_kit.3mf, extruder_adapter_bottom.stl, Держатель Cartographer UHF.step, Держатель Cartographer длинный для UHF v1.stl, Решётка для забора воздуха с PG7.step]
2025-08-04 Петли дверей
    Добавили петли дверей
    [Петля двери на 500 левая.stl, Петля двери на 500 правая.stl, Стопор каретки по оси Z.stl]
2025-08-06 Добавили активный подогрев
    Добавили модели для установки аткивного подогрева
    [Левая часть.step, Левая часть.stl, Перемычка в середине.step, Перемычка в середине.stl, Правая часть.step, Правая часть.stl, Центр x2.step, Центр x2.stl]
2025-08-06 добавил акцентные цвета
    [[a]_Держатель на профиль 2020.stl, [a]_Крышка.stl]
2025-08-07 Добавили ввод CAN на Monolith
    [Printed_9mm_tensioner_a_x2.stl, Printed_9mm_tensioner_b_x2.stl, Держатель CAN на портале v1.step, Держатель PG7.stl, Передняя крышка.stl]
2025-08-07 Добавили ввод проводки
    [Ввод с концевиком.step, Верх.step, Верх.stl, Держатель CAN на портале v1.step, Держатель PG7.stl, Держатель концевика на 1 мм короче.step, Держатель концевика на 1 мм короче.stl, Держатель концевика на 2 мм короче.step]
2025-08-07 Добавили держатель кабель канала Z
    [Держатель кабель канала на портал.step, Держатель кабель канала на портал.stl, Держатиль кабель канала нижний.step, Держатиль кабель канала нижний.stl]
2025-08-19 Убрали лищнее
2025-09-02 Изменили задний упор дока
    Убрали с него направляющие выступы и расшилирили отверстие для установочного винта с шайбой
    [3030Z monolith.step, Задний упор с магнитами.step, Задний упор с магнитами.stl, Ограничитель движения каретки.stl]
2025-09-15 Добавили держатель USB в юбку
    [Skirt USB.step, lock ring.stl, usb skirt insert 1.stl, usb skirt insert 2.stl]
2025-09-15 Добавили натяжители Z под Monolith
    [Monolith_Z Idler A.step, Monolith_Z Idler A.stl, Monolith_Z Idler B.stl]
2025-10-03 Create Xol_HE_Mount-Rapido_v2_UHF_XolPAP v1.stl
    [Xol_HE_Mount-Rapido_v2_UHF_XolPAP v1.stl]
2025-10-08 Добавили охлаждение Fly X10
    [Держатель вентилятора.step, Держатель вентилятора.stl, Крепление DIN.step, Крепление DIN_x2.stl, Проставка.step, Проставка_x4.stl]
2025-10-09 Уменьшили проставку до 2 мм
    [Проставка.step, Проставка_x4.stl]
2025-10-13 Добавили XOL для HeatCore
    Добавили новую голову XOL с CPAP, Orbiter 2, Heatcore v4 ALPS, ножом и датчиком филамента
    [Blade Holder v1.step, Blade Holder v1.stl, Blade Holder.step, Bottom v1.step, Bottom v1.stl, BrushHolder v1.step, Cutter Arm v1.step, Cutter Arm v1.stl]
2025-10-21 добавили держатель новой платы AFC
    [маунт платы черепахи v.3.stl, маунт платы черепахи v.3.stp]
2025-10-22 Чуть удлинили крепление на DIN рейку
    [Крепление DIN.step, Крепление DIN_x2.stl]
2025-10-30 Оптимизация для тензы
    Увеличили диаметр посадочного отверстия, что бы тенза нигде не утыкалась, так же изменили отверстия, что бы хотэнд стоял корректно, а не под углом
    [Переходная пластина.stl]
2025-11-08 Добавили держатель JST 4Pin
    [Skirt JST 2,54 4Pin v3.step, buck_halter.stl, buck_lid.stl, Держатель разъёма.stl, Удерживающее кольцо.stl]
2025-11-12 Конфиги на машины
    [AFC.cfg, AFC_Hardware.cfg, AFC_Lite.cfg, AFC_Macro_Vars.cfg, AFC_Turtle_1.cfg, AFC_auto_vars.cfg, AFC_macros.cfg, Brush.cfg]
2025-11-13 обновили SN263
    [AFC_Lite.cfg, AFC_Turtle_1.cfg, AFC_auto_vars.cfg, adxl345.cfg, nozzle_scrub.cfg, printer-20251112_162657.cfg, printer-20251112_163105.cfg, printer-20251112_190210.cfg]
2025-11-16 Опустили Fly X10 Pro пониже
    [Крепление DIN.step, Крепление DIN_x2.stl]
2025-12-06 добавили конфиг SN268
    [AFC.cfg, AFC_Hardware.cfg, AFC_Lite.cfg, AFC_Macro_Vars.cfg, AFC_Turtle_1.cfg, AFC_auto_vars.cfg, AFC_macros.cfg, Brush.cfg]
2025-12-07 дырочки для стального прутка
    [Держатель MiniAB.step, Держатель MiniAB.stl]
2025-12-15 Добавили модели
    [52.5 мм кронштейн v2.step, 52.5 мм кронштейн x2.step, Duct.step, Duct_Spacer_G (1).step, Goliath 2510 fan shroud for Magneto Vz Printhead v1.stl, Goliath_Duct_back1 15mm (1) v2.step, Goliath_duct_back2.step, Printed_9mm_AWD_XY_joint_left_a.step]
2025-12-17 Добавили конфиги серийных машин
    [Exclude_Object.cfg, Macro.cfg, RSCS_fan.cfg, Speed.cfg, Start_Stop.cfg, mainsail.cfg, motors_sync.cfg, printer.cfg]
2025-12-24 добавили конфиги
    [T0.cfg, T1.cfg, T2.cfg, T3.cfg, T4.cfg, T5.cfg, adxl345.cfg, calibrate-offsets.cfg]
2026-01-16 конфиги серийных машин
    [Klicky-00-Front-Body-D2F-Countersunk - SB-1.stl, Blade Holder v1.step, Blade Holder v1.stl, Bottom v1.step, Bottom v1.stl, Bottom.step, BrushHolder v1.step, CW2 блок шестерней с датчиками для ERCF и винтовым креплением трубки.stl]
2026-01-29 Концевик Monolith
    Добавили мод, позволяющий перенести концевик Monolith на портал слева
    [3030Z_monolith_bed_fan.STEP, AFC.cfg, AFC_Hardware.cfg, AFC_Lite.cfg, AFC_Macro_Vars.cfg, AFC_Turtle_1.cfg, AFC_auto_vars.cfg, AFC_macros.cfg]
2026-01-29 Create Снимок экрана 2026-01-29 в 11.02.18.png
2026-02-02 Добавили конфиг
    [Exclude_Object.cfg, Macro.cfg, RSCS_fan.cfg, Speed.cfg, Start_Stop.cfg, mainsail.cfg, motors_sync.cfg, printer-20251112_162657.cfg]
2026-02-05 конфиги и обновленная крышка ввода кабеля
    [filament_sensor.cfg, led.cfg, mainsail.cfg, motors_sync.cfg, nozzle_scrub.cfg, offmodule.cfg, printer.cfg, speed_test.cfg]
2026-02-21 добавили QuattroBox
    [AFC.cfg, AFC_Hardware.cfg, AFC_Lite.cfg, AFC_Macro_Vars.cfg, AFC_Turtle_1.cfg, AFC_macros.cfg, Brush.cfg, Cut.cfg]
2026-04-01 Добавили конфигурации
    [Duct_Spacer_RapidoUHF.step, filament_sensor.cfg, led.cfg, mainsail.cfg, motors_sync.cfg, nozzle_scrub.cfg, offmodule.cfg, orbiter_smart_sensor.cfg]
2026-04-02 добавили комментарии
    [filament_sensor.cfg, led.cfg, mainsail.cfg, motors_sync.cfg, nozzle_scrub.cfg, offmodule.cfg, orbiter_smart_sensor.cfg, printer.cfg]
2026-04-03 Новые файлы конфигурации
    [adxl345.cfg, filament_sensor.cfg, led.cfg, mainsail.cfg, motors_sync.cfg, nozzle_scrub.cfg, offmodule.cfg, printer-20260402_113734.cfg]
2026-04-07 Конфиги плюс STEP
    Добавили конфиги серийных машин плюс STEP файлы для листоголова в версии CHC-XL
    [Duct_Spacer-CHC-XL.step, adxl345.cfg, blobifier.cfg, blobifier_hw.cfg, client_macros.cfg, def_poop.cfg, filament_sensor.cfg, led.cfg]
2026-04-13 Добавили конфигурационные файлы
    [blobifier.cfg, blobifier_hw.cfg, client_macros.cfg, def_poop.cfg, mmu.cfg, mmu_cut_tip.cfg, mmu_eject_buttons.cfg, mmu_eject_buttons_hw.cfg]
2026-04-13 Файлы конфигураций
    [AFC.cfg, AFC_Hardware.cfg, AFC_Macro_Vars.cfg, AFC_Turtle_1.cfg, AFC_auto_vars.cfg, AFC_macros.cfg, Brush.cfg, Cut.cfg]
2026-04-14 Добавили конфиги новых машин
    [Держатель обшивки для петли A 3030x3.STL, Держатель обшивки для петли B 3030x3.stl, Замок 3030 обшивка 4мм х2.stl, Петля 3030 обшивка 4мм х6.STL, Проставка петли 3030x6.STL, Проставка ручки 3030х4.stl, Ручки A 3030x2.stl, Ручки B 3030x2.stl]
2026-04-15 Добавили конфиги и STL
    Добавили конфиги новых машин и STL адаптера шланга 22 мм для CPAP
    [an_to_hose_adapter_22mm_nidec_black.stl, filament_sensor.cfg, led.cfg, mainsail.cfg, nozzle_scrub.cfg, offmodule.cfg, printer.cfg, speed_test.cfg]
2026-04-17 Добавили файлы конфигураций
    [filament_sensor.cfg, led.cfg, mainsail.cfg, nozzle_scrub.cfg, offmodule.cfg, printer.cfg, speed_test.cfg, start_end.cfg]
2026-04-20 Обновили конфиги
    [filament_sensor.cfg, led.cfg, mainsail.cfg, motors_sync.cfg, nozzle_scrub.cfg, offmodule.cfg, printer.cfg, speed_test.cfg]
2026-04-22 Добавили натяжители ремня двигателя Z
    [Z натяжитель ремня двигателя AX2.stl, Z натяжитель ремня двигателя BX2.stl]
2026-05-19 Create update_repo.sh
    Зеркала яндекс
2026-05-22 Добавили новую ручку для 500
    [Ручка для 500.step]
2026-07-01 Новые конфиги серийных машин
    [filament_sensor.cfg, led.cfg, mainsail.cfg, motors_sync.cfg, nozzle_scrub.cfg, offmodule.cfg, orbiter_smart_sensor.cfg, printer.cfg]
2026-07-10 Схемы 500 Поток
    Добавили схемы 500 поток и дополнительные конфигурацинные файлы
    [filament_sensor.cfg, led.cfg, mainsail.cfg, motors_sync.cfg, nozzle_scrub.cfg, offmodule.cfg, orbiter_smart_sensor.cfg, printer.cfg]
2026-08-04 добавили файлы конфигурации
    [blobifier.cfg, blobifier_hw.cfg, chamber_heater.cfg, client_macros.cfg, def_poop.cfg, driver_led.cfg, fan_led.cfg, filament_sensor.cfg]
2026-09-07 Добавили STL и конфиги
    1. Обновили датчик пластика для MMU, теперь меньше утыканий
    2. Обновили конфигурации с учётом QuattroBox и HappyHare V4
    [Printed_9mm_AWD_XY_joint_left_a.3mf, blobifier.cfg, client_macros.cfg, def_poop.cfg, filament_sensor.cfg, led.cfg, mainsail.cfg, mmu.cfg]
